safarcikm/Wind-turbines/README.md

# Wind Turbines

Development of a 12 kW wind turbine designed for Icelandic conditions (high
winds, strong gusts, icing, cold, salt air and volcanic ash), with as much as
possible manufactured in-house.

## Documents

- [01 – Project categories](docs/01-project-categories.md): work breakdown,
  Iceland-specific challenges, in-house feasibility and dependencies.
- [02 – Design basis and requirements](docs/02-design-basis.md): Icelandic
  design envelope, IEC Class S parameters, design load cases and
  requirements for every category.
- [03 – Rotor concept study](docs/03-rotor-concept.md): rotor diameter,
  tip speed, blade shape, aerofoils and pitch schedule
  (model in [analysis/rotor](analysis/rotor/)).
- [04 – Generator concept study](docs/04-generator-concept.md): topology,
  size, poles/slots, magnets and Iceland-specific protection
  (model in [analysis/generator](analysis/generator/)).
- [05 – Generator FEA and thermal check](docs/05-generator-fea-thermal.md):
  2D finite element results (back-EMF, cogging, torque, demagnetisation) and
  thermal network; leads to N40UH magnets and a mandatory cooling package.
- [06 – Generator simulation round 2](docs/06-generator-round2.md): confirms
  the fixes (all checks pass) and freezes the generator concept data.
- [07 – Nacelle, spindle and bearings](docs/07-nacelle-spindle-bearings.md):
  layout, concept loads, main bearings, spindle, generator cooling path,
  brake and yaw (model in [analysis/nacelle](analysis/nacelle/)).
- [08 – Load verification](docs/08-load-verification.md): IEC 61400-2
  Simplified Load Model and a 94-case aeroelastic simulation; design load
  recommendation, design overspeed 250 rpm, tower frequency and parked
  stability findings (models in [analysis/loads](analysis/loads/)).
- [09 – Tower and foundation](docs/09-tower-foundation.md): freestanding
  tilt-up monopoles for 18 m and 24 m, frequency strategy with a speed
  exclusion zone, rotor balance requirement, foundations for every ground
  type (models in [analysis/tower](analysis/tower/)).
- [10 – Blade materials and structure](docs/10-blade-structure.md): material
  options, layup sizing for glass and carbon spar caps, frequencies, root
  joint (model in [analysis/blade](analysis/blade/)).
- [11 – Control and safety system](docs/11-control-safety.md): control and
  protection architecture, constant power, storm control, exclusion zone,
  trips and emergency stop, and the full load rerun with the final design.
- [12 – Power electronics](docs/12-power-electronics.md): active rectifier,
  750 V DC link, dump load, grid-tie/heating and battery modules, efficiency
  and annual energy (model in [analysis/power](analysis/power/)).
- [13 – Hub, pitch and yaw](docs/13-hub-pitch-yaw.md): independent electric
  pitch with supercapacitors, pitch bearing and drive sizing from simulated
  pitch duty, ductile iron hub, yaw bearing, drives and slipping brake, and
  the effect of the heavier rotor on the towers (models in
  [analysis/hub](analysis/hub/)).
- [14 – Nacelle prototype P1](docs/14-nacelle-prototype-p1.md): bench
  article detail design (spindle, bearings, drum, stator, magnets, brake,
  cooling, bedplate), detail checks, mass, manufacturing and assembly, with
  17 parametric drawings (PDF + DXF) and a BOM in [cad/nacelle_p1](cad/nacelle_p1/)
  (checks in [analysis/nacelle/detail.py](analysis/nacelle/detail.py)).
- [15 – Nacelle bench test plan](docs/15-nacelle-bench-test-plan.md): rig,
  instrumentation, test blocks T0 to T10 with pass criteria, schedule.
- [16 – Nacelle fit-check model](docs/16-nacelle-fit-check-model.md): every
  nacelle part at 1:1 as its own printable object down to the tower flange,
  and the digital assembly check that found 9 problems in P1
  ([cad/nacelle_fitcheck](cad/nacelle_fitcheck/)).
- [17 – Working 3D-printed prototype W1](docs/17-working-printed-prototype.md):
  the P1 geometry Rev B that fixes those findings, a printed hub, pitch and yaw
  twins with real balls, real bought actuators, sensors and controller, the
  swap path from printed to steel, component list
  ([cad/nacelle_w](cad/nacelle_w/), [bom_w.csv](cad/nacelle_w/bom_w.csv)) and
  the car-industry evaluation.
- [24 – Collective pitch and welded hub](docs/24-collective-pitch-hub.md):
  replaces the three pitch drives of doc 13 with one electric cylinder, yoke,
  links and cranks, feathering from one supercap module; rotor brake as the
  second braking system; welded S355NL hub; mass and part count
  ([analysis/hub/collective.py](analysis/hub/collective.py)).
- [26 – Slow-running variant V5](docs/26-slow-rotor-variant-v5.md): Ø8.3 m,
  TSR 5, 110 rpm, every subsystem re-sized; +11–14 % yearly energy against
  about double the storm loads (models in [analysis/variant_tsr5](analysis/variant_tsr5/)).
