safarcikm/Wind-turbines/cad/turbine_6kw/out/drawing-index.md

| Drawing | Title | Material | Mass |
|---|---|---|---|
| NS6-000 | GENERAL ARRANGEMENT · TURBINE ON 8 m TOWER | see BOM NS6-002/003 | ≈ 982 kg head + 661 kg tower |
| NS6-001 | DRAWING INDEX (S6 SET REV B + REUSED 12 kW DRAWINGS) | – | – |
| NS6-002 | BILL OF MATERIALS (1/2) | see lines | see lines |
| NS6-003 | BILL OF MATERIALS (2/2) | see lines | see lines |
| NS6-010 | GENERAL ARRANGEMENT · NACELLE SECTION | see NS6-001 | ≈ 982 kg above the tower flange |
| NS6-020 | ROTOR ASSEMBLY · HUB, BLADES, SPINNER | see BOM | ≈ 162 kg (rotor + hub + spinner) |
| NS6-100 | BLADE · PLANFORM, TWIST AND ROOT | E-glass/epoxy infused; glass UD caps; PVC core shells | 20.6 kg |
| NS6-101 | BLADE · SECTIONS AND LAMINATE SCHEDULE | E-glass/epoxy (infusion), PVC H80 core | 20.6 kg |
| NS6-105 | BLADE ROOT INSERT M12 (BONDED) | C45E+QT, zinc-flake coated (Geomet 500) | 0.33 kg |
| NS6-110 | BLADE MOULD SET (PLUG, TWO HALVES, FRAME) | GRP tooling laminate on S235 RHS frame | ≈ 2 × 75 kg + frame 155 kg |
| NS6-115 | ROOT INSERT FIXTURE AND WEB MOULD (TOOLS) | S355 machined; Al 5083 plate | 9 kg (fixture) |
| NS6-130 | PITCH SETTING · ROOT SLOTS, WASHER PLATES, GAUGE | C45 hardened 45 HRC; gauge Al 6082 | 30 × 15 g; gauge 1.6 kg |
| NS6-200 | FIXED HUB WELDMENT | S355NL, welded, stress relieved | 79 kg (CAD) |
| NS6-210 | SPINNER (GRP) AND BRACKETS NS6-211 | glass/polyester 4 mm, gelcoat RAL 9010; brackets S235 galv. | 8.7 kg + 3.6 kg |
| NS6-300 | BEDPLATE WELDMENT 6 kW (LIGHT) | S355J2+N plates, stress relieved, machined | 127 kg |
| NS6-310 | CALIPER BRACKET NP1-310 AND YAW DRIVE BRACKET NP1-420 | S355J2+N plate 25, welded, galv. | 18.1 kg; 2 × 7.7 kg |
| NS6-400 | TOWER 8 m · ONE-PIECE TILT-UP MONOPOLE | S355J2+N, rolled and seam welded; hot-dip galvanised | 661 kg (CAD 698) |
| NS6-410 | BASE HINGE BRACKETS AND PIN | S355J2+N 30 mm plate, galv.; pin 42CrMo4+QT Ø50 h9 | 37 kg |
| NS6-420 | GIN POLE AND TILT-UP RIGGING (ERECTION TOOL) | S355 tube 168.3 × 6.3, plates 25 | 94 kg |
| NS6-500 | FOUNDATION · SPREAD FOOTING AND ROCK PLINTH (8 m) | C30/37 XF4 air-entrained; B500C rebar | 5.5–6.6 m³ (soil), 2.0 m³ (rock) |
| NS6-510 | ANCHOR CAGE AND TEMPLATE | M24 8.8 HDG threaded rod; S355 rings 100 × 20 | 144 kg |
| NS6-600 | BRAKING RESISTOR BOX AND SAFETY CHAIN | Box 1.4301, IP54; resistors steel-grid | ≈ 18 kg |
| NS6-610 | G6 PLAIN REAR COVER (NO FAN BLADES) | EN AW-5083-H111, 10 mm plate | ≈ 7 kg |
| NS6-620 | TOWER BASE CABINET, STAND AND RESISTOR BOX POSITION | enclosure 1.4301 IP55; stand S235 galv. | 95 kg + 18 kg |
| NS6-700 | NACELLE COVER · LOWER TRAY AND UPPER LID (GRP) | glass/polyester 4 mm, gelcoat RAL 9010, PU foam ribs | 19 + 22 kg |
| NS6-710 | COVER ARMS, REAR RAIL, MET MAST NS6-720, JUNCTION BOX NS6-730 | S235 galv.; mast 1.4404 Ø42.4 × 2 | 22 kg; 4.5 kg; 9 kg |
| NS6-800 | CABLING ROUTES, EARTHING AND LIGHTNING | see cable schedule | – |
| NS6-900 | FASTENER AND TORQUE SCHEDULE | ISO 4014/4017, EN 14399-4 (HV), 10.9 zinc-flake unless stated | – |
| NS6-910 | BOUGHT PARTS SPECIFICATION (ENVELOPES AND INTERFACES) | see lines | see lines |
