safarcikm/Wind-turbines/cad/yaw/out/drawing-index.md

| Drawing | Title | Material | Mass |
|---|---|---|---|
| NY-000 | YAW SYSTEM · GENERAL ARRANGEMENT | see parts list | ≈ 275 kg (yaw incl. adapter) |
| NY-400 | TOWER-TOP ADAPTER WITH FRICTION TRACK | S355J2+N plate and tube, weldment | 107 kg (model) |
| NY-410 | FRICTION PAD UNIT (PASSIVE, SPRING-LOADED) | frame S355J2+N, pins 1.4462 | 13 kg (model) |
| NY-430 | YAW LOCK (SERVICE) | housing S355J2+N, block 42CrMo4+QT | 6.5 kg (model) |
| NY-440 | YAW ENCODER AND CAM LIMIT SWITCH UNIT | bracket S355J2+N, pinion 42CrMo4+QT | 6.9 kg incl. instruments |
| NY-460 | CABLE HANGER AND TWIST LOOP | tube S355 Ø168.3 × 4.5, flange S355J2+N | 10 kg (model) |
