safarcikm/Wind-turbines/cad/generator_rc/out/drawing-index.md

| Drawing | Title | Material | Mass |
|---|---|---|---|
| NP1-G00 | GENERATOR REV C · ASSEMBLY SECTION | see parts list | ≈ 330 kg drivetrain (no hub) |
| NP1-201C | STATOR TOOTH SEGMENT LAMINATION (45 + 3 PER STATOR) | M270-35A, 0.35 mm, self-bonding varnish | 1.07 kg per stack |
| NP1-200C | STATOR CARRIER WITH 45 DOVETAIL GROOVES | S355J2+N ring forging or plate, stress relieved | 40.6 kg |
| NP1-203C | COIL ON SEGMENT (WOUND SEGMENT) | Cu enamelled Ø1.55 grade 2, class 200; NKN 0.30; PPS GF40 caps | ≈ 0.45 kg Cu per coil |
| NP1-210C | ROTOR DRUM WELDMENT (GENERATOR YOKE + BEARING HOUSING) | S355J2+N, welded, stress relieved | 91.8 kg + 12.5 kg fins/ribs |
| NP1-220E | MAGNET BLOCK 30 × 15 × 12 (PURCHASE DRAWING) | Sintered NdFeB N45SH, NiCuNi | 41.0 g each, 8.21 kg per generator |
| NP1-221C | STEPPED POLE COMB BAR (40 + 4 PER ROTOR) | G11 glass-epoxy sheet, CNC machined | ≈ 25 g |
| NP1-222C | MAGNET END RINGS, FRONT AND REAR | G11 glass-epoxy, machined from tube or segmented | ≈ 0.12 kg each |
| NP1-223C | ROTOR MAGNET PACK: POLE SECTION, LAYOUT AND SLEEVE | assembly | 8.2 kg magnets |
| NP1-212C | DRUM REAR COVER WITH SEAL CARRIER AND FAN BLADES | EN AW-5083-H111 plate, ring and blades | ≈ 9.0 kg |
| NP1-202 | STATOR FRONT CLAMP RING | 1.4404 (non-magnetic) | 2.2 kg |
