safarcikm/Wind-turbines/cad/nacelle_p1/out/drawing-index.md

| Drawing | Title | Material | Mass |
|---|---|---|---|
| NP1-000 | GENERAL ARRANGEMENT · DRIVETRAIN SECTION | see parts list | ≈ 320 kg (drivetrain, no hub) |
| NP1-100 | SPINDLE (STATIONARY MAIN SHAFT) | 42CrMo4+QT (EN 10083-3), forged | 56.8 kg |
| NP1-101 | FRONT SPACER + REAR SEAL SLEEVE NP1-102 | 42CrMo4+QT, surface induction hardened | 1.4 kg |
| NP1-110 | SPINDLE COOLING INSERT (FINNED EXTRUSION) | EN AW-6082-T6 extrusion | 2.6 kg |
| NP1-200 | STATOR CARRIER | S355J2+N plate or ring forging, stress relieved | 40.6 kg |
| NP1-201 | STATOR LAMINATION (45 SLOTS) · LASER / STAMPING | M270-35A, 0.35 mm, self-bonding varnish | 48.0 kg per stack |
| NP1-202 | STATOR FRONT CLAMP RING | 1.4404 (non-magnetic) | 2.2 kg |
| NP1-210 | ROTOR DRUM WELDMENT (GENERATOR YOKE + BEARING HOUSING) | S355J2+N, welded, stress relieved | 98.4 kg |
| NP1-211 | MAIN BEARING SEAL COVERS (FRONT / REAR) | S355J2 | 2.8 kg |
| NP1-212 | DRUM REAR COVER WITH SEAL CARRIER | EN AW-5083-H111 plate + ring | 7.3 kg |
| NP1-220 | MAGNET SEGMENT (PURCHASE DRAWING) | NdFeB N40UH, NiCuNi + epoxy coating | 41 g each |
| NP1-230 | BRAKE DISC AND ROTOR LOCK HOLES | C45E+N (or S355J2+N), 16 mm | 34.5 kg |
| NP1-300 | BEDPLATE WELDMENT (P1 FABRICATED VERSION) | S355J2+N plates, stress relieved, machined | ≈ 150 kg |
| NP1-320 | ROTOR LOCK PIN AND HOLDER | pin 42CrMo4+QT; holder S355J2 | ≈ 4 kg |
| NP1-600 | BENCH DUMMY HUB (DRIVE AND LOAD ADAPTER) | S355J2+N weldment, stress relieved | ≈ 75 kg |
| NP1-620 | BENCH TEST RIG · GENERAL LAYOUT | see doc 15 |  |
| NP1-T01 | DRUM ASSEMBLY GUIDE (MAGNET SAFETY TOOL) | S355 / PA6 bushes | ≈ 30 kg |
