safarcikm/Wind-turbines/cad/nacelle_w/out/w_check.md

# W1 check: added parts against the Rev B nacelle

## Static interference (> 5 mm³; yaw pinion/gear mesh excluded, pitch pinions checked: 0.13 mm backlash)

| Part A | Part B | mm³ |
|---|---|---|
| none | | |

## Rotating vs stationary gaps below 10.0 mm (3-D, assembled position)

| Part A | Part B | gap mm |
|---|---|---|
| none | | |
