safarcikm/Wind-turbines/cad/turbine_6kw/out/NS6-drawing-set.pdf

## SIDE VIEW (wind from the left)

## Ø6 000 rotor

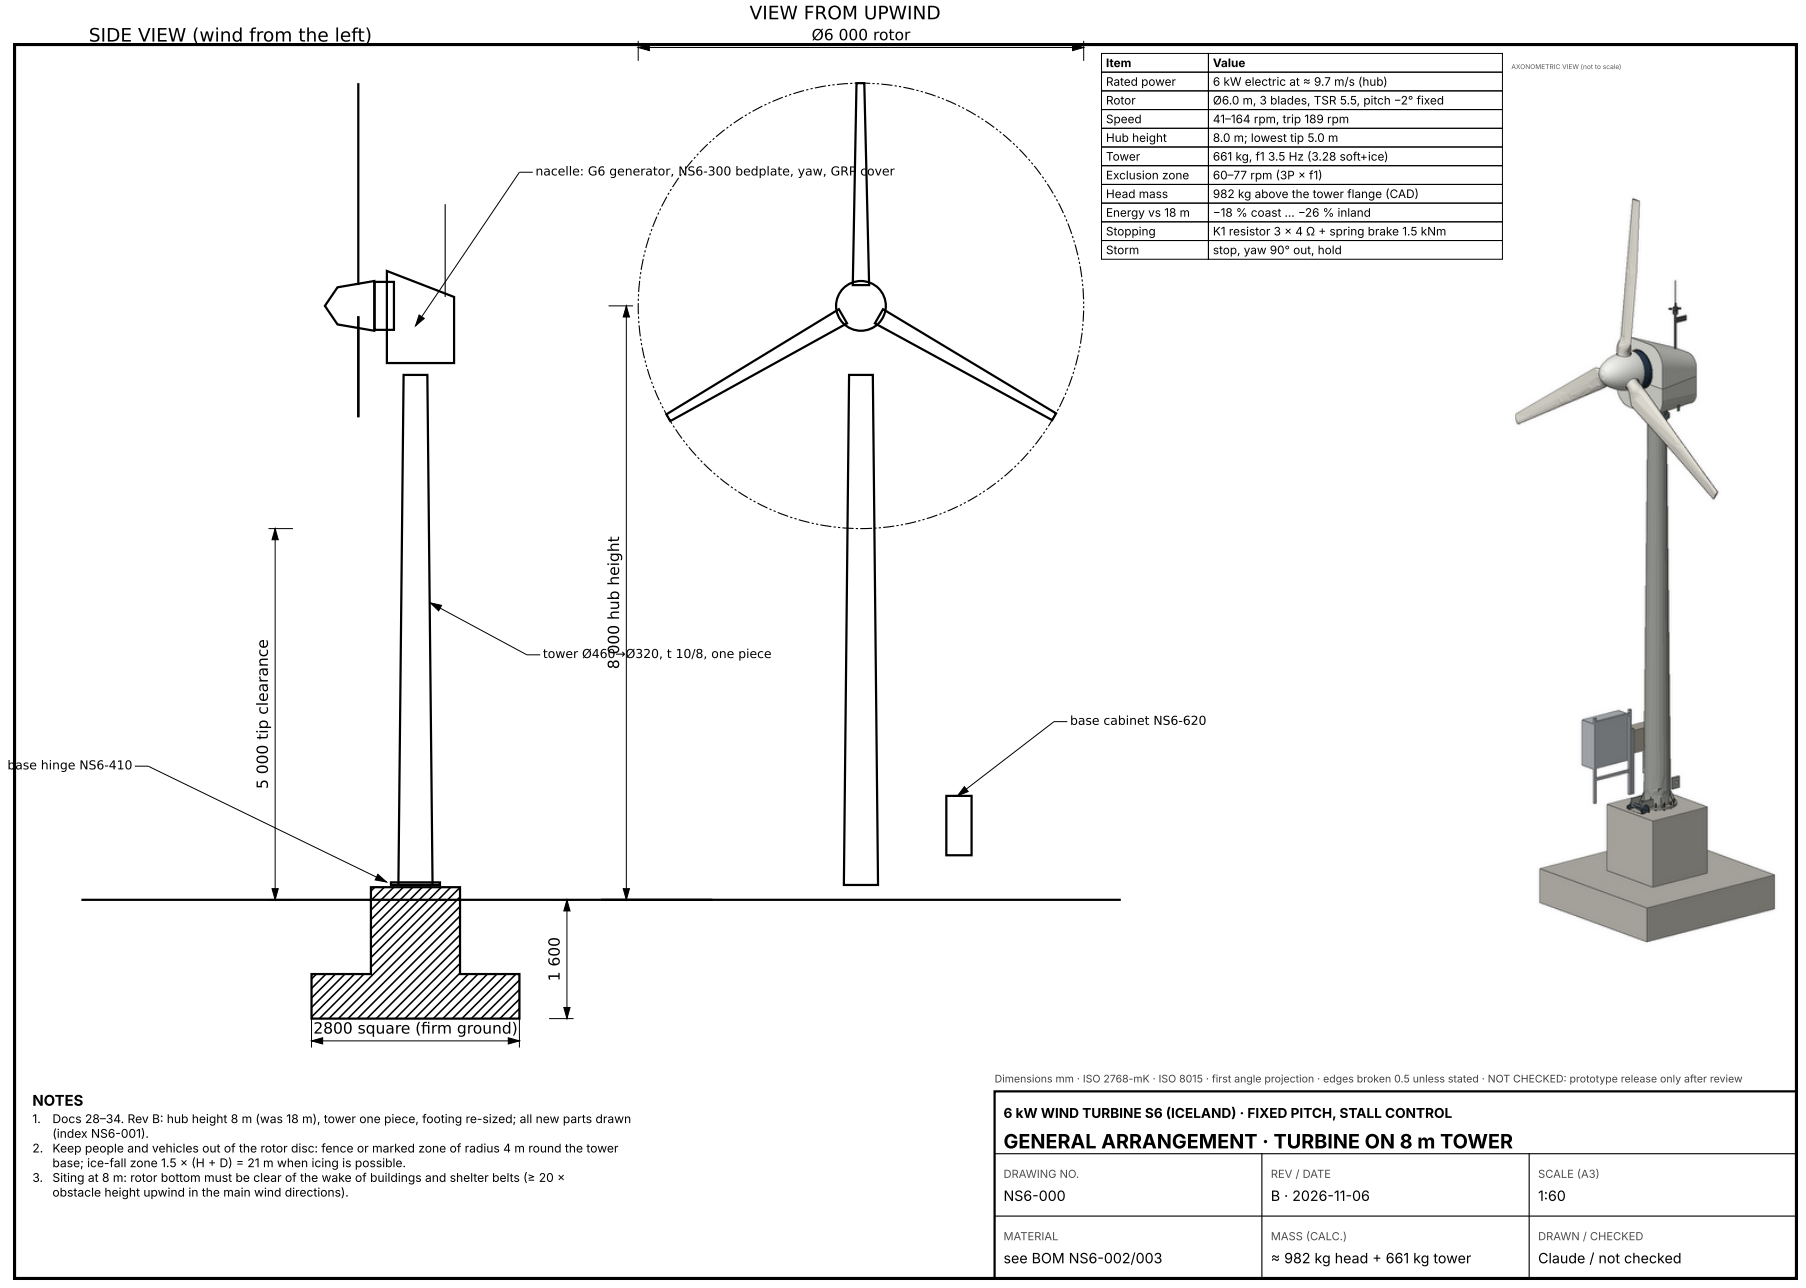
[picture p91: page 1]
8 000 hub height; 5 000 tip clearance; base hinge NS6-410; base cabinet NS6-620; DRAWING NO.; REV / DATE; SCALE (A3); MATERIAL; see BOM NS6-002/003; Item; Value; Rated power; 6 kW electric at ≈ 9.7 m/s (hub); Rotor; Ø6.0 m, 3 blades, TSR 5.5, pitch −2° fixed; Speed; 41–164 rpm, trip 189 rpm; Hub height; 8.0 m; lowest tip 5.0 m; Tower; 661 kg, f1 3.5 Hz (3.28 soft+ice); Exclusion zone; 60–77 rpm (3P × f1); Head mass; 982 kg above the tower flange (CAD); Energy vs 18 m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

VIEW FROM UPWIND

AXONOMETRIC VIEW (not to scale)

nacelle: G6 generator, NS6-300 bedplate, yaw, GRP cover

tower Ø460→Ø320, t 10/8, one piece

2800 square (firm ground)

Dimensions mm · ISO 2768-mK · ISO 8015 · first angle projection · edges broken 0.5 unless stated · NOT CHECKED: prototype release only after review

NOTES
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
