safarcikm/Wind-turbines/cad/generator_mfg/out/G01-overview.png

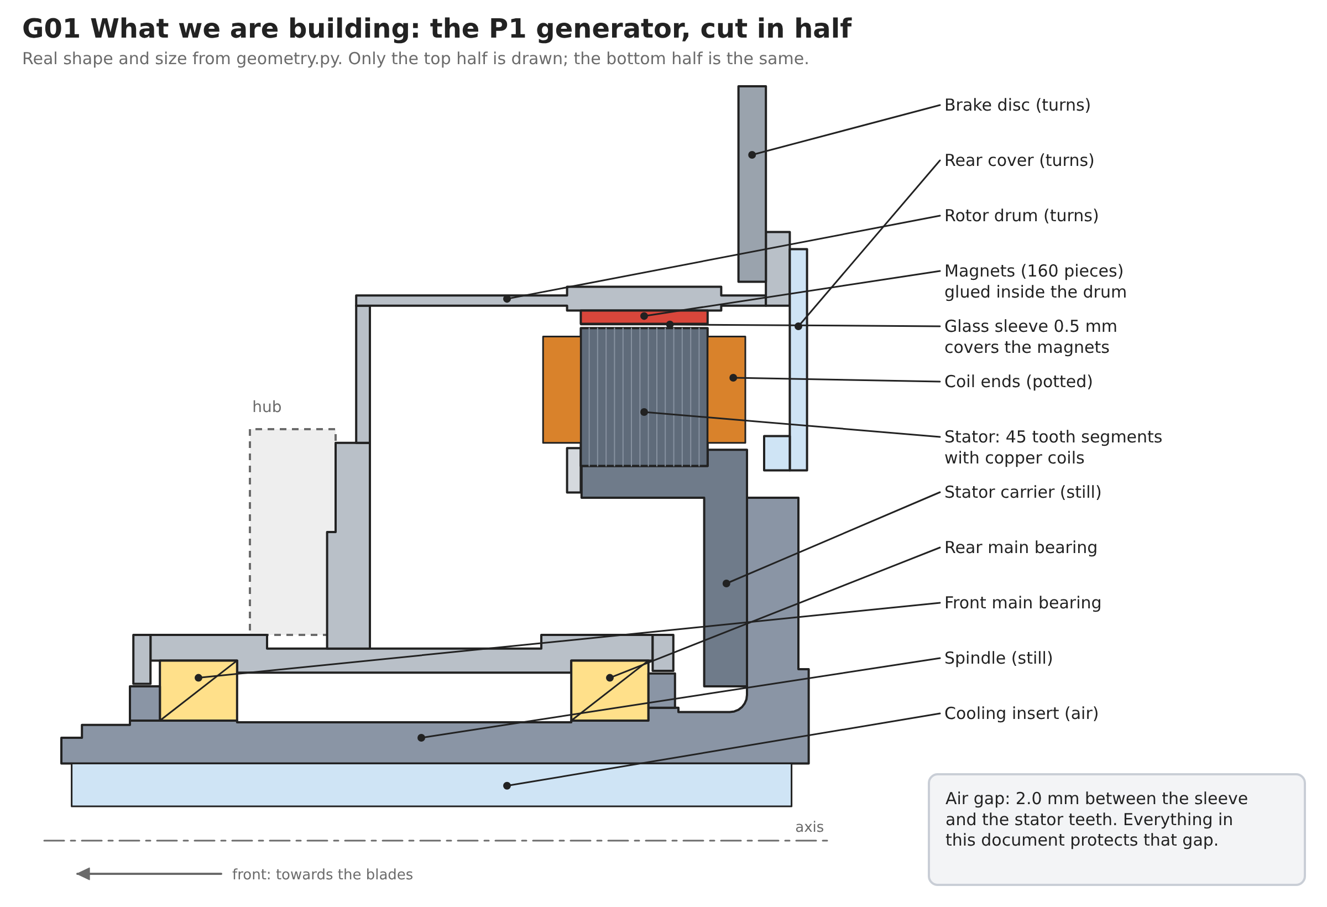
cad/generator_mfg/out/G01-overview.png
