safarcikm/Wind-turbines/cad/generator_mfg/out/G02-process.png

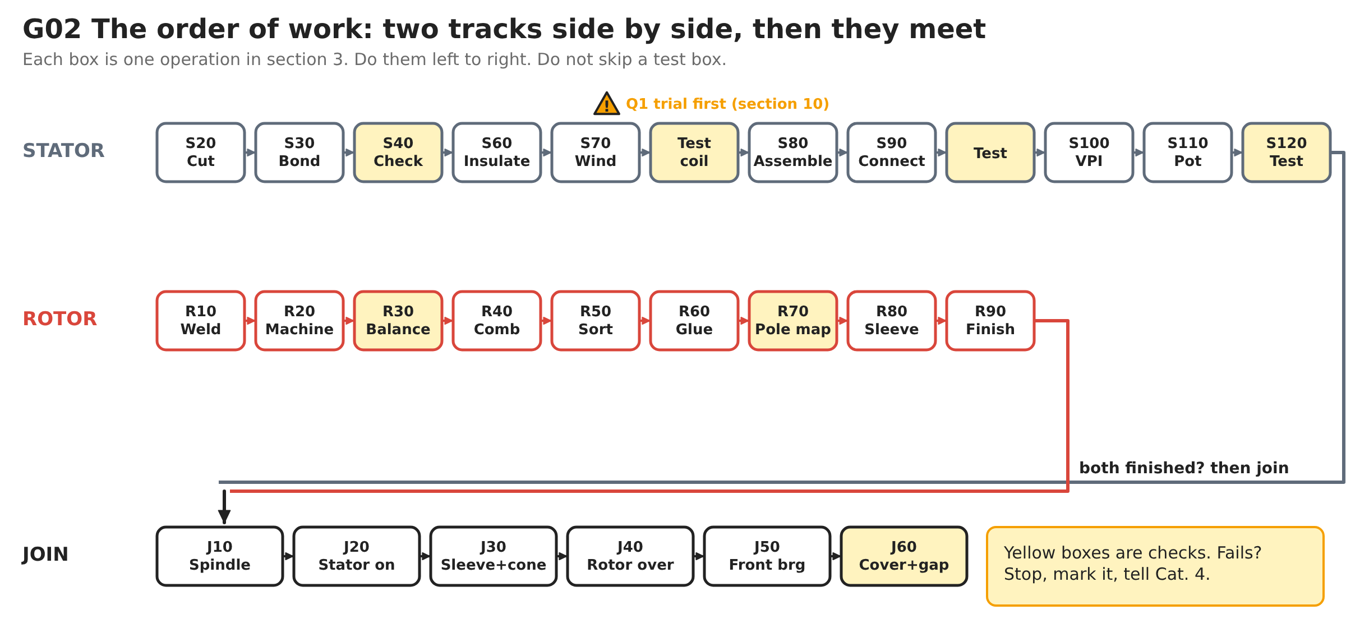
cad/generator_mfg/out/G02-process.png
