safarcikm/Wind-turbines/cad/generator_mfg/out/G03-segment.png

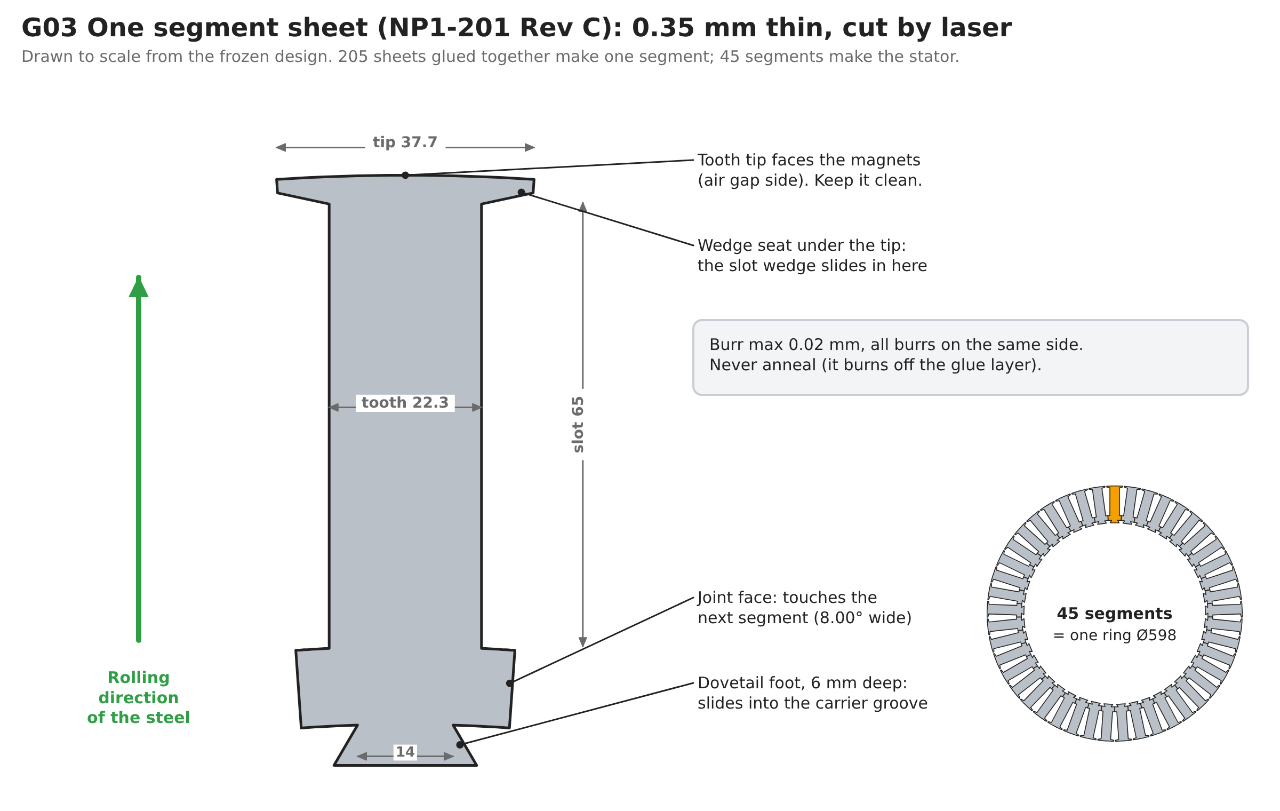
cad/generator_mfg/out/G03-segment.png
