safarcikm/Wind-turbines/cad/generator_mfg/out/G04-stacking.png

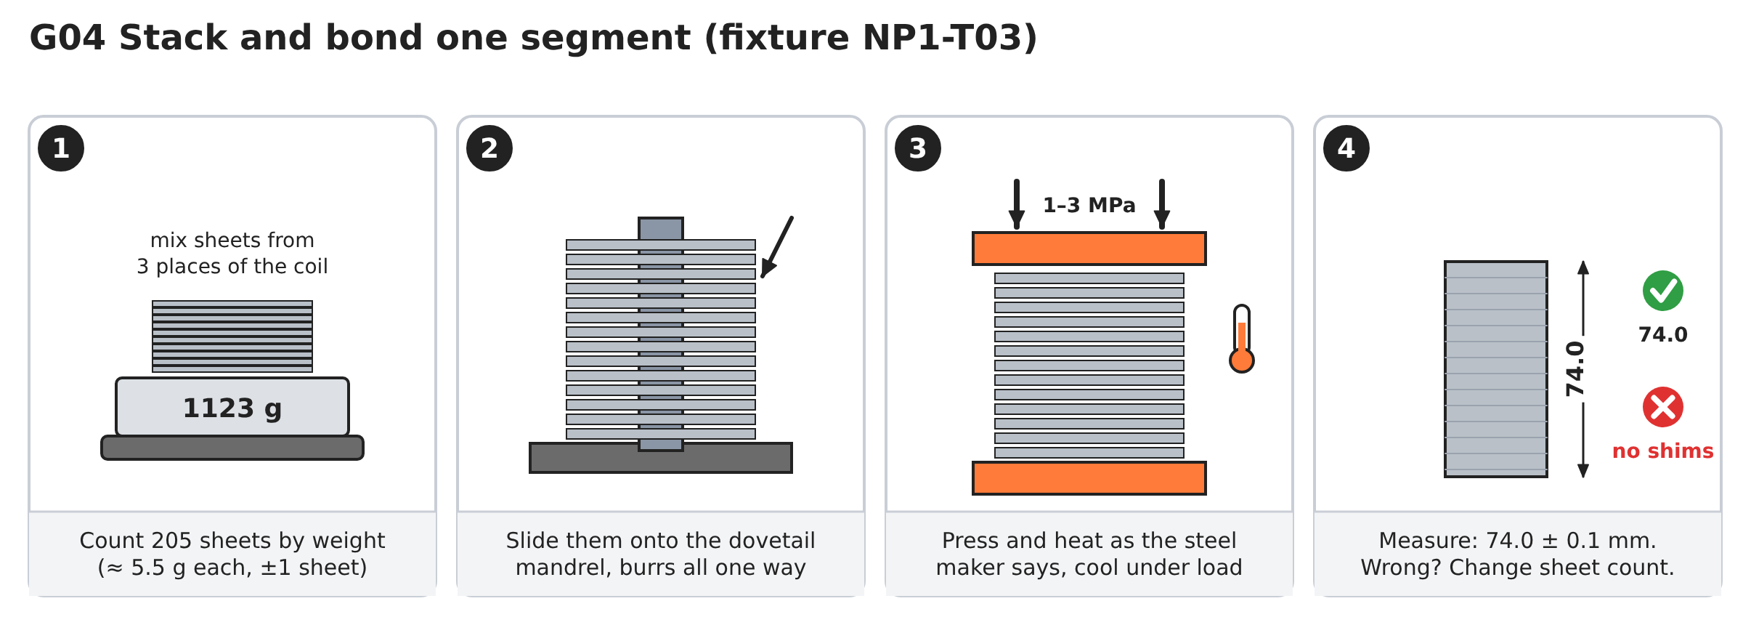
cad/generator_mfg/out/G04-stacking.png
