safarcikm/Wind-turbines/cad/generator_mfg/out/G06-winding.png

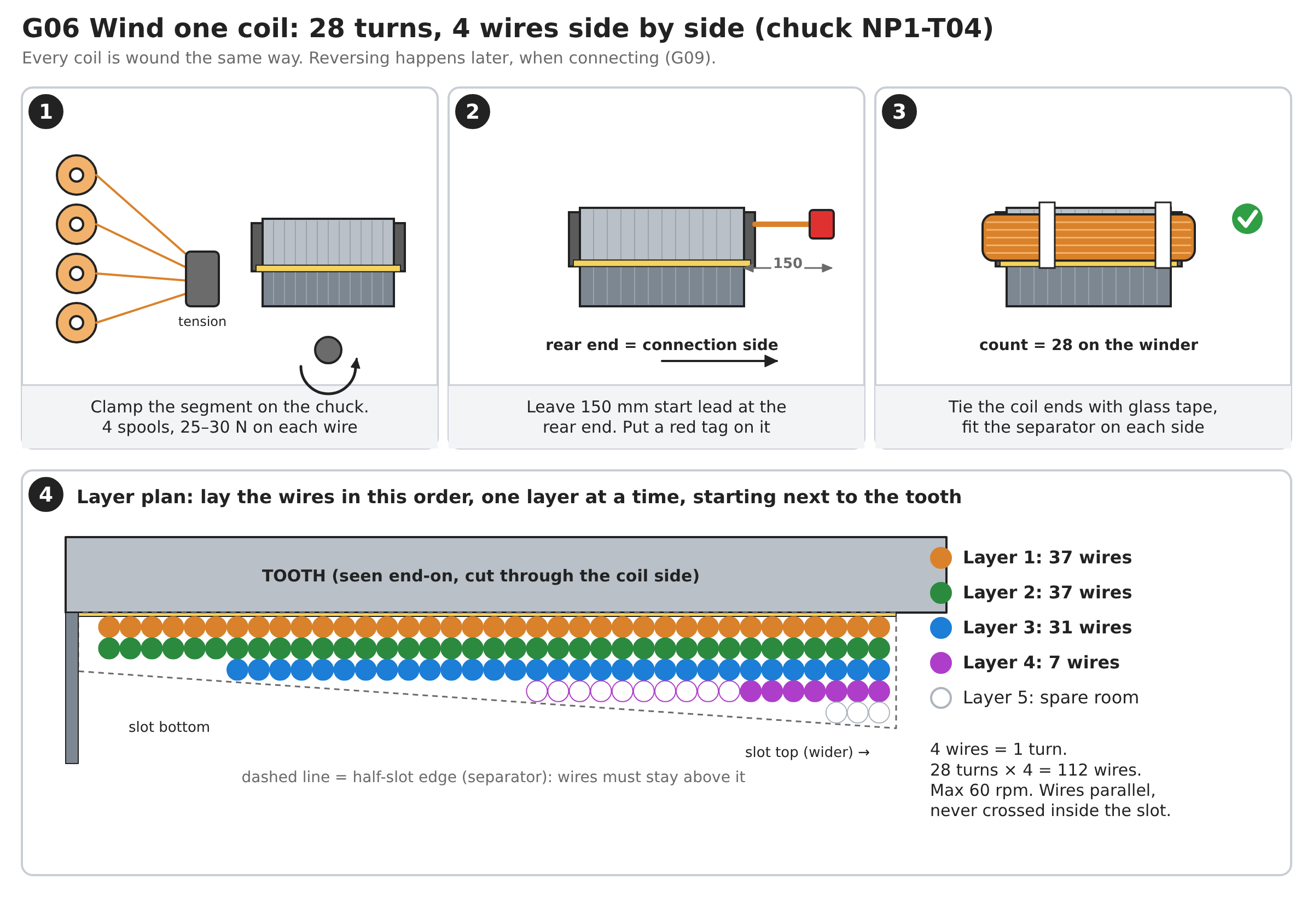
cad/generator_mfg/out/G06-winding.png
