safarcikm/Wind-turbines/cad/generator_mfg/out/G07-coiltests.png

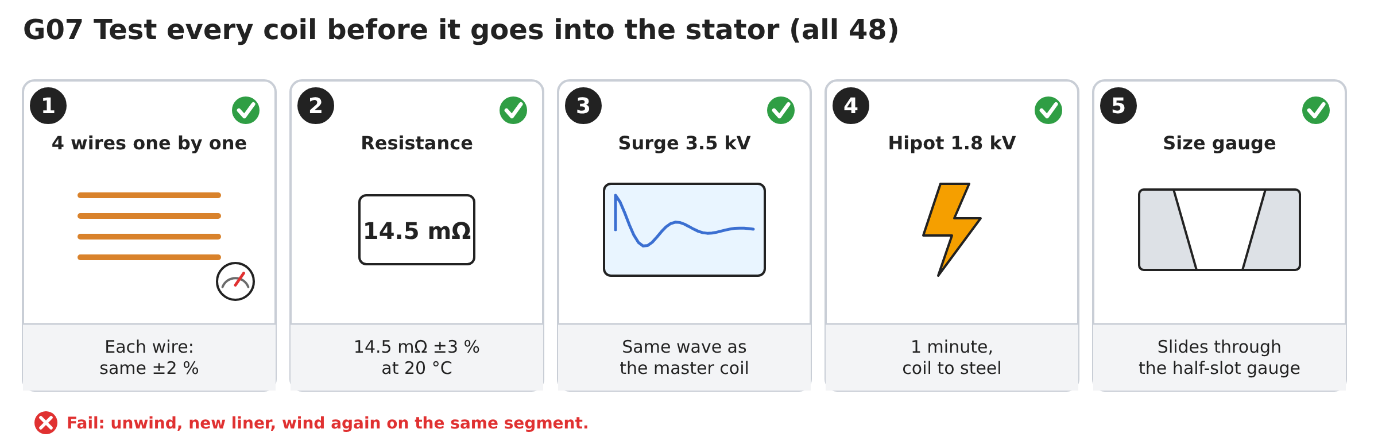
cad/generator_mfg/out/G07-coiltests.png
