safarcikm/Wind-turbines/cad/generator_mfg/out/G09-connection.png

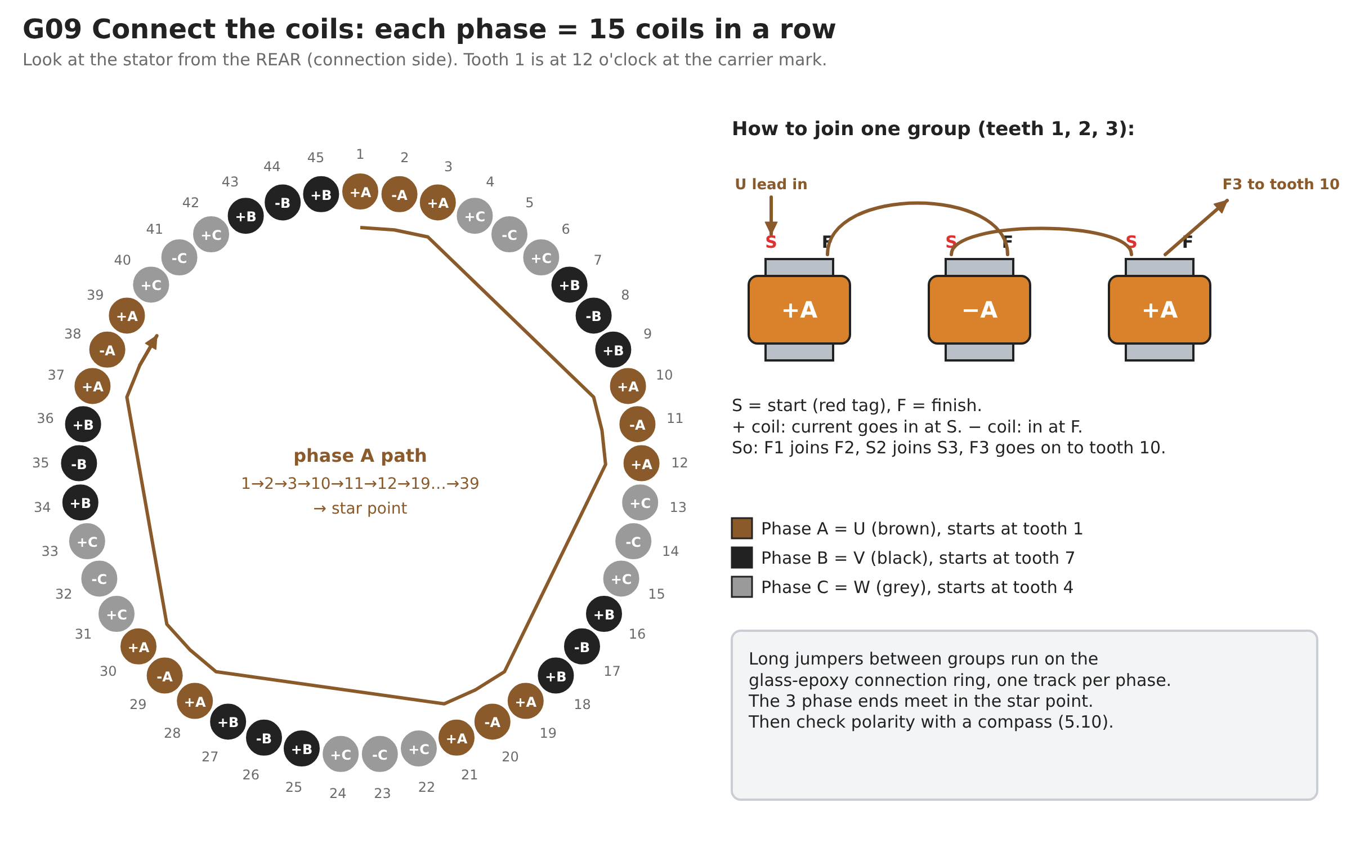
cad/generator_mfg/out/G09-connection.png
