safarcikm/Wind-turbines/cad/generator_mfg/out/G10-joint.png

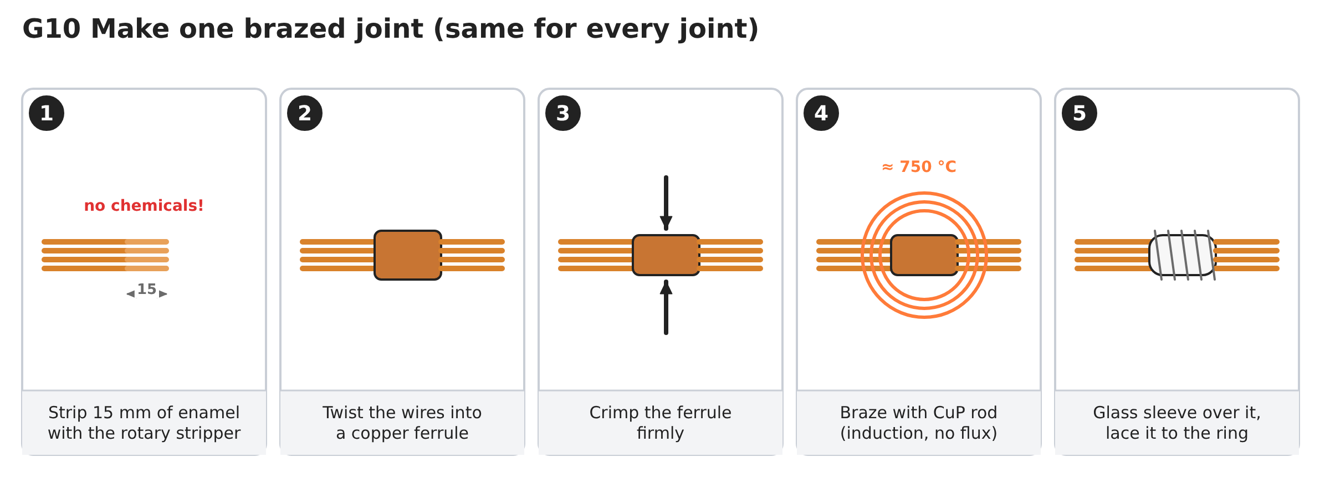
cad/generator_mfg/out/G10-joint.png
