safarcikm/Wind-turbines/cad/generator_mfg/out/G11-vpi.png

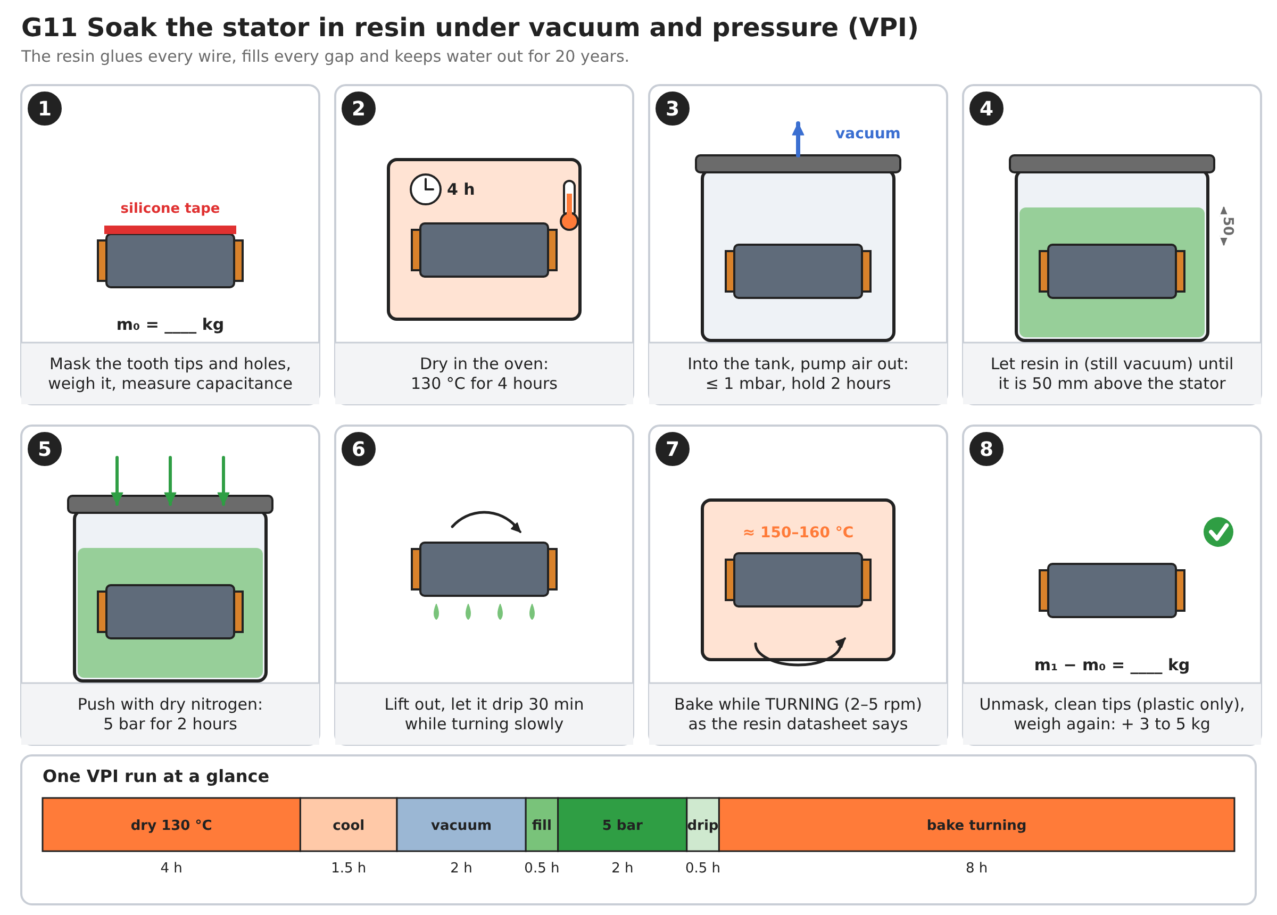
cad/generator_mfg/out/G11-vpi.png
