safarcikm/Wind-turbines/cad/generator_mfg/out/G12-potting.png

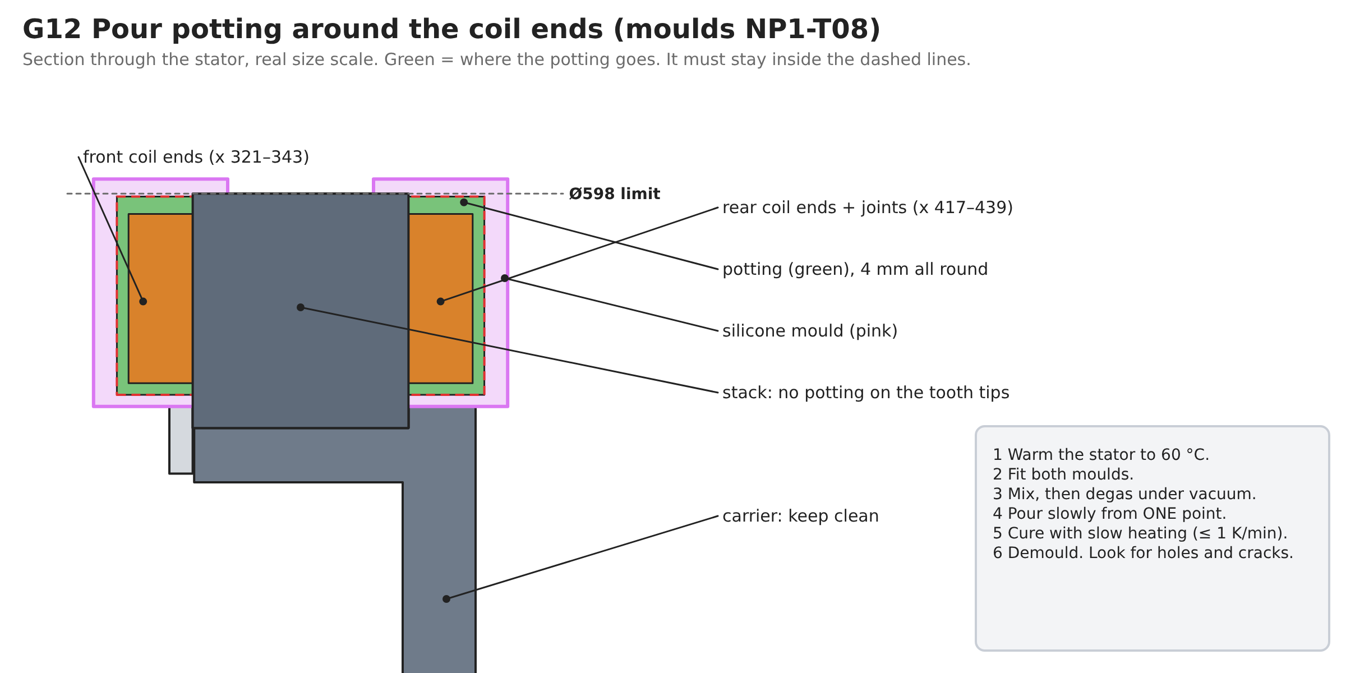
cad/generator_mfg/out/G12-potting.png
