safarcikm/Wind-turbines/cad/generator_mfg/out/G13-drum.png

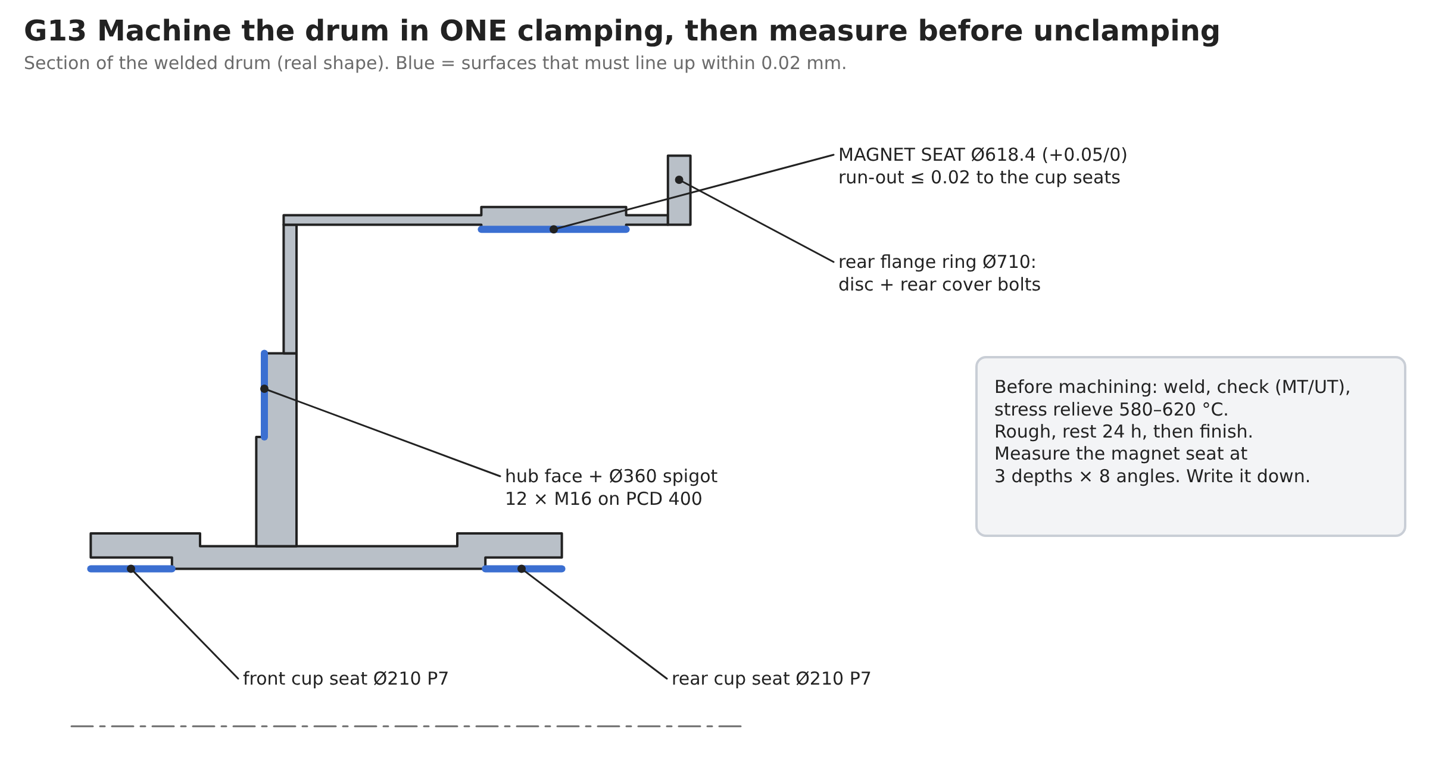
cad/generator_mfg/out/G13-drum.png
