safarcikm/Wind-turbines/cad/generator_mfg/out/G14-magnets.png

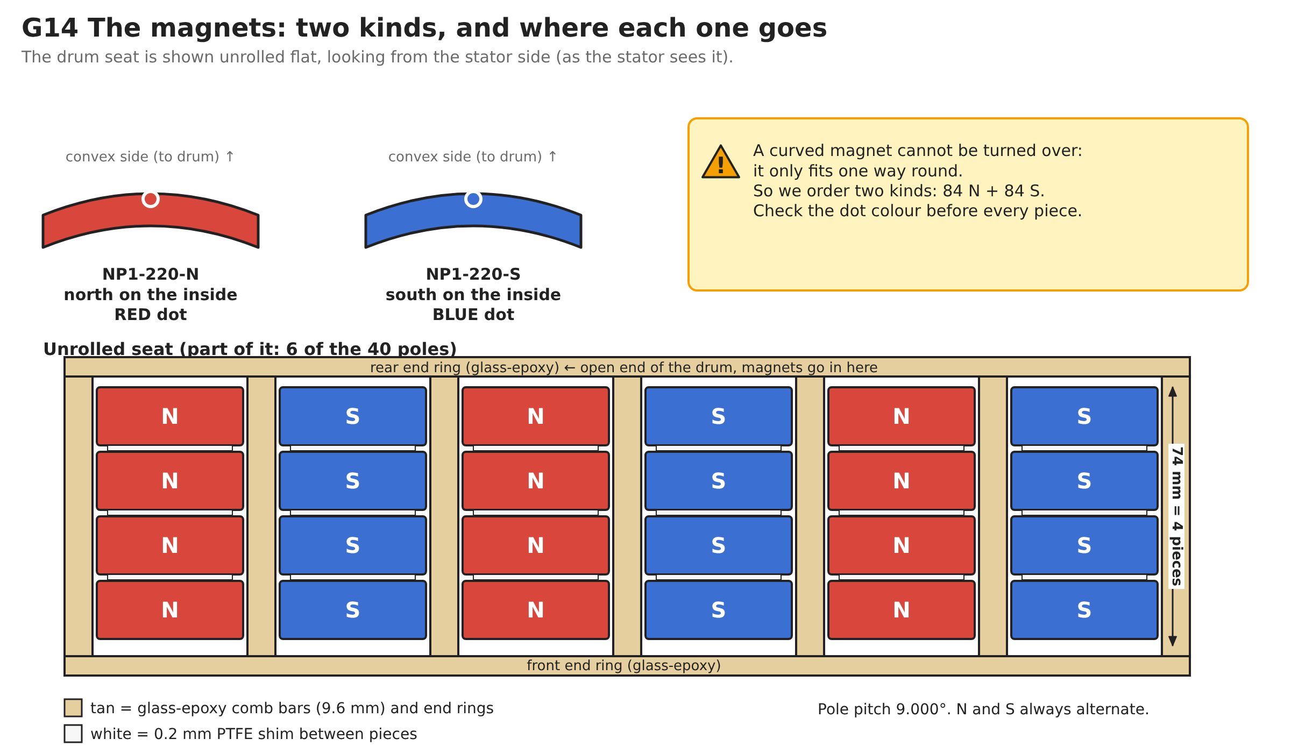
cad/generator_mfg/out/G14-magnets.png
