safarcikm/Wind-turbines/cad/generator_mfg/out/G15-insert.png

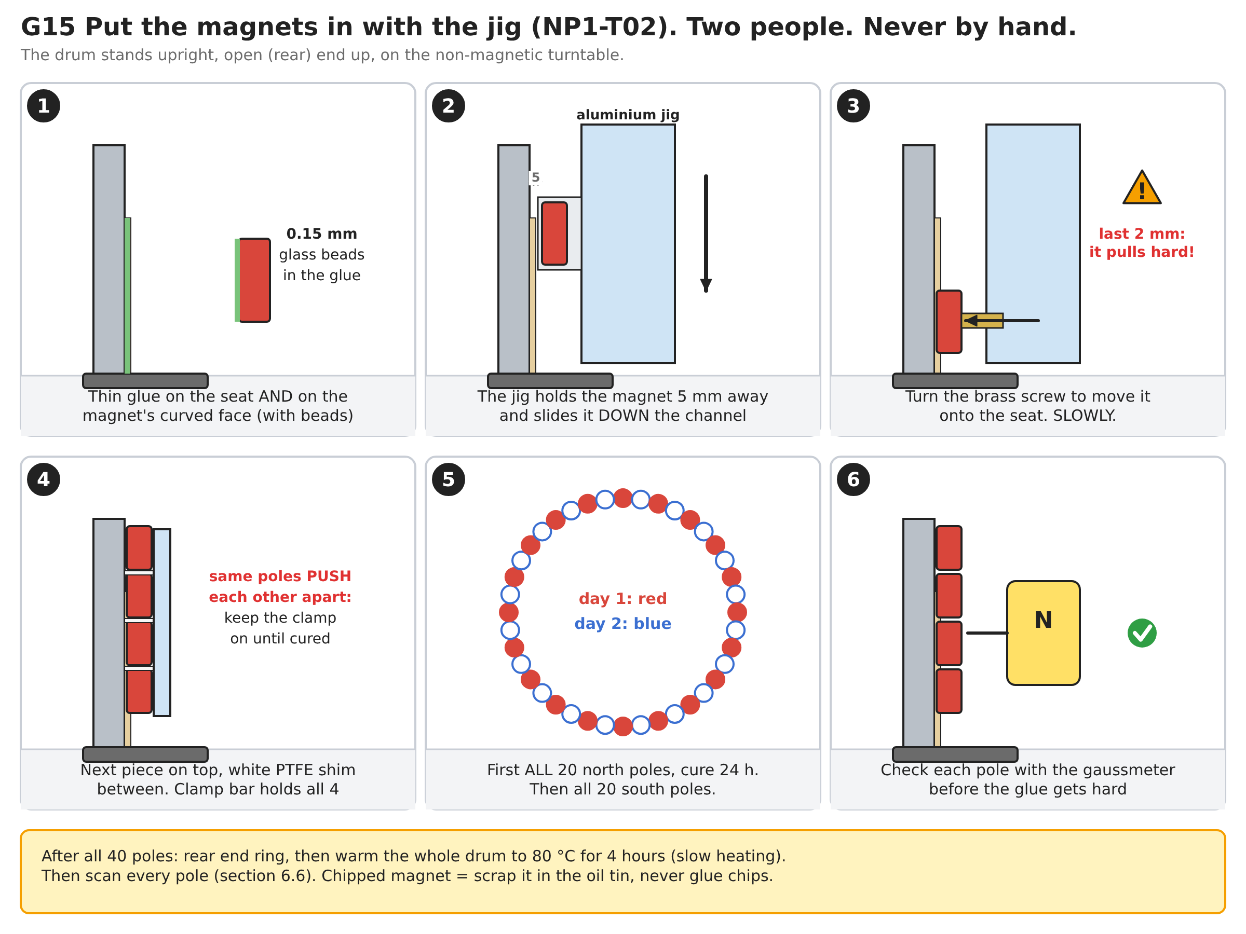
cad/generator_mfg/out/G15-insert.png
