safarcikm/Wind-turbines/cad/generator_mfg/out/G16-sleeve.png

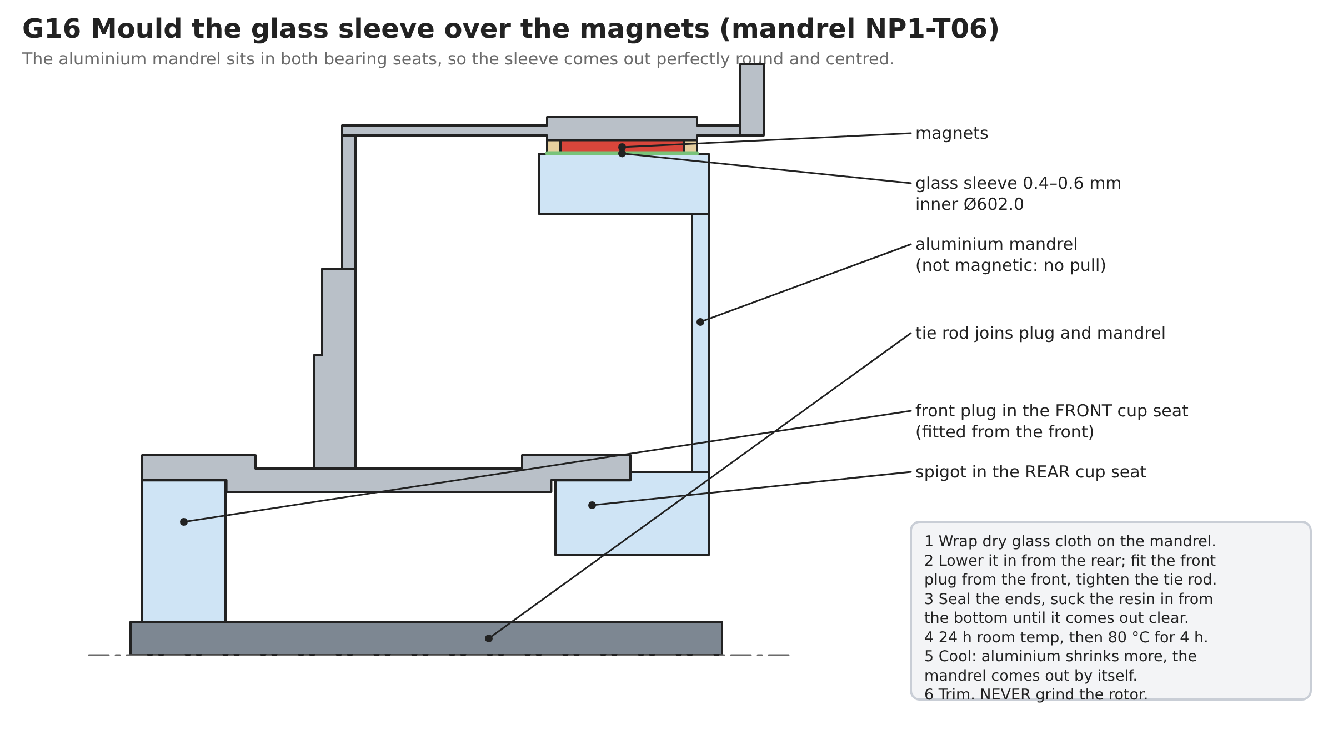
cad/generator_mfg/out/G16-sleeve.png
