safarcikm/Wind-turbines/cad/generator_mfg/out/G17-join.png

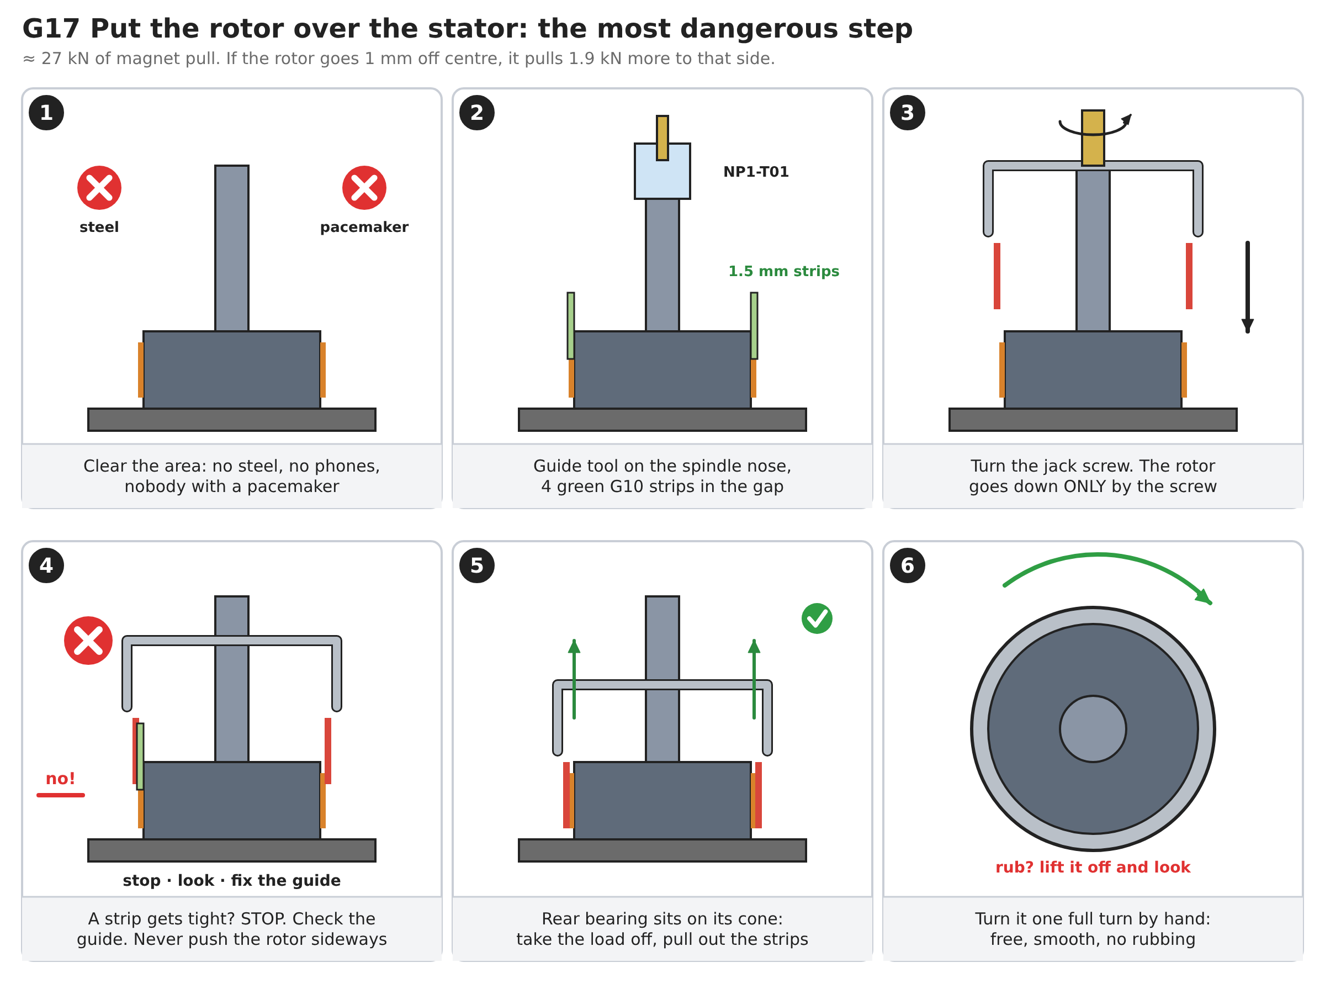
cad/generator_mfg/out/G17-join.png
