safarcikm/Wind-turbines/cad/generator_mfg/out/G18-gap.png

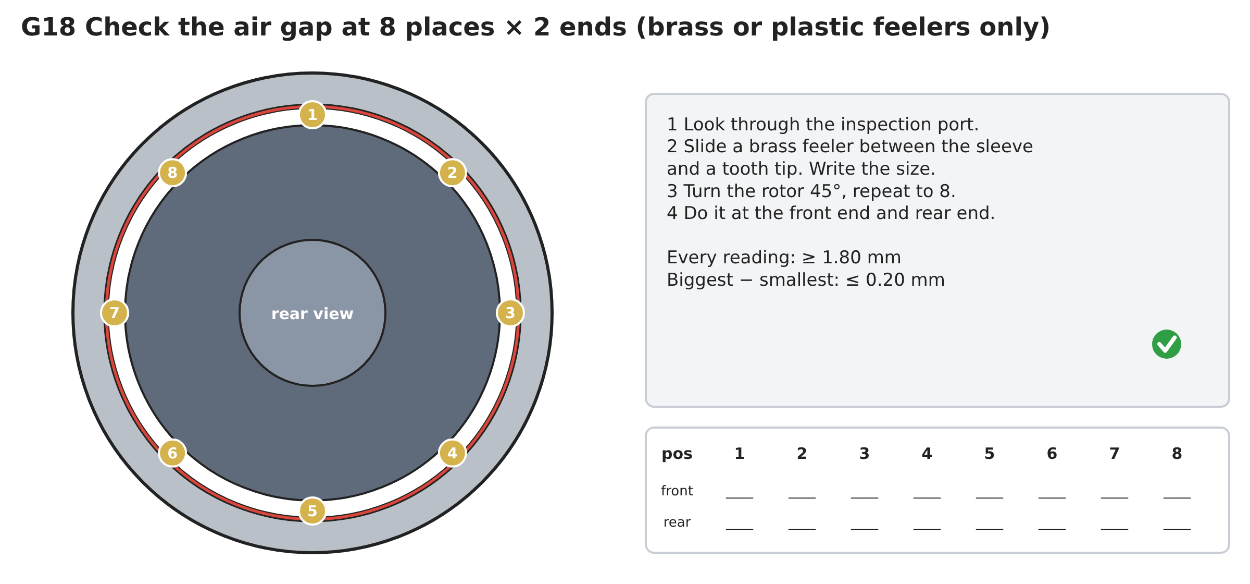
cad/generator_mfg/out/G18-gap.png
