safarcikm/Wind-turbines/cad/generator_mfg/out/G19-safety.png

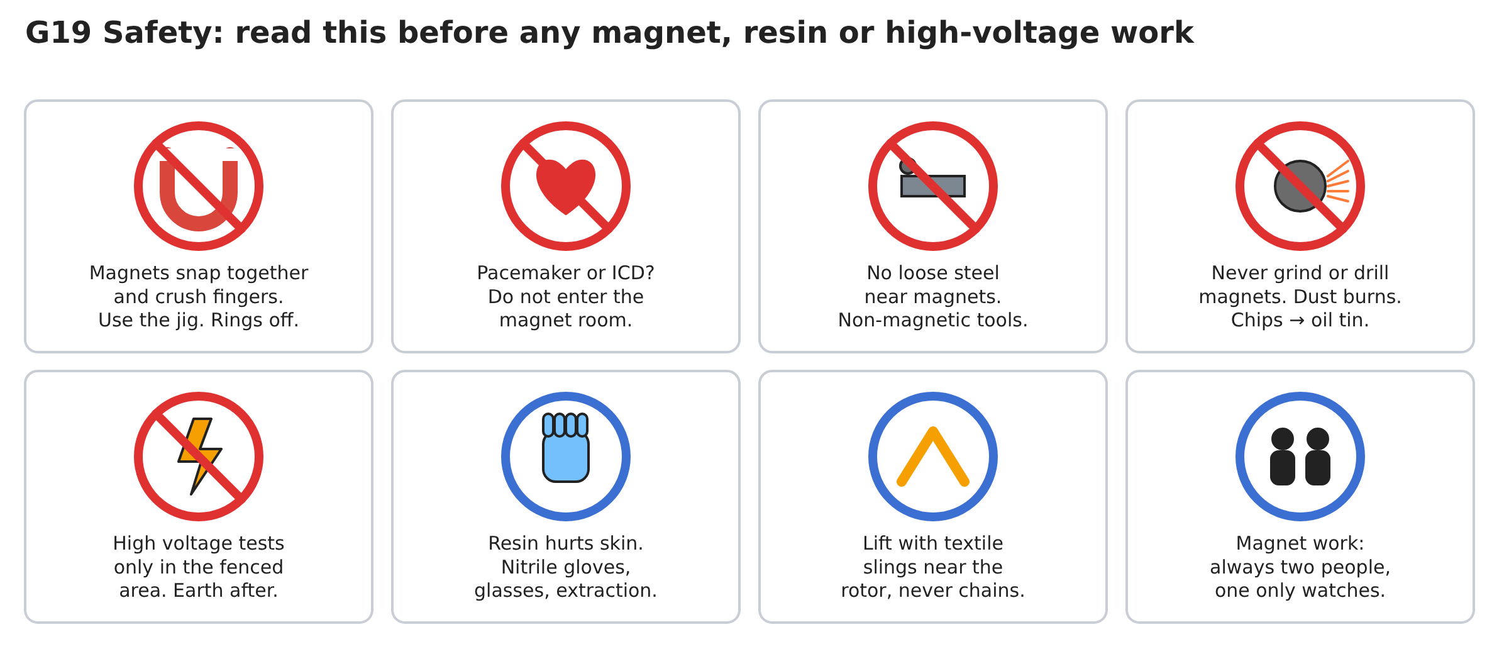
cad/generator_mfg/out/G19-safety.png
