safarcikm/Wind-turbines/cad/generator_mfg/out/I01-iso-exploded.png

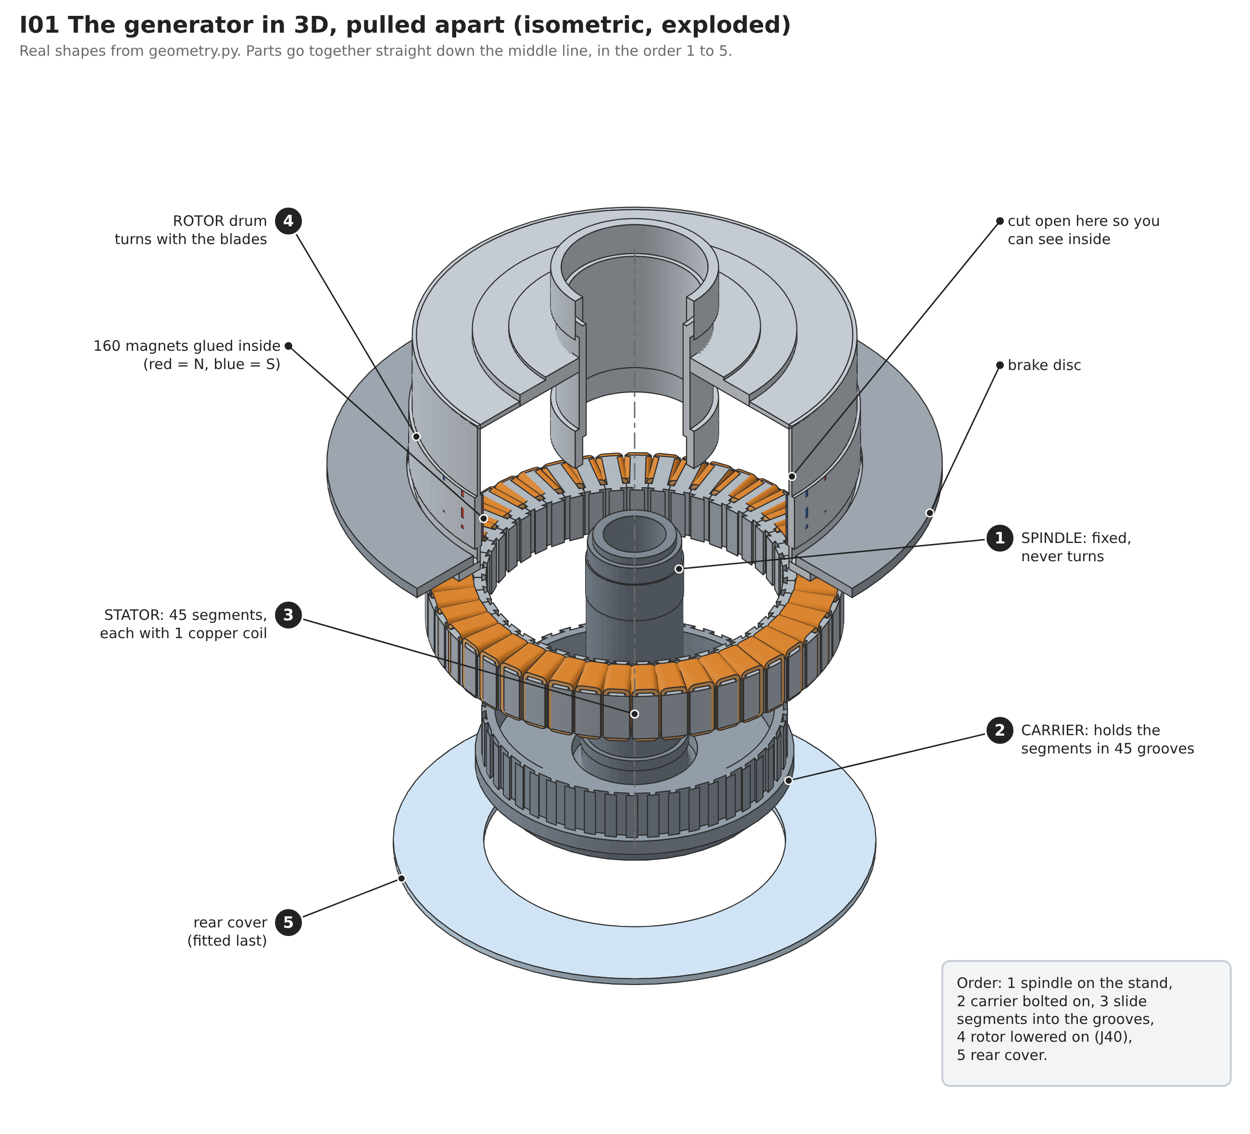
cad/generator_mfg/out/I01-iso-exploded.png
