safarcikm/Wind-turbines/cad/generator_mfg/out/I04-iso-rotor.png

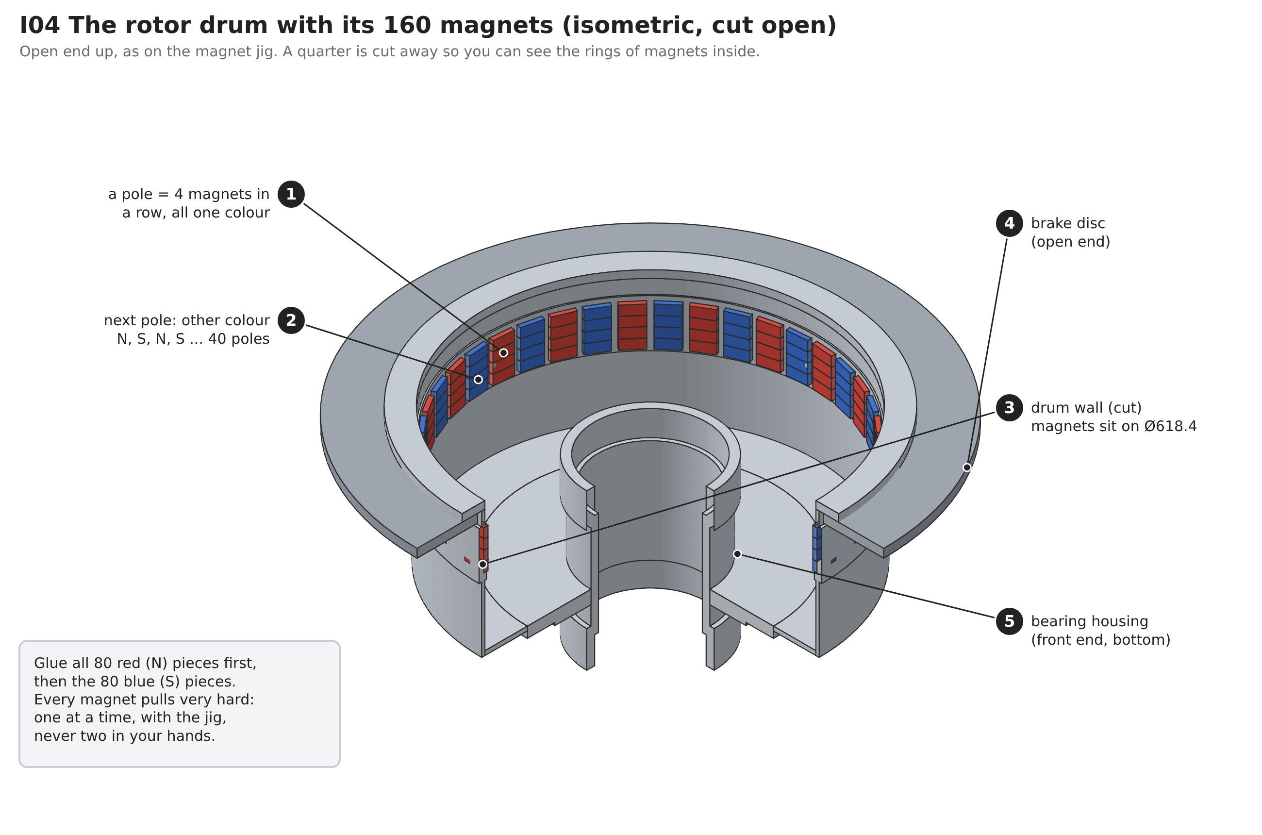
cad/generator_mfg/out/I04-iso-rotor.png
