safarcikm/Wind-turbines/cad/generator_mfg/out/I05-iso-join.png

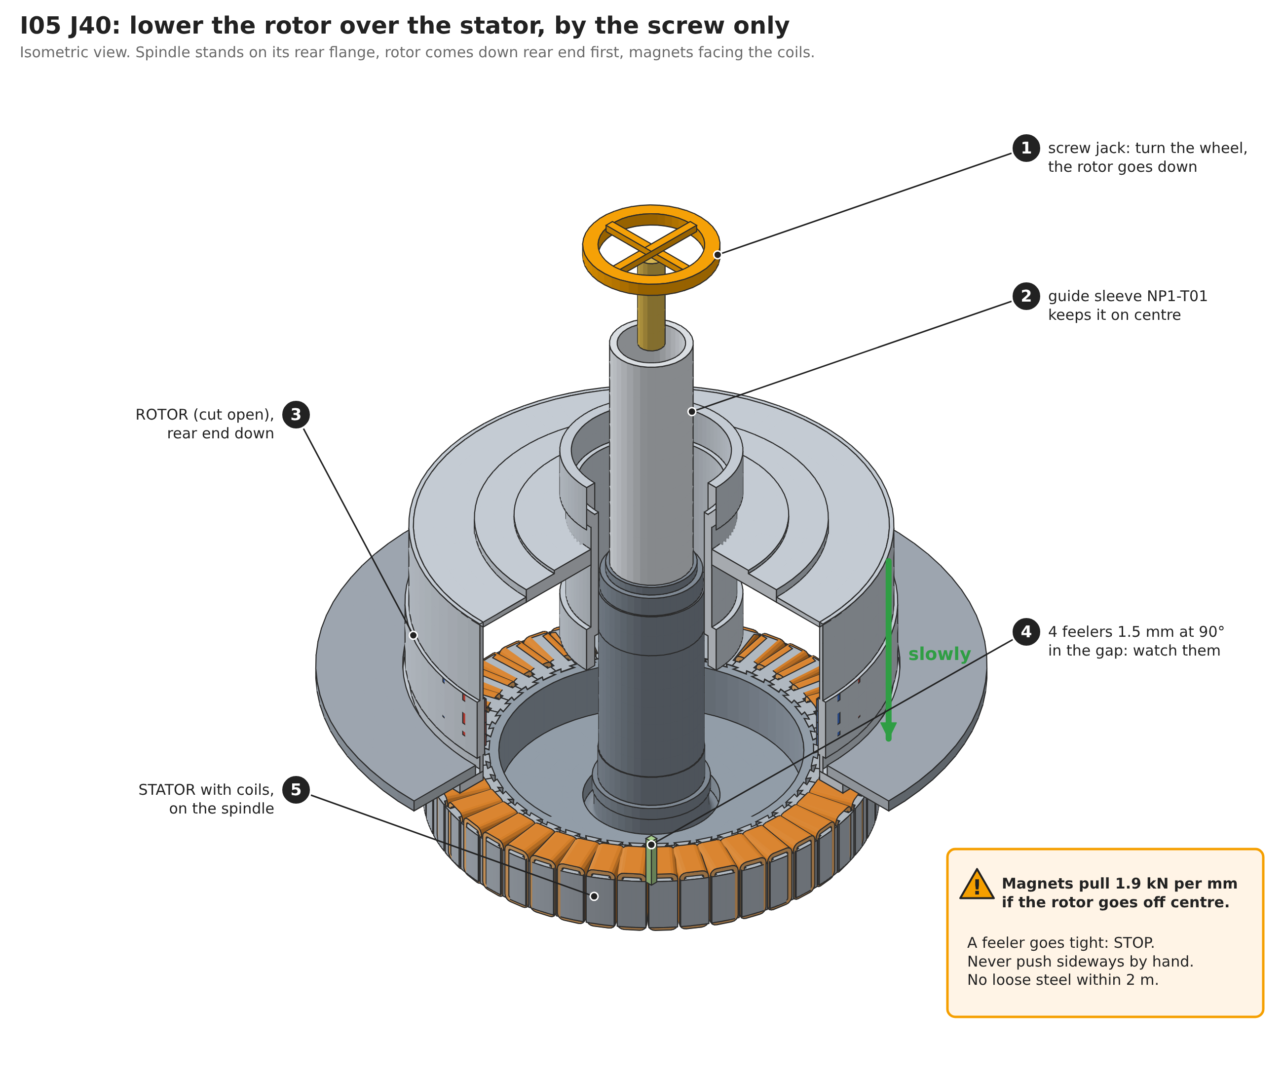
cad/generator_mfg/out/I05-iso-join.png
