safarcikm/Wind-turbines/cad/generator_mfg/out/M01-options.png

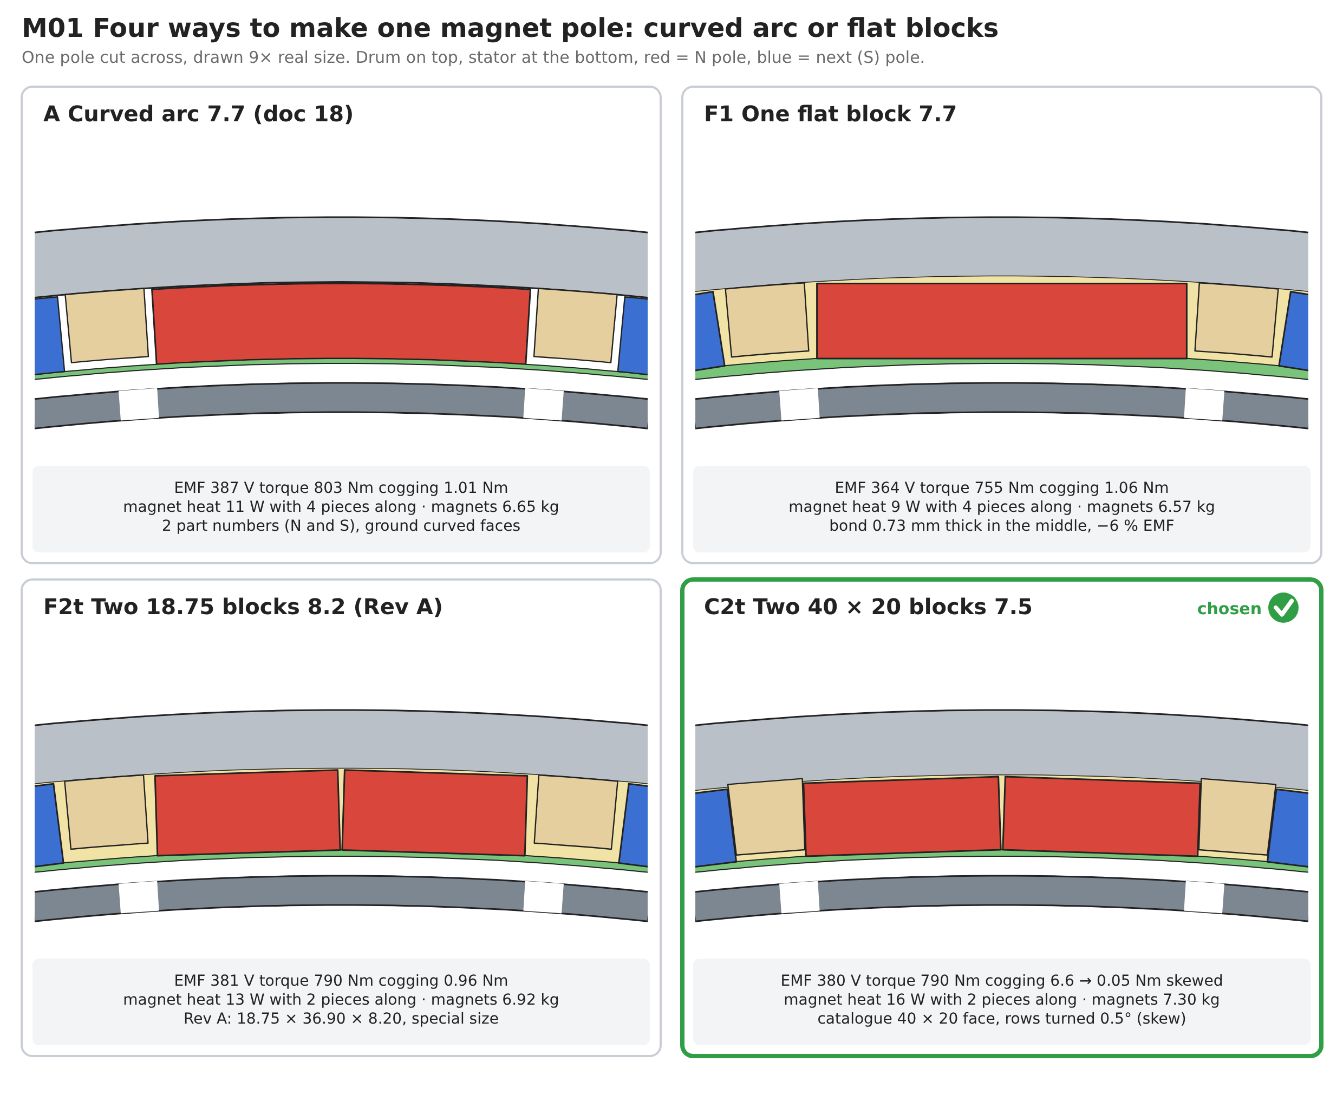
cad/generator_mfg/out/M01-options.png
