safarcikm/Wind-turbines/cad/generator_mfg/out/M03-block.png

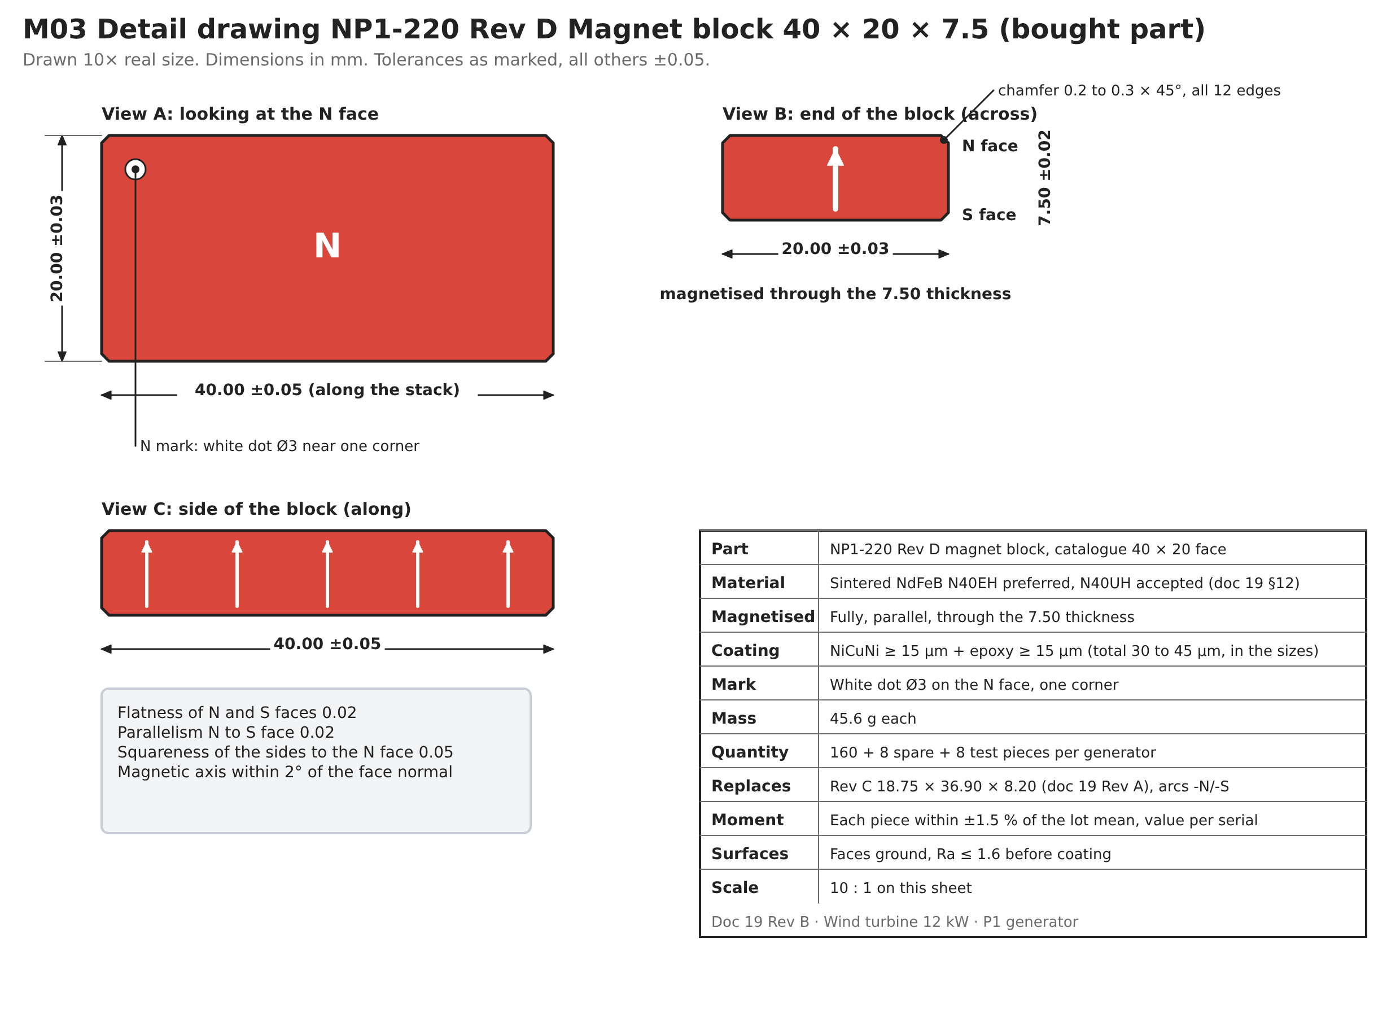
cad/generator_mfg/out/M03-block.png
