safarcikm/Wind-turbines/cad/generator_mfg/out/M04-pole_section.png

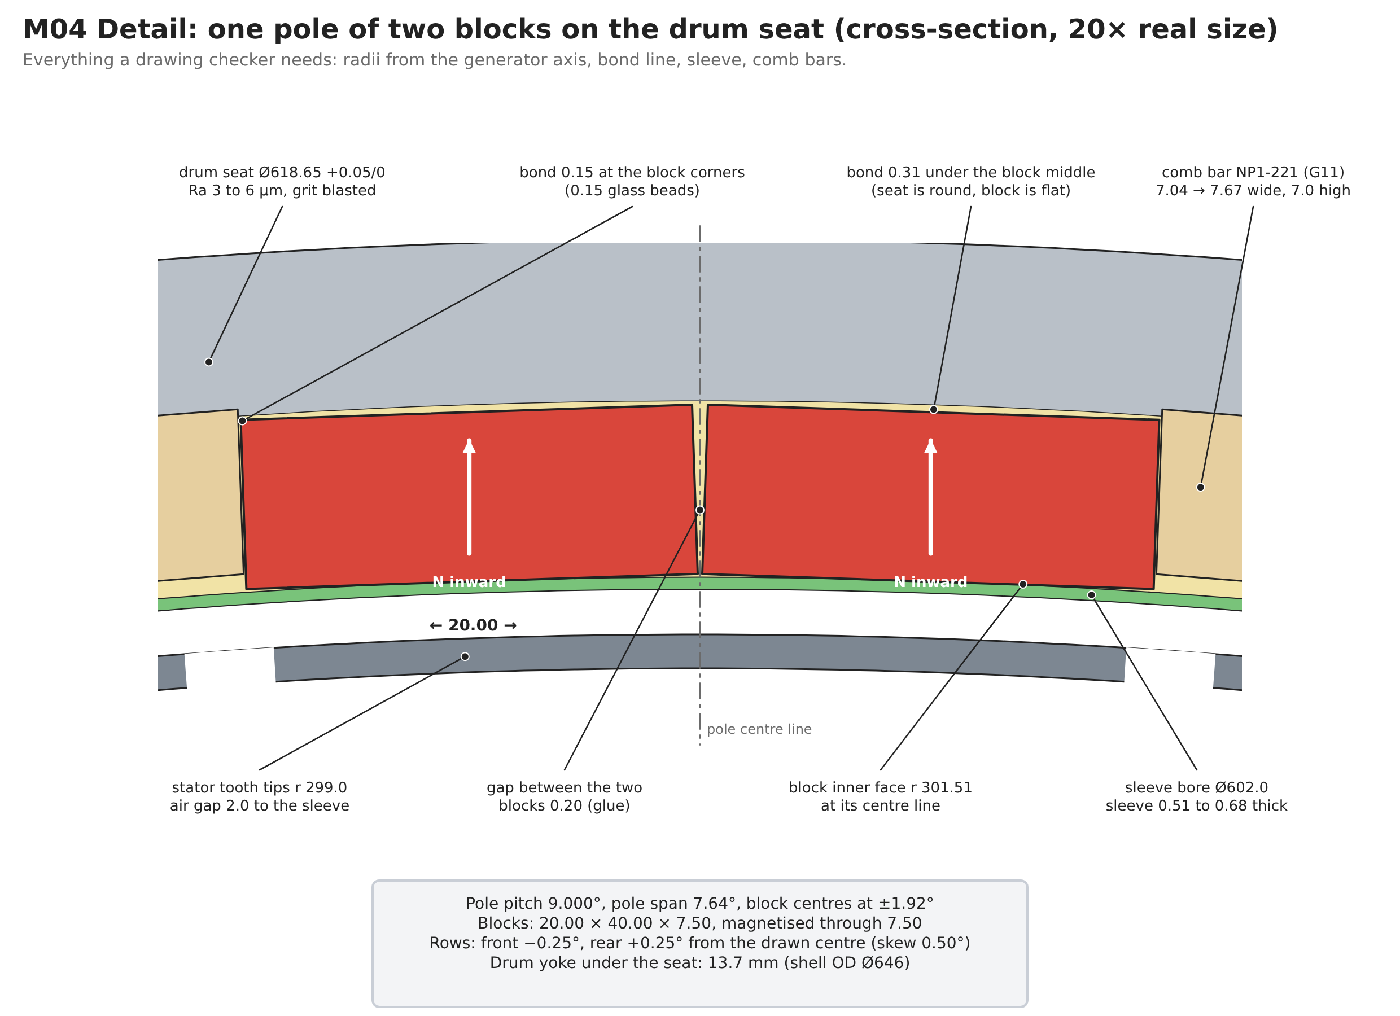
cad/generator_mfg/out/M04-pole_section.png
