safarcikm/Wind-turbines/cad/generator_mfg/out/M05-comb.png

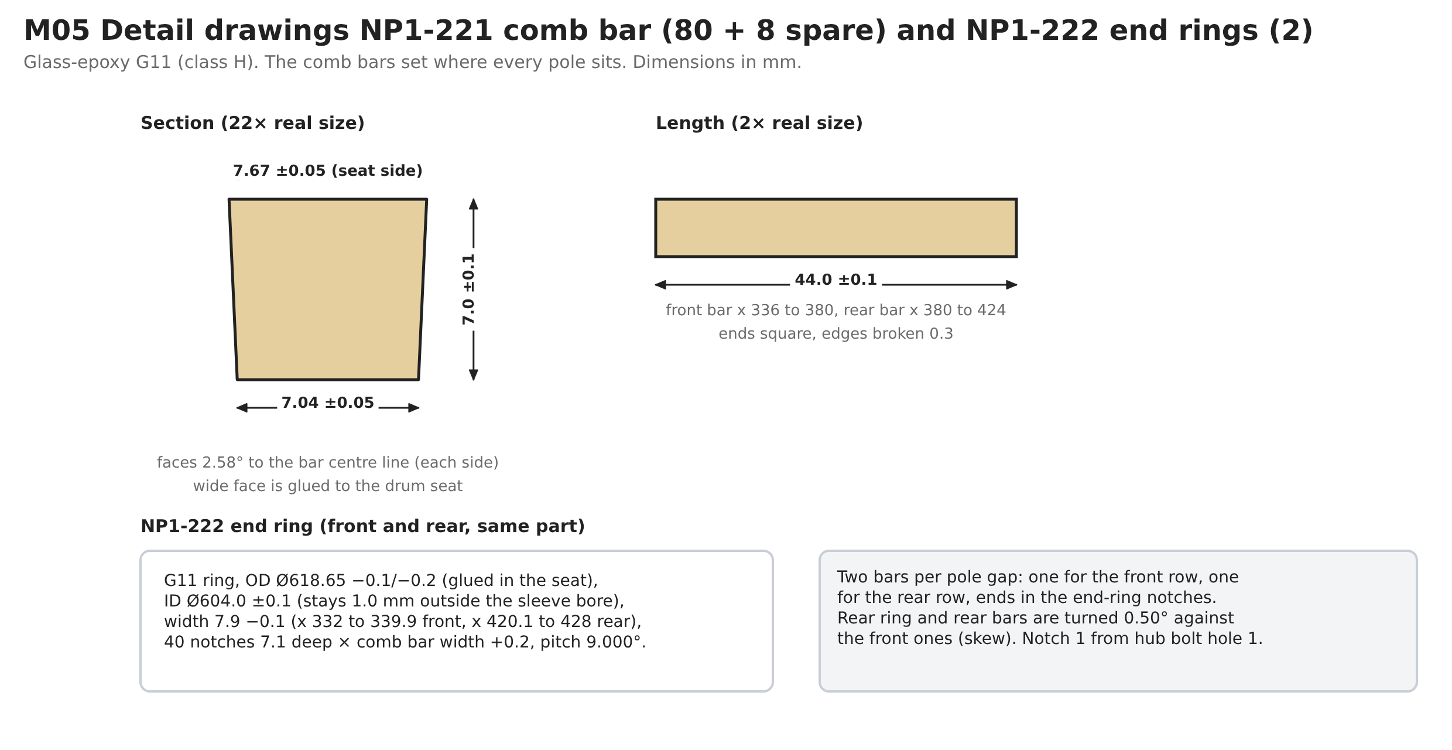
cad/generator_mfg/out/M05-comb.png
