safarcikm/Wind-turbines/cad/generator_mfg/out/M06-layout.png

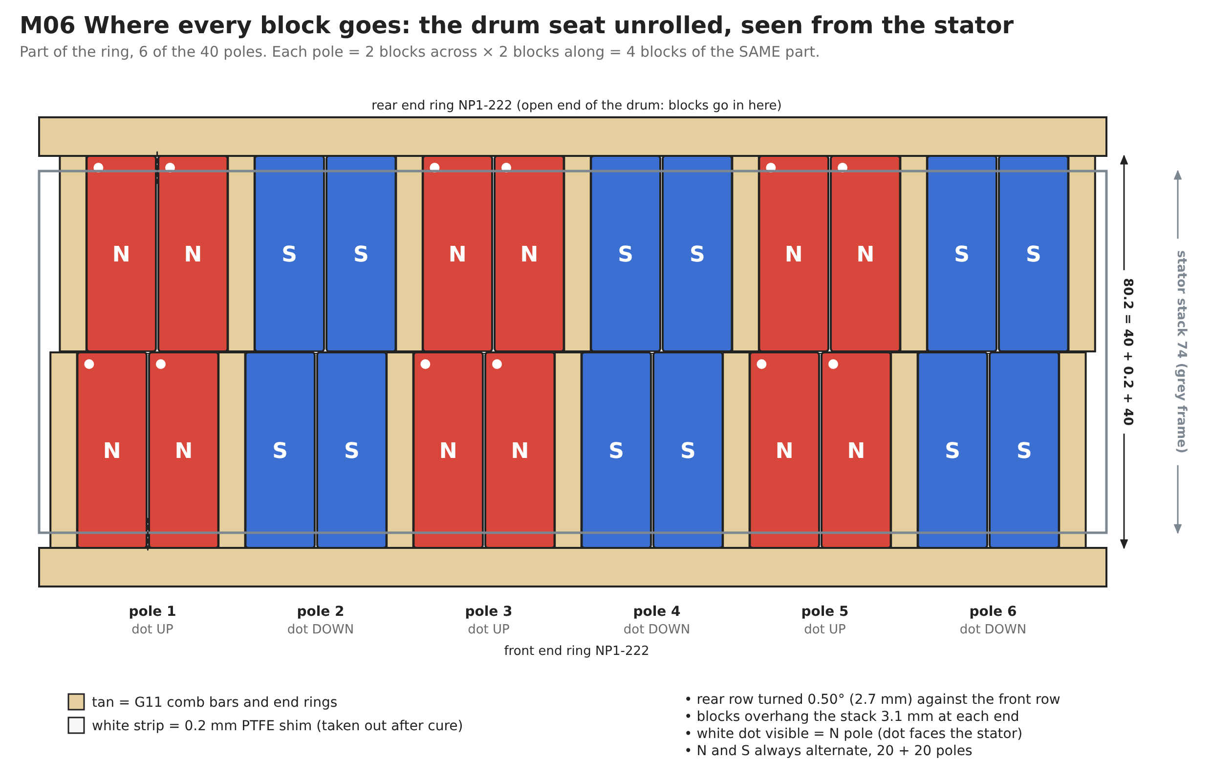
cad/generator_mfg/out/M06-layout.png
