safarcikm/Wind-turbines/cad/generator_mfg/out/M07-stack.png

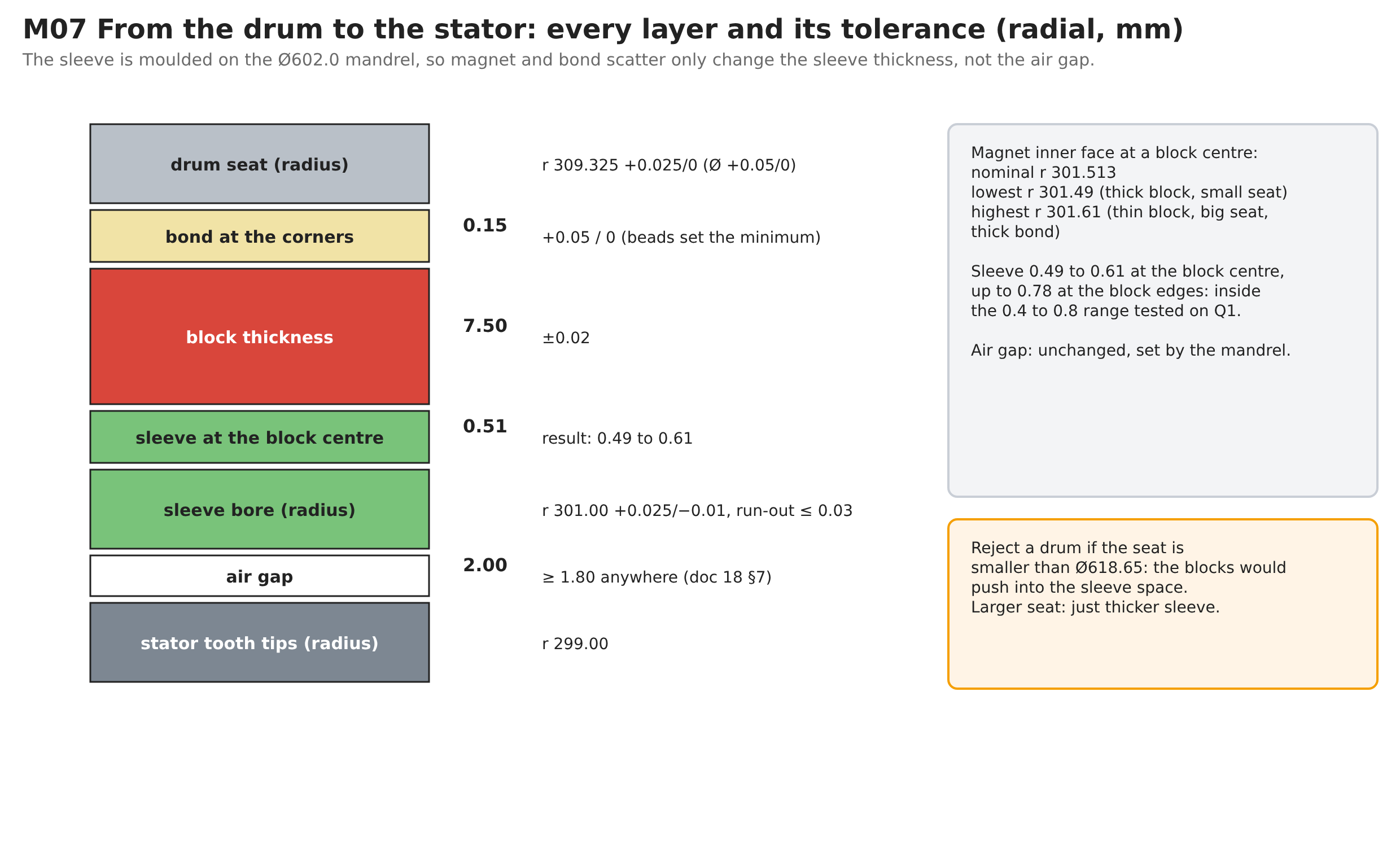
cad/generator_mfg/out/M07-stack.png
