safarcikm/Wind-turbines/cad/generator_mfg/out/M08-forces.png

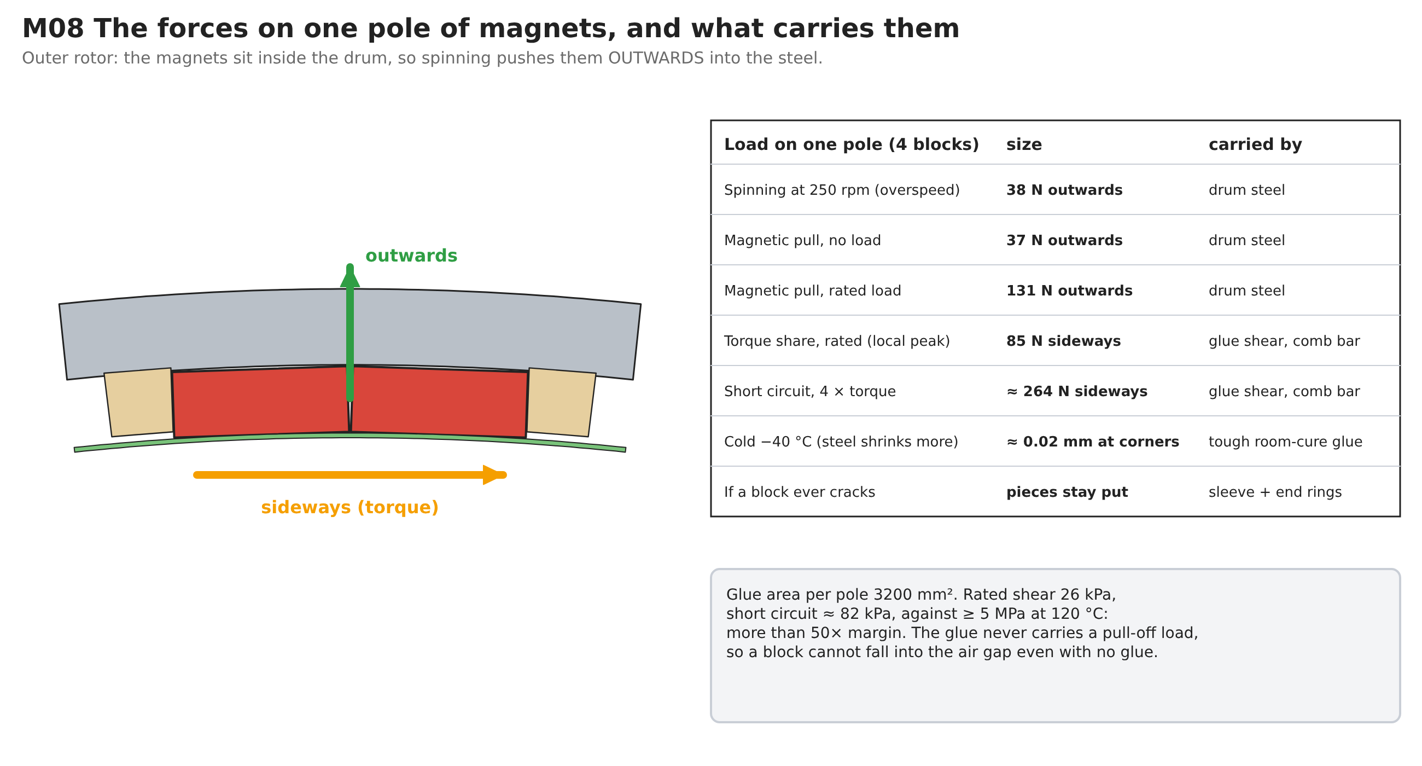
cad/generator_mfg/out/M08-forces.png
