safarcikm/Wind-turbines/cad/generator_mfg/out/M10-bond.png

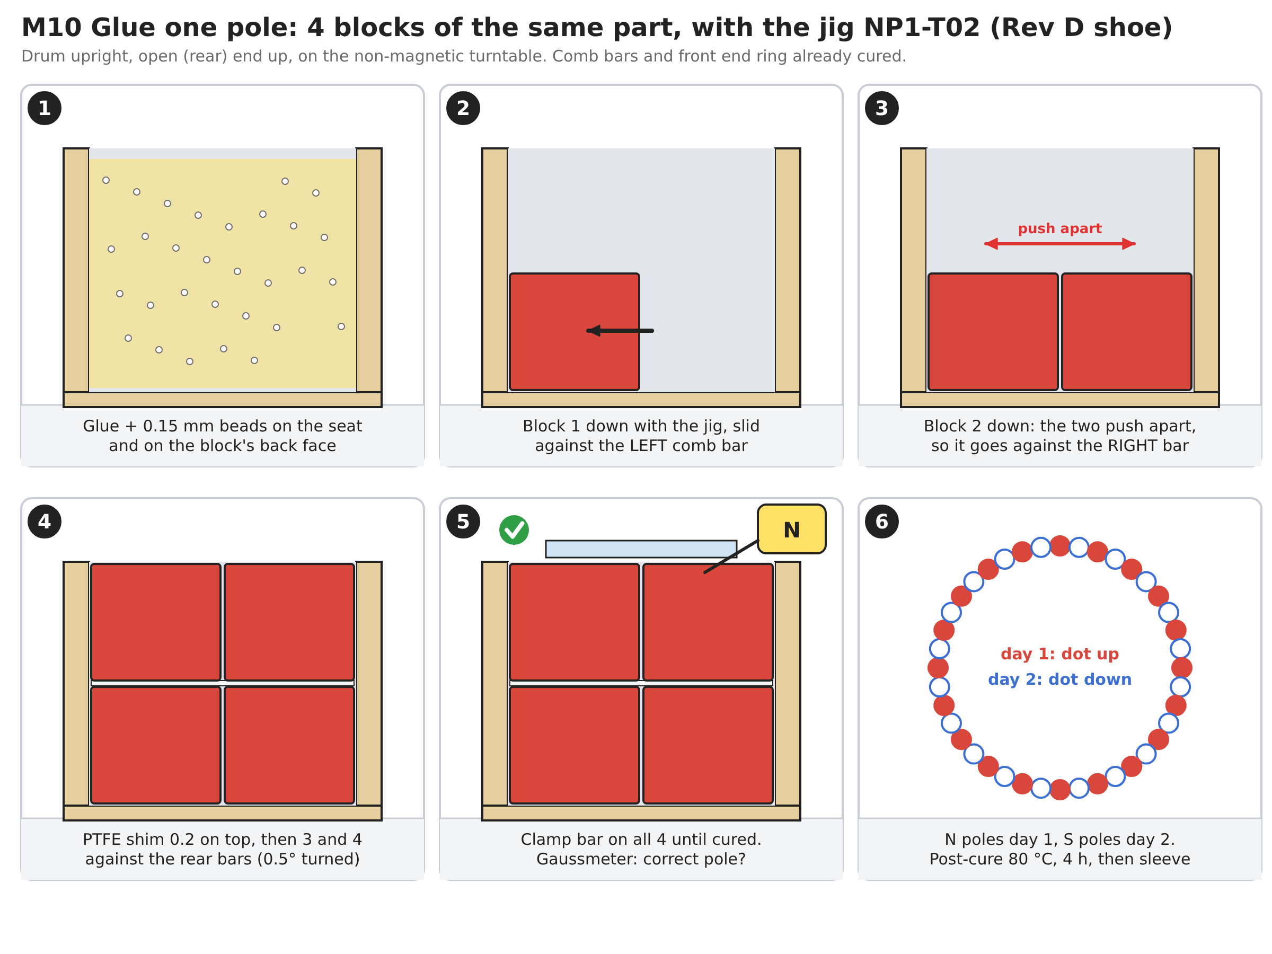
cad/generator_mfg/out/M10-bond.png
