safarcikm/Wind-turbines/cad/generator_mfg/out/M11-grades.png

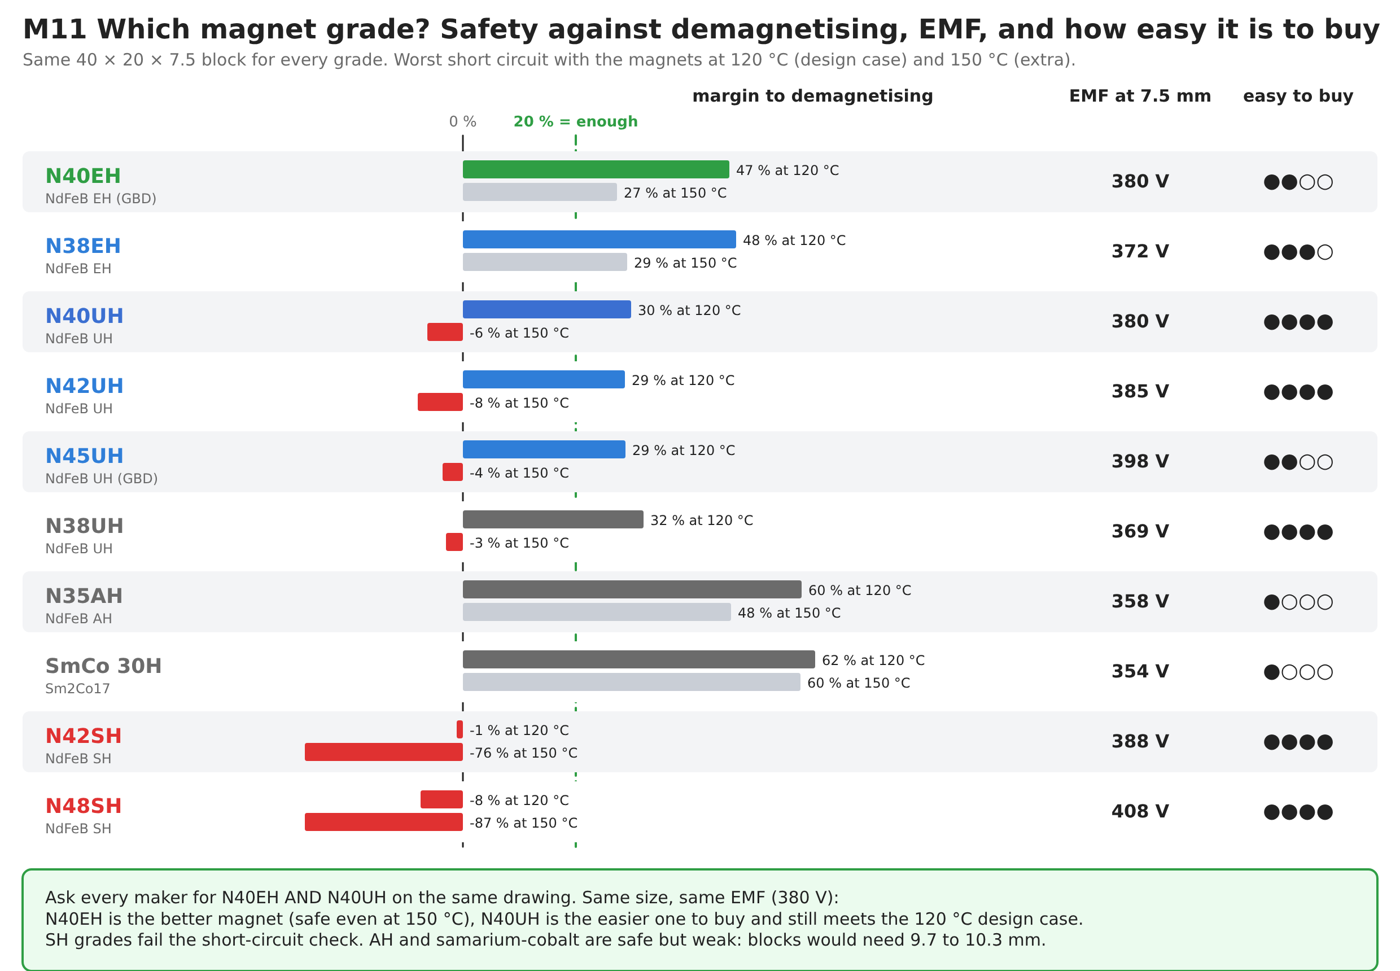
cad/generator_mfg/out/M11-grades.png
