safarcikm/Wind-turbines/cad/generator_mfg/out/MI01-block.png

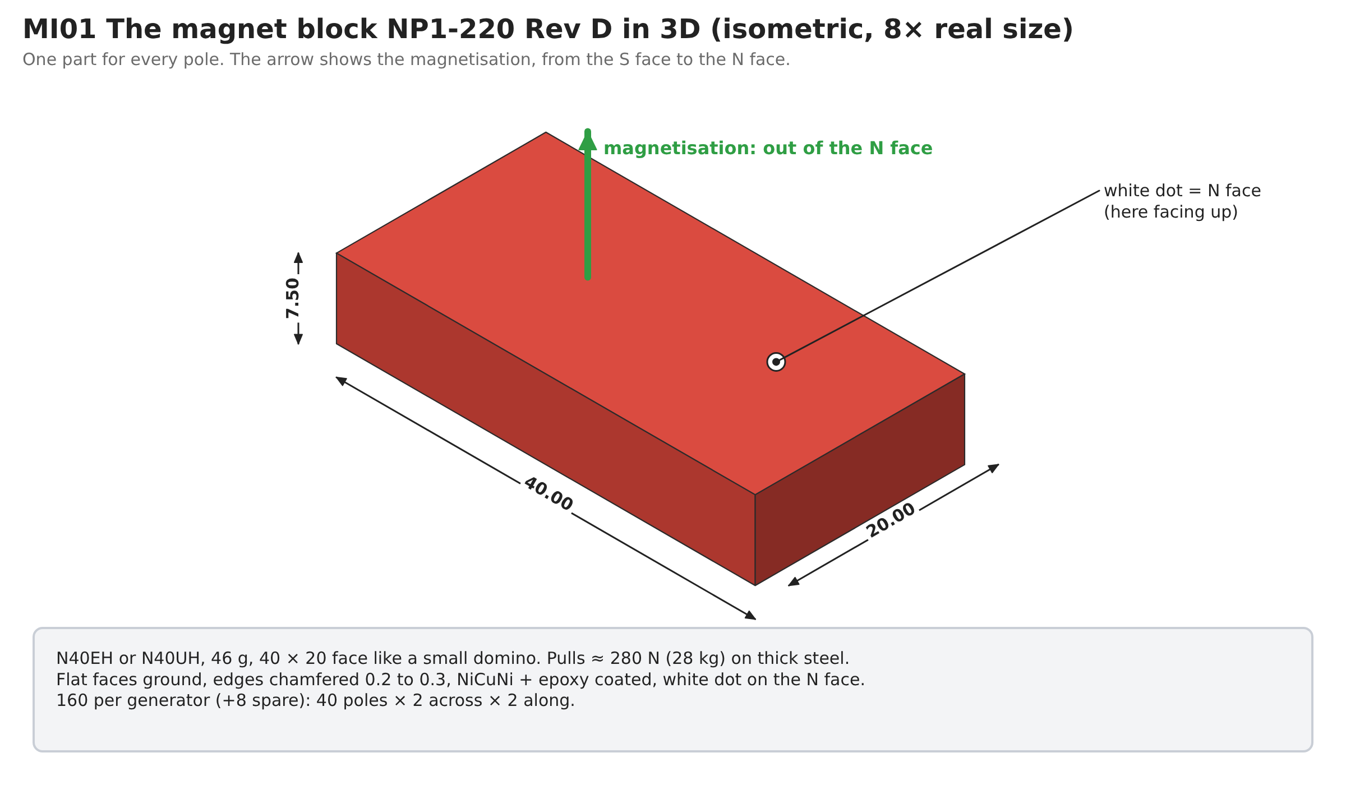
cad/generator_mfg/out/MI01-block.png
