safarcikm/Wind-turbines/cad/generator_mfg/out/MI02-pole.png

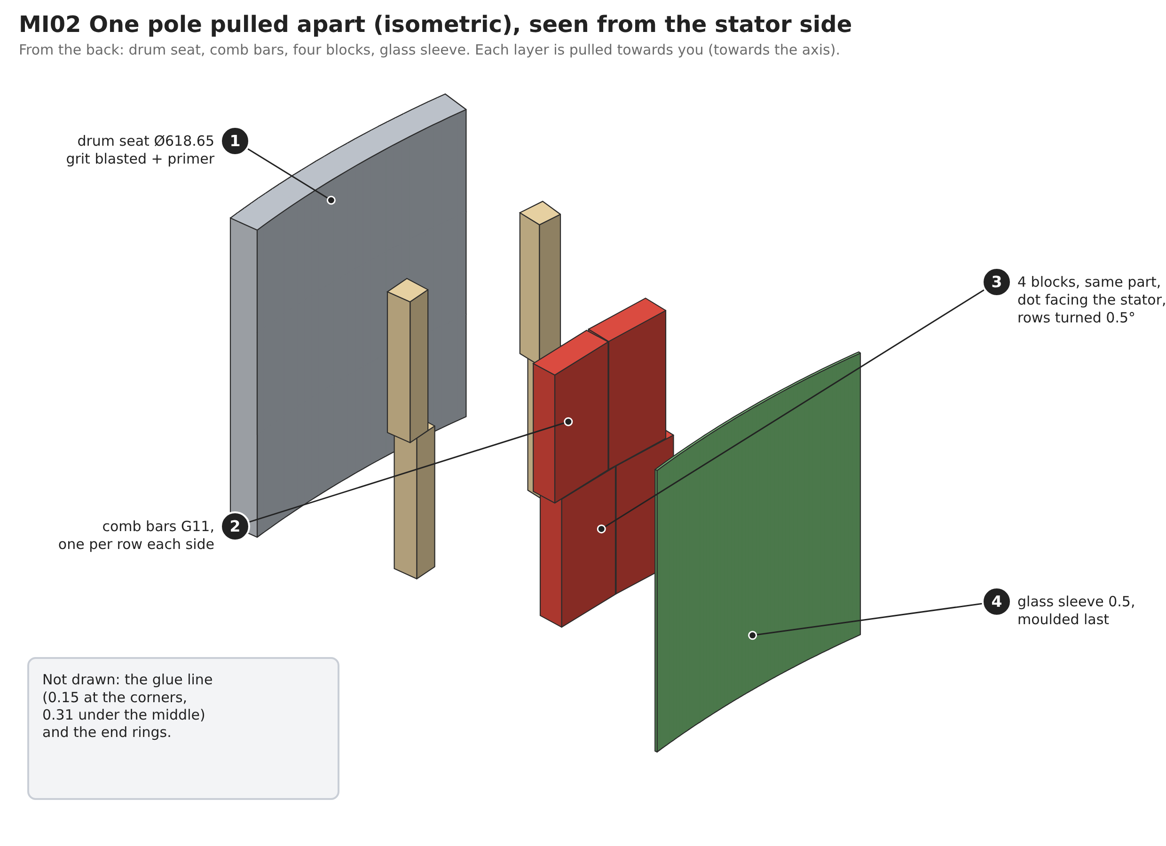
cad/generator_mfg/out/MI02-pole.png
