safarcikm/Wind-turbines/cad/generator_mfg/out/MI03-drum.png

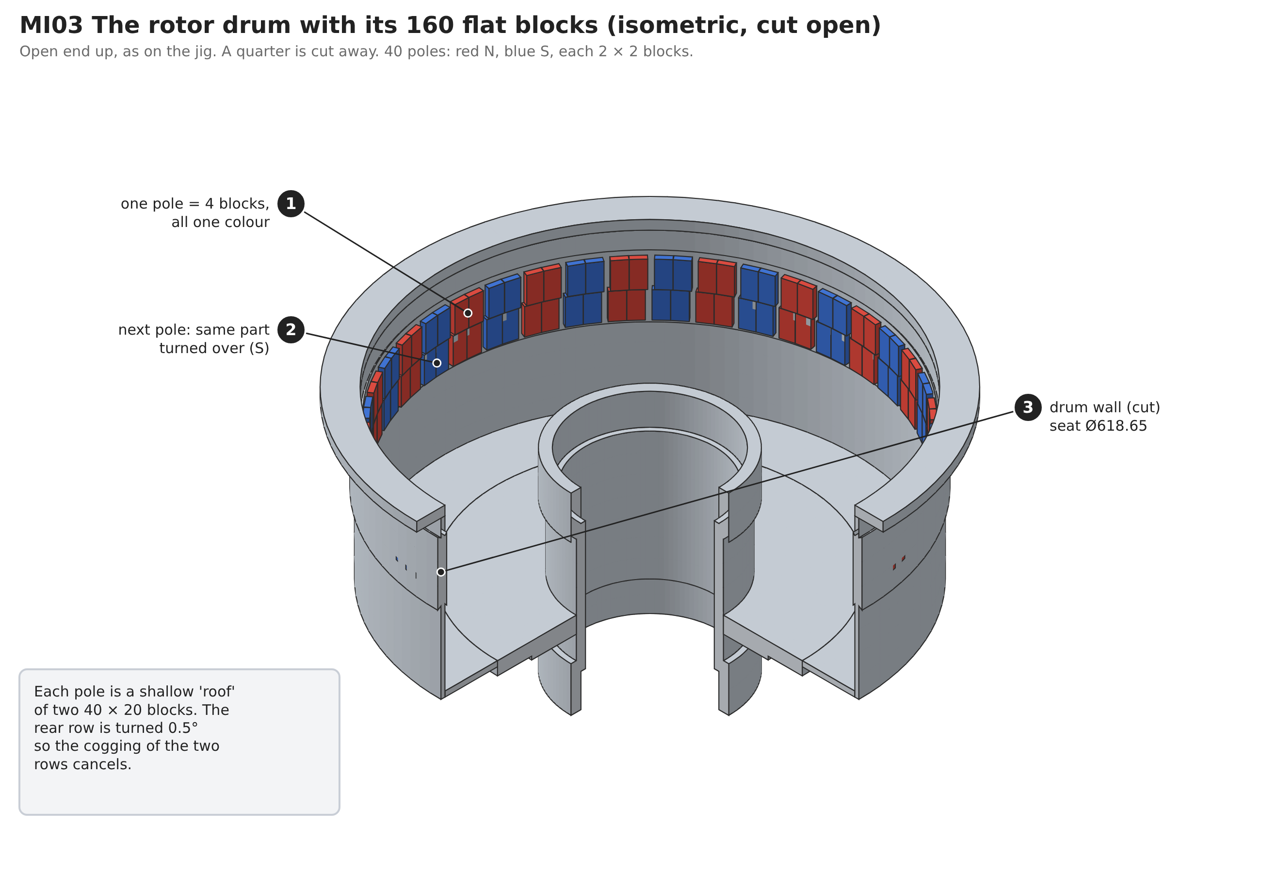
cad/generator_mfg/out/MI03-drum.png
