safarcikm/Wind-turbines/cad/generator_mfg/out/MI04-compare.png

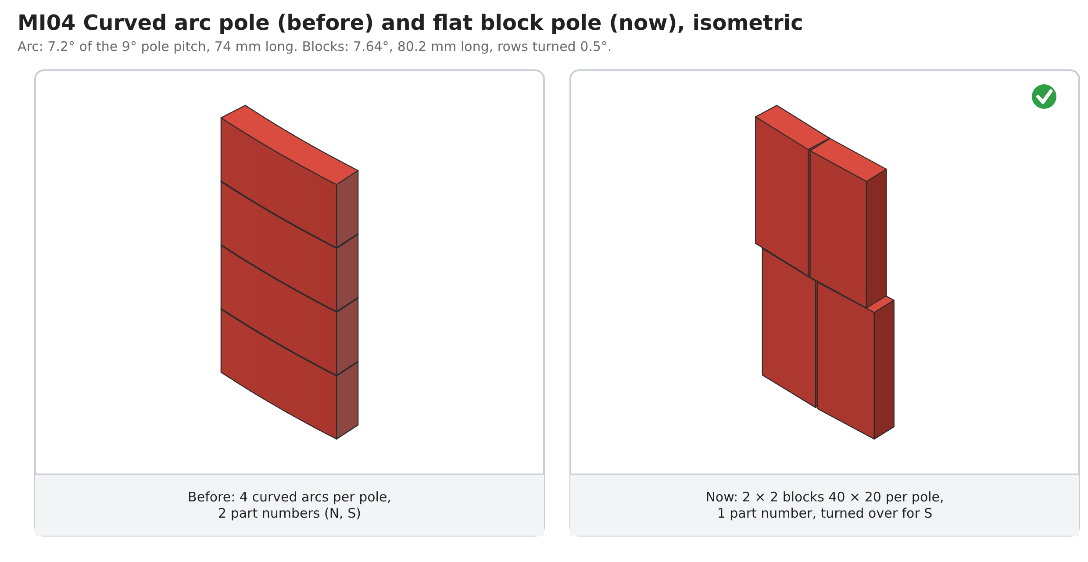
cad/generator_mfg/out/MI04-compare.png
