safarcikm/Wind-turbines/cad/turbine_6kw/out/iso/A01-turbine.png

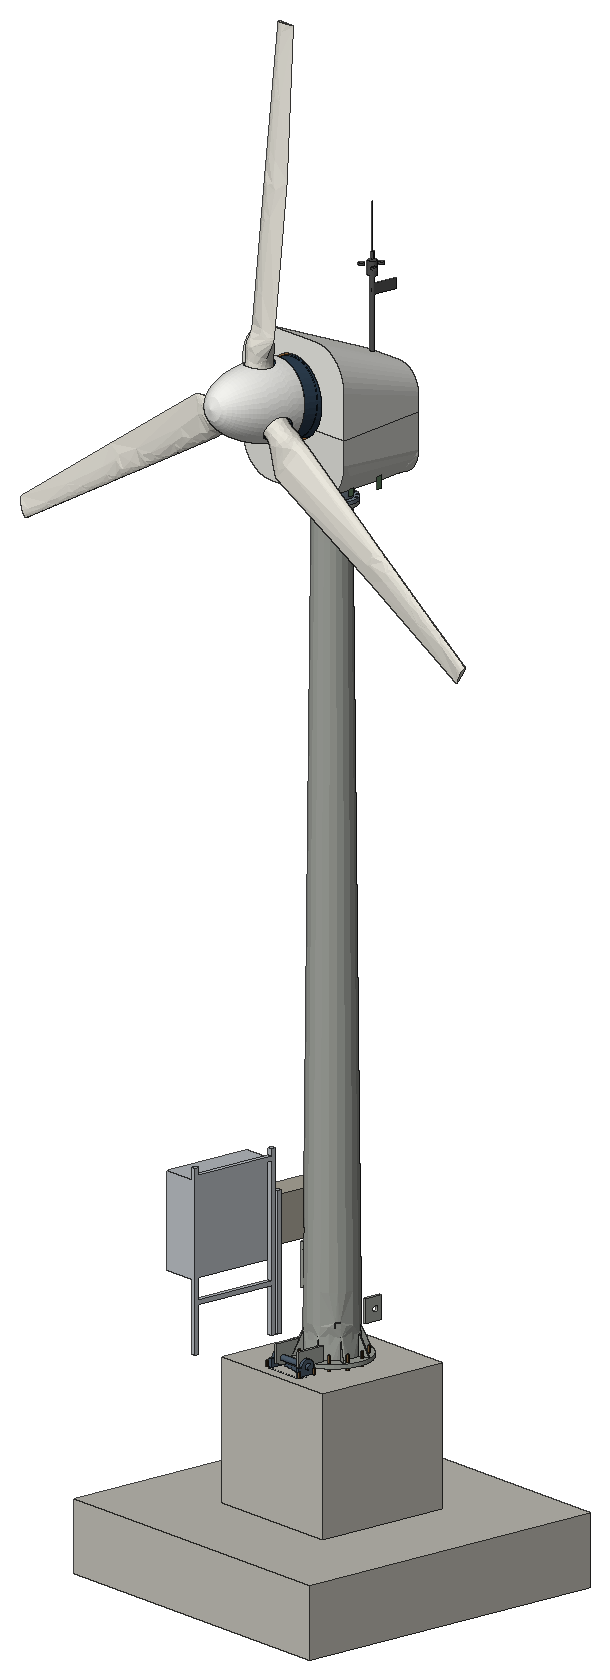
cad/turbine_6kw/out/iso/A01-turbine.png
