safarcikm/Wind-turbines/cad/turbine_6kw/out/iso/A02-head.png

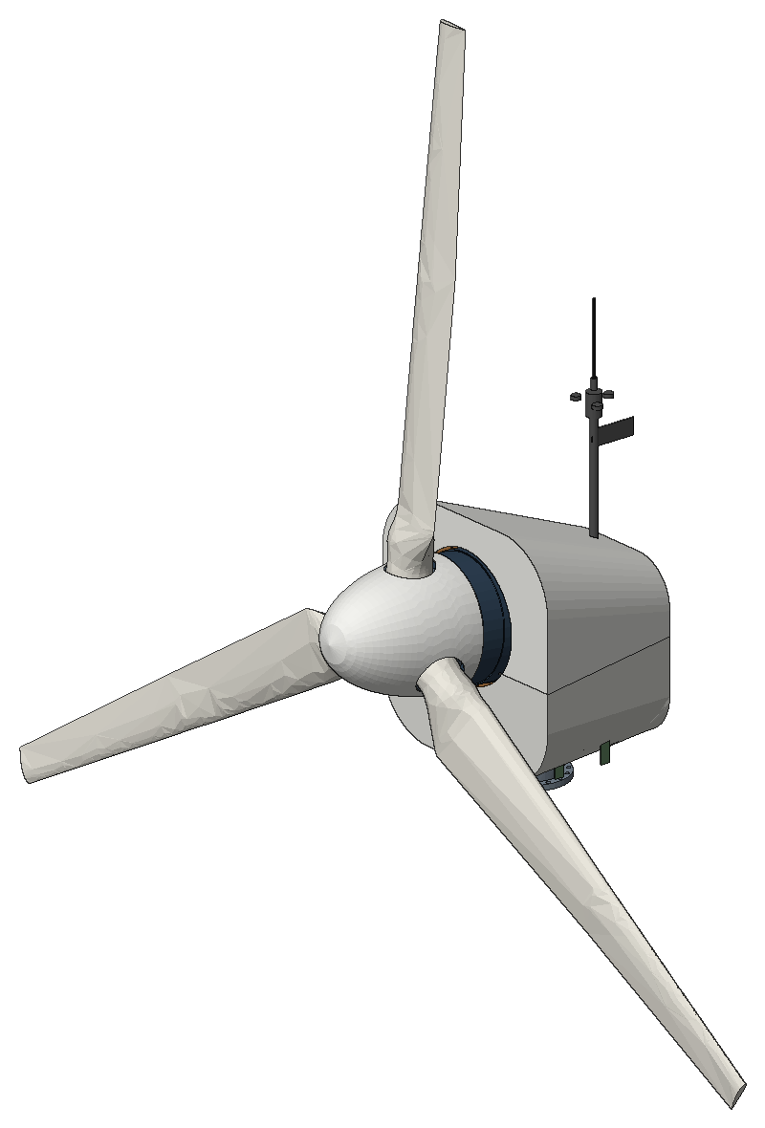
cad/turbine_6kw/out/iso/A02-head.png
