safarcikm/Wind-turbines/cad/turbine_6kw/out/iso/A03-nacelle-open.png

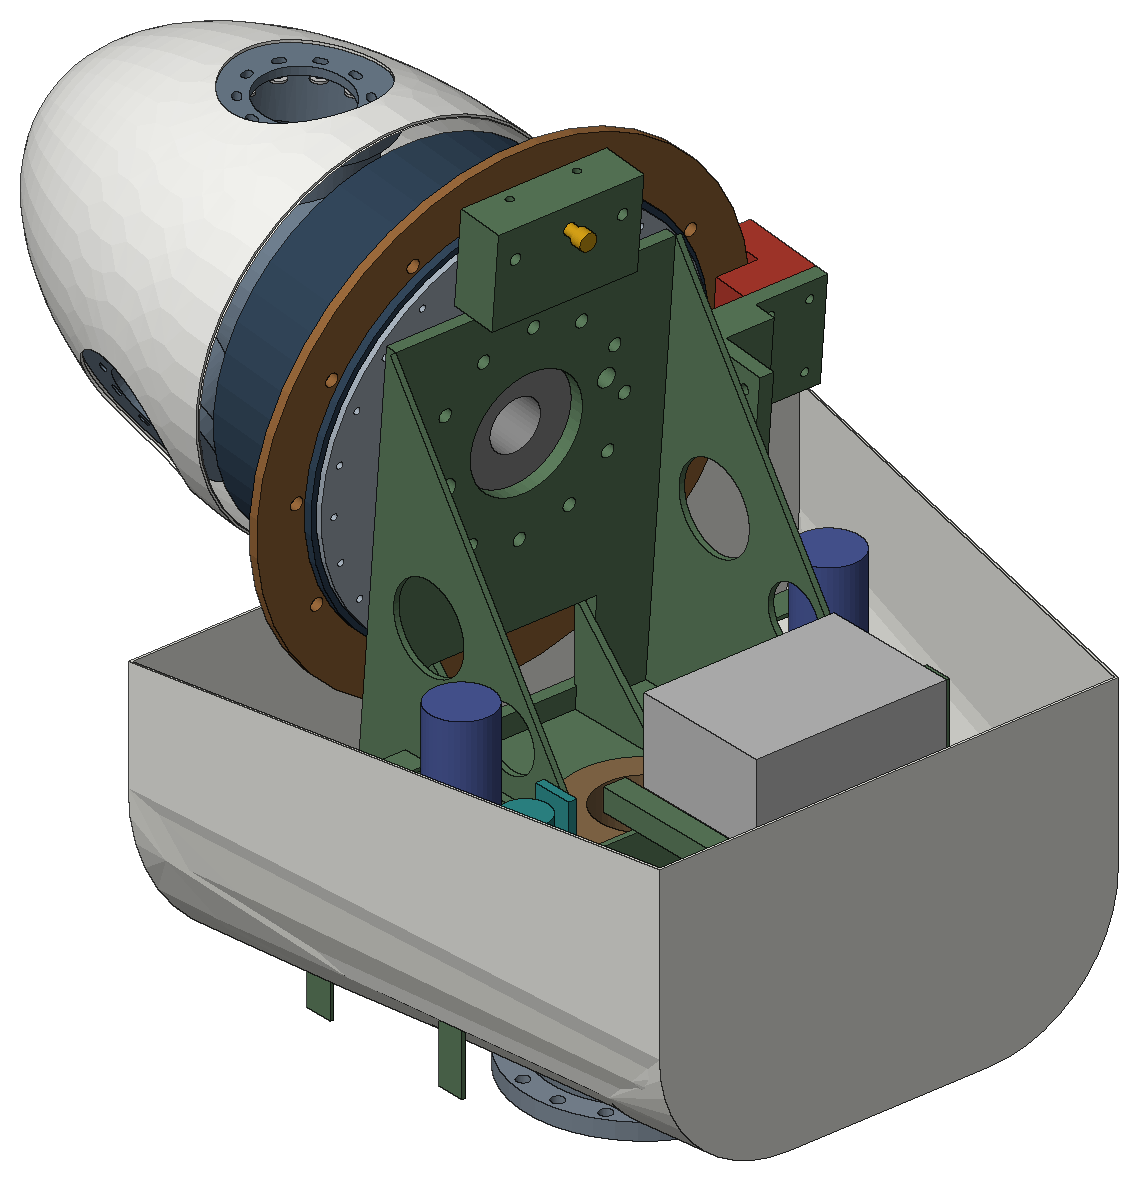
cad/turbine_6kw/out/iso/A03-nacelle-open.png
