safarcikm/Wind-turbines/cad/turbine_6kw/out/iso/A04-rotor.png

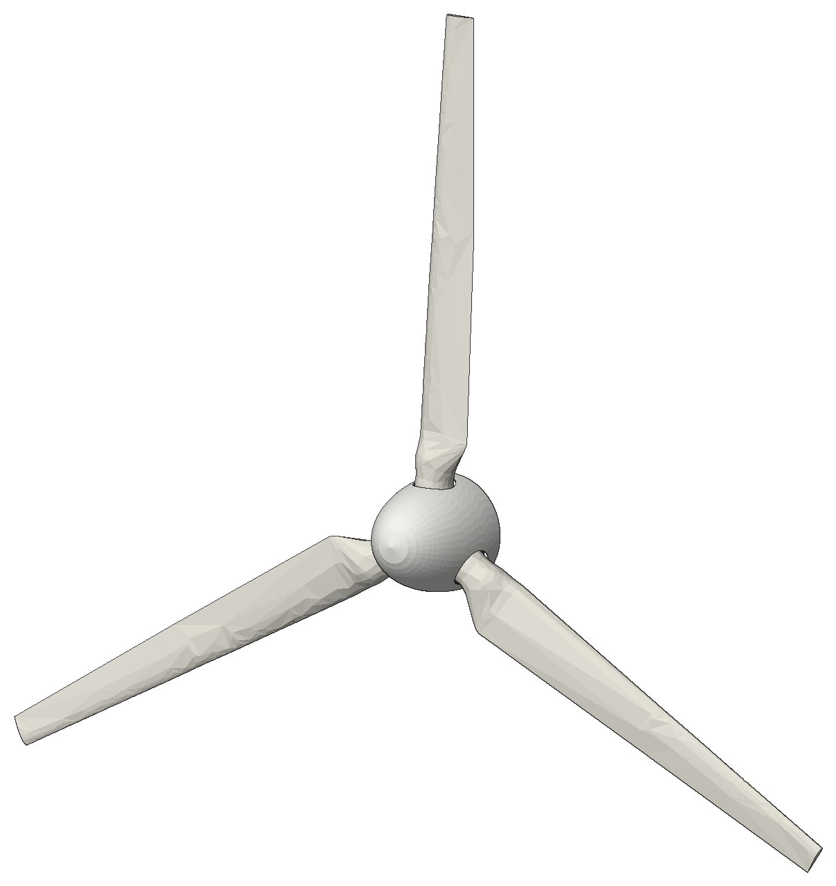
cad/turbine_6kw/out/iso/A04-rotor.png
