safarcikm/Wind-turbines/cad/turbine_6kw/out/iso/A05-tower-base.png

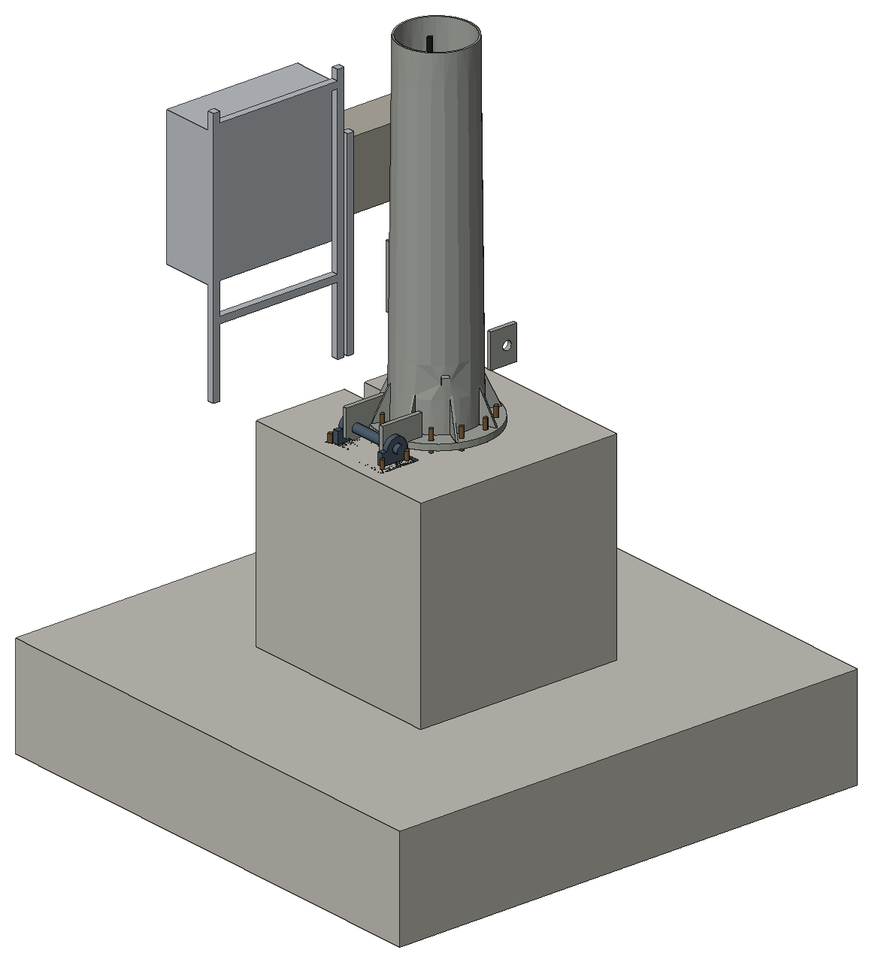
cad/turbine_6kw/out/iso/A05-tower-base.png
