safarcikm/Wind-turbines/cad/turbine_6kw/out/iso/A06-tilt-up.png

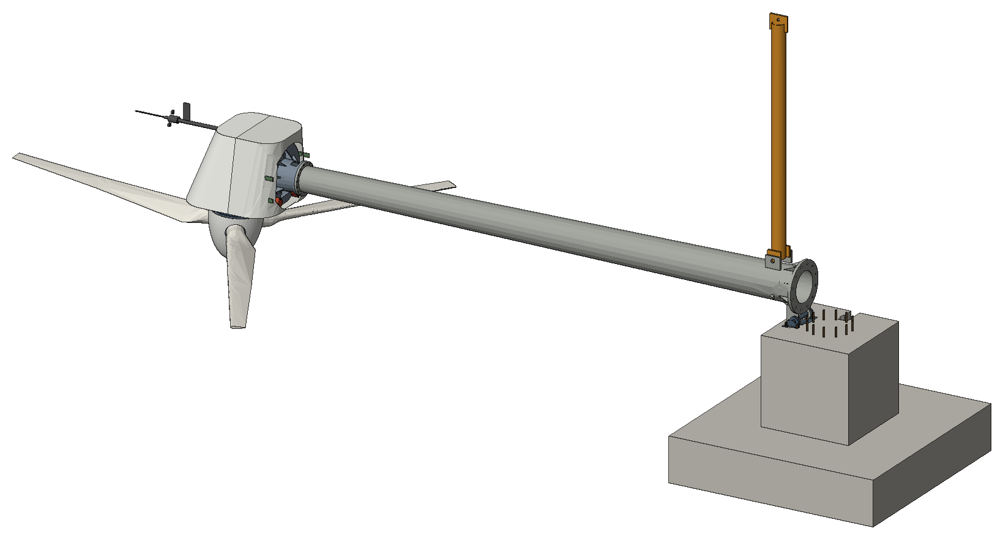
cad/turbine_6kw/out/iso/A06-tilt-up.png
