safarcikm/Wind-turbines/cad/turbine_6kw/out/iso/A07-mould.png

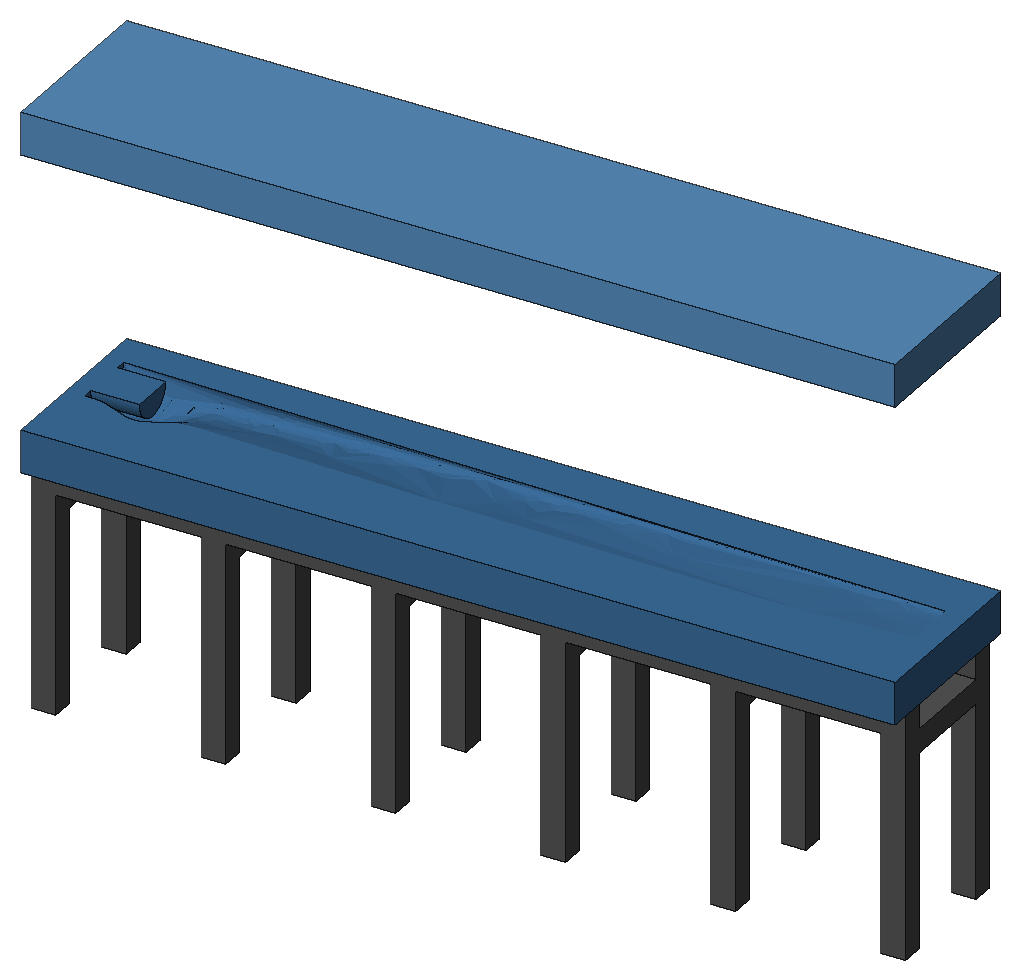
cad/turbine_6kw/out/iso/A07-mould.png
