safarcikm/Wind-turbines/cad/turbine_6kw/out/iso/X-blade.png

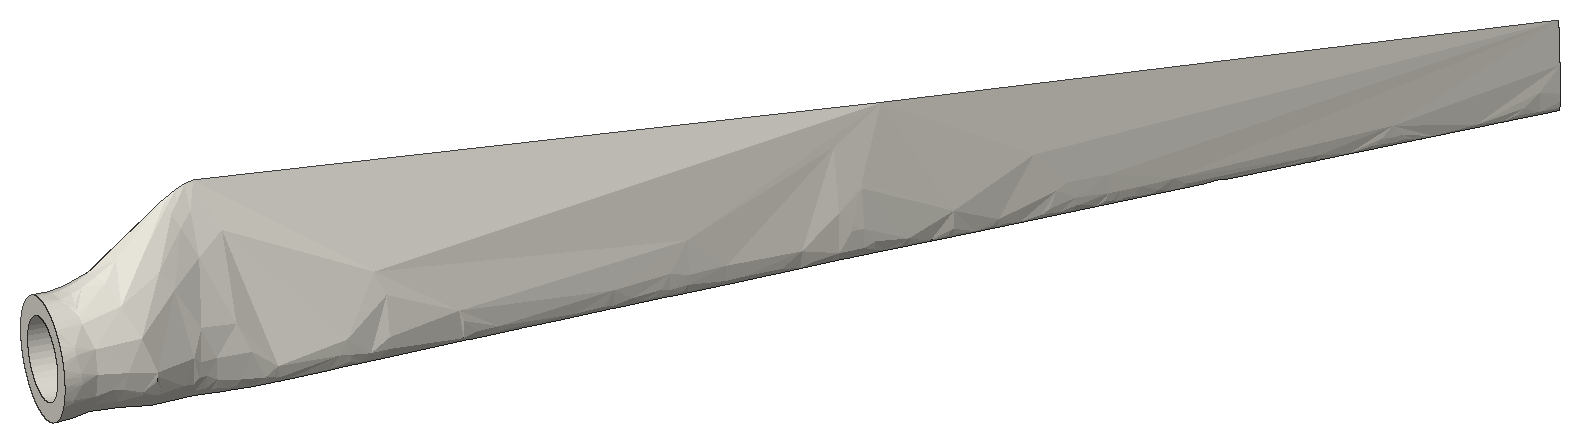
cad/turbine_6kw/out/iso/X-blade.png
