safarcikm/Wind-turbines/cad/turbine_6kw/out/iso/X-insert.png

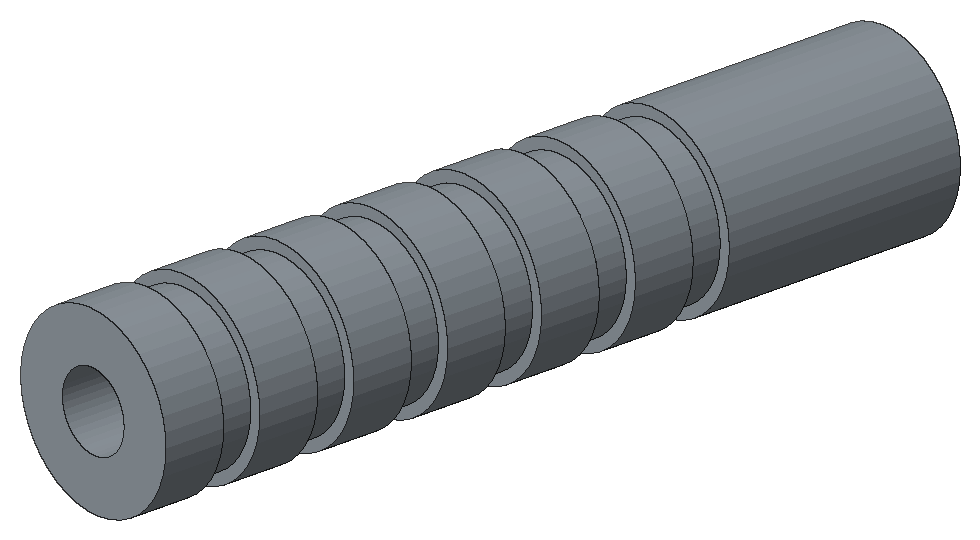
cad/turbine_6kw/out/iso/X-insert.png
