safarcikm/Wind-turbines/cad/turbine_6kw/out/iso/X-pitch.png

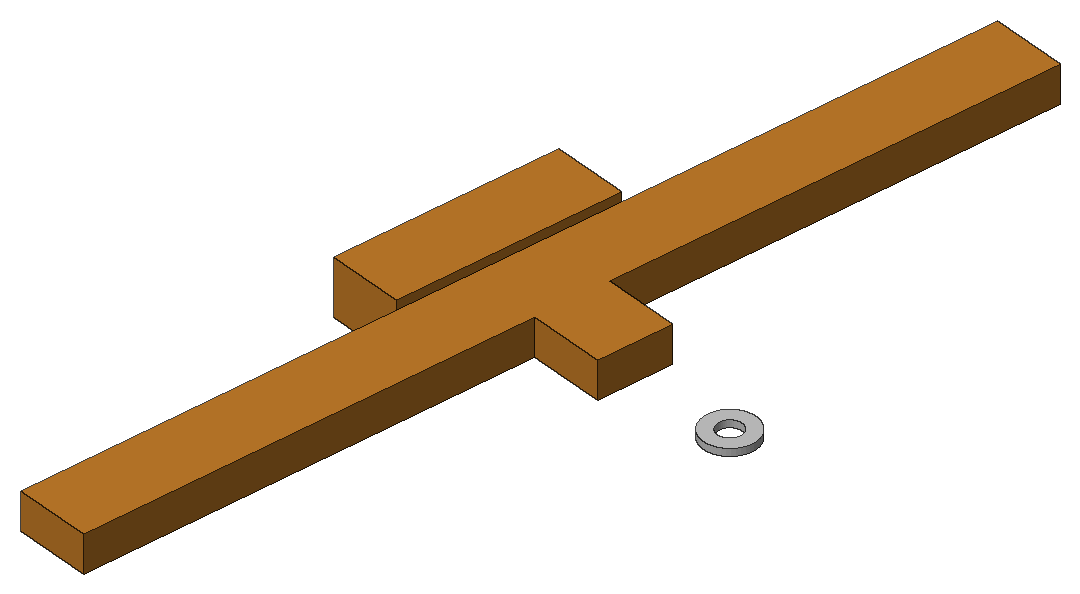
cad/turbine_6kw/out/iso/X-pitch.png
