safarcikm/Wind-turbines/cad/turbine_6kw/out/png/NS6-001.png

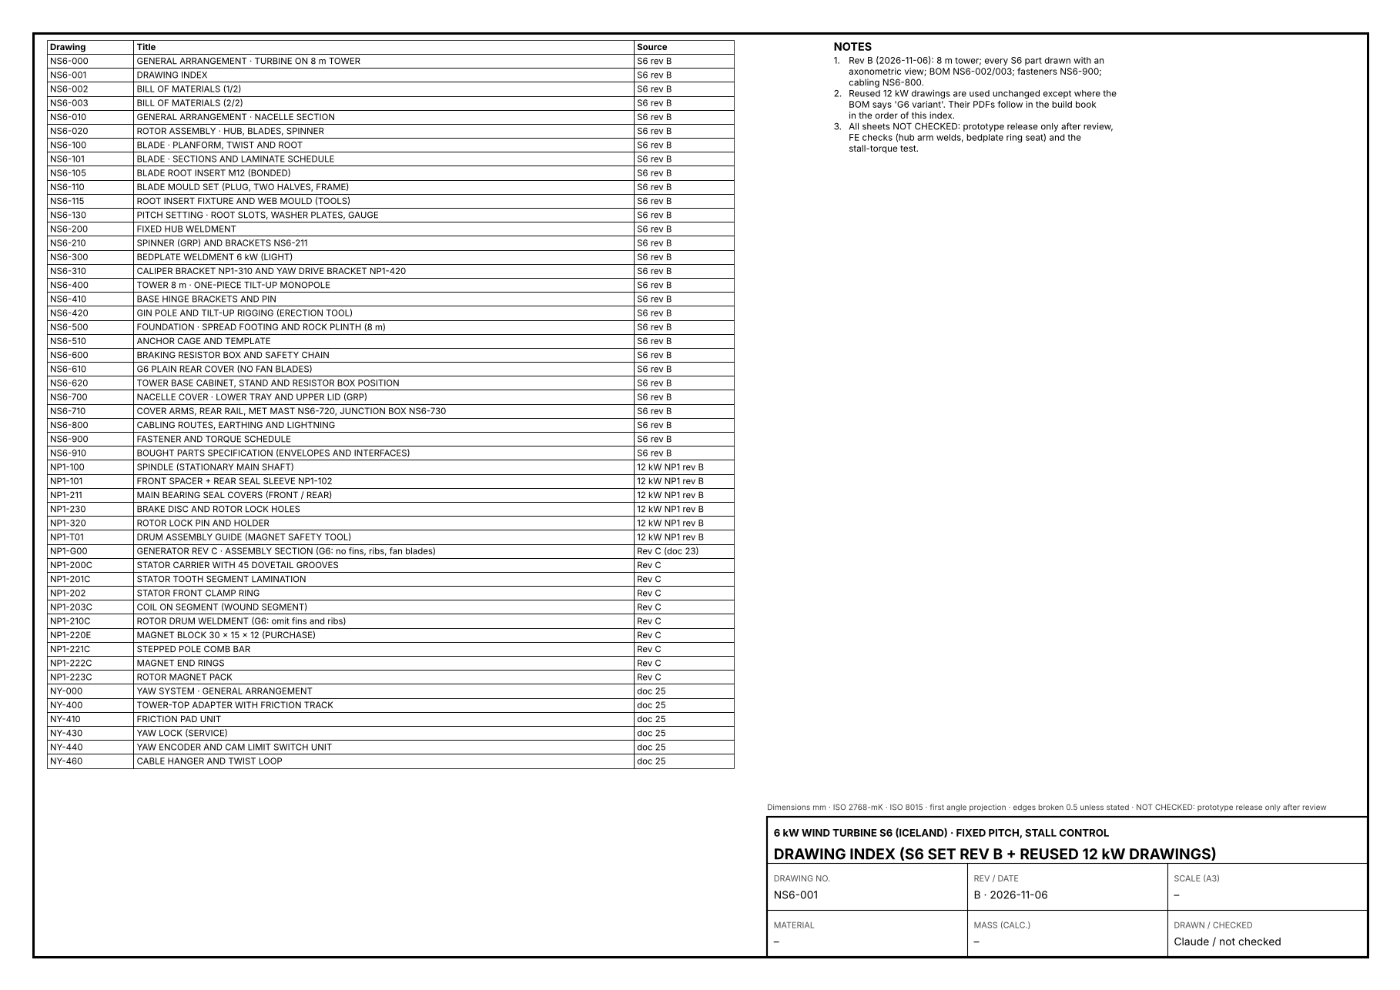
cad/turbine_6kw/out/png/NS6-001.png
