safarcikm/Wind-turbines/cad/turbine_6kw/out/png/NS6-100.png

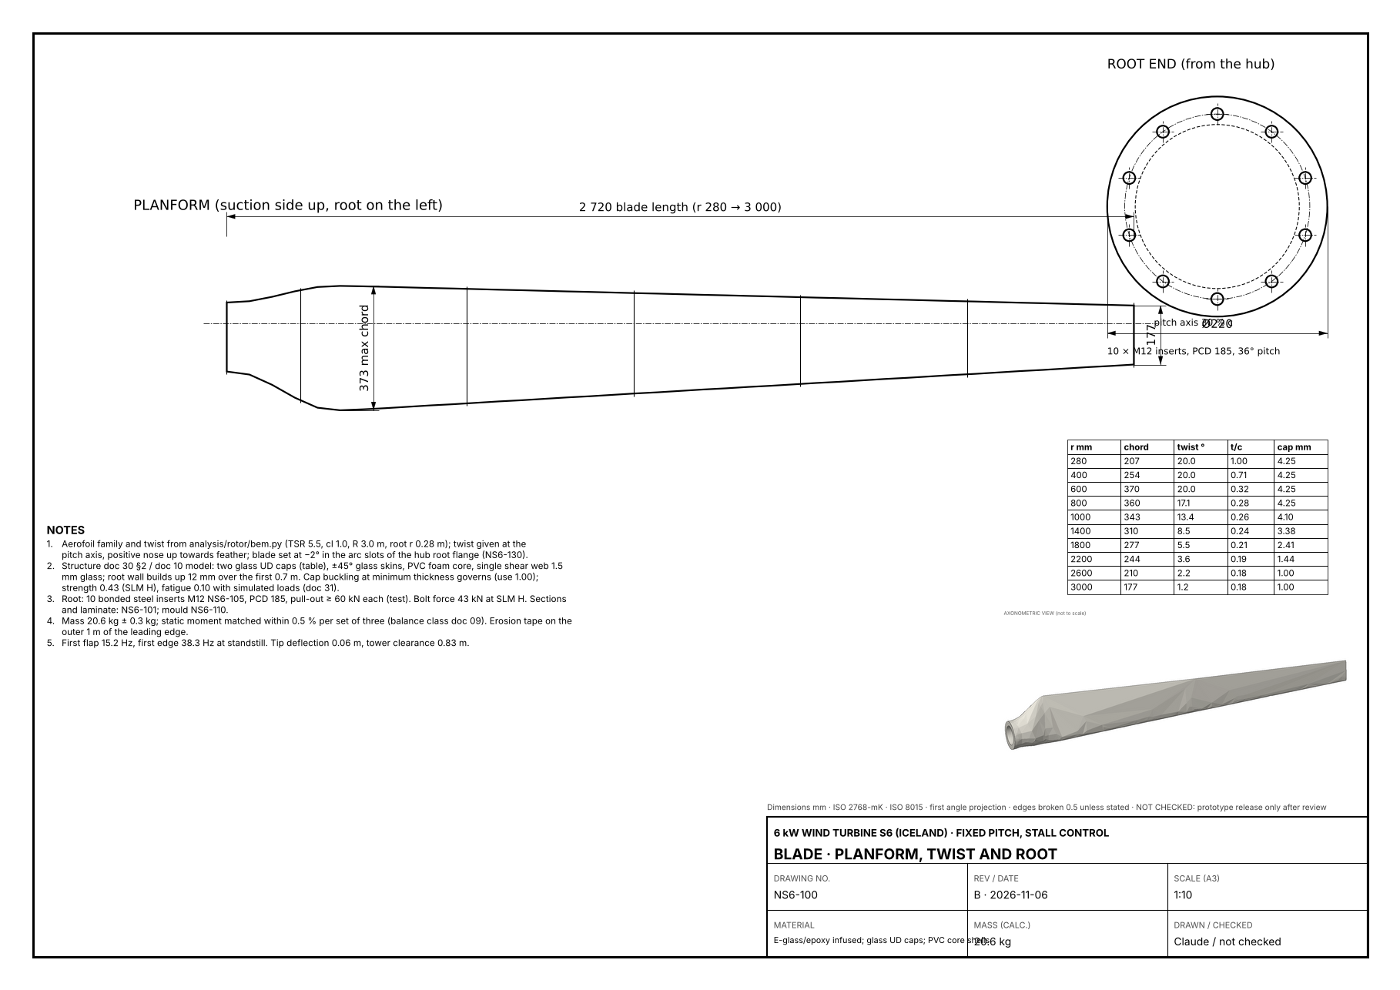
cad/turbine_6kw/out/png/NS6-100.png
