safarcikm/Wind-turbines/cad/turbine_6kw/out/png/NS6-115.png

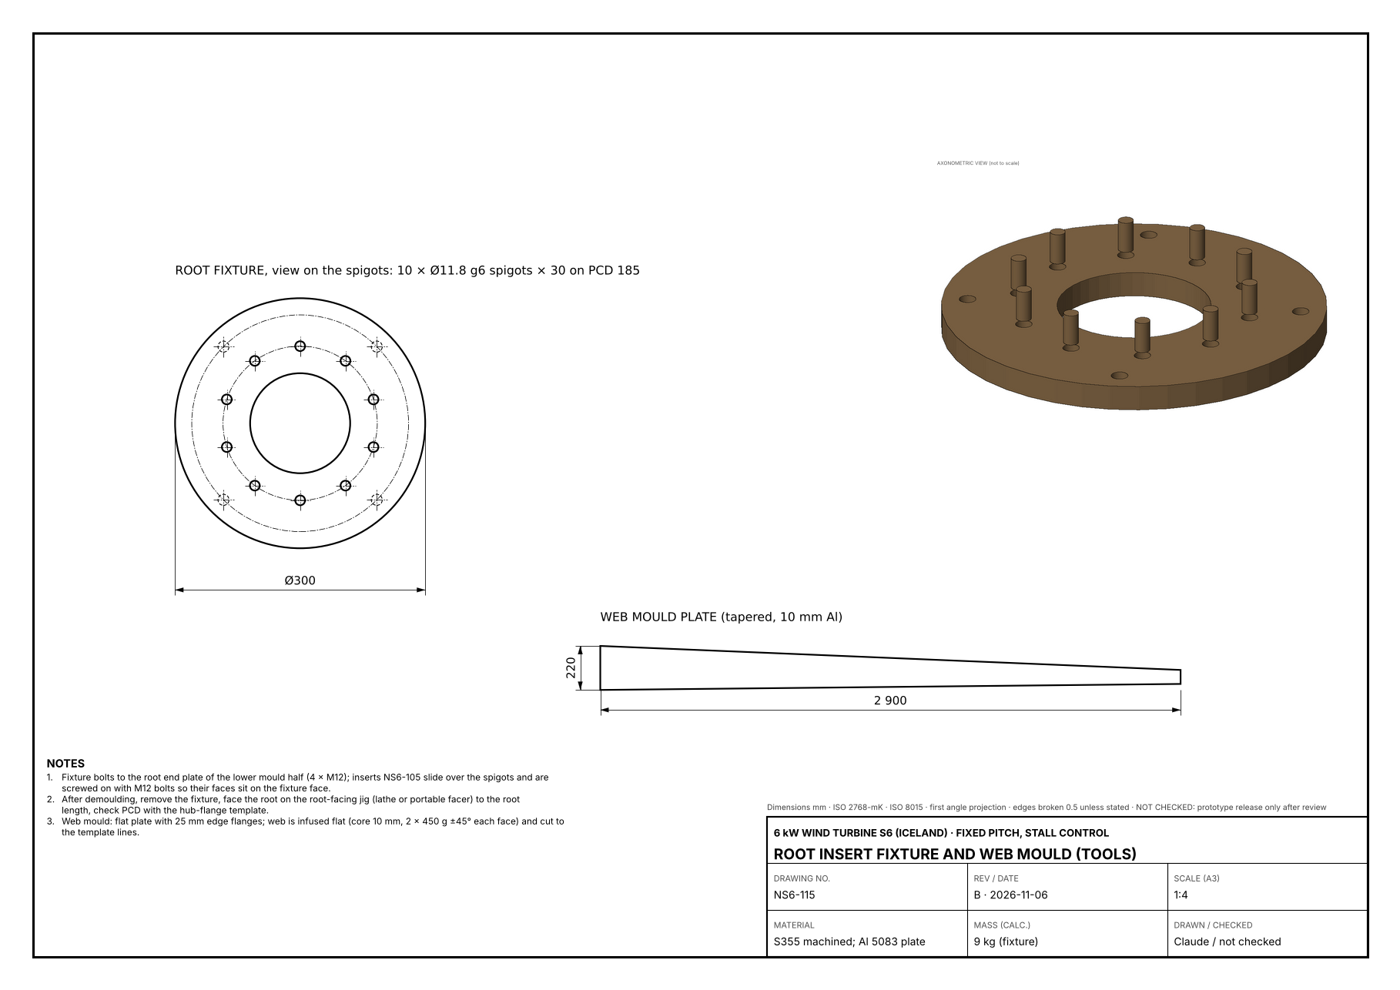
cad/turbine_6kw/out/png/NS6-115.png
