safarcikm/Wind-turbines/cad/turbine_6kw/out/png/NS6-130.png

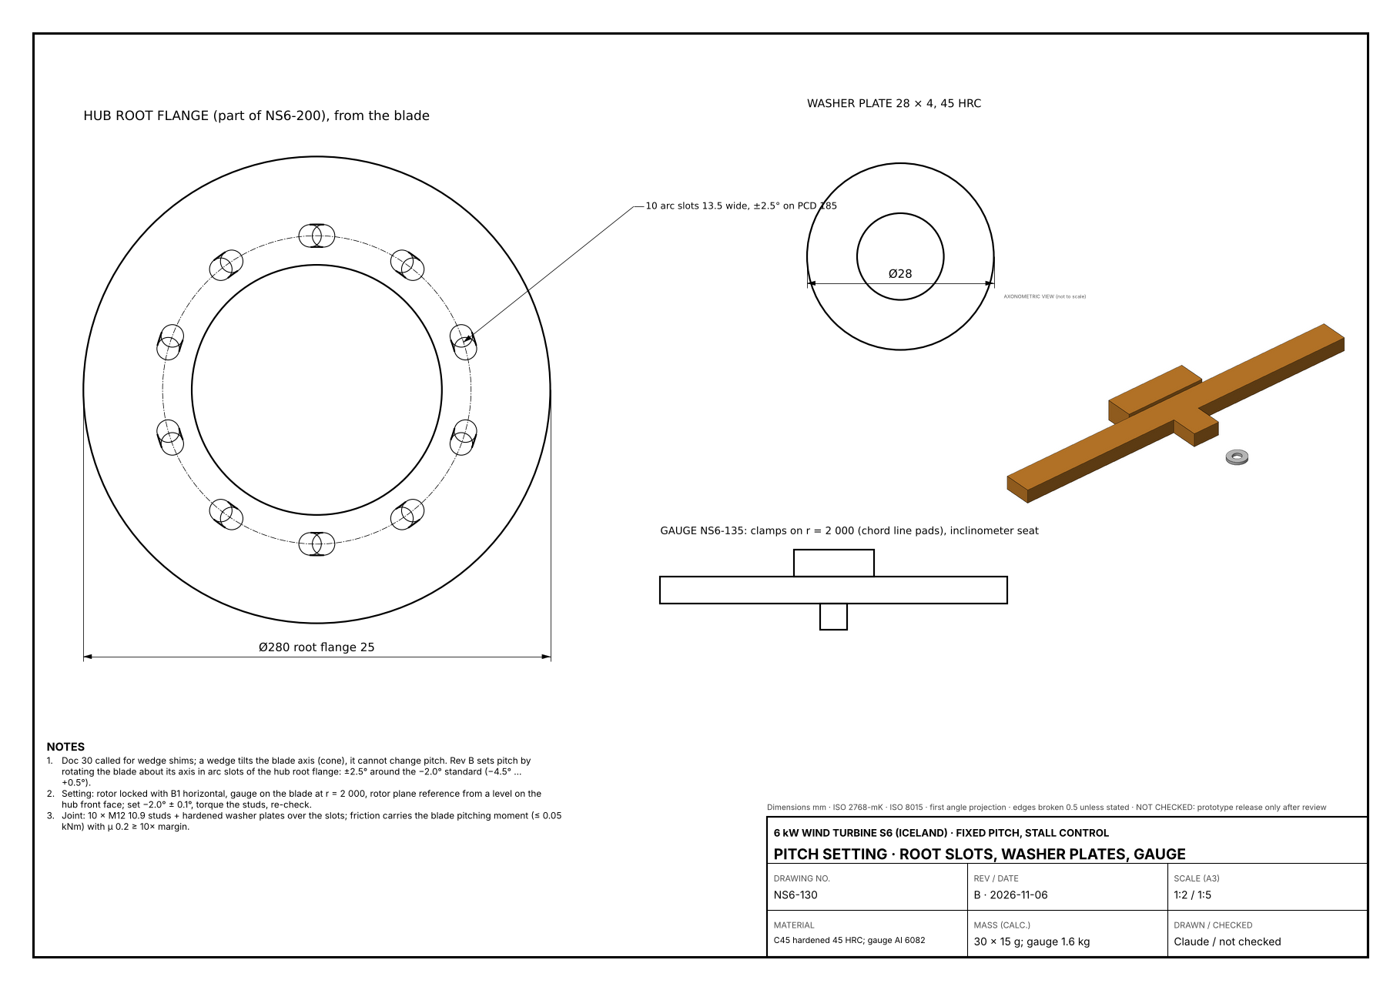
cad/turbine_6kw/out/png/NS6-130.png
