safarcikm/Wind-turbines/cad/turbine_6kw/out/png/NS6-400.png

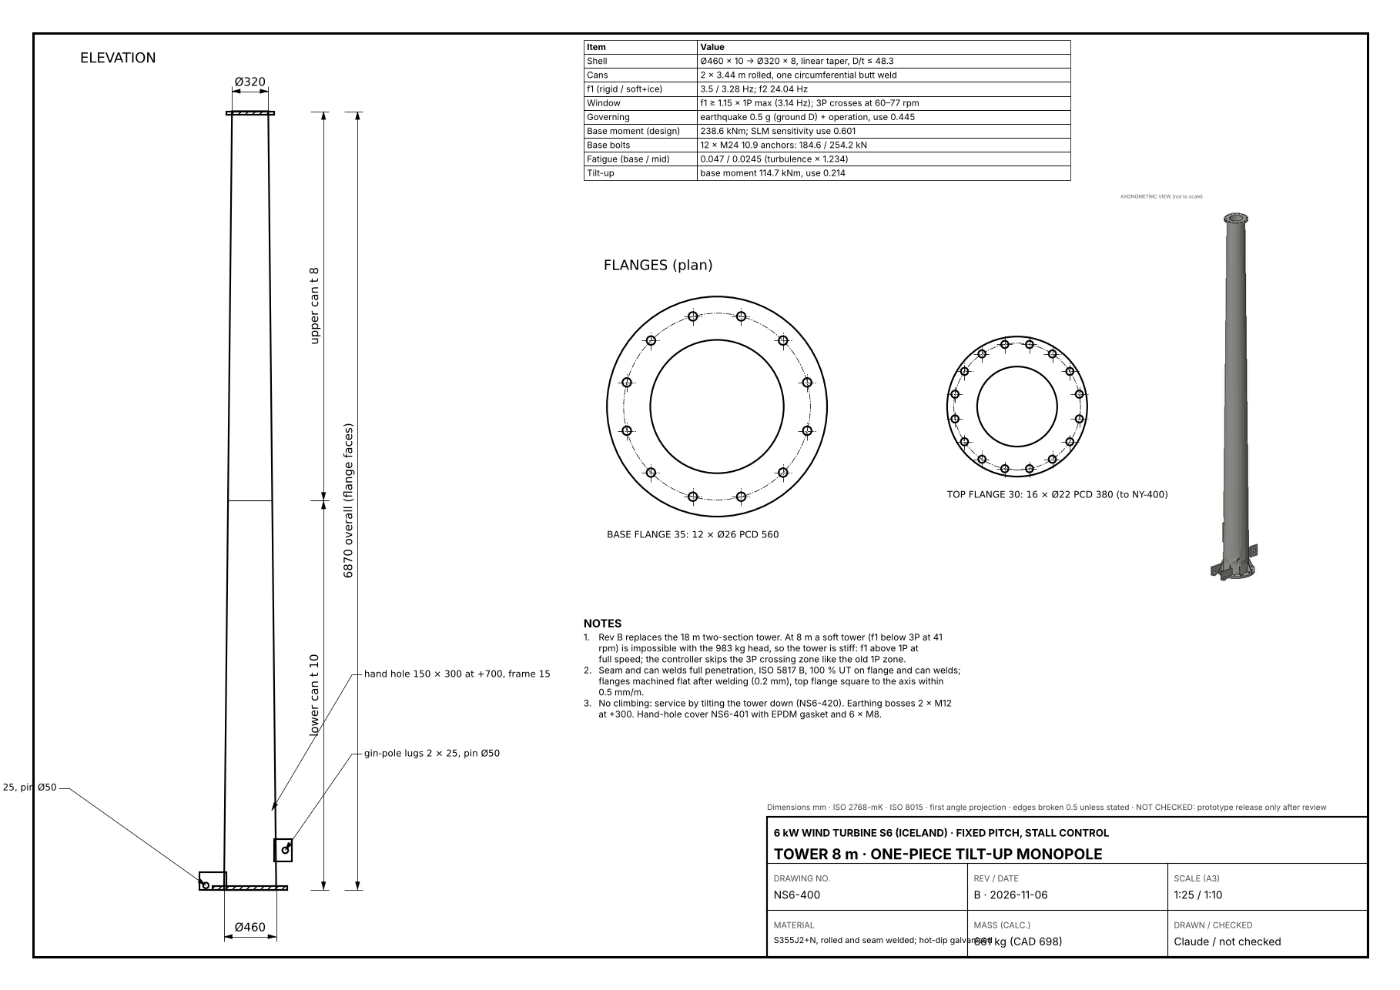
cad/turbine_6kw/out/png/NS6-400.png
