safarcikm/Wind-turbines/cad/turbine_6kw/out/png/NS6-620.png

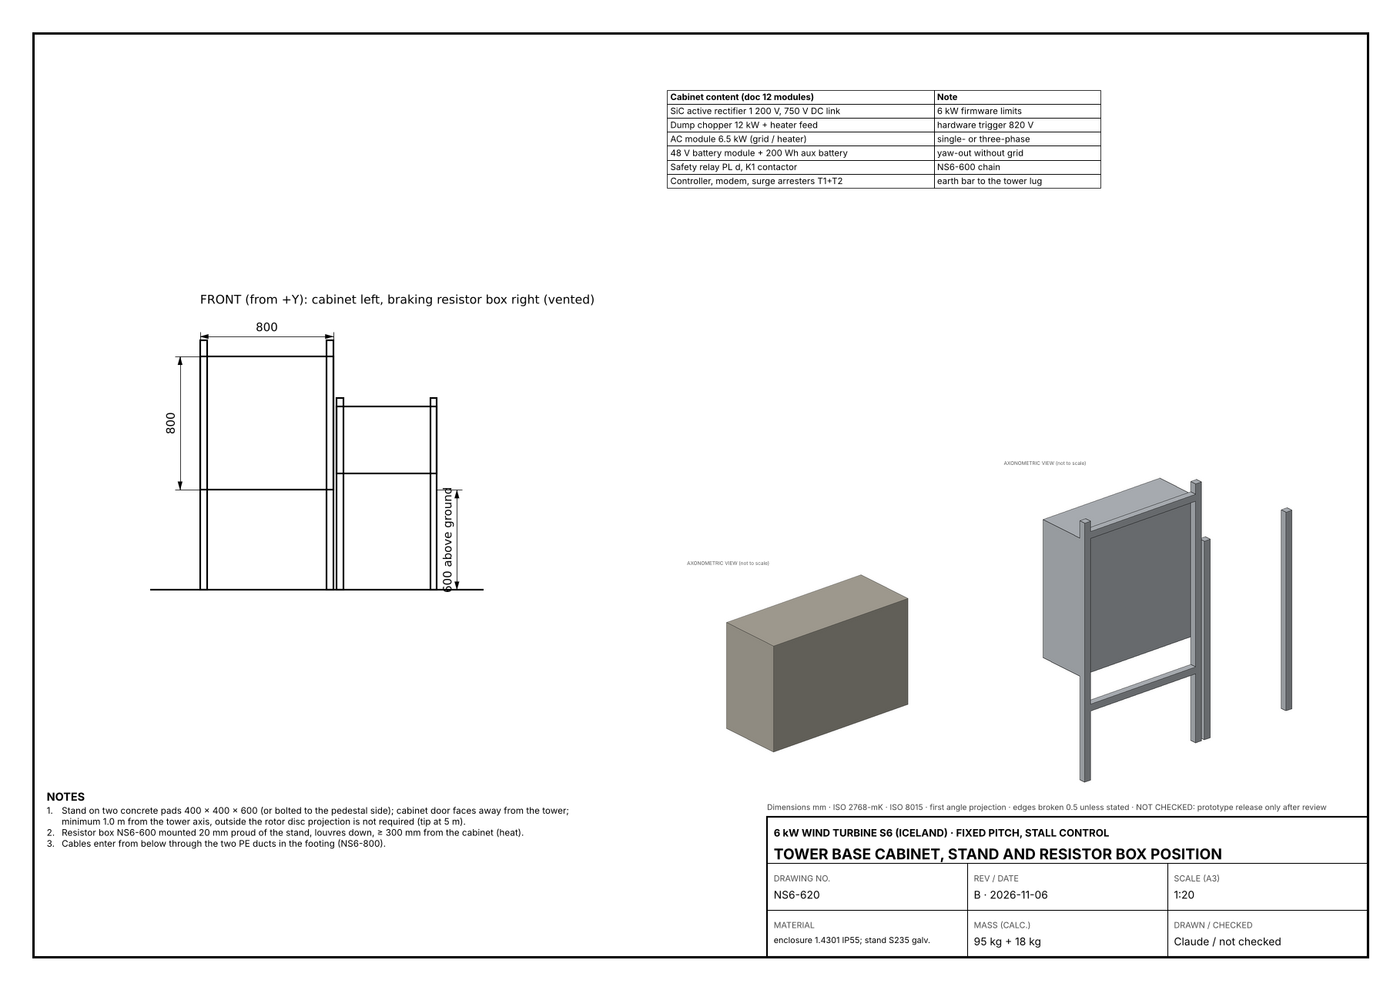
cad/turbine_6kw/out/png/NS6-620.png
