safarcikm/Wind-turbines/cad/turbine_6kw/out/png/NS6-710.png

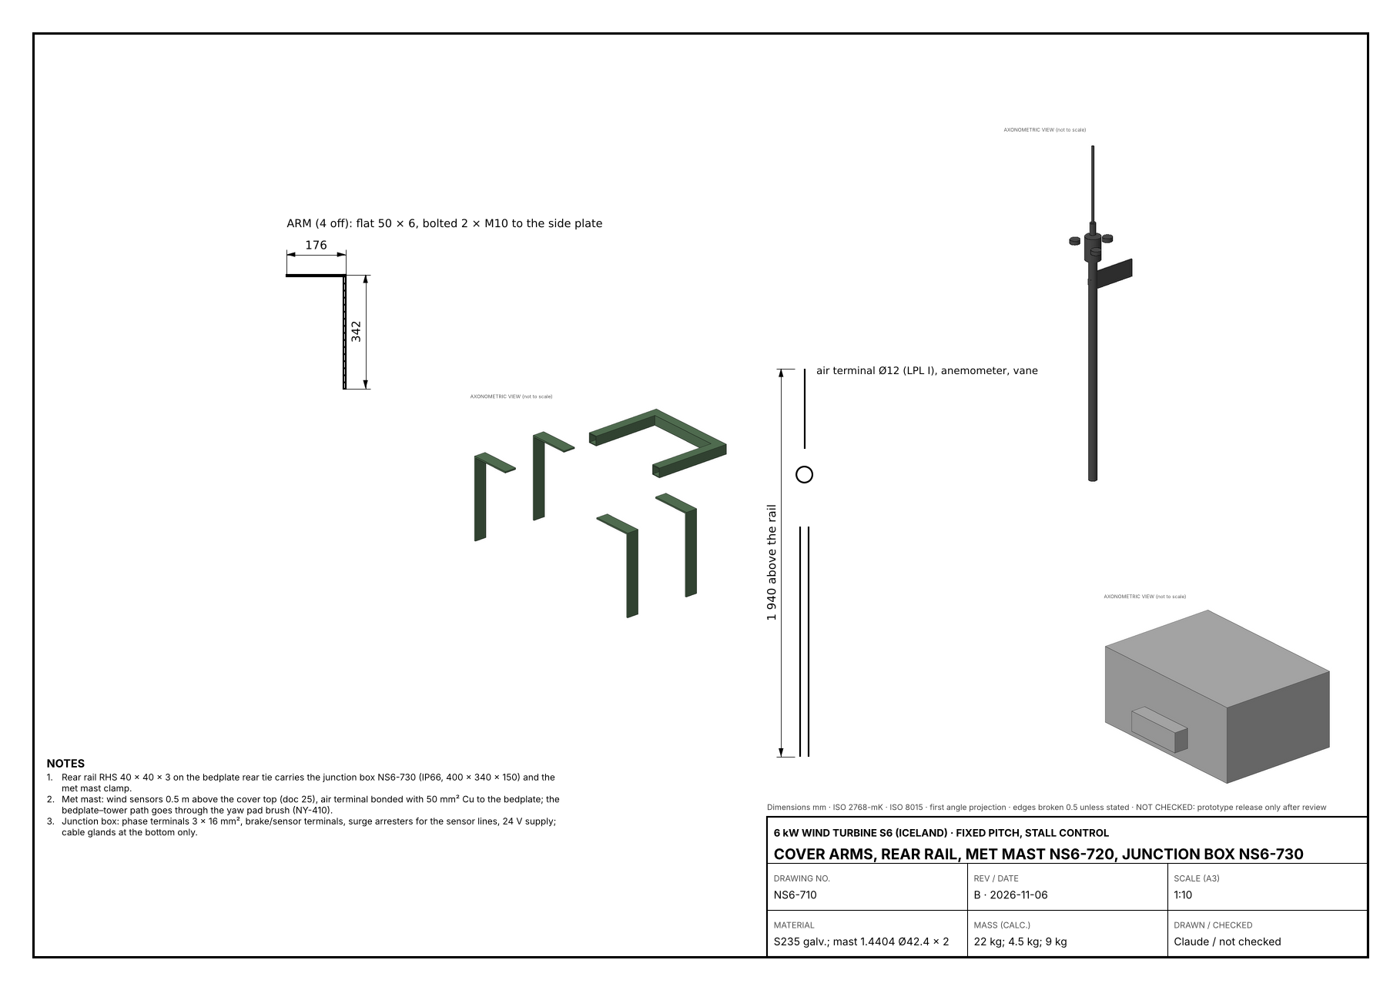
cad/turbine_6kw/out/png/NS6-710.png
