safarcikm/Wind-turbines/cad/turbine_6kw/out/png/NS6-910.png

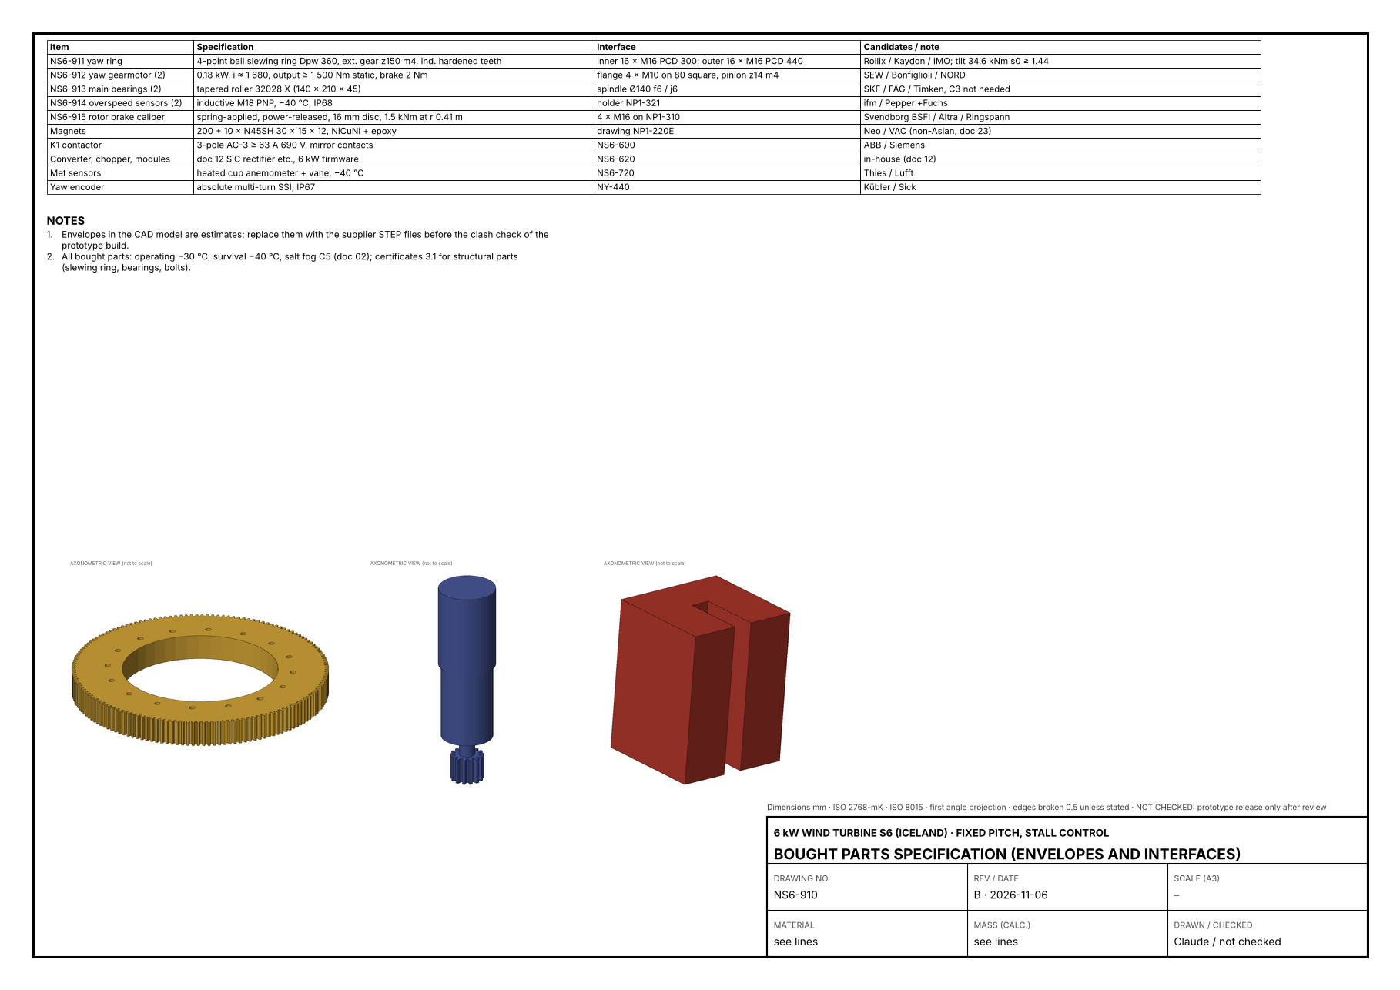
cad/turbine_6kw/out/png/NS6-910.png
