safarcikm/Wind-turbines/cad/nacelle_w/out/parts-list-w.md

# Working prototype W1: added parts (all 1:1)

28 objects added to the Rev B fit-check model; printed parts ≈ 22 kg PETG.

| File | Part | Moves | Make/buy | Size mm | Filament kg | Notes |
|---|---|---|---|---|---|---|
| `NW-500_hub` | Hub, printed twin of the EN-GJS-400-18U-LT casting (doc 13) | rotating | make | 771 x 681 x 437 | 9.04 | Ø470 x 760 overall: print in 4 pieces if the printer is smaller (split on the y-z and x-z planes, glue + M8 bolted ribs); walls 10 as the casting; necks printed r 130 to 165; interfaces = real hub: 12 x M16 PCD 400 + Ø361 recess to the drum; 16 x M16 PCD 300 per neck (pitch bearing outer ring); front opening Ø250 with 8 x M12 PCD 275 (cover or bench drive adapter) |
| `NW-430_yaw_bearing_inner_ring_twin` | Yaw bearing inner ring (to bedplate) – printed twin with ball groove | stationary | make | 350 x 350 x 60 | 1.27 | 53 real Ø19.05 G40 balls + printed spacers through the plug at +X; same bolt patterns as the slewing ring, swap 1:1 |
| `NW-430_yaw_bearing_outer_gear_ring_twin` | Yaw bearing outer ring, gear z150 m4 (to tower) – printed twin with ball groove | tower | make | 608 x 608 x 60 | 3.89 | 53 real Ø19.05 G40 balls + printed spacers through the plug at +X; same bolt patterns as the slewing ring, swap 1:1 |
| `NW-510-090_pitch_bearing_outer_ring` | Pitch bearing outer ring, blade at 90° (printed twin) | rotating | make | 358 x 355 x 81 | 0.77 | same envelope and bolt pattern as the doc 13 slewing ring (Ø355 x 50, Dpw 250): swap 1:1; 27 real steel balls Ø25.4 G40 + printed spacers through the filling plug |
| `NW-510-090_pitch_bearing_inner_ring` | Pitch bearing inner ring, internal gear z48 m3, blade at 90° | rotating | make | 249 x 245 x 71 | 0.50 | involute z48 m3, 0.3 mm backlash; 10 x M16 tapped PCD 200 for the blade root |
| `NW-511-090_ball_filling_plug` | Ball filling plug, blade at 90° | rotating | make | 52 x 26 x 26 | 0.01 | held by a Ø4 pin in the real ring; glue or pin in print |
| `pitch_drive_090_envelope` | Pitch drive: 48 V servo + 1:100 planetary + z14 m3 pinion (90°) | rotating | buy (envelope) | 293 x 96 x 80 | 0.44 | motor Ø80 x 130 with brake + encoder, gearbox Ø70 x 115, pinion face 30, centre distance 51 |
| `NW-520-090_pitch_drive_bracket` | Pitch drive bracket in the hub neck (90°) | rotating | make | 260 x 260 x 38 | 0.25 | 15 mm plate, slip fit in the Ø260 neck bore, 3 radial M8 into the neck; gearbox flange 4 x M6; the cast hub gets a machined pad at the same place: same bracket, steel |
| `pitch_encoder_090_envelope` | Absolute pitch encoder Ø58 with z16 m3 pinion (90°) | rotating | buy (envelope) | 109 x 65 x 58 | 0.07 | gear-driven from the ring gear, 1:3 ratio; multiturn SSI or CANopen |
| `NW-530-090_blade_root_stub` | Blade root stub Ø220 x 250 (90°) | rotating | make | 268 x 241 x 220 | 1.16 | W1: printed stub to carry test masses and the pitch marks; real blade root (doc 10) bolts to the same 10 x M16 |
| `NW-510-210_pitch_bearing_outer_ring` | Pitch bearing outer ring, blade at 210° (printed twin) | rotating | make | 357 x 333 x 221 | 0.77 | same envelope and bolt pattern as the doc 13 slewing ring (Ø355 x 50, Dpw 250): swap 1:1; 27 real steel balls Ø25.4 G40 + printed spacers through the filling plug |
| `NW-510-210_pitch_bearing_inner_ring` | Pitch bearing inner ring, internal gear z48 m3, blade at 210° | rotating | make | 247 x 237 x 166 | 0.50 | involute z48 m3, 0.3 mm backlash; 10 x M16 tapped PCD 200 for the blade root |
| `NW-511-210_ball_filling_plug` | Ball filling plug, blade at 210° | rotating | make | 58 x 49 x 29 | 0.01 | held by a Ø4 pin in the real ring; glue or pin in print |
| `pitch_drive_210_envelope` | Pitch drive: 48 V servo + 1:100 planetary + z14 m3 pinion (210°) | rotating | buy (envelope) | 282 x 199 x 86 | 0.44 | motor Ø80 x 130 with brake + encoder, gearbox Ø70 x 115, pinion face 30, centre distance 51 |
| `NW-520-210_pitch_drive_bracket` | Pitch drive bracket in the hub neck (210°) | rotating | make | 260 x 233 x 143 | 0.25 | 15 mm plate, slip fit in the Ø260 neck bore, 3 radial M8 into the neck; gearbox flange 4 x M6; the cast hub gets a machined pad at the same place: same bracket, steel |
| `pitch_encoder_210_envelope` | Absolute pitch encoder Ø58 with z16 m3 pinion (210°) | rotating | buy (envelope) | 119 x 101 x 61 | 0.07 | gear-driven from the ring gear, 1:3 ratio; multiturn SSI or CANopen |
| `NW-530-210_blade_root_stub` | Blade root stub Ø220 x 250 (210°) | rotating | make | 327 x 315 x 231 | 1.16 | W1: printed stub to carry test masses and the pitch marks; real blade root (doc 10) bolts to the same 10 x M16 |
| `NW-510-330_pitch_bearing_outer_ring` | Pitch bearing outer ring, blade at 330° (printed twin) | rotating | make | 357 x 333 x 221 | 0.77 | same envelope and bolt pattern as the doc 13 slewing ring (Ø355 x 50, Dpw 250): swap 1:1; 27 real steel balls Ø25.4 G40 + printed spacers through the filling plug |
| `NW-510-330_pitch_bearing_inner_ring` | Pitch bearing inner ring, internal gear z48 m3, blade at 330° | rotating | make | 247 x 237 x 166 | 0.50 | involute z48 m3, 0.3 mm backlash; 10 x M16 tapped PCD 200 for the blade root |
| `NW-511-330_ball_filling_plug` | Ball filling plug, blade at 330° | rotating | make | 58 x 49 x 29 | 0.01 | held by a Ø4 pin in the real ring; glue or pin in print |
| `pitch_drive_330_envelope` | Pitch drive: 48 V servo + 1:100 planetary + z14 m3 pinion (330°) | rotating | buy (envelope) | 282 x 199 x 86 | 0.44 | motor Ø80 x 130 with brake + encoder, gearbox Ø70 x 115, pinion face 30, centre distance 51 |
| `NW-520-330_pitch_drive_bracket` | Pitch drive bracket in the hub neck (330°) | rotating | make | 260 x 233 x 143 | 0.25 | 15 mm plate, slip fit in the Ø260 neck bore, 3 radial M8 into the neck; gearbox flange 4 x M6; the cast hub gets a machined pad at the same place: same bracket, steel |
| `pitch_encoder_330_envelope` | Absolute pitch encoder Ø58 with z16 m3 pinion (330°) | rotating | buy (envelope) | 119 x 101 x 61 | 0.07 | gear-driven from the ring gear, 1:3 ratio; multiturn SSI or CANopen |
| `NW-530-330_blade_root_stub` | Blade root stub Ø220 x 250 (330°) | rotating | make | 327 x 315 x 231 | 1.16 | W1: printed stub to carry test masses and the pitch marks; real blade root (doc 10) bolts to the same 10 x M16 |
| `hub_electronics_030_envelope` | Pitch controller + supercapacitor module box (30°) | rotating | buy (envelope) | 171 x 152 x 121 | 0.51 | 160 x 120 x 70: 48 V servo drive with STO + 21 x 350 F supercaps (56.7 V), heater pad |
| `hub_electronics_150_envelope` | Pitch controller + supercapacitor module box (150°) | rotating | buy (envelope) | 171 x 152 x 121 | 0.51 | 160 x 120 x 70: 48 V servo drive with STO + 21 x 350 F supercaps (56.7 V), heater pad |
| `hub_electronics_270_envelope` | Pitch controller + supercapacitor module box (270°) | rotating | buy (envelope) | 165 x 120 x 84 | 0.51 | 160 x 120 x 70: 48 V servo drive with STO + 21 x 350 F supercaps (56.7 V), heater pad |
| `slip_ring_encoder_envelope` | Slip ring with integrated rotor encoder (envelope) | stationary | buy (envelope) | 126 x 110 x 100 | 0.35 | stator held in the spindle nose cap, rotor driven by a torque fork from the hub front cover; 48 V 2 x 30 A, CAN FD, 2-channel safety chain, Ethernet; encoder ≥ 1024 ppr |
