safarcikm/Wind-turbines/cad/nacelle_w/bom_w.csv

item | system | part | qty | W1 (first working build) | later swap to | candidate products (confirm datasheets) | frozen interface | automotive option and verdict
1 | drivetrain | Main bearings 32028 X | 2 | REAL from day 1 (in printed spindle and drum) | same | SKF 32028 X/Q, Timken, Schaeffler FAG 32028-X, NSK | Ø140/Ø210 x 45 | truck wheel bearings use the same tapered-roller principle; 32028 X is already a standard catalogue bearing: no change
2 | drivetrain | KMT 27 locknut + lip seals 180x200x10 / 195x220x12 / 400x432x15 | 1 set | REAL | same | SKF KMT 27, SKF/Freudenberg HNBR seals -40 °C | shaft and bore sizes | -
3 | drivetrain | Spindle NP1-100 | 1 | printed | 42CrMo4 forging (P1) | - | doc 14 drawing Rev B | -
4 | drivetrain | Drum NP1-210 + seal covers + rear cover | 1 | printed | steel weldment (P1) | - | Rev B drawings | -
5 | drivetrain | Stator carrier + core + clamp ring | 1 | printed (dummy core) | steel carrier + bonded M270-35A stack + winding (P1) | laser-cut laminations | 12 x M12 PCD 240 to the flange | -
6 | drivetrain | Magnets | 160 | NONE (printed dummy ring; never put magnets in a printed drum) | N40UH segments (P1) | - | - | -
7 | brake | Brake disc NP1-230 Ø880 x 16 | 1 | STEEL from day 1 (laser-cut plate; 24 x M10 to the printed ring through steel washers) | same | C45E+N or S355J2+N plate | 24 x M10 PCD 678 + Ø652 spigot | -
8 | brake | Rotor brake caliper spring-applied hydraulically released ≥13.3 kN | 2 | REAL (low pressure on printed bracket; full torque only on steel bracket) | same | RINGSPANN HS/DS FHM family, Svendborg BSAB family, KTR-STOP, Coremo (pick by -40 °C pads and 16 mm disc) | caliper bolt pattern on NP1-310 plate | car hydraulic caliper is not spring-applied (not fail-safe): rejected; truck air disc brake + spring chamber is fail-safe but needs compressed air and a 45 mm disc: rejected
9 | brake | Brake pads | 2 sets + spares | from the caliper supplier | same | sintered metal pads, μ 0.35-0.45 stable to -40 °C and wet | caliper pad pocket | car pads do not fit industrial calipers: rejected
10 | brake | Hydraulic power unit with accumulator (rotor + yaw circuits) | 1 | REAL | same | compact HPU from Hydac, Bosch Rexroth or the caliper supplier; 2 normally-open dump valves, pressure transducers | G1/4 ports | -
11 | brake | NP1-310 caliper brackets | 2 | printed (function only) | S355 (before any torque test) | - | 4 x M16 to side plate + caliper pattern | -
12 | brake | Rotor lock pin Ø20 + holder NP1-321 + 'pin engaged' switch | 1 | REAL pin (steel) in printed holder | steel holder | M12 inductive switch | 2 x M12 on front plate top edge | -
13 | pitch | Pitch bearing Dpw 250 4-point (internal gear z48 m3) | 3 | printed twin NW-510 with 27 real Ø25.4 balls | custom slewing ring (doc 13) | thyssenkrupp rothe erde, IMO, Kaydon/SKF, Liebherr, LYC | Ø355 x 50; 16 x M16 PCD 300; 10 x M16 PCD 200 | car/truck wheel hub units: moment capacity far below 26 kNm and they fret under small oscillations: rejected
14 | pitch | Pitch drive: 48 V PMSM servo 0.4 kW 2.1 Nm peak with holding brake + 1:100 low-backlash planetary + z14 m3 pinion | 3 | REAL | same | servo: Kollmorgen AKM2, Nanotec, JVL, Dunkermotoren BG 75 class (48 V); gearbox: Neugart, Apex, Wittenstein 1:100 | gearbox flange on NW-520 + pinion on ring gear | electric power steering motor+worm: no torque/life margin and closed CAN protocol: rejected
15 | pitch | Pitch servo controller with STO + CANopen | 3 | REAL | same | Ingenia, Elmo, Nanotec, Kollmorgen AKD-N class 48 V drives | CANopen DS402 + STO | -
16 | pitch | Supercapacitor module 21 x 350 F (56.7 V) with balancing + heater | 3 | REAL | same | Maxwell/UCAP BCAP0350 or Eaton HB 350 F cells | 48 V bus | -
17 | pitch | Absolute pitch encoder (gear-driven z16) + limit switches -2°/91° + end stops | 3 | REAL | same | Kübler Sendix, Baumer, Hengstler multiturn CANopen/SSI; limit switches Schmersal/Euchner | Ø58 encoder on NW-520 | -
18 | hub | Hub NW-500 | 1 | printed twin | EN-GJS-400-18U-LT casting | - | 12 x M16 PCD 400 + Ø361 recess; necks 16 x M16 PCD 300 | -
19 | hub | Slip ring with integrated encoder at the spindle nose | 1 | REAL | same | Moog, Senring, Jinpat, Stemmann (48 V 2 x 30 A, CAN FD, 2 safety rings, Ethernet, encoder ≥1024 ppr) | nose cap Ø120 | -
20 | yaw | Yaw slewing ring Dpw 360 external gear z150 m4 | 1 | printed twin NW-430 with 53 real Ø19.05 balls (order the real ring now: 10-16 weeks) | real slewing ring | thyssenkrupp rothe erde, IMO, Kaydon, SKF | 16 x M16 PCD 300 / PCD 440 | solar-tracker worm slew drives were rejected in doc 13 (self-locking overloads the gears in gusts)
21 | yaw | Yaw gearmotor 0.18 kW 1:1680 + inverter with torque limit | 2 | REAL | same | Bonfiglioli, Brevini, Comer, NORD planetary gearmotors; small VFD or servo drive | gearbox flange on NP1-420 + z14 m4 pinion | wiper motor + extra reduction: wrong speed and duty: rejected
22 | yaw | Yaw brake caliper (8 kNm slip total) | 2 | REAL hydraulic (doc 13) OR test candidate EPB | decide after W1 test | hydraulic: as item 8 supplier; option: car electric parking brake caliper (motor-on-caliper, up to ~20 kN clamp, holds without power) | bracket under bedplate corners | EPB: WORTH TESTING for yaw (holds unpowered | no hydraulics on the yaw) but needs a 10-12 mm brake ring and slip/clamp characterisation
23 | yaw | Yaw encoder + cam limit switch (cable twist ±3 turns) | 1 | REAL | same | gear limit switch (Stromag, Ter) + multiturn encoder | pinion z14 m4 on gear ring | -
24 | sensors | Overspeed: 2 x M18 inductive on the disc lock holes + safe speed monitor | 1 set | REAL | same | ifm / Pepperl+Fuchs / Balluff M18 PNP; Pilz PNOZ s30 speed monitor | M18 seats in NP1-321 | optional 3rd diverse channel: automotive active wheel-speed (Hall) sensor on the same holes: ACCEPTED as cheap diverse channel
25 | sensors | Wind: heated ultrasonic anemometer | 1 | REAL | same | FT Technologies FT742, Gill WindSonic M, Thies Ultrasonic | mast on cover | -
26 | sensors | Vibration: 2-axis accelerometer + pendulum vibration switch | 1 + 1 | REAL | same | ifm VSA/VSE, PCB/IEPE; pendulum switch to safety chain | bedplate rear plate | -
27 | sensors | Temperatures (PT100) + brake pressure transducers + pad wear switches + ambient T/RH | set | REAL | same | PT100 class A, 0-250 bar transducers | - | -
28 | control | Turbine controller (control system) | 1 | REAL industrial PLC | same or own board after P2 | Beckhoff CX + EtherCAT I/O (recommended for W1/P1), Bachmann M1 (wind standard) | CANopen to pitch + EtherCAT I/O | automotive MCU board (AURIX) is a later cost option: not for W1
29 | control | Protection system (hardwired PL d cat 3) | 1 | REAL | same | Pilz PNOZ s30 + PNOZsigma/ PNOZmulti; e-stops; watchdog relay | 2-channel chain through the slip ring | -
30 | power | Generator emulation (power hardware-in-the-loop) | 1 | bench servo/regenerative drive commanded by the controller's torque setpoint | P1 generator + doc 12 SiC converter | 1.5-3 kW servo + 1:10 planetary on the hub front adapter NW-610 | torque setpoint interface (CAN) | EV traction inverter as active rectifier: 400 V class or locked firmware: rejected
31 | power | 48 V DC supply + LiFePO4 buffer + 24 V control supply | 1 | REAL | same | industrial 48 V PSU, heated 48 V LiFePO4 | - | 48 V mild-hybrid packs: not heated / no BMS access: rejected
32 | power | Dump load 20 kW + chopper | 1 | small resistor (W1 power is low) | 20 kW bank (doc 12) | - | DC link | -
33 | cooling | Generator cooling blowers 48 V | 2 | REAL (or automotive HVAC blower for W1 only) | industrial 48 V EC blower | ebm-papst 48 VDC radial blowers | manifold at the spindle rear | automotive HVAC blower: OK as W1 stand-in (cheap) but life too short for production
34 | wiring | Connectors and harness | set | REAL | same | M12/M8 industrial for sensors; Deutsch DT/DTM or TE Superseal for harness splices | - | automotive sealed connectors: ACCEPTED (IP67/69K | -40 °C | cheap)
35 | cover | Nacelle cover + spinner | 1 | printed ASA panels on an aluminium frame (W1) | vacuum-infused GFRP (production); SMC at volume | - | bolting rail on bedplate | car body panel reuse: rejected; automotive processes (SMC/RTM) and parts (EPDM seals | quarter-turn fasteners | gas struts | cabin-filter vents): ACCEPTED
