safarcikm/Wind-turbines/cad/nacelle_fitcheck/out/parts-list.csv

file | name | group | make_buy | source | size_mm | volume_cm3 | filament_kg_est | print_mods | notes
NP1-100_spindle | Spindle | stationary | make | NP1-100 / BOM 1 | 451 x 401 x 400 | 7202.6 | 2.74 | M135x2 thread printed as a plain Ø135 seat (use the locknut envelope); tapped holes printed at tap-drill size (M12 Ø10.2, M20 Ø17.5)
NP1-101_front_spacer | Front spacer / seal counterface Ø180 (Rev B) | stationary | make | NP1-101 / BOM 2 | 181 x 180 x 33 | 174.4 | 0.07 | bore +0.2 mm radial (slides on the printed spindle)
NP1-102_rear_seal_sleeve | Rear seal sleeve Ø195 on the Ø155 shoulder (Rev B) | stationary | make | NP1-102 / BOM 2a | 196 x 195 x 32 | 168.9 | 0.06 | bore +0.2 mm radial | the rear lip seal 195 x 220 x 12 runs on its OD; fit before the rear cone
NP1-110_cooling_insert | Spindle cooling insert (finned) | stationary | make | NP1-110 / BOM 5 | 426 x 126 x 90 | 929.6 | 0.35 | OD -0.2 mm radial (shrink fit in steel, slide fit in print)
KMT27_locknut_envelope | Precision locknut KMT 27 (envelope) | stationary | buy (envelope) | BOM 4 (bought) | 176 x 174 x 43 | 262.6 | 0.1 | plain bore, no thread
32028X_front_cone_envelope | Front bearing cone + rollers (envelope) | stationary | buy (envelope) | BOM 3 (bought) | 191 x 191 x 61 | 524.9 | 0.2 | bore +0.2 mm radial | envelope estimated for 32028 X: replace with the supplier drawing before trusting the carrier-bore check
32028X_rear_cone_envelope | Rear bearing cone + rollers (envelope) | stationary | buy (envelope) | BOM 3 (bought) | 191 x 191 x 61 | 524.9 | 0.2 | bore +0.2 mm radial | envelope estimated for 32028 X: replace with the supplier drawing before trusting the carrier-bore check
32028X_front_cup_envelope | Front bearing cup (envelope) | rotating | buy (envelope) | BOM 3 (bought) | 212 x 210 x 52 | 229.1 | 0.09 | OD -0.2 mm radial (P7 press fit in steel) | raceway estimated: replace with the supplier drawing
32028X_rear_cup_envelope | Rear bearing cup (envelope) | rotating | buy (envelope) | BOM 3 (bought) | 212 x 210 x 52 | 229.1 | 0.09 | OD -0.2 mm radial (P7 press fit in steel) | raceway estimated: replace with the supplier drawing
NP1-200_stator_carrier | Stator carrier | stationary | make | NP1-200 / BOM 7 | 456 x 456 x 135 | 5077.1 | 1.93 | M8 clamp-ring holes at tap-drill size Ø6.8
NP1-201_stator_core | Stator core (bonded lamination stack, 45 slots) | stationary | make | NP1-201 / BOM 8 | 602 x 598 x 126 | 6436.5 | 2.45 | bore +0.2 mm radial (shrink fit in steel); printed as one solid stack 74 mm
stator_key_090 | Stator key 10x8x70 at 90 deg (Rev B BOM) | stationary | buy (envelope) | BOM 10 | 70 x 14 x 10 | 5.4 | 0.0 | 0.1 mm smaller each side; 70 mm long in the 73.5 mm seat (BOM line 10, Rev B)
stator_key_210 | Stator key 10x8x70 at 210 deg (Rev B BOM) | stationary | buy (envelope) | BOM 10 | 71 x 18 x 12 | 5.4 | 0.0 | 0.1 mm smaller each side; 70 mm long in the 73.5 mm seat (BOM line 10, Rev B)
stator_key_330 | Stator key 10x8x70 at 330 deg (Rev B BOM) | stationary | buy (envelope) | BOM 10 | 71 x 18 x 12 | 5.4 | 0.0 | 0.1 mm smaller each side; 70 mm long in the 73.5 mm seat (BOM line 10, Rev B)
NP1-202_stator_clamp_ring | Stator front clamp ring | stationary | make | NP1-202 / BOM 9 | 458 x 457 x 48 | 276.2 | 0.11
stator_end_winding_front_envelope | End windings, front (envelope) | stationary | make | doc 14 4.4 (22 mm overhang estimate) | 584 x 582 x 72 | 1810.8 | 0.69 |  | space claim of the potted tooth-coil end turns
stator_end_winding_rear_envelope | End windings, rear (envelope) | stationary | make | doc 14 4.4 (22 mm overhang estimate) | 584 x 582 x 72 | 1810.8 | 0.69 |  | space claim of the potted tooth-coil end turns
NP1-210_rotor_drum | Rotor drum weldment | rotating | make | NP1-210 / BOM 15 | 710 x 709 x 413 | 12466.1 | 4.75 | cup seats Ø210 printed at nominal; the cup envelopes are reduced instead; tapped holes at tap-drill size
NP1-211_front_seal_cover | Front bearing seal cover | rotating | make | NP1-211 / BOM 16 | 240 x 240 x 31 | 189.4 | 0.07
NP1-211_rear_seal_cover | Rear bearing seal cover, bore Ø198 (Rev B) | rotating | make | NP1-211 / BOM 16 | 240 x 240 x 33 | 173.4 | 0.07 |  | bolted to the drum before the drum goes on; lip seal 195 x 220 x 12 runs on NP1-102
NP1-212_drum_rear_cover | Drum rear cover with Ø400 seal carrier | rotating | make | NP1-212 / BOM 19 | 690 x 688 x 76 | 2676.7 | 1.02
NP1-220_magnet_ring | Magnet layer, 40 poles (dummy, no magnets) | rotating | make | NP1-220 / BOM 22 | 622 x 619 x 128 | 919.0 | 0.35 | one ring instead of 160 segments; pole gaps as grooves; do not put real magnets in a printed drum
NP1-230_brake_disc | Brake disc Ø880/Ø652 with 12 lock holes (Rev B) | rotating | make | NP1-230 / BOM 25 | 880 x 878 x 93 | 4279.9 | 1.63 |  | W prototype: cut this one from steel plate from the start (a printed disc cannot be braked)
NP1-320_lock_pin | Rotor lock pin Ø20 (engaged, top) | stationary | make | NP1-320 / BOM 30 | 172 x 40 x 30 | 59.4 | 0.02 | Ø20 -0.2 mm radial | PCD 740, through the 16 mm disc from behind; stroke 40 to release
NP1-321_lock_pin_holder | Lock pin holder with 2 overspeed sensor seats | stationary | make | NP1-321 (new, doc 17) | 260 x 166 x 94 | 3118.3 | 1.19 |  | 2 x M12 down into the front plate top edge; M18 inductive sensors at ±15° of the pin read the 12 lock holes (24 pulses/rev with both, quadrature)
overspeed_sensor_075_envelope | Inductive sensor M18 x 70 at 75 deg (envelope) | stationary | buy (envelope) | doc 17 §5 (bought) | 71 x 24 x 18 | 17.8 | 0.01 |  | sensing face 3 mm behind the disc rear face
overspeed_sensor_105_envelope | Inductive sensor M18 x 70 at 105 deg (envelope) | stationary | buy (envelope) | doc 17 §5 (bought) | 71 x 24 x 18 | 17.8 | 0.01 |  | sensing face 3 mm behind the disc rear face
NP1-300-1_bedplate_front_plate | Bedplate front plate 40 with Ø410 pad (Rev B) | stationary | make | NP1-300 / BOM 28 | 737 x 500 x 104 | 14195.7 | 5.41 | Ø200 bore +0.2 mm radial | Rev B: pad face x 470 on the spindle flange; plate face x 480 gives the rear cover 5 mm running gap; 2 x M12 tapped in the top edge for the lock pin holder NP1-321
NP1-300-2_bedplate_bottom_plate | Bedplate bottom plate 40 (yaw flange) | stationary | make | NP1-300 / BOM 28 | 660 x 520 x 40 | 12044.6 | 4.59
NP1-300-3_bedplate_side_plate_left | Bedplate side plate 20 (left) | stationary | make | NP1-300 / BOM 28 | 734 x 604 x 20 | 6001.1 | 2.29
NP1-300-3_bedplate_side_plate_right | Bedplate side plate 20 (right) | stationary | make | NP1-300 / BOM 28 | 734 x 604 x 20 | 6001.1 | 2.29
NP1-300-4_bedplate_rear_plate | Bedplate rear plate 20 | stationary | make | NP1-300 / BOM 28 | 480 x 290 x 20 | 2784.0 | 1.06
yaw_bearing_inner_ring_envelope | Yaw bearing inner ring (to bedplate) | stationary | buy (envelope) | BOM 31 (bought) | 350 x 350 x 60 | 3397.4 | 1.29 |  | preliminary doc 13 dimensions; the slewing ring supplier drawing replaces this
yaw_bearing_outer_gear_ring_envelope | Yaw bearing outer ring, gear z150 m4 (to tower) | tower | buy (envelope) | BOM 31 (bought) | 608 x 608 x 60 | 10310.4 | 3.93 |  | preliminary doc 13 dimensions; the slewing ring supplier drawing replaces this; 16 holes on PCD 440 assumed
brake_caliper_left_envelope | Rotor brake caliper space claim (left) | stationary | buy (envelope) | BOM 26 (bought) | 192 x 155 x 130 | 2952.0 | 1.12 |  | generic envelope, r 370 to 500; replace with the chosen caliper's drawing; clamp ≥ 13.3 kN each for 8.7 kNm at μ 0.4 on r_eff 0.410 m
brake_caliper_right_envelope | Rotor brake caliper space claim (right) | stationary | buy (envelope) | BOM 26 (bought) | 192 x 155 x 130 | 2952.0 | 1.12 |  | generic envelope, r 370 to 500; replace with the chosen caliper's drawing; clamp ≥ 13.3 kN each for 8.7 kNm at μ 0.4 on r_eff 0.410 m
NP1-310_rotor_caliper_bracket_left | Rotor brake caliper bracket (left, Rev B) | stationary | make | NP1-310 / BOM 29 | 240 x 194 x 182 | 2300.1 | 0.88 |  | mounting plate 25 behind the caliper with 4 x M16 axial (pattern to match the chosen caliper); web 25 on the side plate outer face, 4 x M16; steel before any full-torque brake test
NP1-310_rotor_caliper_bracket_right | Rotor brake caliper bracket (right, Rev B) | stationary | make | NP1-310 / BOM 29 | 240 x 194 x 182 | 2300.1 | 0.88 |  | mounting plate 25 behind the caliper with 4 x M16 axial (pattern to match the chosen caliper); web 25 on the side plate outer face, 4 x M16; steel before any full-torque brake test
yaw_drive_left_envelope | Yaw gearmotor 0.18 kW 1:1680 with z14 m4 pinion (left) | stationary | buy (envelope) | BOM 32 (bought) | 400 x 110 x 110 | 2846.8 | 1.08 |  | envelope: gearbox Ø100 x 150, motor Ø110 x 160, pinion face 50; replace with supplier drawing; centre distance 328 = (600 + 56) / 2 to the z150 gear
NP1-420_yaw_drive_bracket_left | Yaw drive bracket (left) | stationary | make | NP1-420 (new, doc 16 section 7) | 180 x 170 x 140 | 979.5 | 0.37 |  | bolts to the side plate outer face with 4 x M16; gearbox flange on top, pinion below
yaw_drive_right_envelope | Yaw gearmotor 0.18 kW 1:1680 with z14 m4 pinion (right) | stationary | buy (envelope) | BOM 32 (bought) | 400 x 110 x 110 | 2846.8 | 1.08 |  | envelope: gearbox Ø100 x 150, motor Ø110 x 160, pinion face 50; replace with supplier drawing; centre distance 328 = (600 + 56) / 2 to the z150 gear
NP1-420_yaw_drive_bracket_right | Yaw drive bracket (right) | stationary | make | NP1-420 (new, doc 16 section 7) | 180 x 170 x 140 | 979.5 | 0.37 |  | bolts to the side plate outer face with 4 x M16; gearbox flange on top, pinion below
yaw_brake_caliper_left_envelope | Yaw brake caliper + bracket space claim (left) | stationary | buy (envelope) | BOM 33 (bought), bracket new | 211 x 211 x 150 | 2840.2 | 1.08 |  | spring-applied, hydraulically released; grips the adapter plate edge (track r 345 to 415) from outside; top face bolts under the bedplate bottom plate corner; envelope 150 x 150 x 150 incl. bracket, 3 mm running gap each side of the plate
yaw_brake_caliper_right_envelope | Yaw brake caliper + bracket space claim (right) | stationary | buy (envelope) | BOM 33 (bought), bracket new | 211 x 211 x 150 | 2840.2 | 1.08 |  | spring-applied, hydraulically released; grips the adapter plate edge (track r 345 to 415) from outside; top face bolts under the bedplate bottom plate corner; envelope 150 x 150 x 150 incl. bracket, 3 mm running gap each side of the plate
NP1-400_tower_top_adapter | Tower-top adapter with yaw brake track | tower | make | NP1-400 / BOM 34 (new design, doc 16 section 7) | 840 x 840 x 290 | 18204.5 | 6.94 |  | S355J2+N weldment: 25 mm plate Ø840 (yaw ring seat and brake track r 340 to 420), 12 mm cone Ø396 to Ø332, 30 mm tower flange, 8 gussets kept inside r 315 so the yaw calipers pass; 16 x M16 10.9 up into the yaw outer ring on PCD 440; 16 x M20 10.9 through bolts to the tower on PCD 380; access window 90 x 85 in the cone for the cable loop
tower_top_flange_stub | Tower top flange + 300 mm of the Ø320 x 8 tube (mounting point) | tower | make | doc 09 tower top, flange new (doc 16 section 7) | 420 x 420 x 330 | 4969.1 | 1.89 |  | tower mounting point: top face of this flange, 360 mm below the bedplate underside; flange to be added to the doc 09 tower drawings
NP1-600_dummy_hub | Bench dummy hub with Ø100 shaft | bench | make | NP1-600 / BOM 41 | 742 x 470 x 470 | 10338.7 | 3.94 |  | Ø361 recess at the hub face (drawing NP1-600 corrected in Rev B)
