safarcikm/Wind-turbines/cad/turbine_6kw/out/iso/parts/NP1-100.png

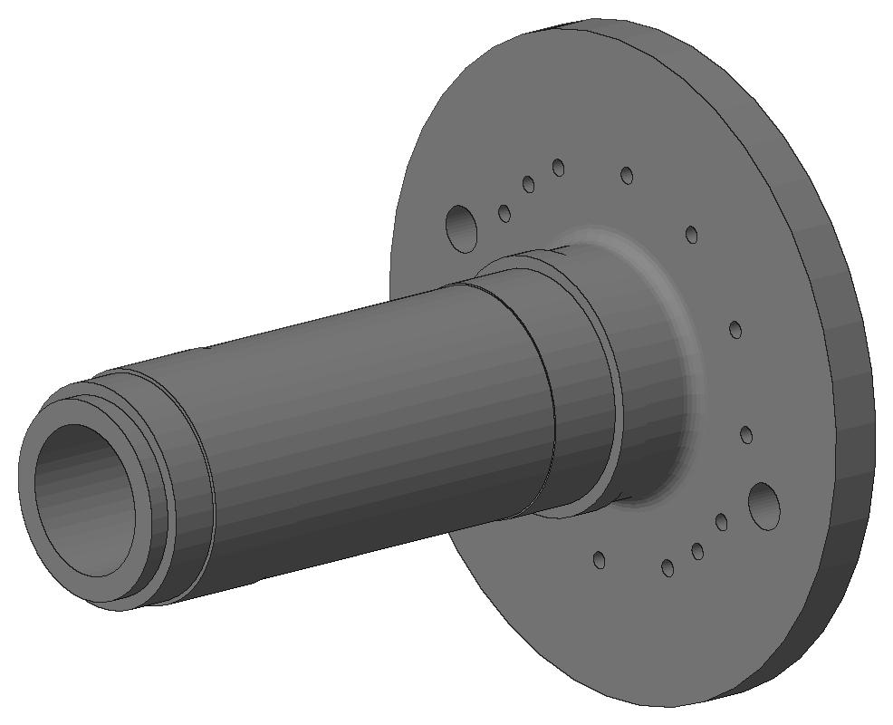
cad/turbine_6kw/out/iso/parts/NP1-100.png
