safarcikm/Wind-turbines/cad/turbine_6kw/out/iso/parts/NP1-203K.png

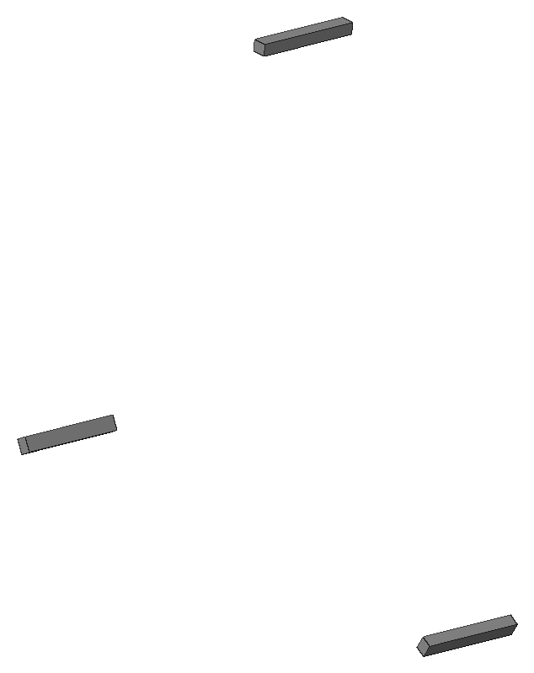
cad/turbine_6kw/out/iso/parts/NP1-203K.png
