safarcikm/Wind-turbines/cad/turbine_6kw/out/iso/parts/NP1-210C.png

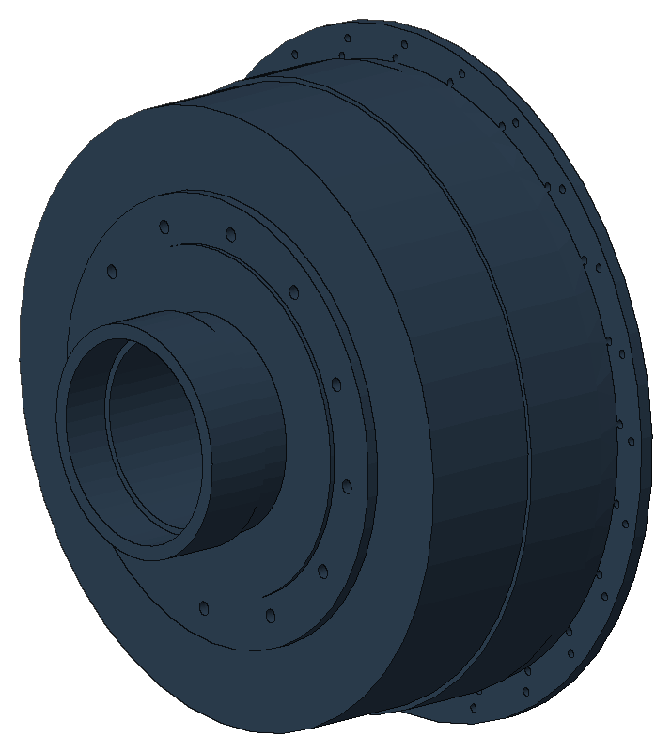
cad/turbine_6kw/out/iso/parts/NP1-210C.png
