safarcikm/Wind-turbines/cad/turbine_6kw/out/iso/parts/NP1-220E.png

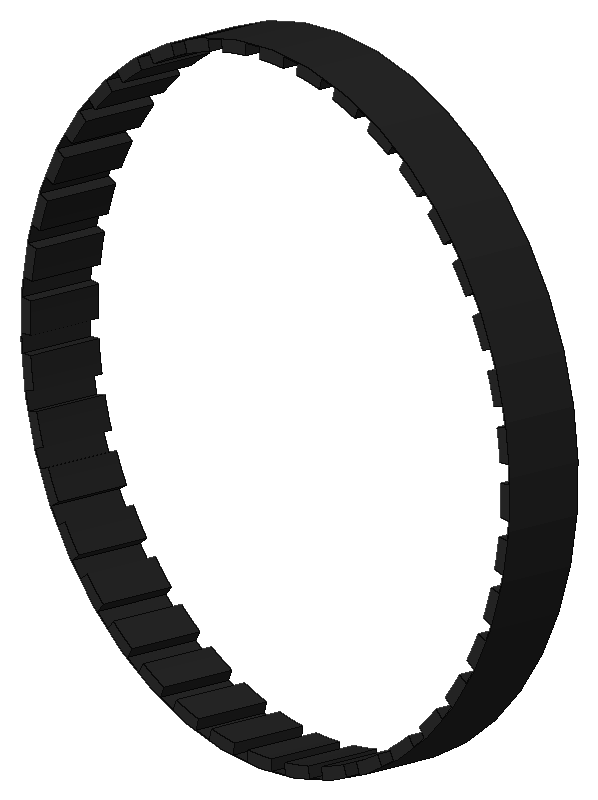
cad/turbine_6kw/out/iso/parts/NP1-220E.png
