safarcikm/Wind-turbines/cad/turbine_6kw/out/iso/parts/NP1-310.png

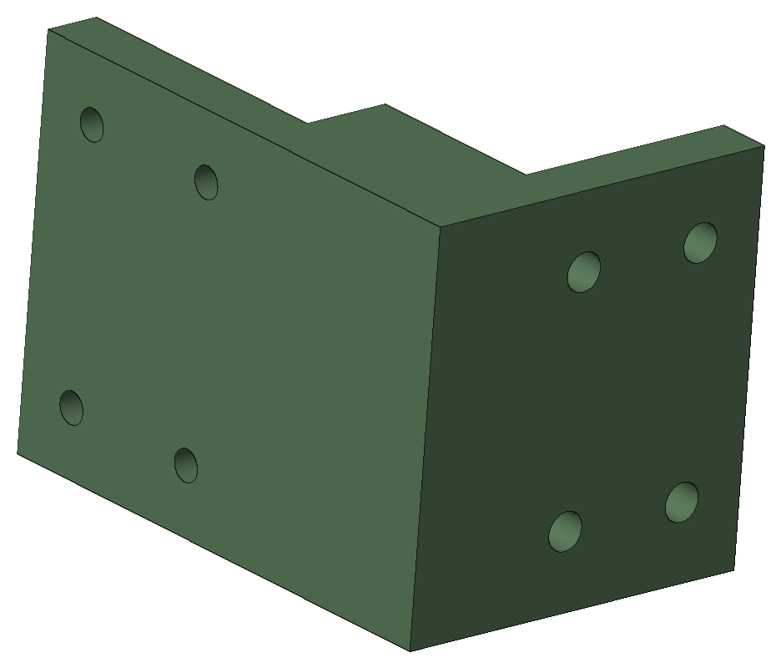
cad/turbine_6kw/out/iso/parts/NP1-310.png
