safarcikm/Wind-turbines/cad/turbine_6kw/out/iso/parts/NP1-320.png

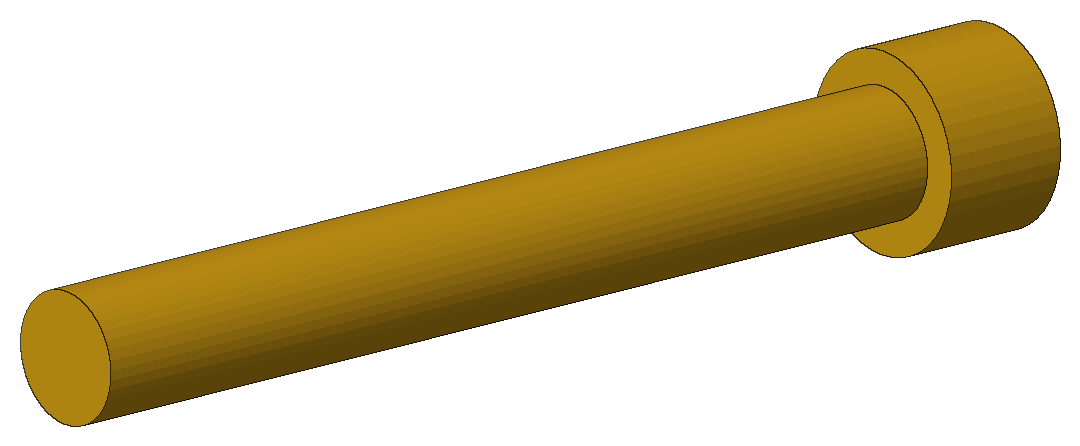
cad/turbine_6kw/out/iso/parts/NP1-320.png
