safarcikm/Wind-turbines/cad/turbine_6kw/out/iso/parts/NP1-321.png

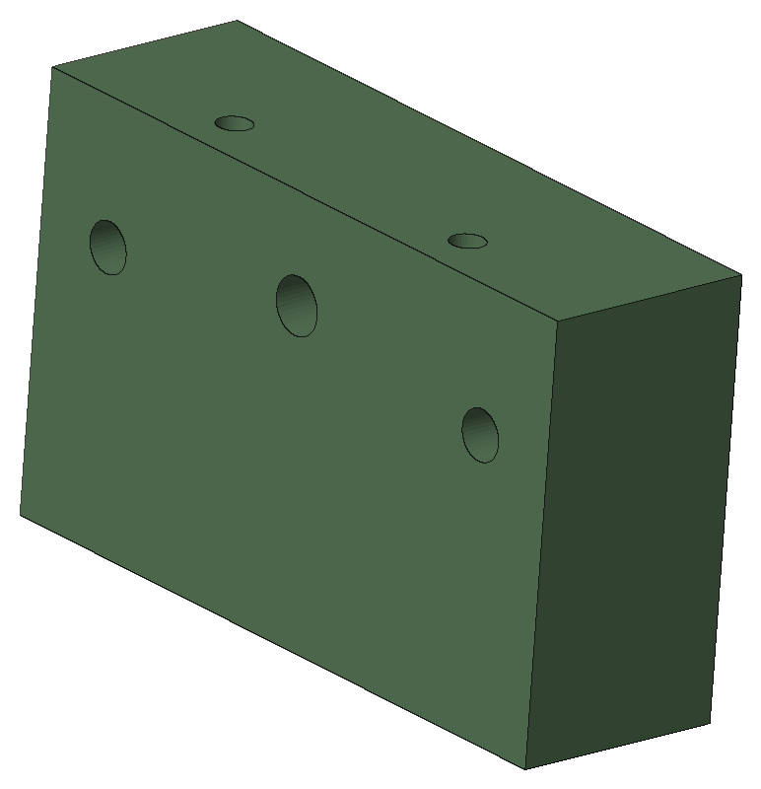
cad/turbine_6kw/out/iso/parts/NP1-321.png
