safarcikm/Wind-turbines/cad/turbine_6kw/out/iso/parts/NP1-420-R.png

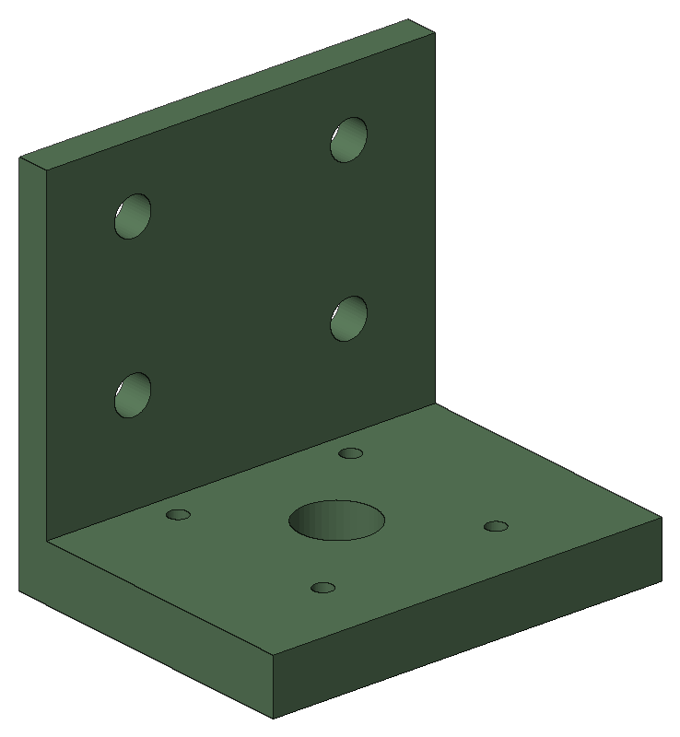
cad/turbine_6kw/out/iso/parts/NP1-420-R.png
