safarcikm/Wind-turbines/cad/turbine_6kw/out/iso/parts/NS6-100-2.png

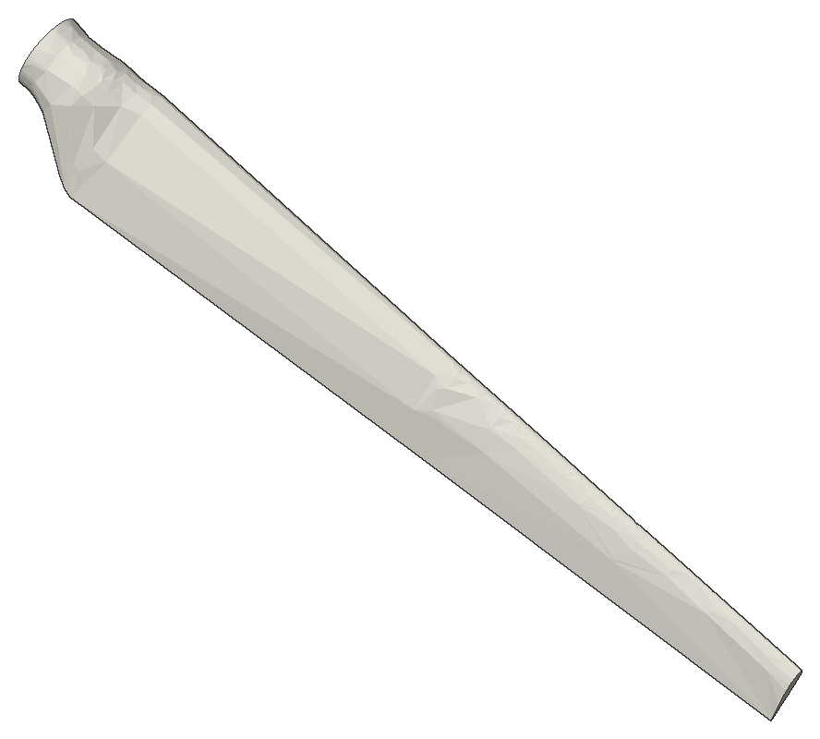
cad/turbine_6kw/out/iso/parts/NS6-100-2.png
