safarcikm/Wind-turbines/cad/turbine_6kw/out/iso/parts/NS6-110-3.png

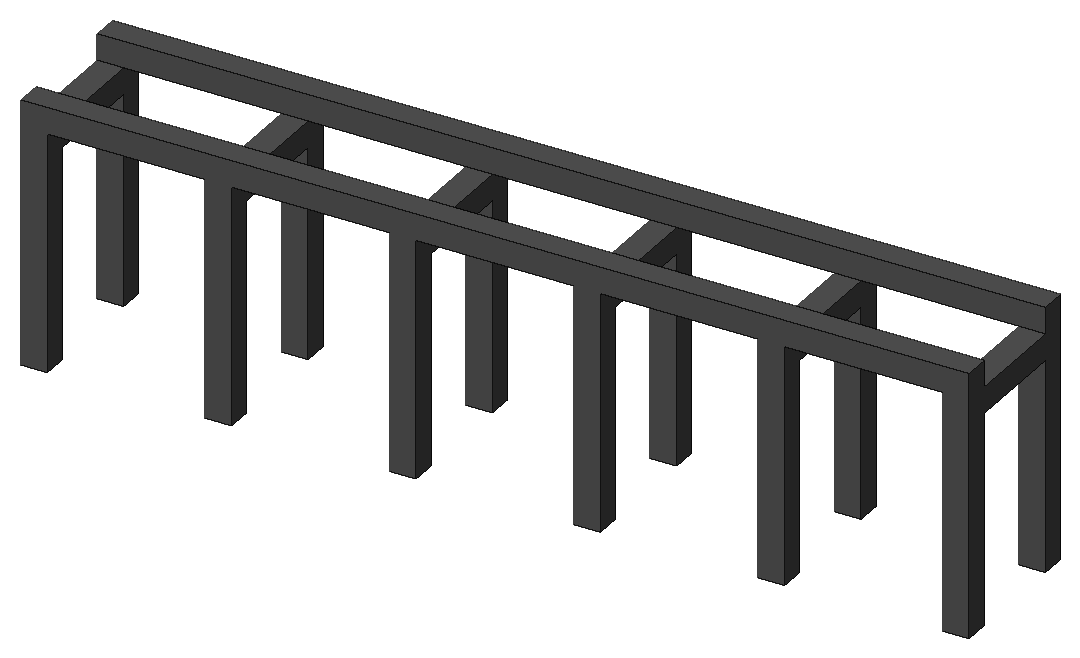
cad/turbine_6kw/out/iso/parts/NS6-110-3.png
