safarcikm/Wind-turbines/cad/turbine_6kw/out/iso/parts/NS6-200.png

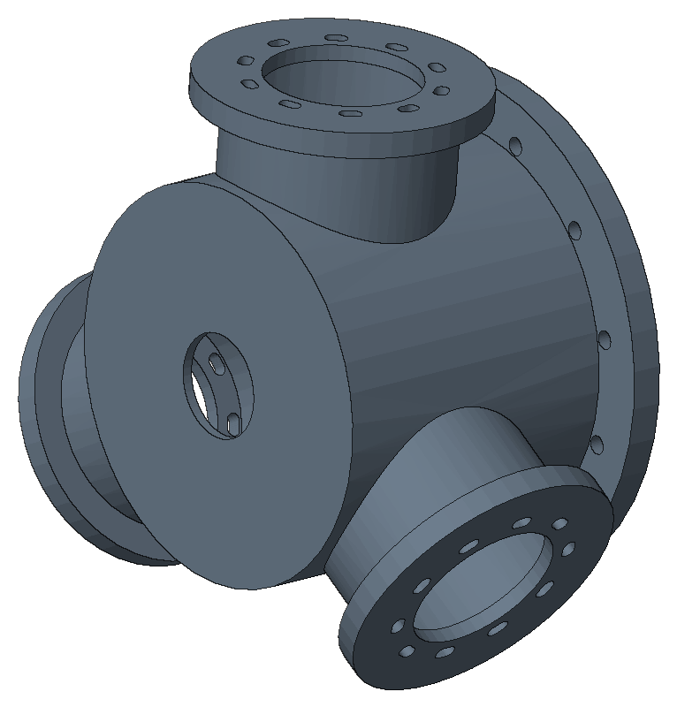
cad/turbine_6kw/out/iso/parts/NS6-200.png
