safarcikm/Wind-turbines/cad/turbine_6kw/out/iso/parts/NS6-700-1.png

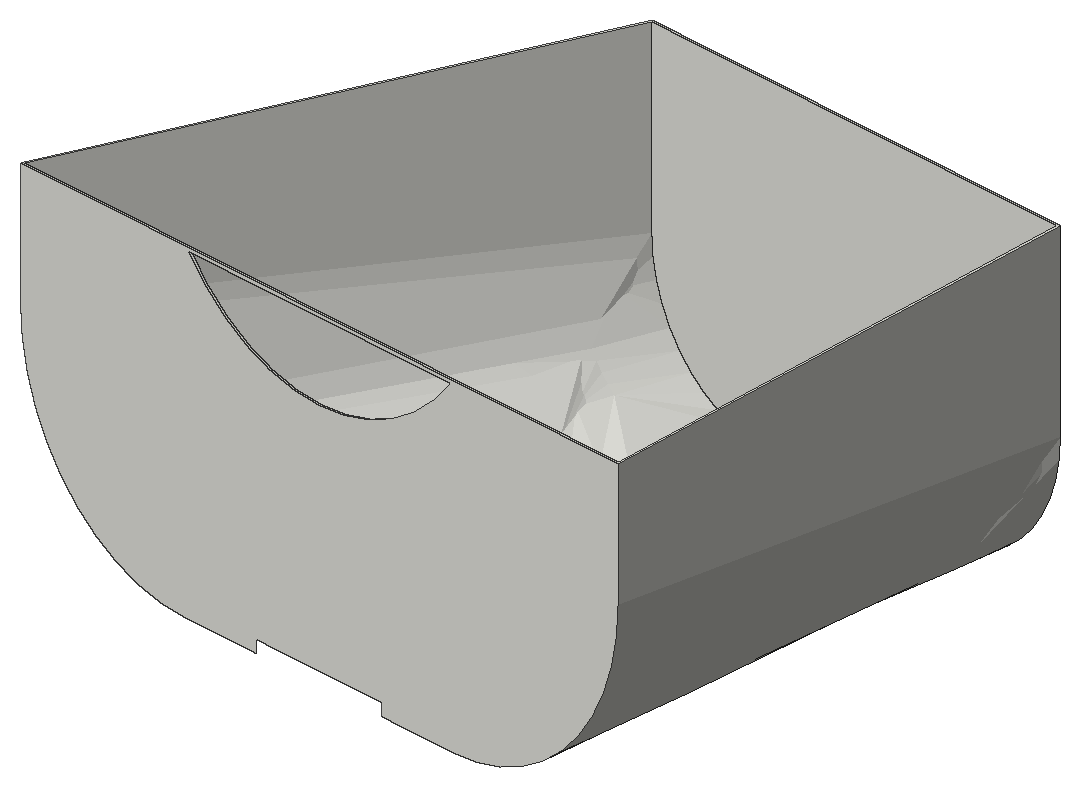
cad/turbine_6kw/out/iso/parts/NS6-700-1.png
