safarcikm/Wind-turbines/cad/turbine_6kw/out/iso/parts/NS6-710.png

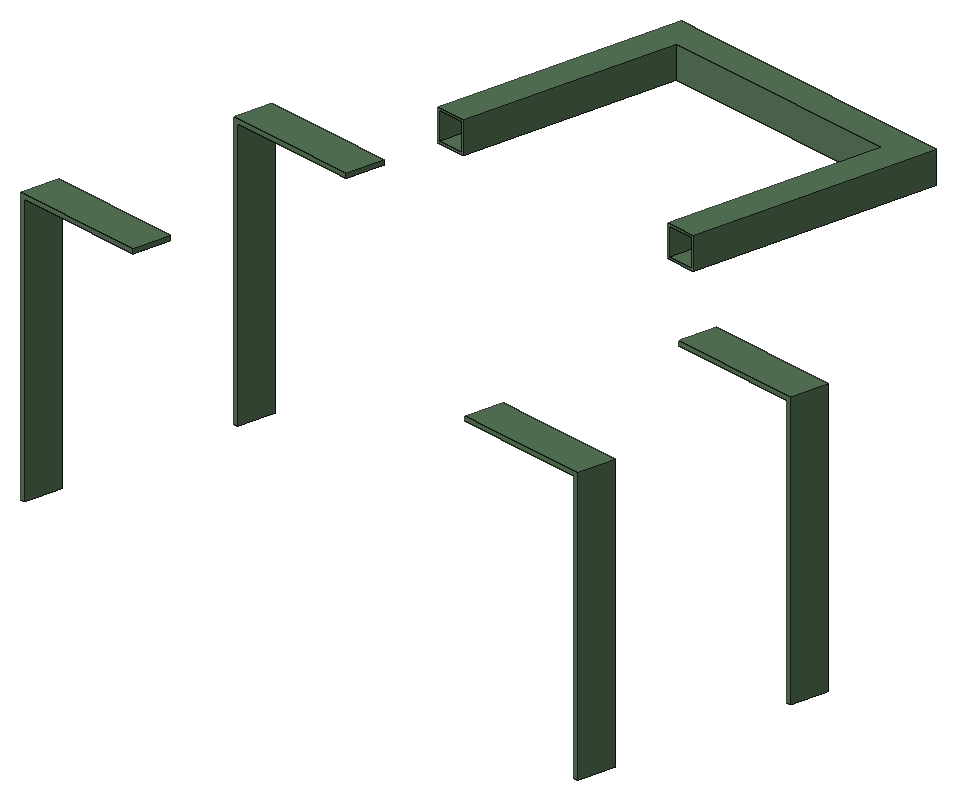
cad/turbine_6kw/out/iso/parts/NS6-710.png
