safarcikm/Wind-turbines/cad/turbine_6kw/out/iso/parts/NS6-911-I.png

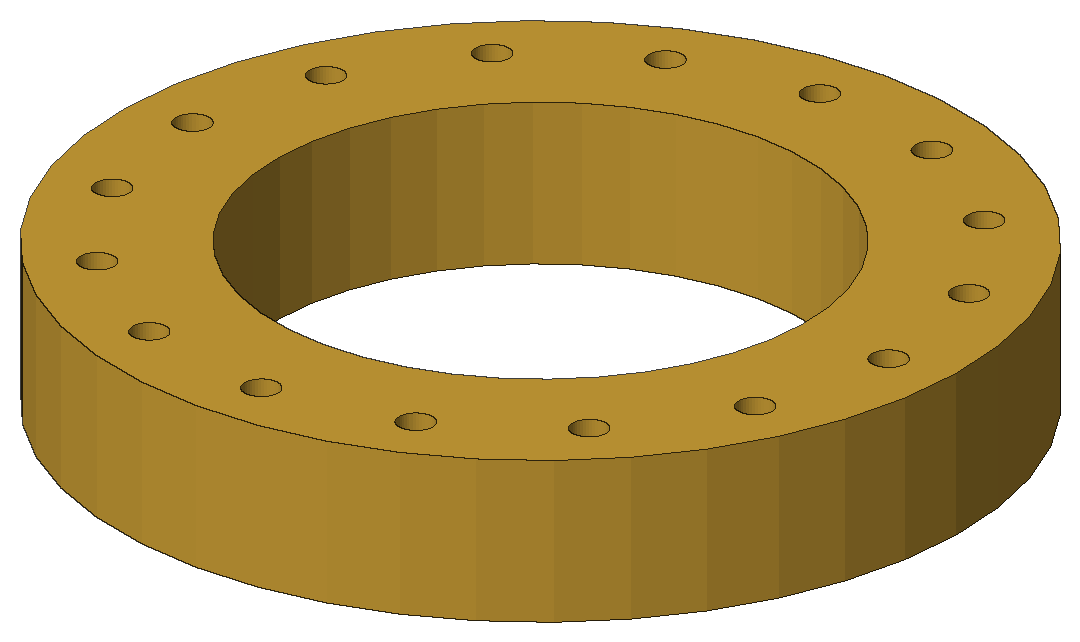
cad/turbine_6kw/out/iso/parts/NS6-911-I.png
