safarcikm/Wind-turbines/cad/turbine_6kw/out/iso/parts/NS6-911-O.png

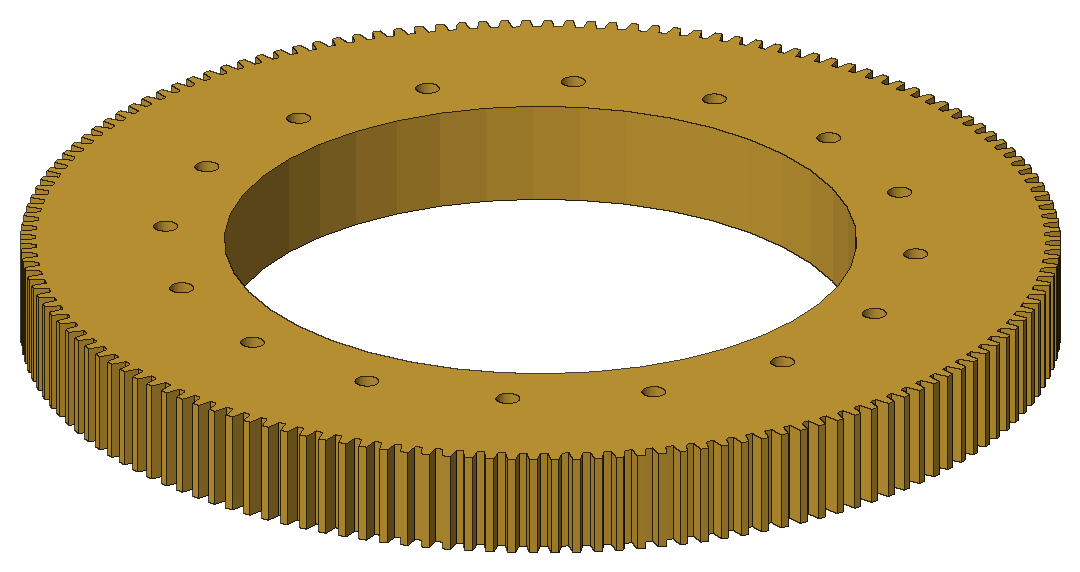
cad/turbine_6kw/out/iso/parts/NS6-911-O.png
