safarcikm/Wind-turbines/cad/turbine_6kw/out/iso/parts/NS6-912-L.png

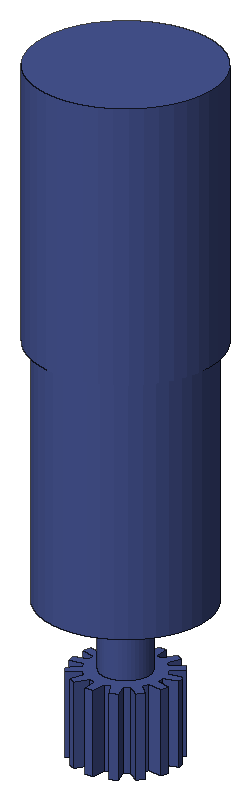
cad/turbine_6kw/out/iso/parts/NS6-912-L.png
