safarcikm/Wind-turbines/cad/turbine_6kw/out/iso/parts/NS6-913-R.png

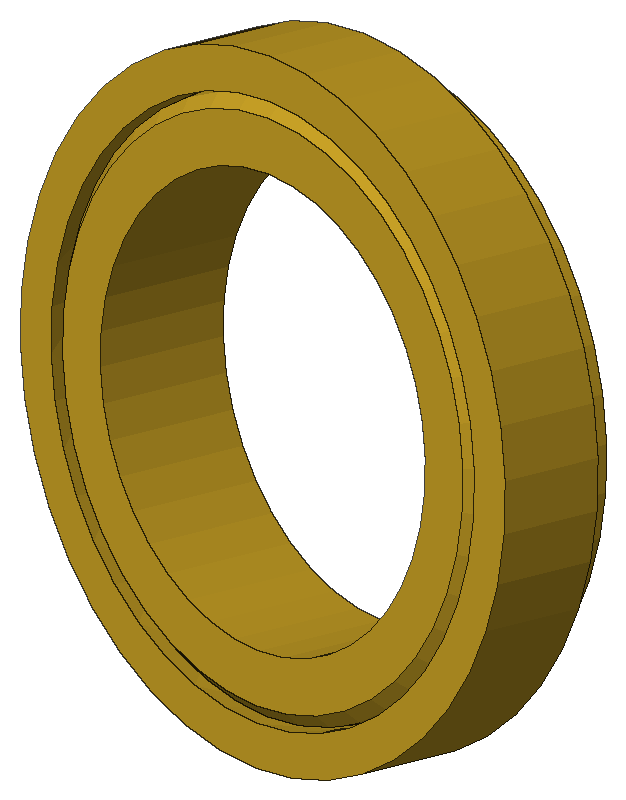
cad/turbine_6kw/out/iso/parts/NS6-913-R.png
