safarcikm/Wind-turbines/cad/turbine_6kw/out/iso/parts/NY-410-L.png

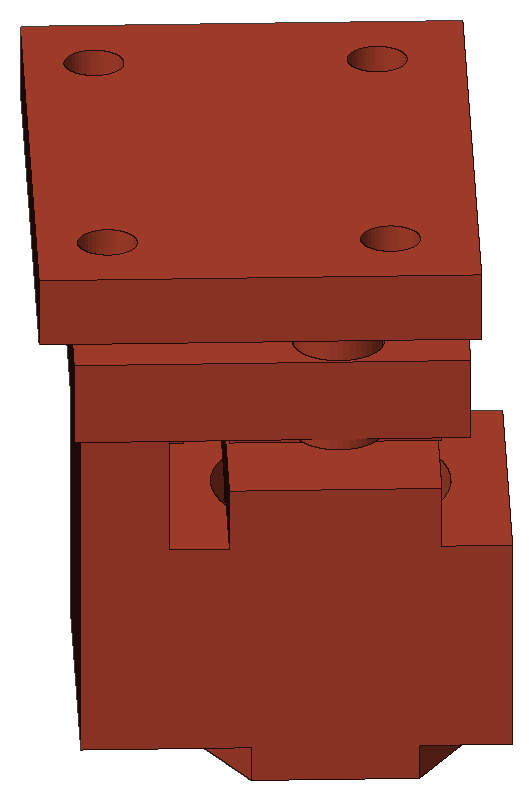
cad/turbine_6kw/out/iso/parts/NY-410-L.png
