safarcikm/Wind-turbines/cad/turbine_6kw/out/iso/parts/NY-410-R.png

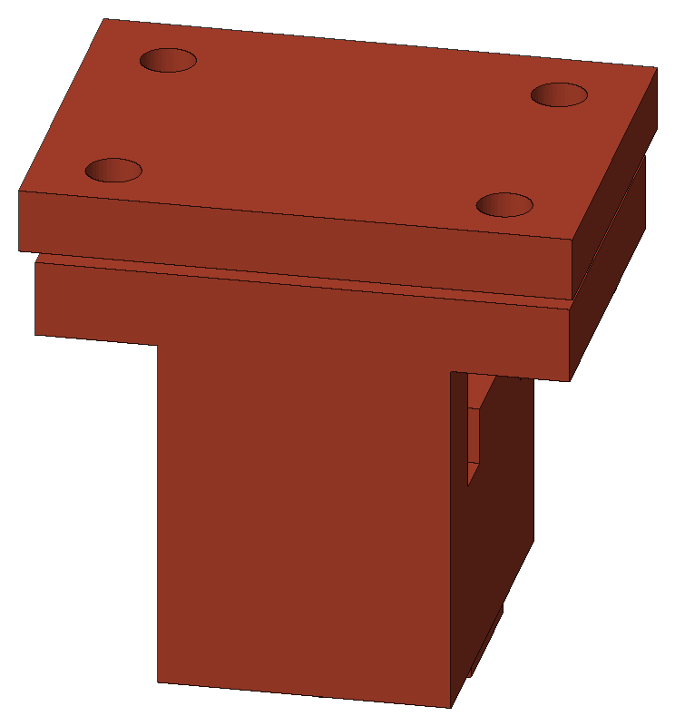
cad/turbine_6kw/out/iso/parts/NY-410-R.png
