safarcikm/Wind-turbines/cad/turbine_6kw/out/iso/parts/NY-430.png

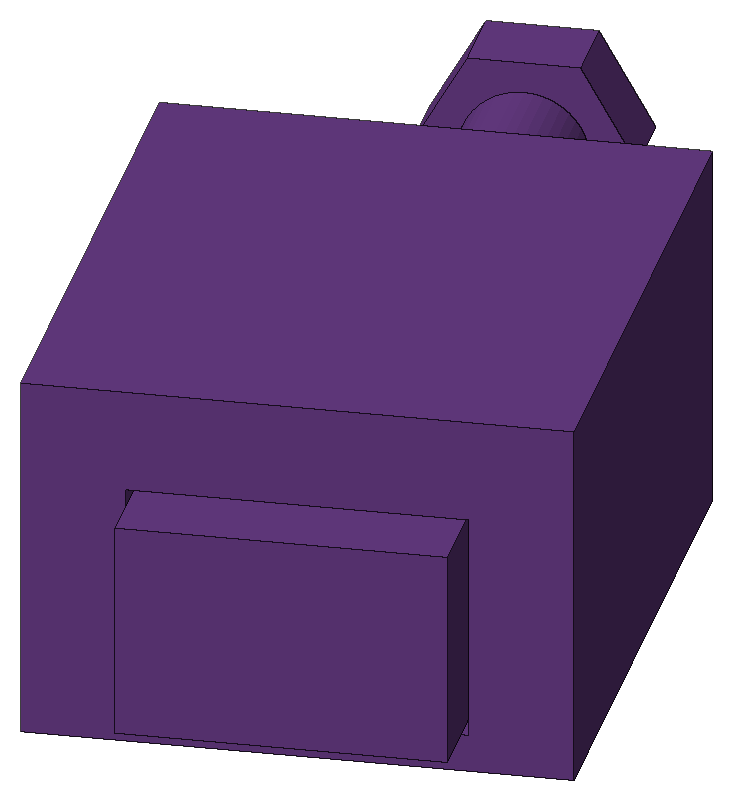
cad/turbine_6kw/out/iso/parts/NY-430.png
