safarcikm/Wind-turbines/cad/turbine_6kw/out/iso/parts/NY-440.png

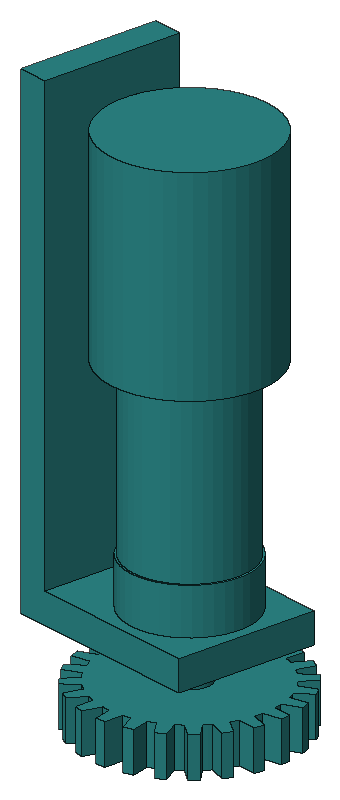
cad/turbine_6kw/out/iso/parts/NY-440.png
