safarcikm/Wind-turbines/cad/turbine_6kw/out/iso/parts/NY-460.png

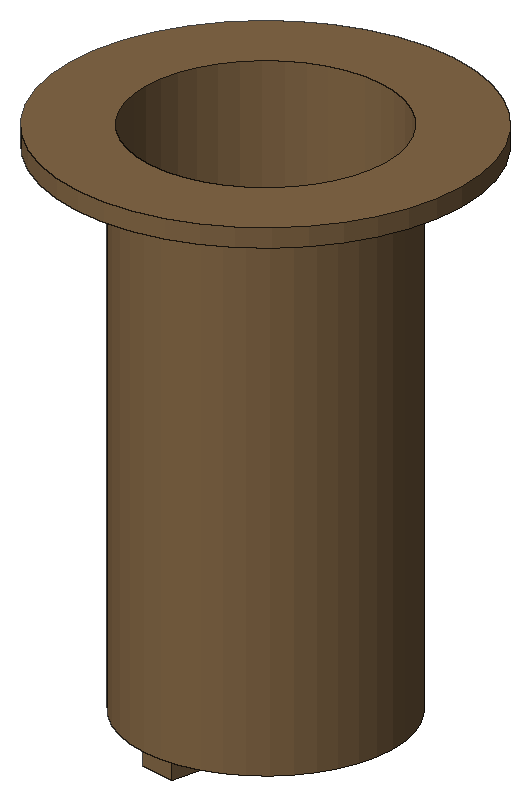
cad/turbine_6kw/out/iso/parts/NY-460.png
