safarcikm/Wind-turbines/cad/nacelle_fitcheck/out/NP1-fitcheck-assembly.step

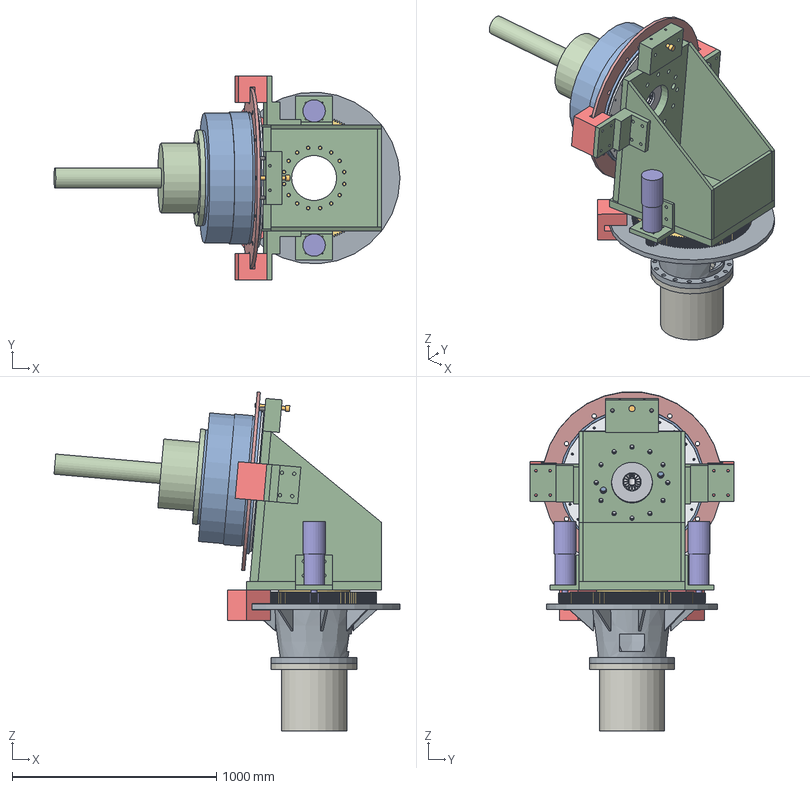
[picture p215: CAD file, 2026-11-03]
cad/nacelle_fitcheck/out/NP1-fitcheck-assembly.step
1692.3 x 1000.0 x 1658.0 mm
NP1-100_spindle
NP1-101_front_spacer
NP1-102_rear_seal_sleeve
NP1-110_cooling_insert
KMT27_locknut_envelope
32028X_front_cone_envelope
32028X_rear_cone_envelope
32028X_front_cup_envelope
32028X_rear_cup_envelope
NP1-200_stator_carrier
NP1-201_stator_core
stator_key_090
stator_key_210
stator_key_330
NP1-202_stator_clamp_ring
stator_end_winding_front_envelope
stator_end_winding_rear_envelope
NP1-210_rotor_drum
NP1-211_front_seal_cover
NP1-211_rear_seal_cover
NP1-212_drum_rear_cover
NP1-220_magnet_ring
NP1-230_brake_disc
NP1-320_lock_pin
NP1-321_lock_pin_holder
overspeed_sensor_075_envelope
overspeed_sensor_105_envelope
NP1-300-1_bedplate_front_plate
NP1-300-2_bedplate_bottom_plate
NP1-300-3_bedplate_side_plate_left
NP1-300-3_bedplate_side_plate_right
NP1-300-4_bedplate_rear_plate
yaw_bearing_inner_ring_envelope
yaw_bearing_outer_gear_ring_envelope
brake_caliper_left_envelope
brake_caliper_right_envelope
NP1-310_rotor_caliper_bracket_left
NP1-310_rotor_caliper_bracket_right
yaw_drive_left_envelope
NP1-420_yaw_drive_bracket_left
yaw_drive_right_envelope
NP1-420_yaw_drive_bracket_right
yaw_brake_caliper_left_envelope
yaw_brake_caliper_right_envelope
NP1-400_tower_top_adapter
tower_top_flange_stub
NP1-600_dummy_hub
