safarcikm/Wind-turbines/cad/generator_rc/out/dxf/NP1-222C.dxf

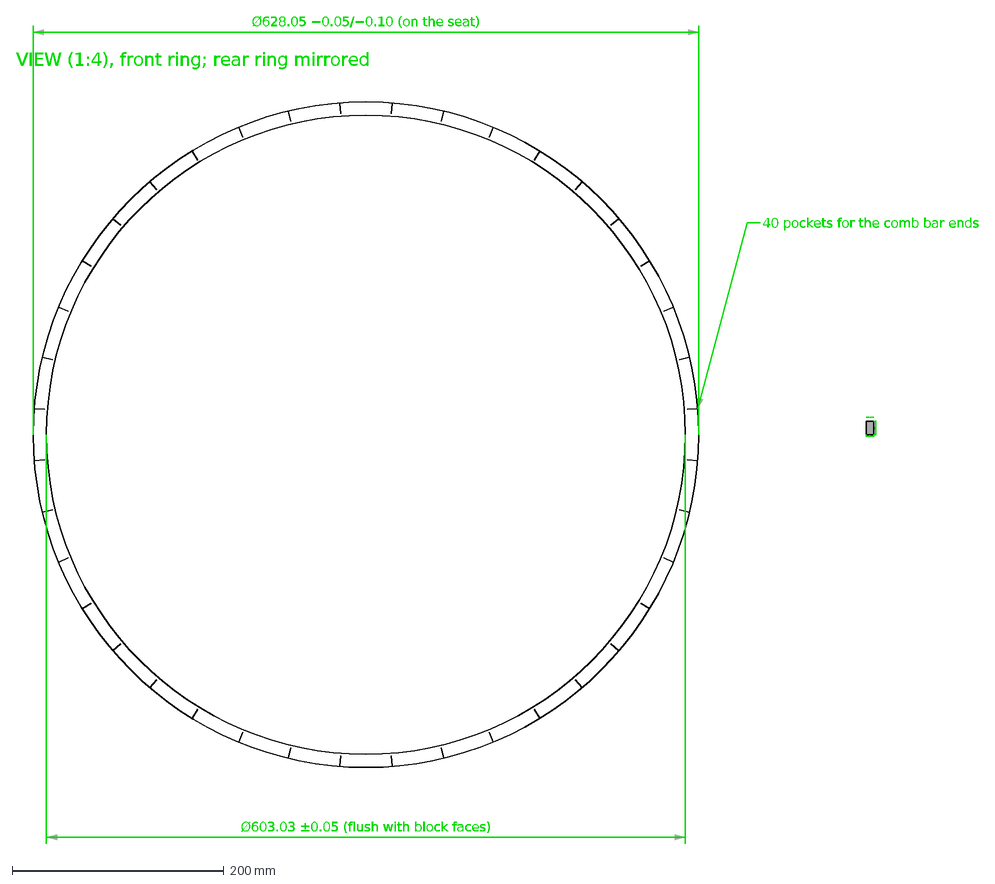
[picture p216: CAD file, 2026-11-05]
cad/generator_rc/out/dxf/NP1-222C.dxf
Ø628.05 −0.05/−0.10 (on the seat)
Ø603.03 ±0.05 (flush with block faces)
40 pockets for the comb bar ends
VIEW (1:4), front ring; rear ring mirrored
7.1
12.51
SECTION (4:1)
