safarcikm/Wind-turbines/cad/nacelle_fitcheck/out/step/yaw_bearing_inner_ring_envelope.step

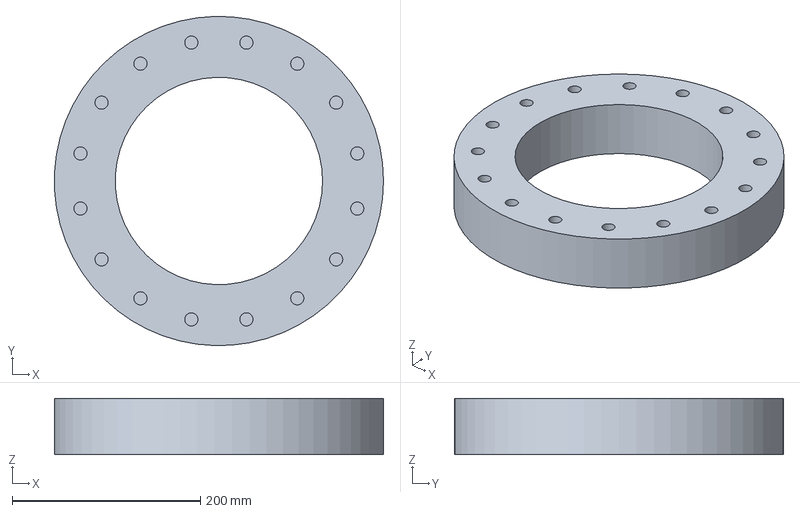
[picture p217: CAD file, 2026-11-03]
cad/nacelle_fitcheck/out/step/yaw_bearing_inner_ring_envelope.step
349.8 x 349.9 x 60.0 mm
