safarcikm/Wind-turbines/cad/nacelle_p1/out/dxf/NP1-600.dxf

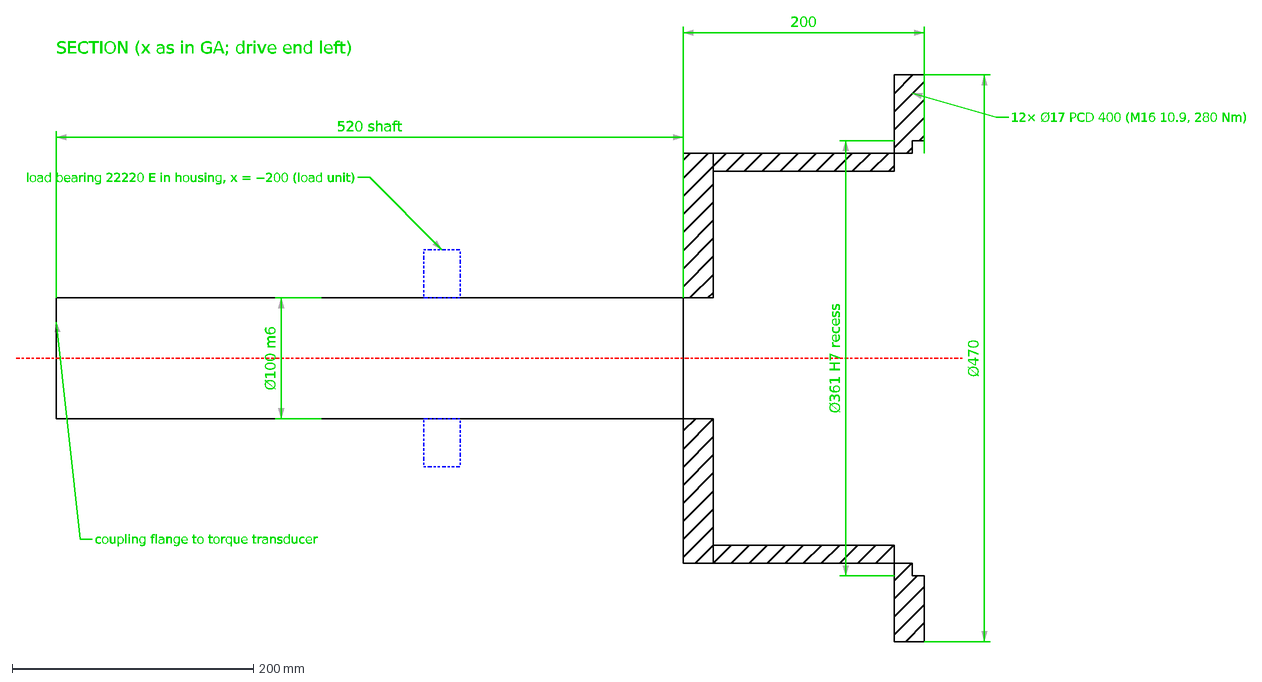
[picture p218: CAD file, 2026-11-03]
cad/nacelle_p1/out/dxf/NP1-600.dxf
200
520 shaft
Ø470
Ø361 H7 recess
Ø100 m6
load bearing 22220 E in housing, x = −200 (load unit)
coupling flange to torque transducer
12× Ø17 PCD 400 (M16 10.9, 280 Nm)
SECTION (x as in GA; drive end left)
