safarcikm/Wind-turbines/cad/nacelle_w/out/step/NW-520-090_pitch_drive_bracket.step

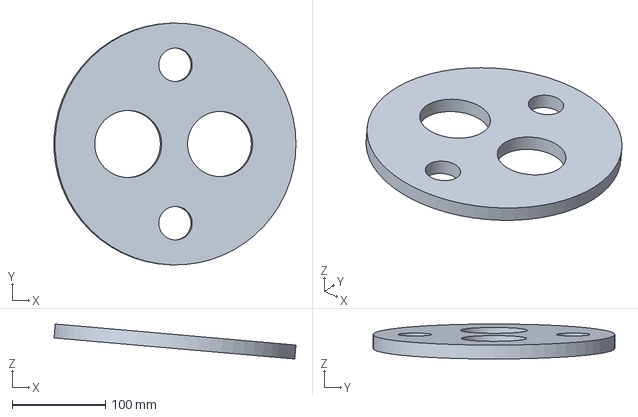
[picture p219: CAD file, 2026-11-03]
cad/nacelle_w/out/step/NW-520-090_pitch_drive_bracket.step
259.7 x 259.5 x 37.6 mm
