safarcikm/Wind-turbines/cad/turbine_6kw/out/dxf/NS6-210.dxf

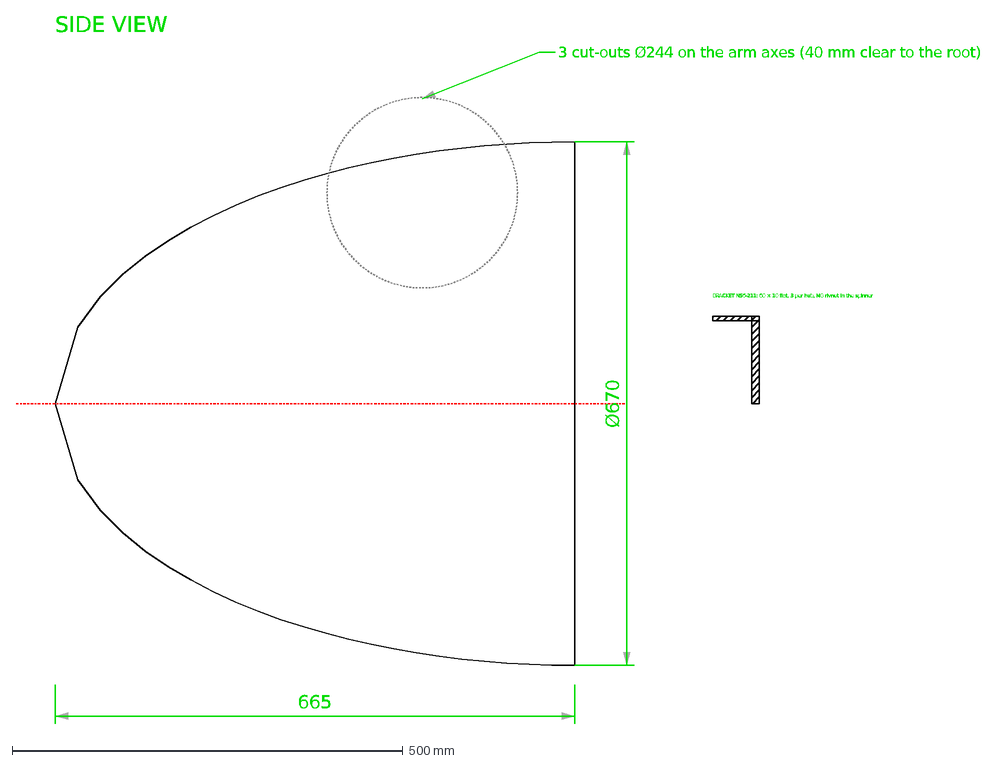
[picture p220: CAD file, 2026-11-06]
cad/turbine_6kw/out/dxf/NS6-210.dxf
665
Ø670
3 cut-outs Ø244 on the arm axes (40 mm clear to the root)
SIDE VIEW
BRACKET NS6-211: 60 × 10 flat, 3 per hub, M8 rivnut in the spinner
