safarcikm/Wind-turbines/cad/yaw/out/dxf/NY-440.dxf

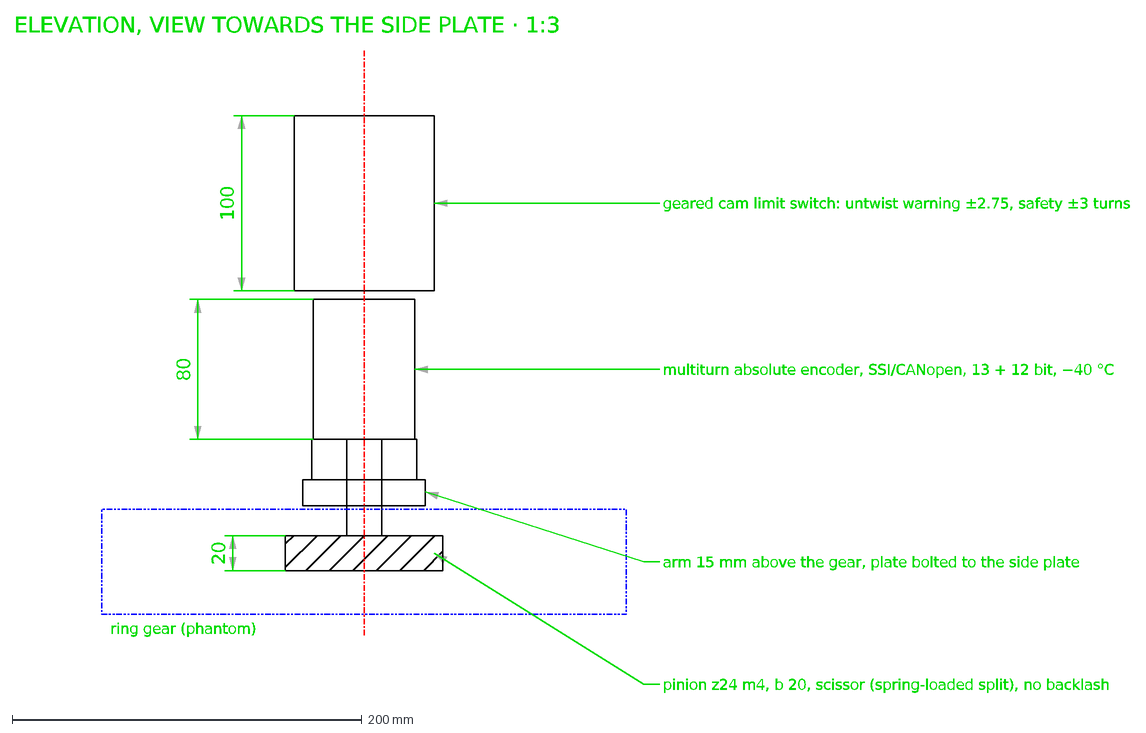
[picture p221: CAD file, 2026-11-05]
cad/yaw/out/dxf/NY-440.dxf
ELEVATION, VIEW TOWARDS THE SIDE PLATE · 1:3
ring gear (phantom)
20
100
80
pinion z24 m4, b 20, scissor (spring-loaded split), no backlash
multiturn absolute encoder, SSI/CANopen, 13 + 12 bit, −40 °C
geared cam limit switch: untwist warning ±2.75, safety ±3 turns
arm 15 mm above the gear, plate bolted to the side plate
