safarcikm/Wind-turbines/cad/generator_rc/out/dxf/NP1-212C.dxf

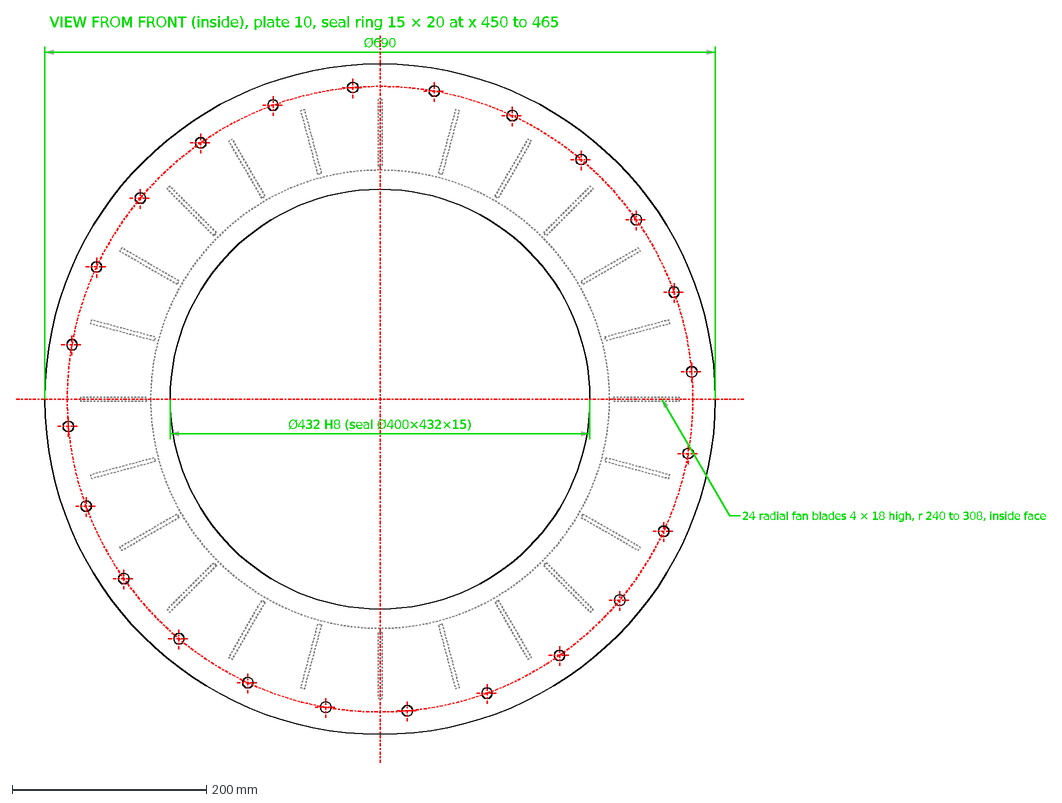
[picture p222: CAD file, 2026-11-05]
cad/generator_rc/out/dxf/NP1-212C.dxf
24 radial fan blades 4 × 18 high, r 240 to 308, inside face
Ø690
Ø432 H8 (seal Ø400×432×15)
VIEW FROM FRONT (inside), plate 10, seal ring 15 × 20 at x 450 to 465
