safarcikm/Wind-turbines/cad/nacelle_fitcheck/out/step/stator_key_330.step

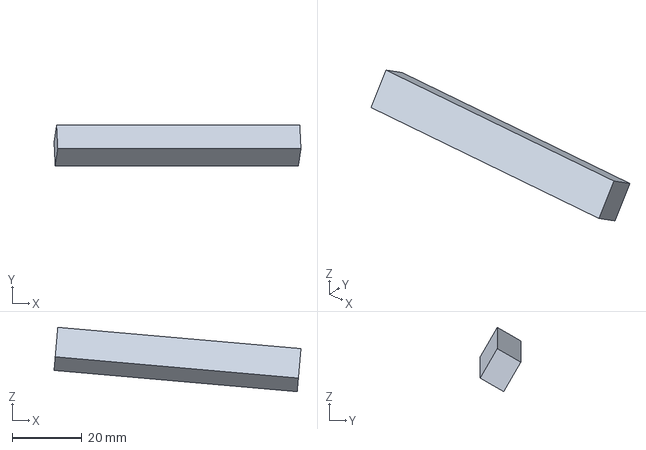
[picture p223: CAD file, 2026-11-03]
cad/nacelle_fitcheck/out/step/stator_key_330.step
70.8 x 11.7 x 18.4 mm
