safarcikm/Wind-turbines/cad/nacelle_p1/out/dxf/NP1-211.dxf

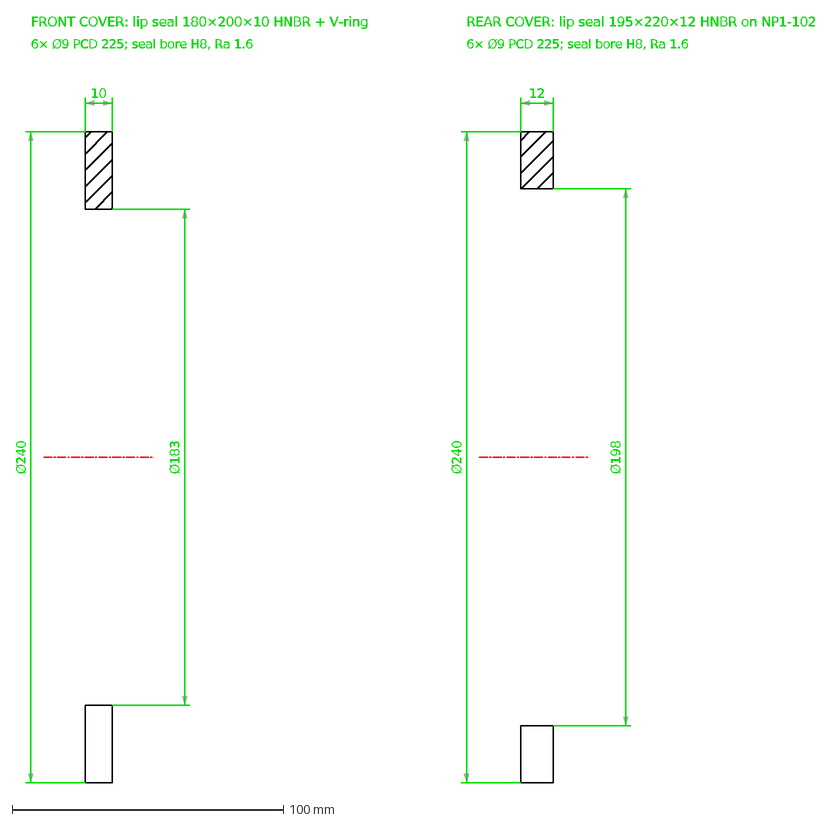
[picture p224: CAD file, 2026-11-03]
cad/nacelle_p1/out/dxf/NP1-211.dxf
10
Ø183
Ø240
FRONT COVER: lip seal 180×200×10 HNBR + V-ring
6× Ø9 PCD 225; seal bore H8, Ra 1.6
12
Ø198
REAR COVER: lip seal 195×220×12 HNBR on NP1-102
