safarcikm/Wind-turbines/cad/nacelle_w/out/step/NW-510-330_pitch_bearing_outer_ring.step

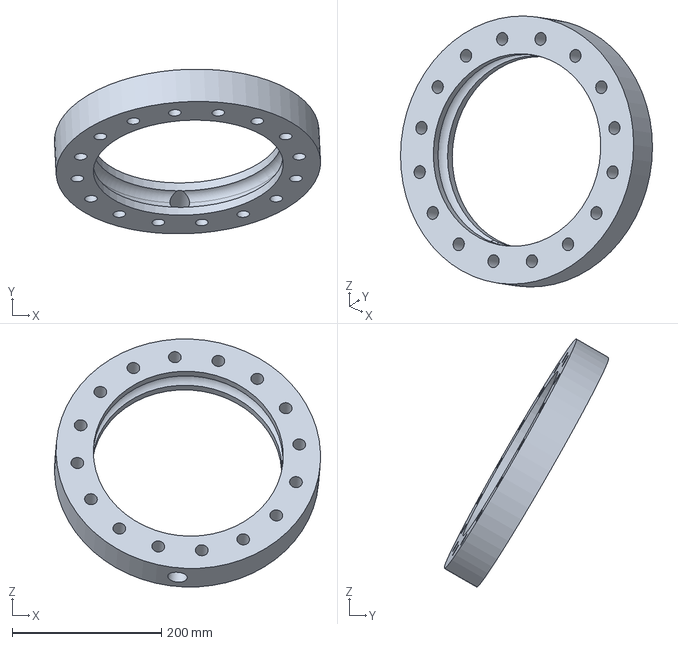
[picture p225: CAD file, 2026-11-03]
cad/nacelle_w/out/step/NW-510-330_pitch_bearing_outer_ring.step
356.7 x 220.5 x 332.4 mm
