safarcikm/Wind-turbines/cad/turbine_6kw/out/dxf/NS6-000.dxf

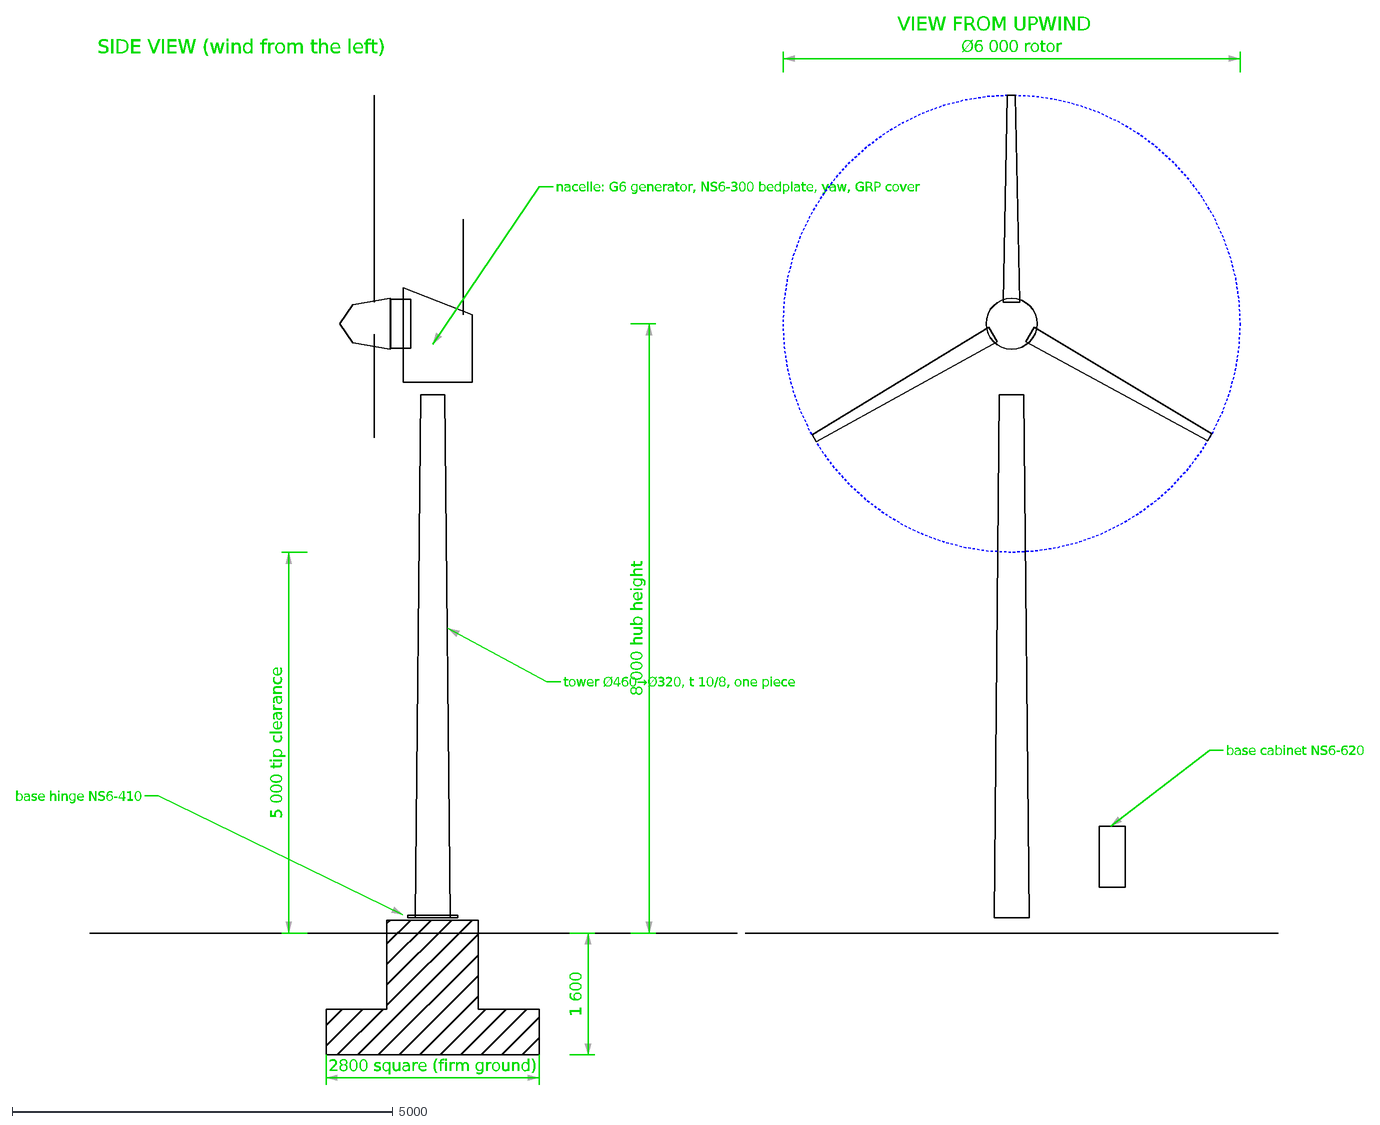
[picture p226: CAD file, 2026-11-06]
cad/turbine_6kw/out/dxf/NS6-000.dxf
8 000 hub height
5 000 tip clearance
2800 square (firm ground)
1 600
tower Ø460→Ø320, t 10/8, one piece
base hinge NS6-410
nacelle: G6 generator, NS6-300 bedplate, yaw, GRP cover
SIDE VIEW (wind from the left)
base cabinet NS6-620
Ø6 000 rotor
VIEW FROM UPWIND
