safarcikm/Wind-turbines/cad/yaw/out/dxf/NY-400.dxf

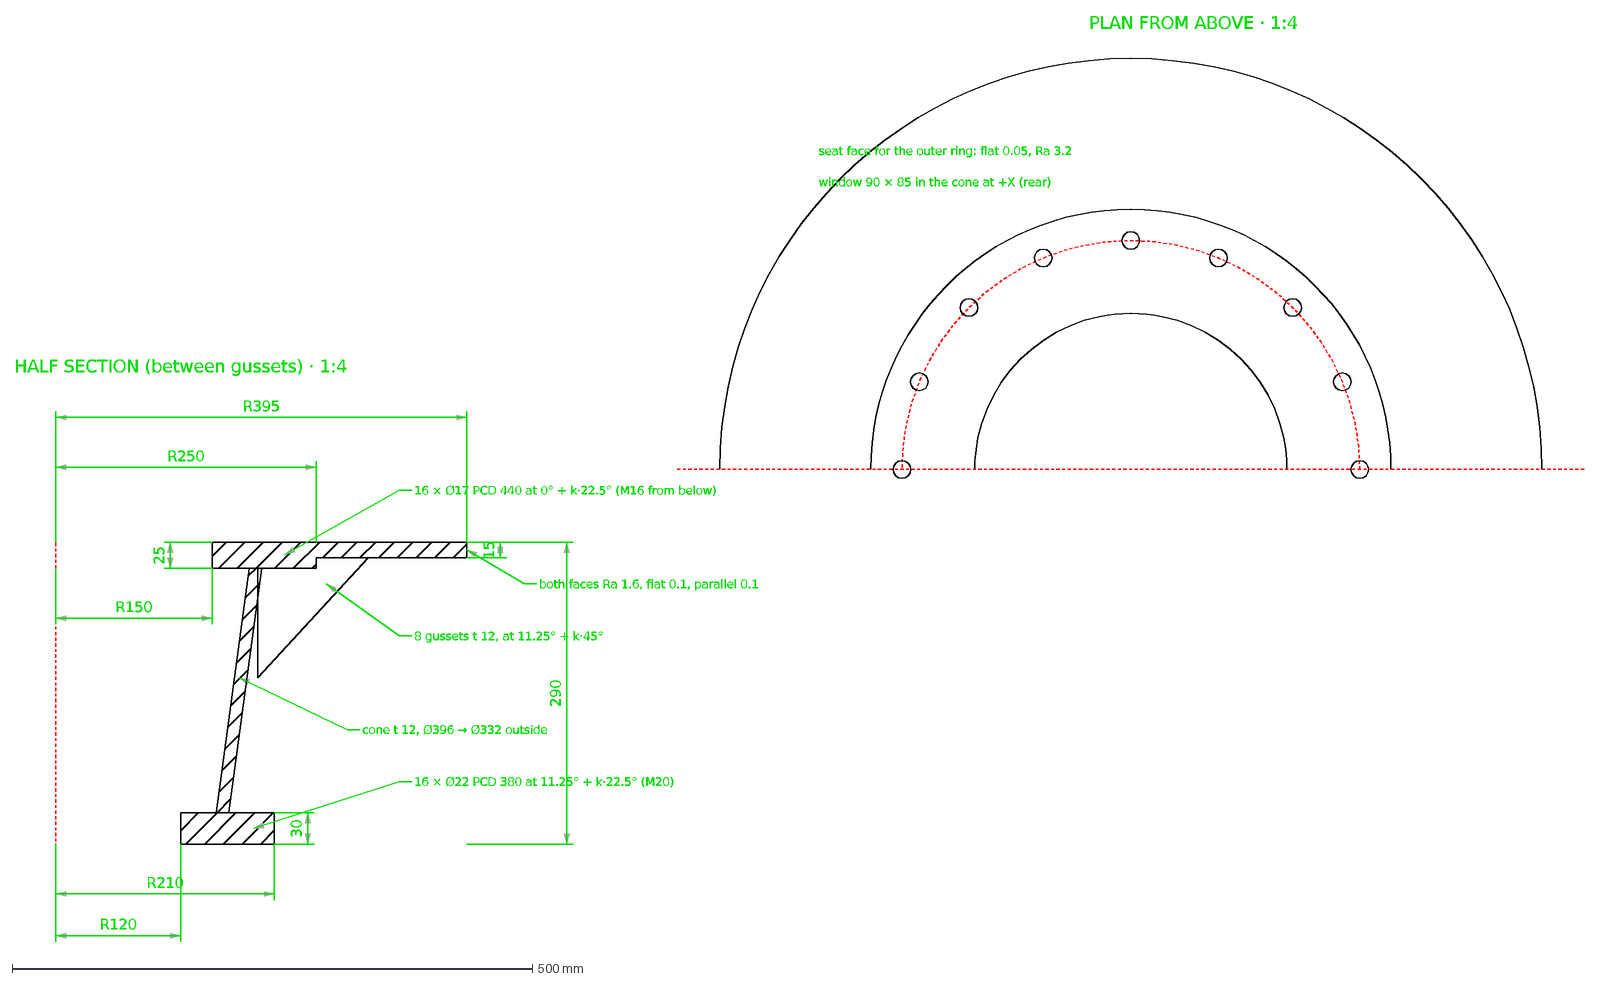
[picture p227: CAD file, 2026-11-05]
cad/yaw/out/dxf/NY-400.dxf
HALF SECTION (between gussets) · 1:4
R395
R250
R150
15
25
30
290
R210
R120
cone t 12, Ø396 → Ø332 outside
8 gussets t 12, at 11.25° + k·45°
16 × Ø17 PCD 440 at 0° + k·22.5° (M16 from below)
16 × Ø22 PCD 380 at 11.25° + k·22.5° (M20)
both faces Ra 1.6, flat 0.1, parallel 0.1
PLAN FROM ABOVE · 1:4
seat face for the outer ring: flat 0.05, Ra 3.2
window 90 × 85 in the cone at +X (rear)
