safarcikm/Wind-turbines/cad/generator_rc/out/dxf/NP1-200C.dxf

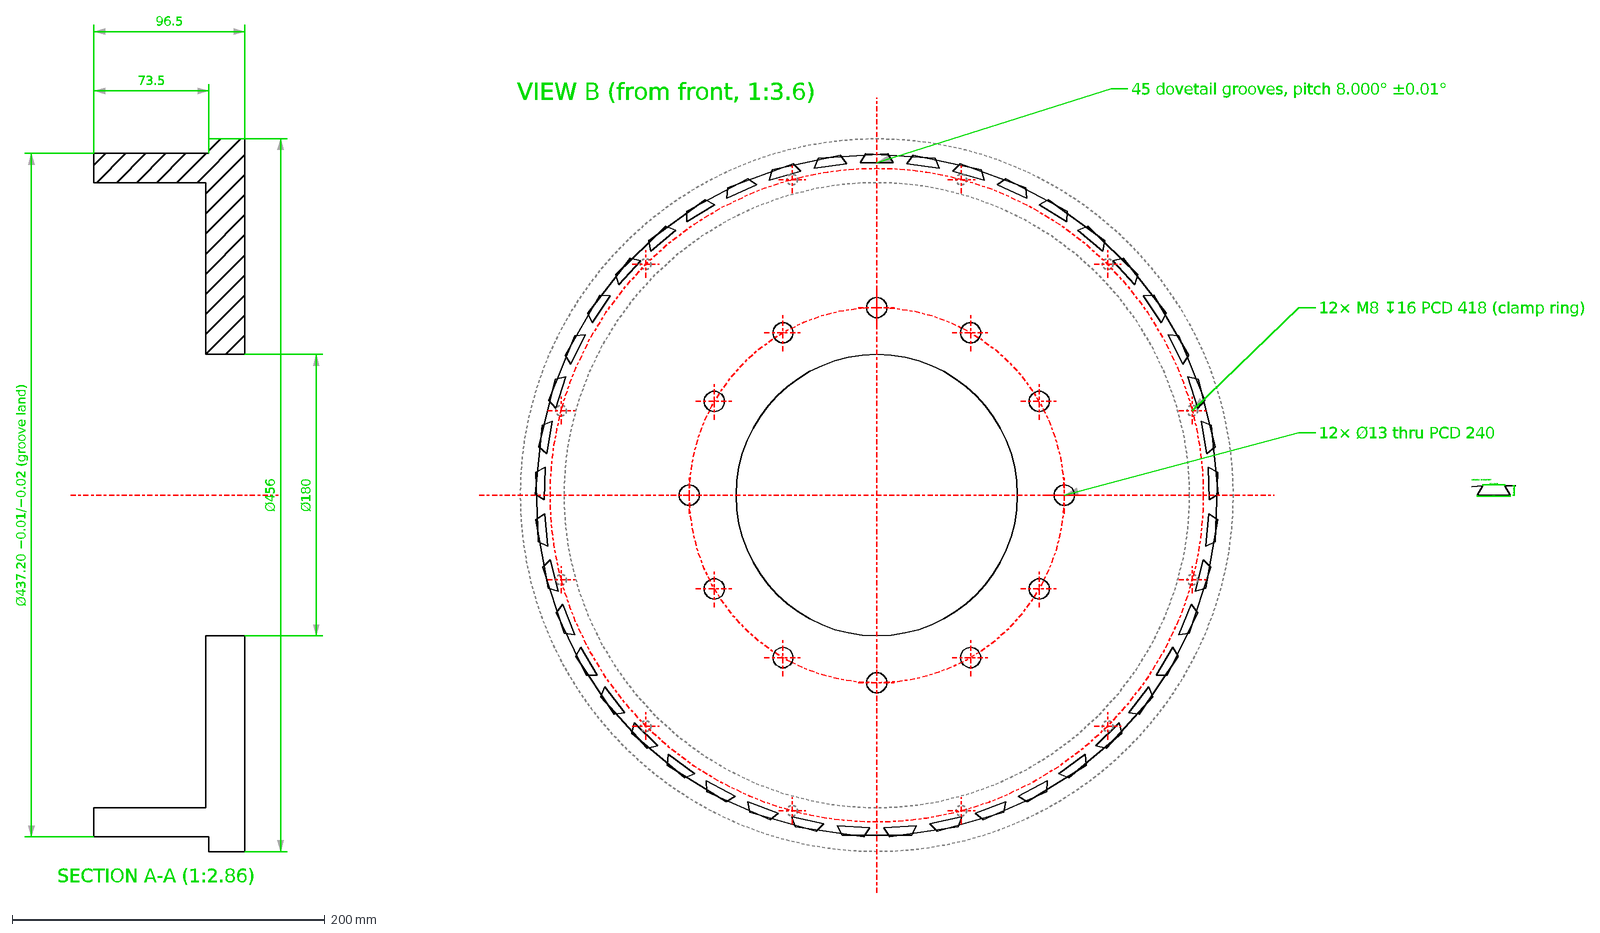
[picture p228: CAD file, 2026-11-05]
cad/generator_rc/out/dxf/NP1-200C.dxf
73.5
96.5
Ø180
Ø437.20 −0.01/−0.02 (groove land)
Ø456
SECTION A-A (1:2.86)
45 dovetail grooves, pitch 8.000° ±0.01°
12× Ø13 thru PCD 240
12× M8 ↧16 PCD 418 (clamp ring)
VIEW B (from front, 1:3.6)
14.00 +0.02/+0.01
20.92
6.00 ±0.01
DETAIL C: GROOVE (5:1), flanks 60°
