safarcikm/Wind-turbines/cad/nacelle_fitcheck/out/step/NP1-210_rotor_drum.step

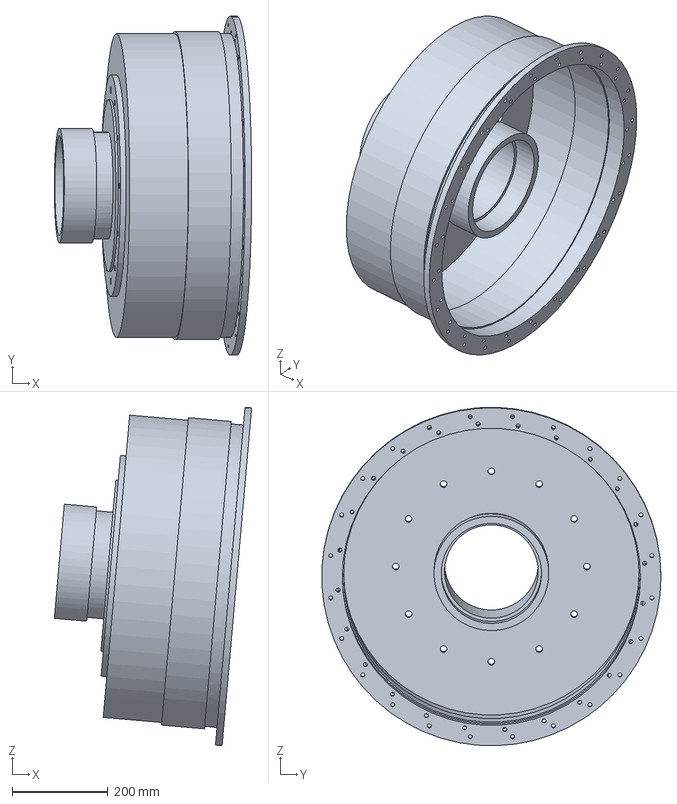
[picture p229: CAD file, 2026-11-03]
cad/nacelle_fitcheck/out/step/NP1-210_rotor_drum.step
413.0 x 709.5 x 708.2 mm
