safarcikm/Wind-turbines/cad/nacelle_w/out/step/pitch_encoder_090_envelope.step

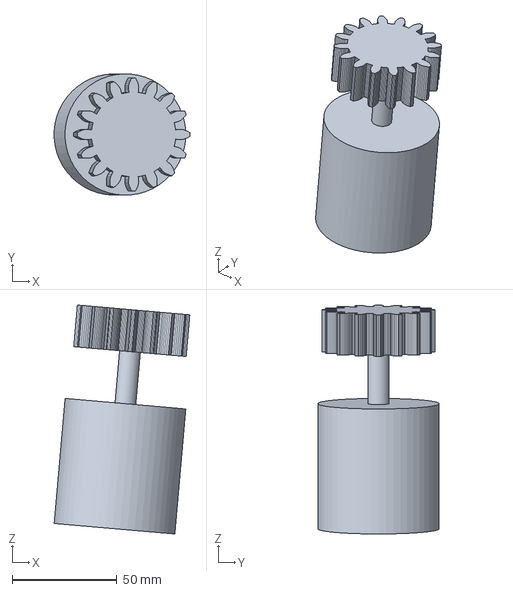
[picture p230: CAD file, 2026-11-03]
cad/nacelle_w/out/step/pitch_encoder_090_envelope.step
64.9 x 58.0 x 109.5 mm
