safarcikm/Wind-turbines/cad/turbine_6kw/out/dxf/NS6-710.dxf

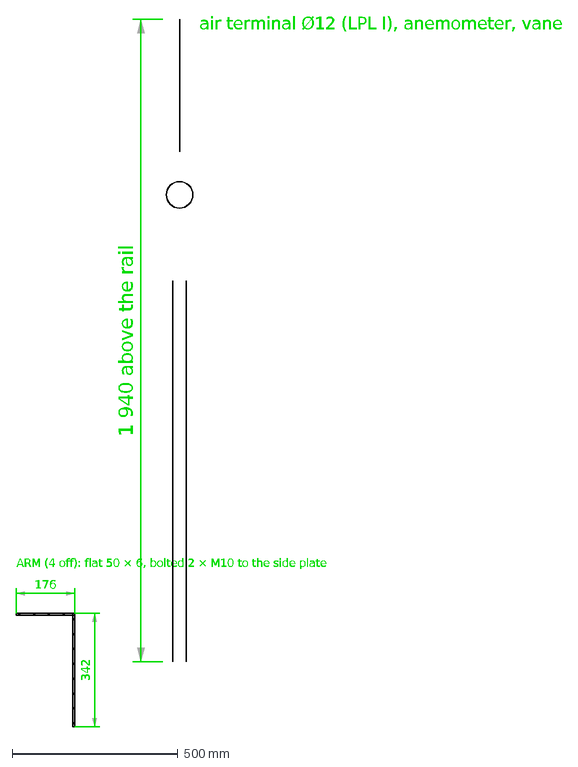
[picture p231: CAD file, 2026-11-06]
cad/turbine_6kw/out/dxf/NS6-710.dxf
176
342
ARM (4 off): flat 50 × 6, bolted 2 × M10 to the side plate
1 940 above the rail
air terminal Ø12 (LPL I), anemometer, vane
