safarcikm/Wind-turbines/cad/yaw/out/dxf/NY-000.dxf

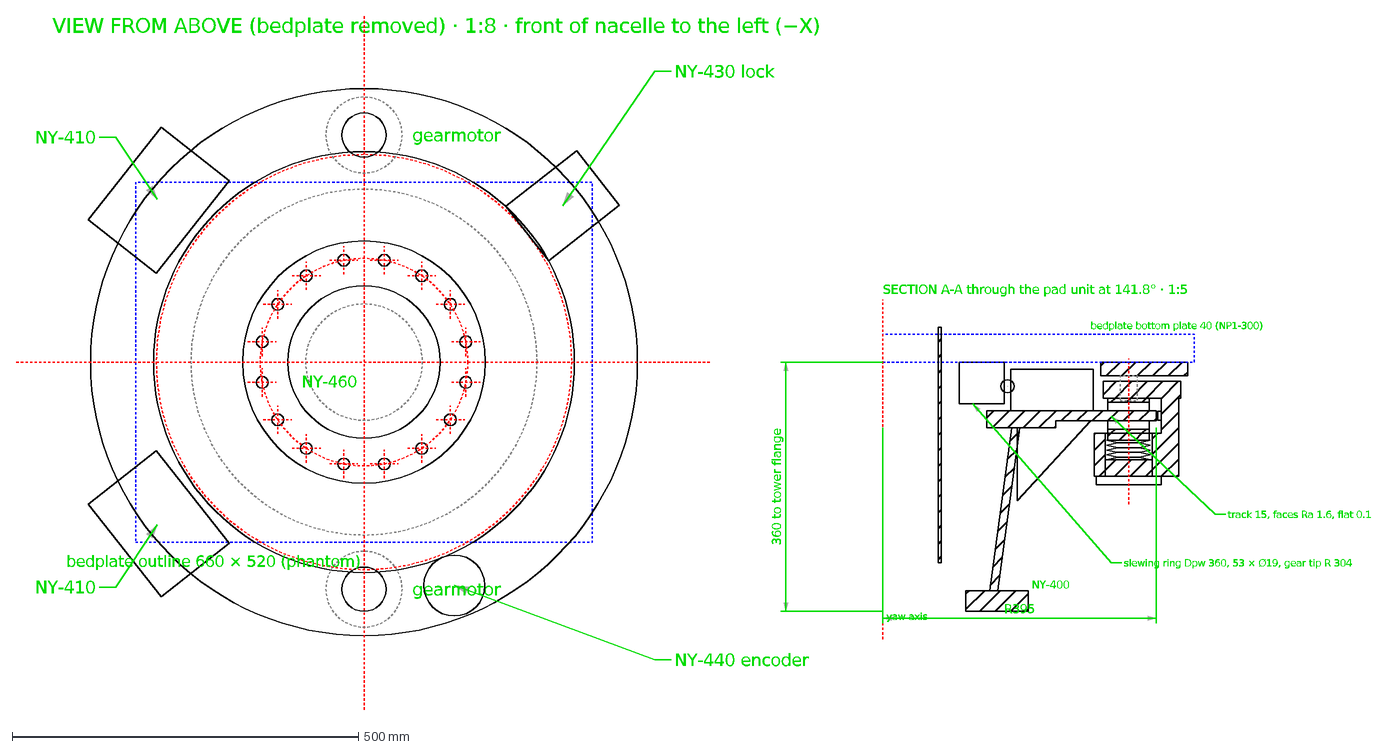
[picture p232: CAD file, 2026-11-05]
cad/yaw/out/dxf/NY-000.dxf
VIEW FROM ABOVE (bedplate removed) · 1:8 · front of nacelle to the left (−X)
gearmotor
NY-410
NY-430 lock
NY-440 encoder
NY-460
bedplate outline 660 × 520 (phantom)
SECTION A-A through the pad unit at 141.8° · 1:5
bedplate bottom plate 40 (NP1-300)
yaw axis
R395
360 to tower flange
track 15, faces Ra 1.6, flat 0.1
slewing ring Dpw 360, 53 × Ø19, gear tip R 304
NY-400
