safarcikm/Wind-turbines/cad/nacelle_fitcheck/out/step/NP1-600_dummy_hub.step

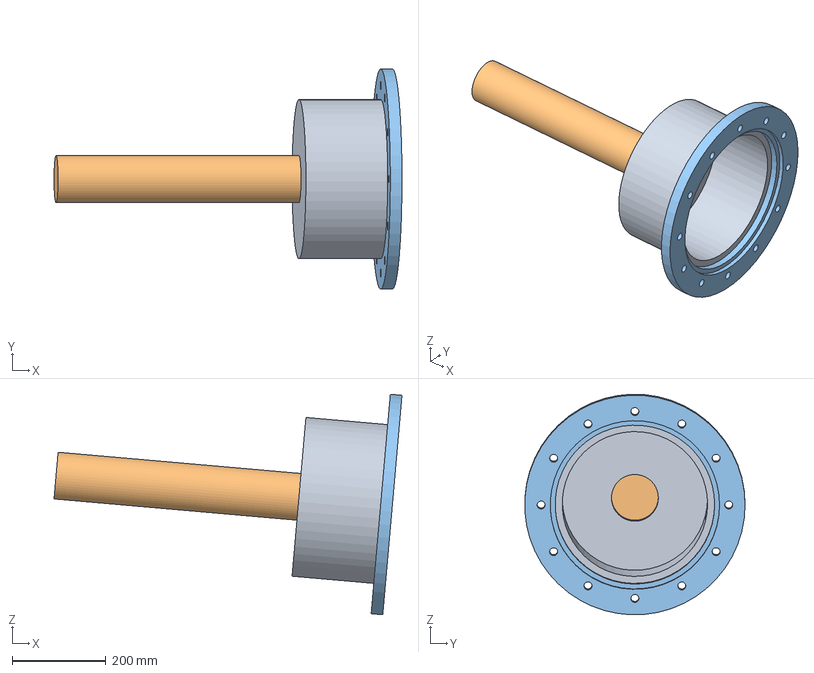
[picture p233: CAD file, 2026-11-03]
cad/nacelle_fitcheck/out/step/NP1-600_dummy_hub.step
742.1 x 469.6 x 470.2 mm
