safarcikm/Wind-turbines/cad/nacelle_w/out/step/NW-520-330_pitch_drive_bracket.step

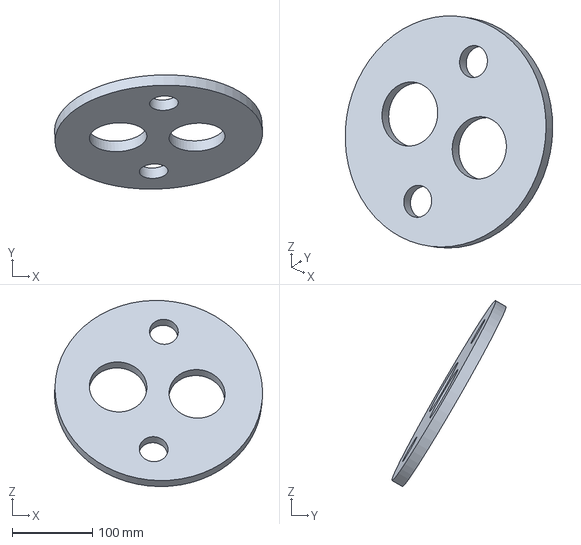
[picture p234: CAD file, 2026-11-03]
cad/nacelle_w/out/step/NW-520-330_pitch_drive_bracket.step
259.9 x 142.7 x 232.5 mm
