safarcikm/Wind-turbines/cad/turbine_6kw/out/dxf/NS6-101.dxf

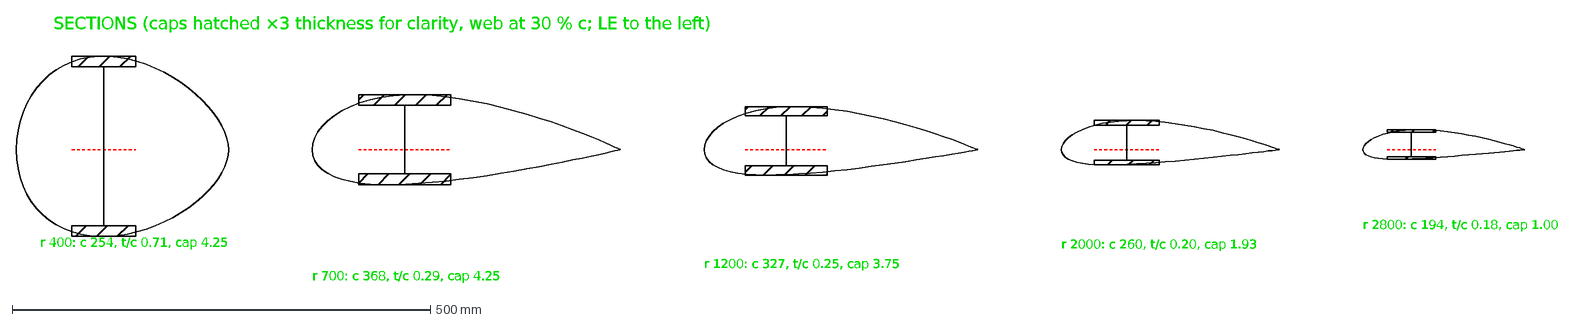
[picture p235: CAD file, 2026-11-06]
cad/turbine_6kw/out/dxf/NS6-101.dxf
r 400: c 254, t/c 0.71, cap 4.25
SECTIONS (caps hatched ×3 thickness for clarity, web at 30 % c; LE to the left)
r 700: c 368, t/c 0.29, cap 4.25
r 1200: c 327, t/c 0.25, cap 3.75
r 2000: c 260, t/c 0.20, cap 1.93
r 2800: c 194, t/c 0.18, cap 1.00
