safarcikm/Wind-turbines/cad/yaw/out/dxf/NY-430.dxf

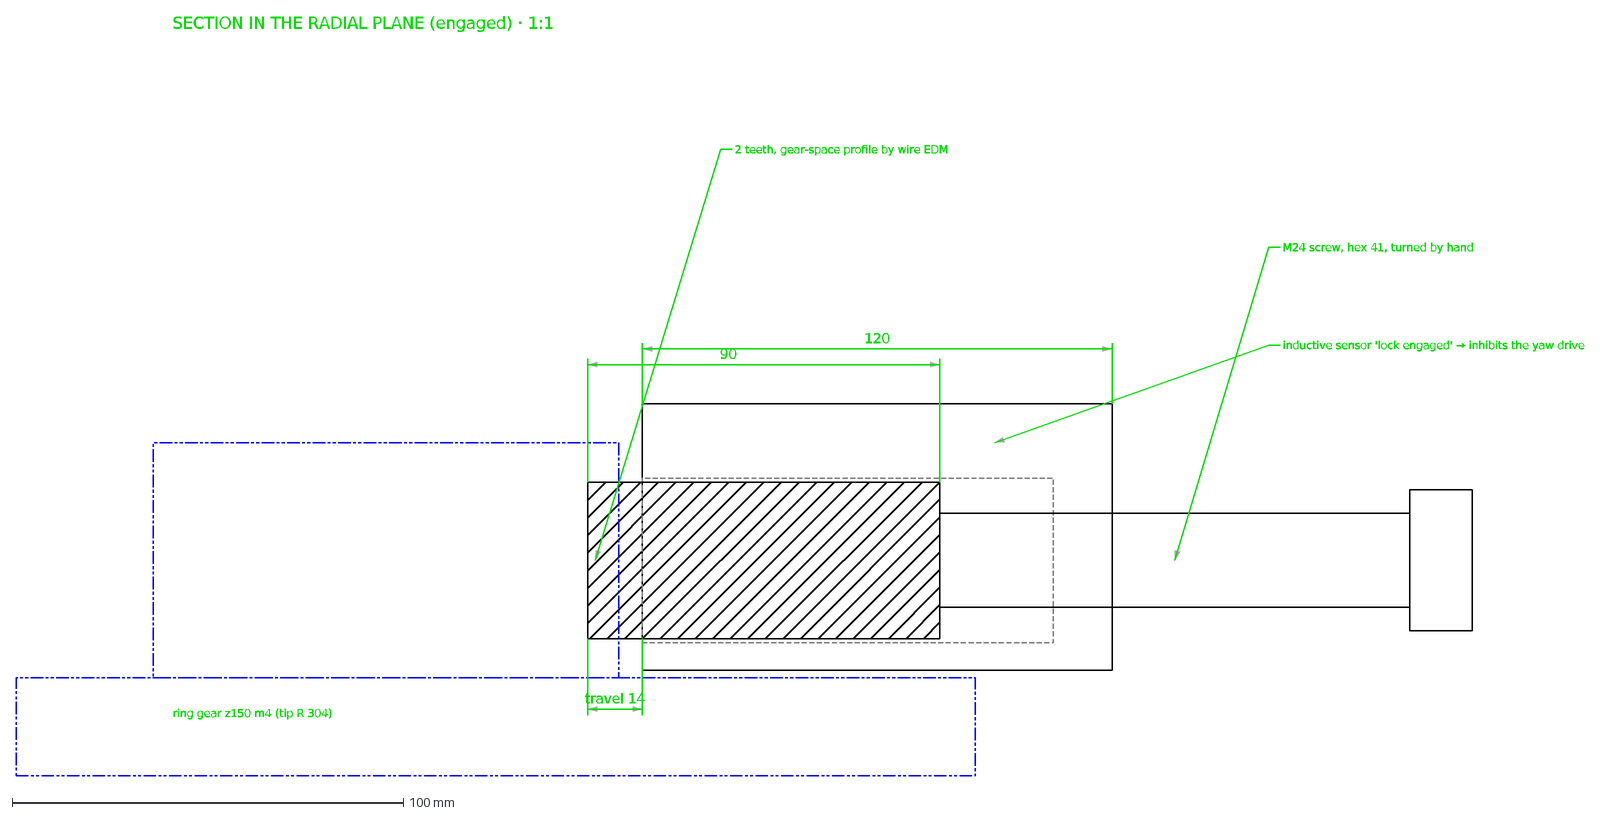
[picture p236: CAD file, 2026-11-05]
cad/yaw/out/dxf/NY-430.dxf
SECTION IN THE RADIAL PLANE (engaged) · 1:1
ring gear z150 m4 (tip R 304)
90
120
travel 14
2 teeth, gear-space profile by wire EDM
M24 screw, hex 41, turned by hand
inductive sensor 'lock engaged' → inhibits the yaw drive
