safarcikm/Wind-turbines/cad/generator_rc/out/dxf/NP1-210C.dxf

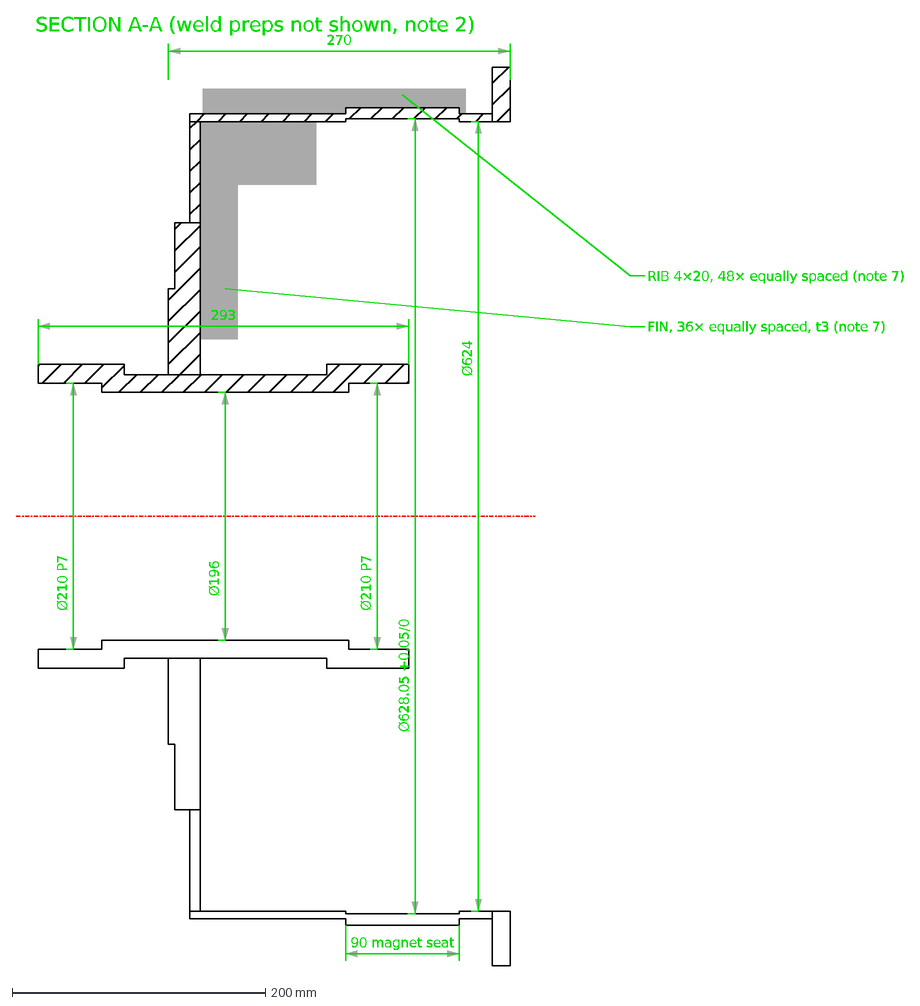
[picture p237: CAD file, 2026-11-05]
cad/generator_rc/out/dxf/NP1-210C.dxf
FIN, 36× equally spaced, t3 (note 7)
RIB 4×20, 48× equally spaced (note 7)
293
270
90 magnet seat
Ø210 P7
Ø196
Ø628.05 +0.05/0
Ø624
SECTION A-A (weld preps not shown, note 2)
