safarcikm/Wind-turbines/cad/nacelle_p1/out/dxf/NP1-620.dxf

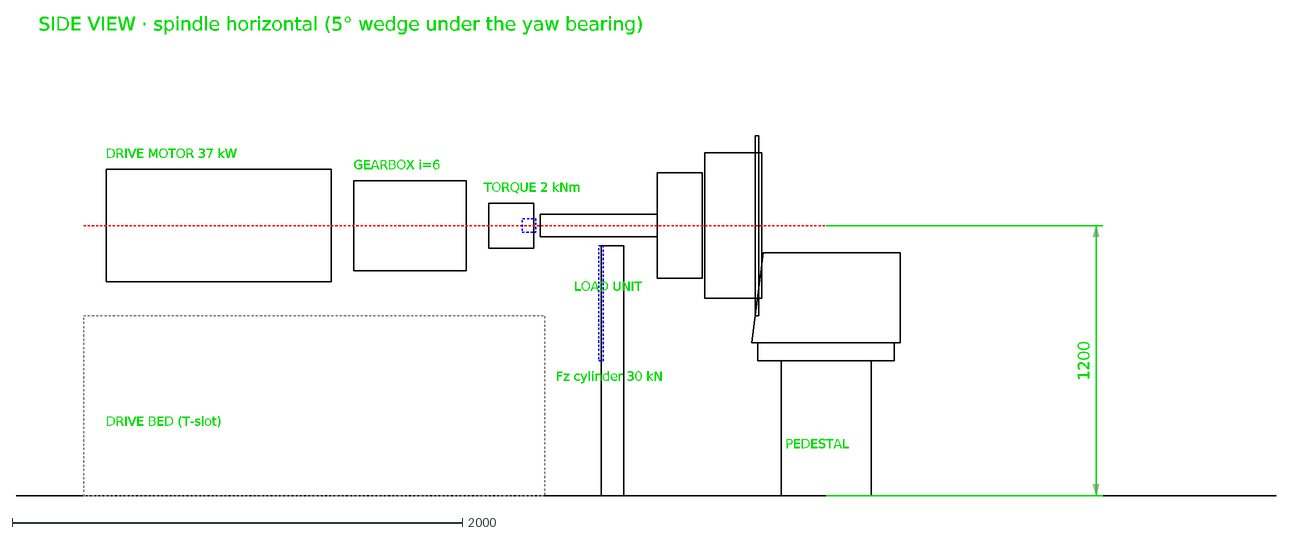
[picture p238: CAD file, 2026-11-03]
cad/nacelle_p1/out/dxf/NP1-620.dxf
PEDESTAL
LOAD UNIT
TORQUE 2 kNm
GEARBOX i=6
DRIVE MOTOR 37 kW
DRIVE BED (T-slot)
1200
Fz cylinder 30 kN
SIDE VIEW · spindle horizontal (5° wedge under the yaw bearing)
