safarcikm/Wind-turbines/cad/nacelle_w/out/step/NW-511-210_ball_filling_plug.step

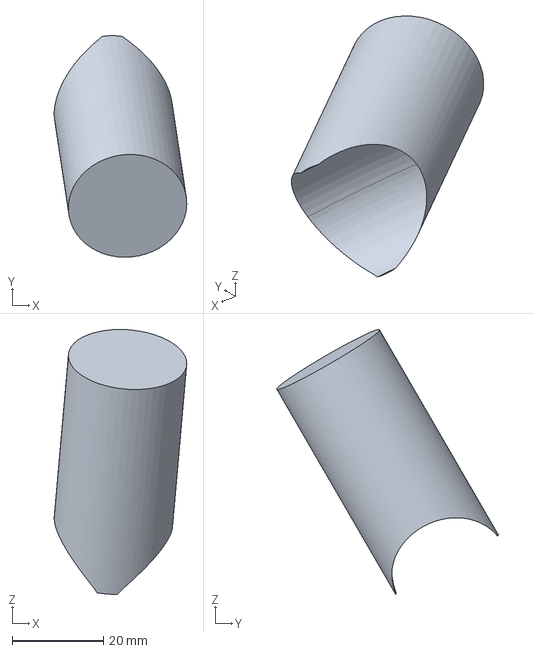
[picture p239: CAD file, 2026-11-03]
cad/nacelle_w/out/step/NW-511-210_ball_filling_plug.step
29.0 x 48.5 x 58.0 mm
