safarcikm/Wind-turbines/cad/generator_rc/out/dxf/NP1-203C.dxf

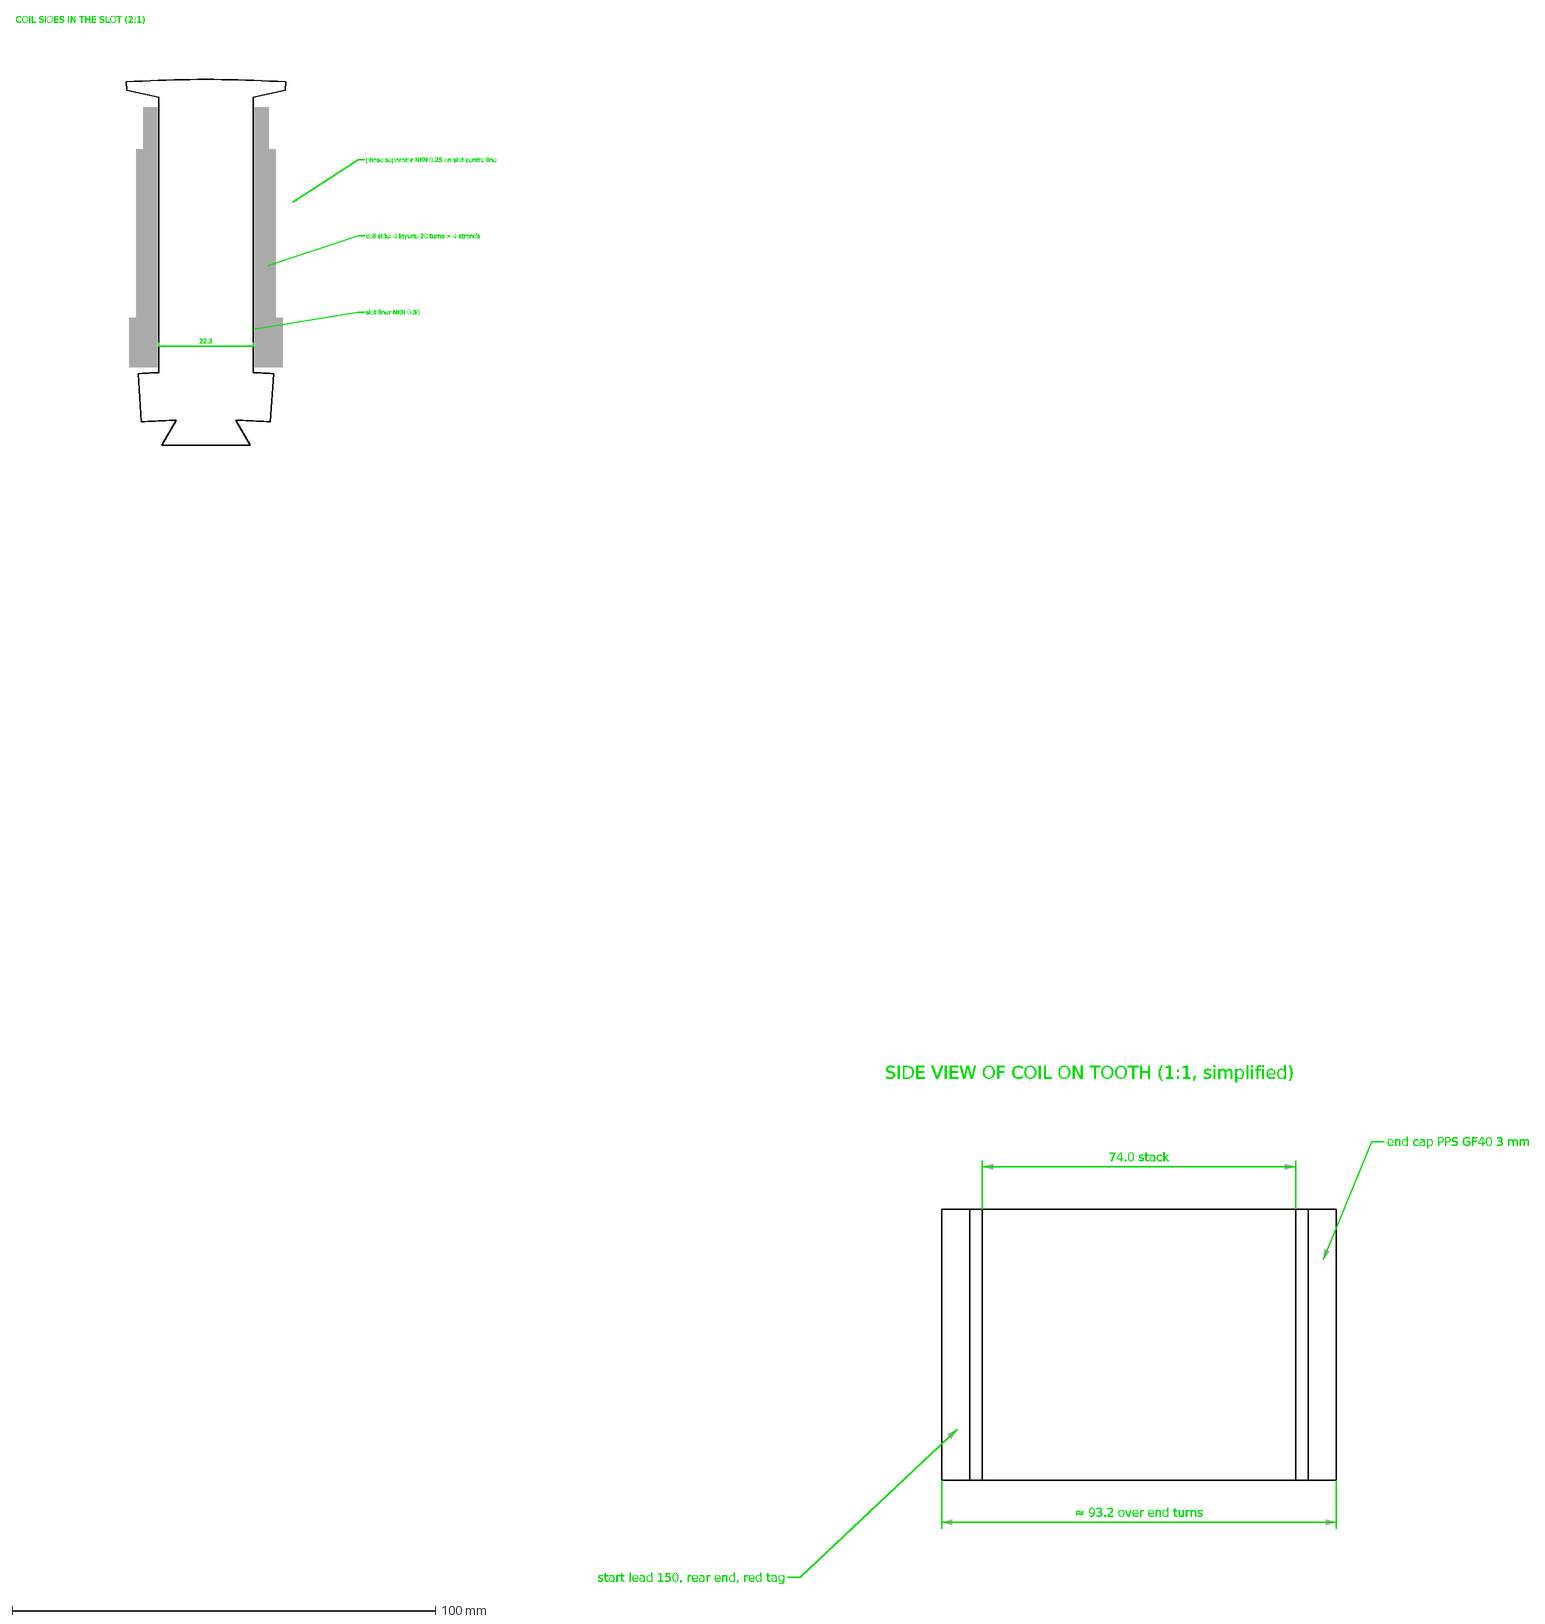
[picture p240: CAD file, 2026-11-05]
cad/generator_rc/out/dxf/NP1-203C.dxf
22.3
coil side: 4 layers, 28 turns × 4 strands
slot liner NKN 0.30
phase separator NKN 0.25 on slot centre line
COIL SIDES IN THE SLOT (2:1)
74.0 stack
≈ 93.2 over end turns
end cap PPS GF40 3 mm
start lead 150, rear end, red tag
SIDE VIEW OF COIL ON TOOTH (1:1, simplified)
