safarcikm/Wind-turbines/cad/nacelle_fitcheck/out/step/brake_caliper_left_envelope.step

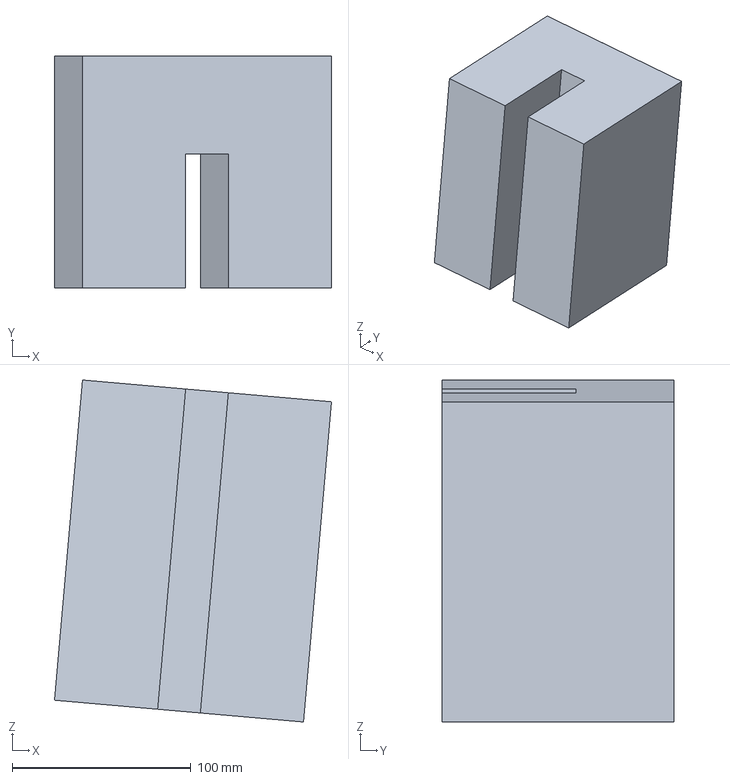
[picture p241: CAD file, 2026-11-03]
cad/nacelle_fitcheck/out/step/brake_caliper_left_envelope.step
155.2 x 130.0 x 191.5 mm
