safarcikm/Wind-turbines/cad/nacelle_w/out/step/NW-530-090_blade_root_stub.step

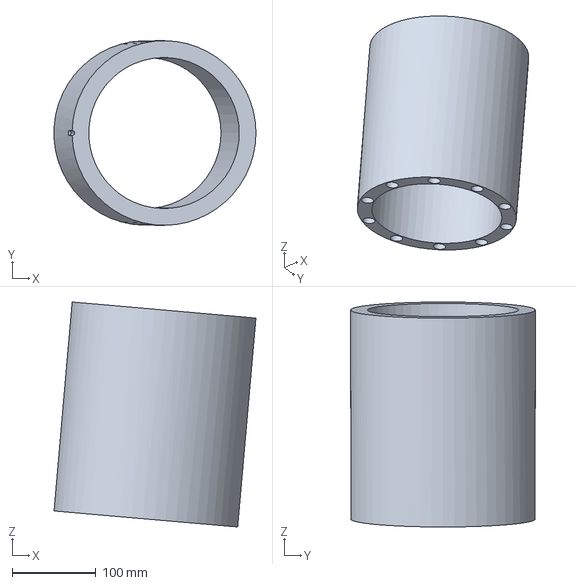
[picture p242: CAD file, 2026-11-03]
cad/nacelle_w/out/step/NW-530-090_blade_root_stub.step
240.7 x 220.0 x 268.2 mm
