safarcikm/Wind-turbines/cad/turbine_6kw/out/dxf/NS6-310.dxf

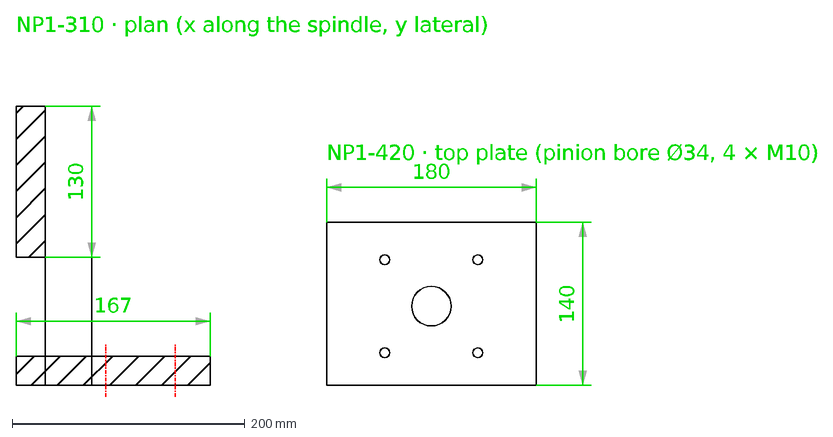
[picture p243: CAD file, 2026-11-06]
cad/turbine_6kw/out/dxf/NS6-310.dxf
167
130
NP1-310 · plan (x along the spindle, y lateral)
180
140
NP1-420 · top plate (pinion bore Ø34, 4 × M10)
