safarcikm/Wind-turbines/cad/yaw/out/dxf/NY-410.dxf

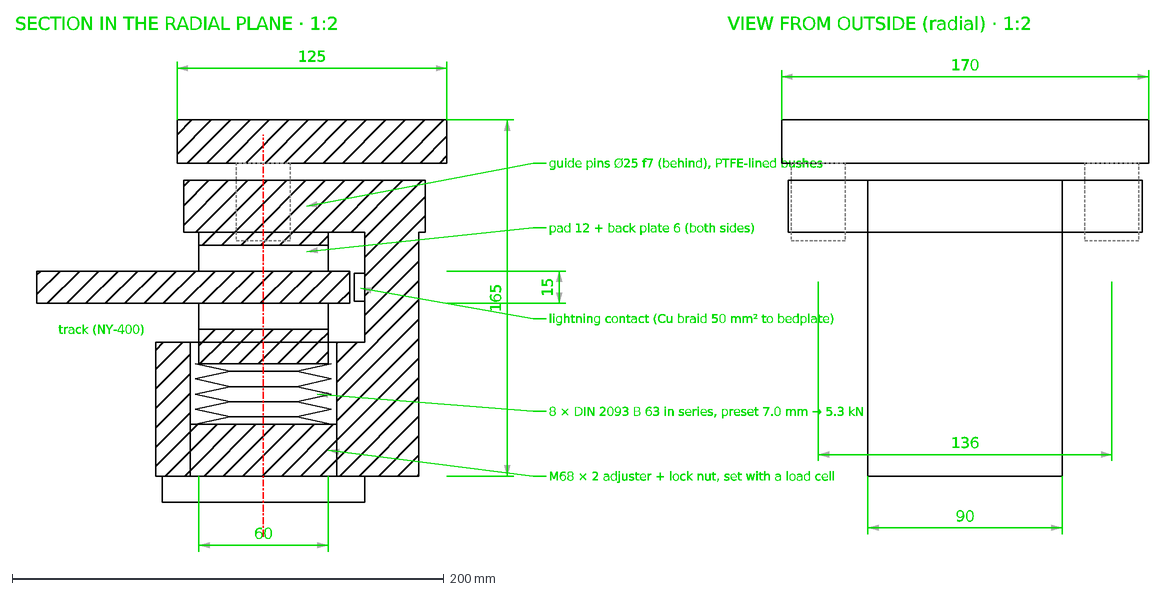
[picture p244: CAD file, 2026-11-05]
cad/yaw/out/dxf/NY-410.dxf
SECTION IN THE RADIAL PLANE · 1:2
track (NY-400)
125
60
165
15
8 × DIN 2093 B 63 in series, preset 7.0 mm → 5.3 kN
M68 × 2 adjuster + lock nut, set with a load cell
pad 12 + back plate 6 (both sides)
guide pins Ø25 f7 (behind), PTFE-lined bushes
lightning contact (Cu braid 50 mm² to bedplate)
VIEW FROM OUTSIDE (radial) · 1:2
170
136
90
