safarcikm/Wind-turbines/cad/nacelle_fitcheck/out/step/yaw_drive_left_envelope.step

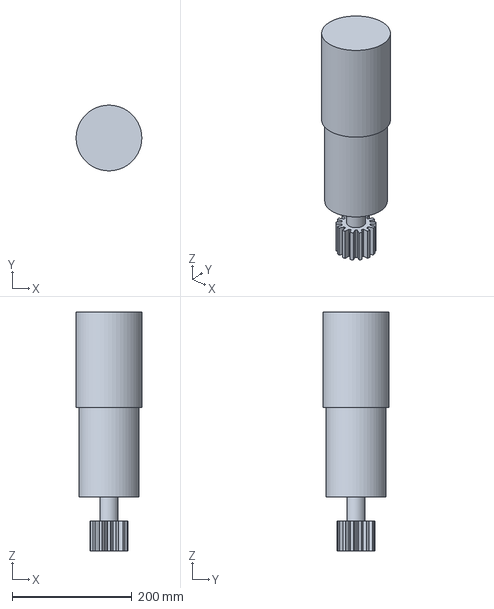
[picture p245: CAD file, 2026-11-03]
cad/nacelle_fitcheck/out/step/yaw_drive_left_envelope.step
109.9 x 109.9 x 400.0 mm
