safarcikm/Wind-turbines/cad/nacelle_p1/out/dxf/NP1-200.dxf

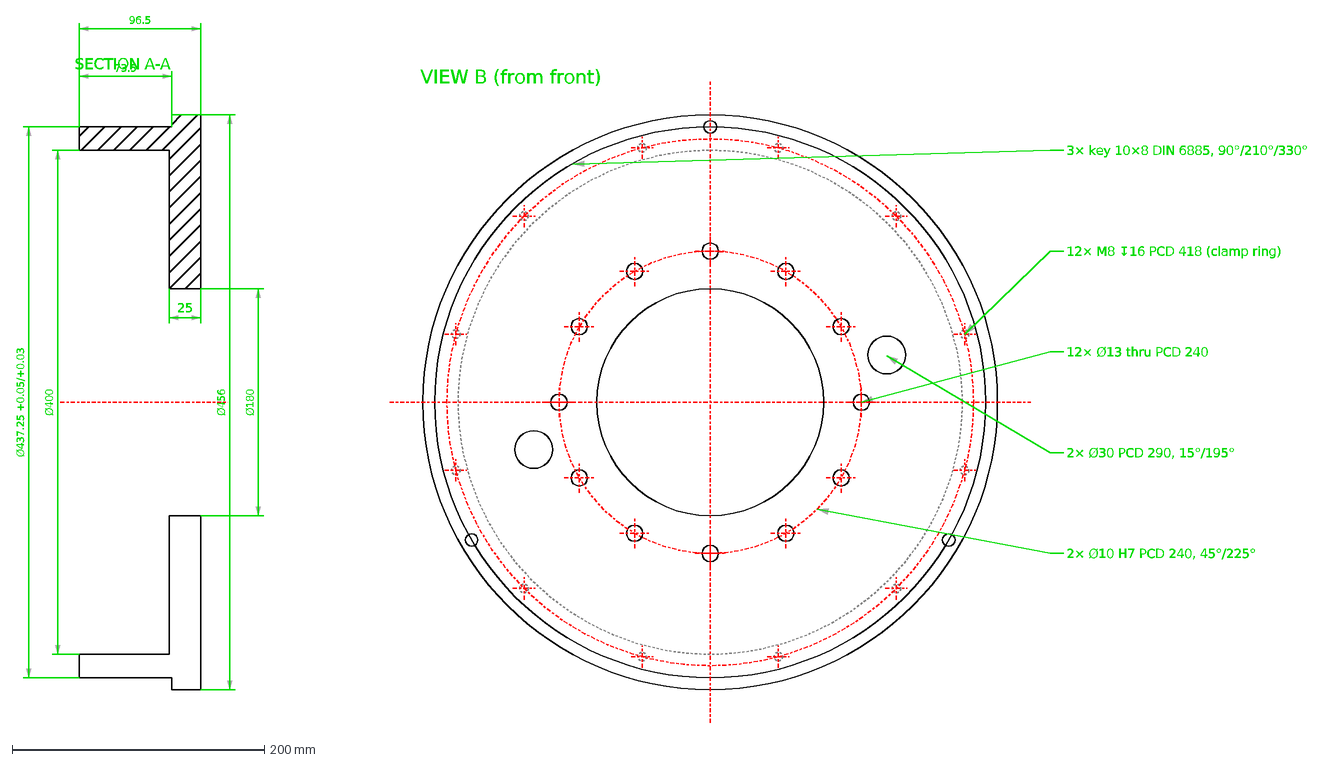
[picture p246: CAD file, 2026-11-03]
cad/nacelle_p1/out/dxf/NP1-200.dxf
73.5
96.5
25
Ø180
Ø437.25 +0.05/+0.03
Ø456
Ø400
SECTION A-A
12× Ø13 thru PCD 240
12× M8 ↧16 PCD 418 (clamp ring)
2× Ø30 PCD 290, 15°/195°
3× key 10×8 DIN 6885, 90°/210°/330°
2× Ø10 H7 PCD 240, 45°/225°
VIEW B (from front)
