safarcikm/Wind-turbines/cad/nacelle_w/out/step/NW-510-210_pitch_bearing_inner_ring.step

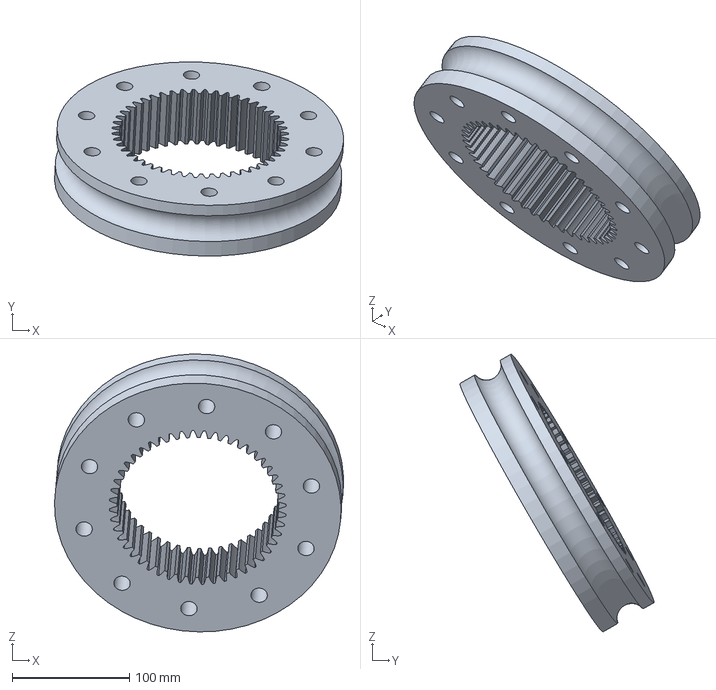
[picture p247: CAD file, 2026-11-03]
cad/nacelle_w/out/step/NW-510-210_pitch_bearing_inner_ring.step
246.8 x 165.8 x 237.2 mm
