safarcikm/Wind-turbines/cad/turbine_6kw/out/dxf/NS6-410.dxf

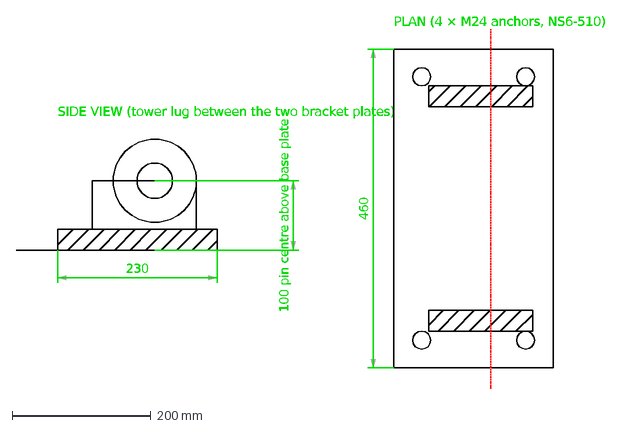
[picture p248: CAD file, 2026-11-06]
cad/turbine_6kw/out/dxf/NS6-410.dxf
230
100 pin centre above base plate
SIDE VIEW (tower lug between the two bracket plates)
460
PLAN (4 × M24 anchors, NS6-510)
