safarcikm/Wind-turbines/cad/nacelle_fitcheck/out/step/NP1-400_tower_top_adapter.step

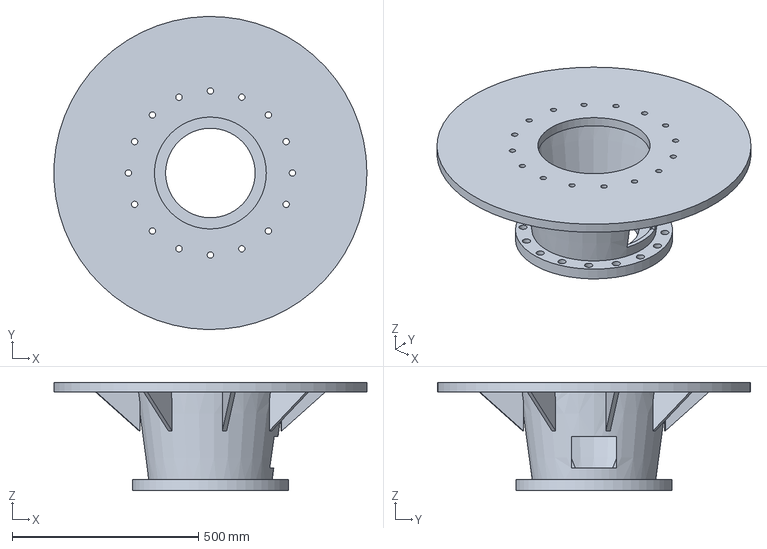
[picture p249: CAD file, 2026-11-03]
cad/nacelle_fitcheck/out/step/NP1-400_tower_top_adapter.step
839.4 x 839.7 x 290.0 mm
