safarcikm/Wind-turbines/cad/nacelle_p1/out/dxf/NP1-000.dxf

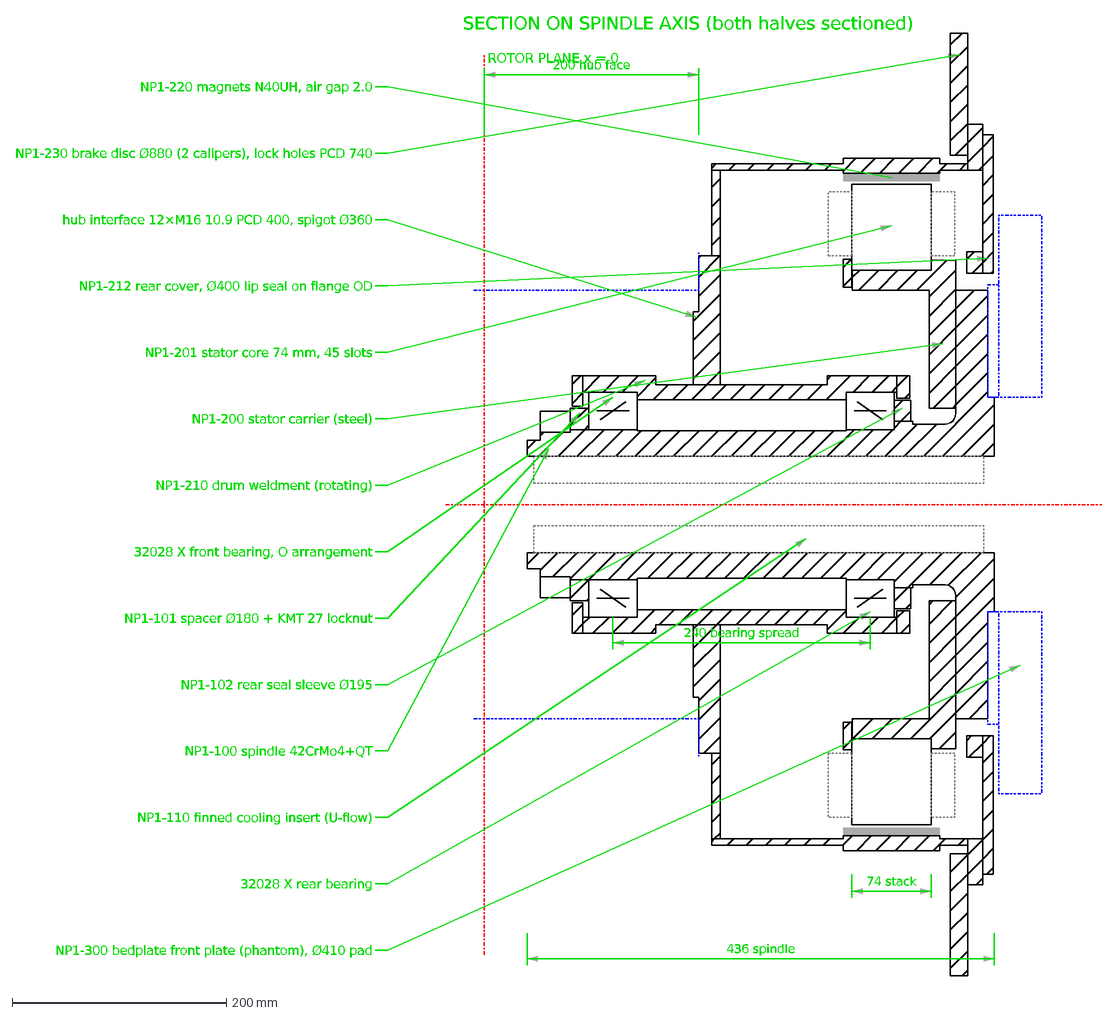
[picture p250: CAD file, 2026-11-03]
cad/nacelle_p1/out/dxf/NP1-000.dxf
ROTOR PLANE x = 0
NP1-220 magnets N40UH, air gap 2.0
NP1-230 brake disc Ø880 (2 calipers), lock holes PCD 740
hub interface 12×M16 10.9 PCD 400, spigot Ø360
NP1-212 rear cover, Ø400 lip seal on flange OD
NP1-201 stator core 74 mm, 45 slots
NP1-200 stator carrier (steel)
NP1-210 drum weldment (rotating)
32028 X front bearing, O arrangement
NP1-101 spacer Ø180 + KMT 27 locknut
NP1-102 rear seal sleeve Ø195
NP1-100 spindle 42CrMo4+QT
NP1-110 finned cooling insert (U-flow)
32028 X rear bearing
NP1-300 bedplate front plate (phantom), Ø410 pad
240 bearing spread
200 hub face
74 stack
436 spindle
SECTION ON SPINDLE AXIS (both halves sectioned)
