safarcikm/Wind-turbines/cad/nacelle_w/out/step/hub_electronics_030_envelope.step

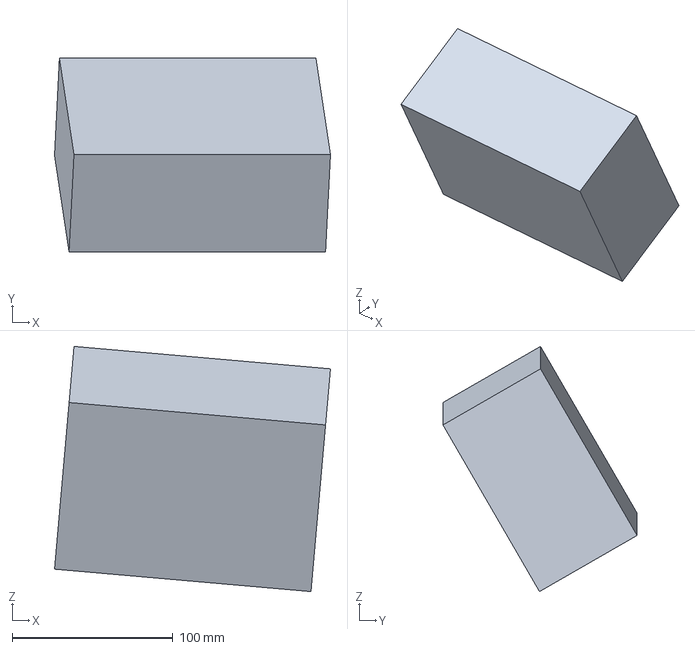
[picture p251: CAD file, 2026-11-03]
cad/nacelle_w/out/step/hub_electronics_030_envelope.step
171.5 x 120.6 x 152.3 mm
