safarcikm/Wind-turbines/cad/nacelle_fitcheck/out/step/NP1-220_magnet_ring.step

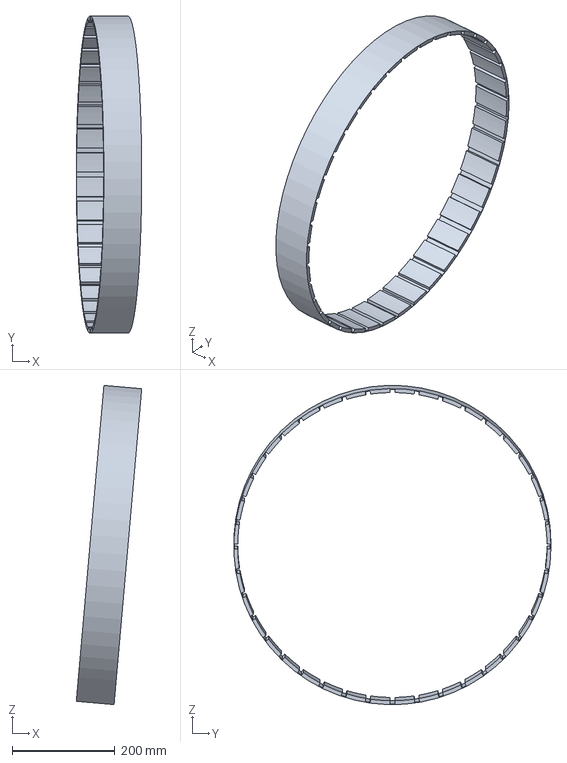
[picture p252: CAD file, 2026-11-03]
cad/nacelle_fitcheck/out/step/NP1-220_magnet_ring.step
127.6 x 618.0 x 622.3 mm
