safarcikm/Wind-turbines/cad/nacelle_w/out/step/pitch_encoder_330_envelope.step

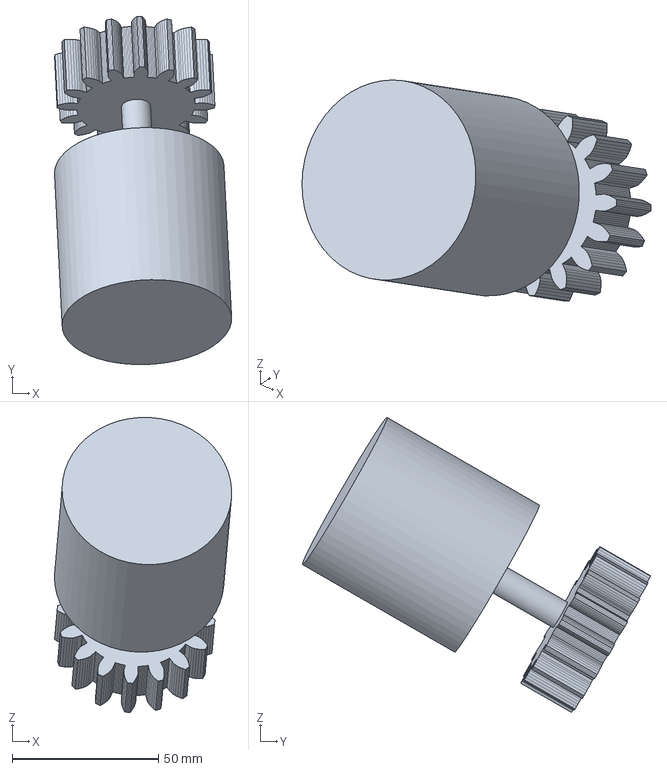
[picture p253: CAD file, 2026-11-03]
cad/nacelle_w/out/step/pitch_encoder_330_envelope.step
60.5 x 118.9 x 100.8 mm
