safarcikm/Wind-turbines/cad/turbine_6kw/out/dxf/NS6-300.dxf

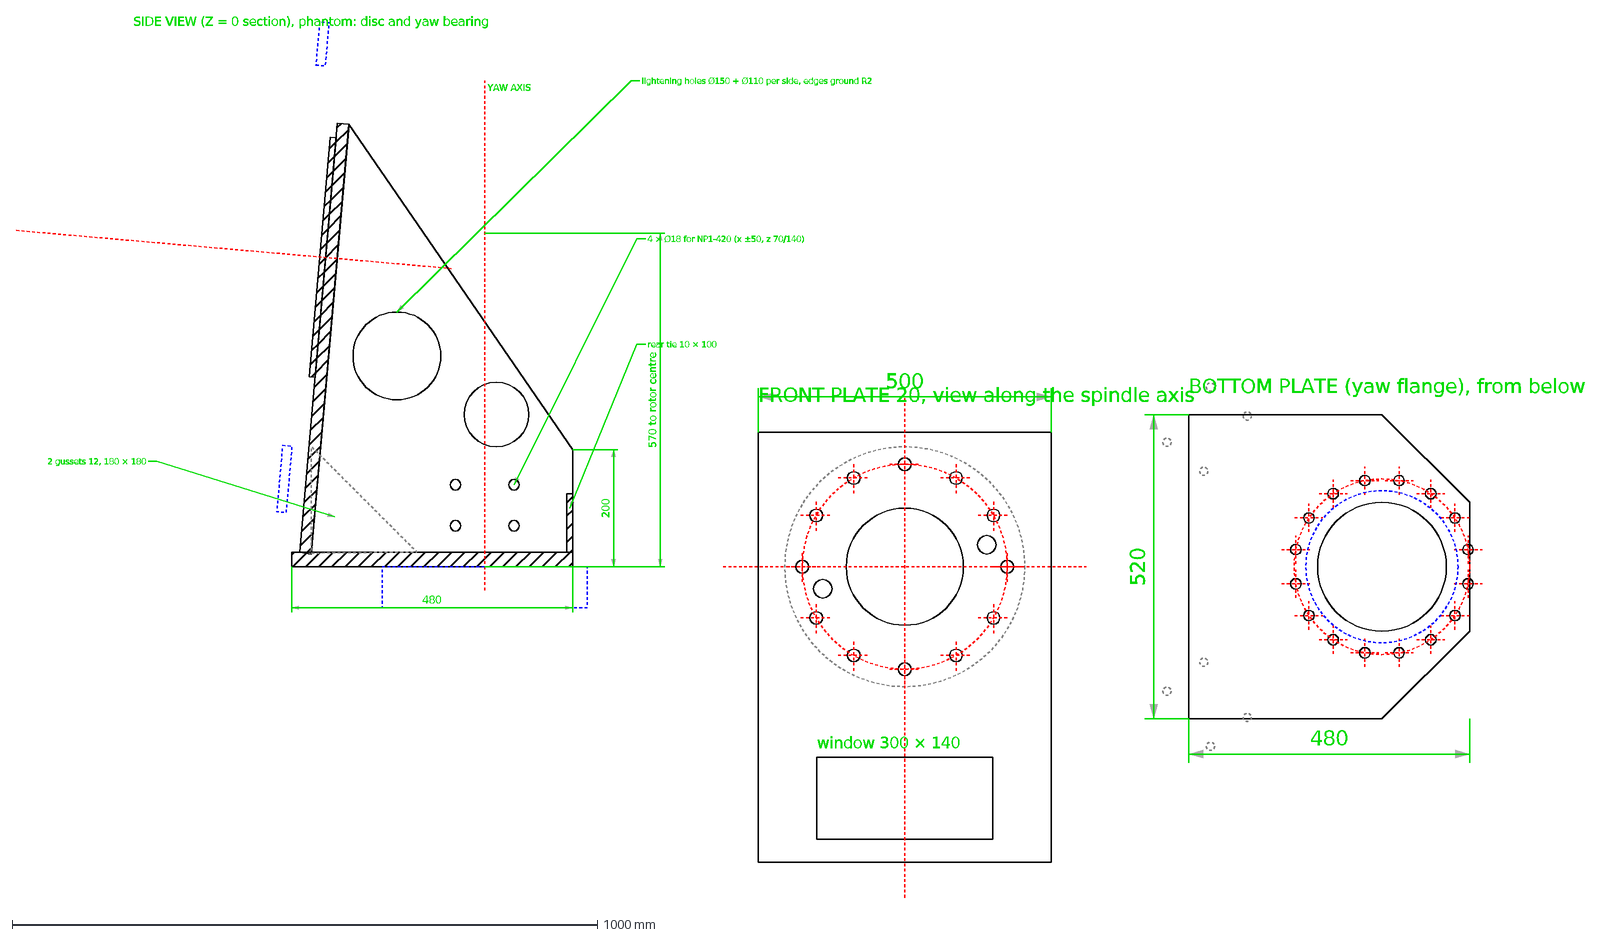
[picture p254: CAD file, 2026-11-06]
cad/turbine_6kw/out/dxf/NS6-300.dxf
YAW AXIS
480
570 to rotor centre
200
lightening holes Ø150 + Ø110 per side, edges ground R2
4 × Ø18 for NP1-420 (x ±50, z 70/140)
rear tie 10 × 100
2 gussets 12, 180 × 180
SIDE VIEW (Z = 0 section), phantom: disc and yaw bearing
500
FRONT PLATE 20, view along the spindle axis
window 300 × 140
520
BOTTOM PLATE (yaw flange), from below
