safarcikm/Wind-turbines/cad/nacelle_fitcheck/out/step/overspeed_sensor_075_envelope.step

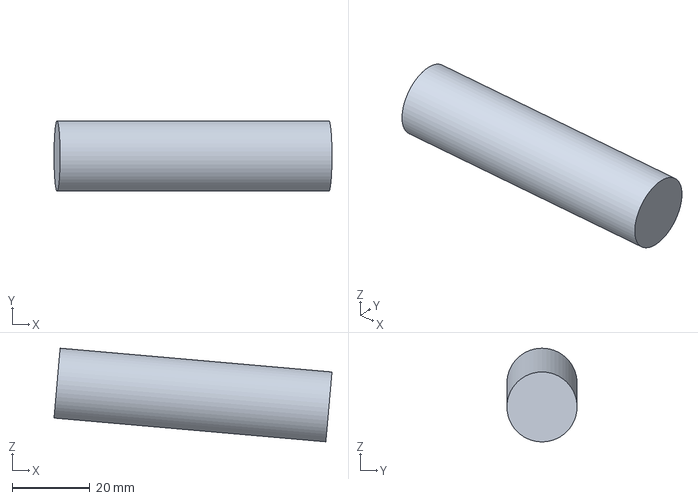
[picture p256: CAD file, 2026-11-03]
cad/nacelle_fitcheck/out/step/overspeed_sensor_075_envelope.step
71.3 x 18.0 x 24.0 mm
