safarcikm/Wind-turbines/cad/nacelle_p1/out/dxf/NP1-101.dxf

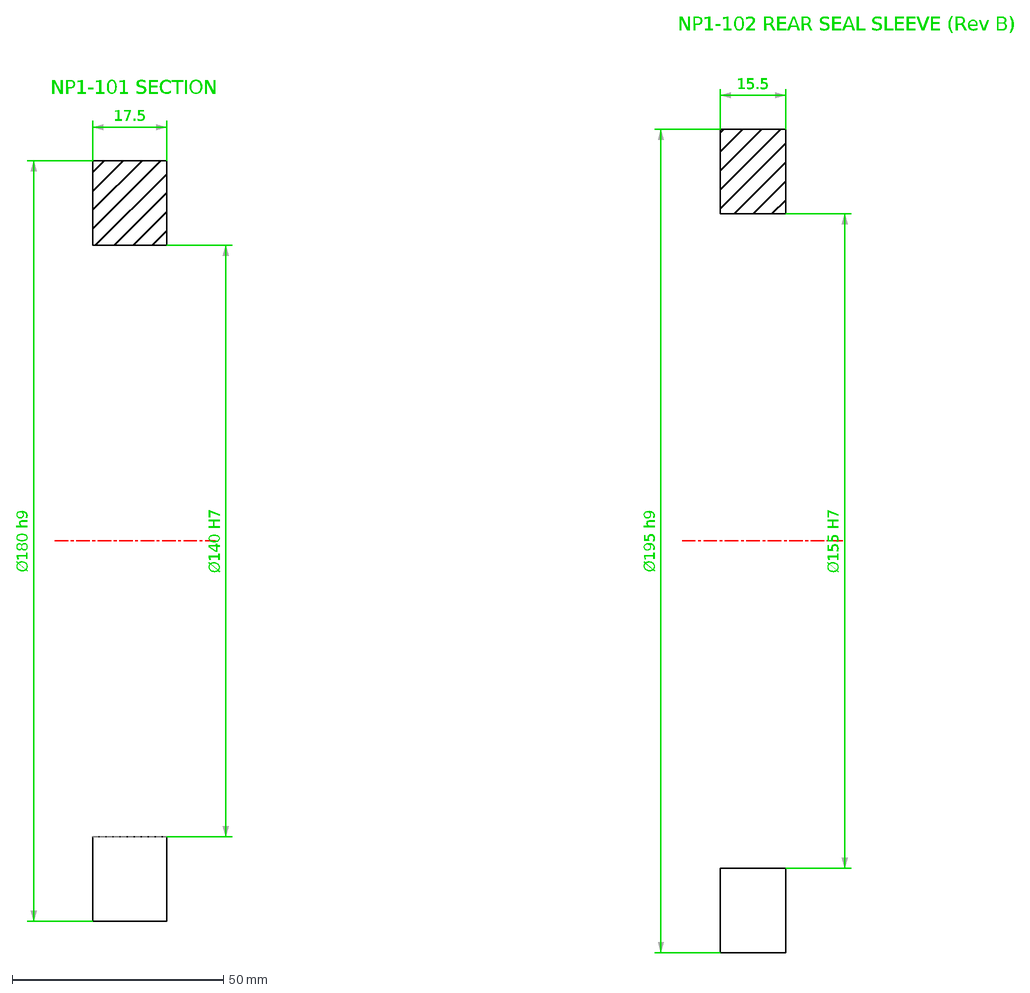
[picture p257: CAD file, 2026-11-03]
cad/nacelle_p1/out/dxf/NP1-101.dxf
17.5
Ø140 H7
Ø180 h9
NP1-101 SECTION
15.5
Ø155 H7
Ø195 h9
NP1-102 REAR SEAL SLEEVE (Rev B)
