safarcikm/Wind-turbines/cad/nacelle_w/out/step/hub_electronics_270_envelope.step

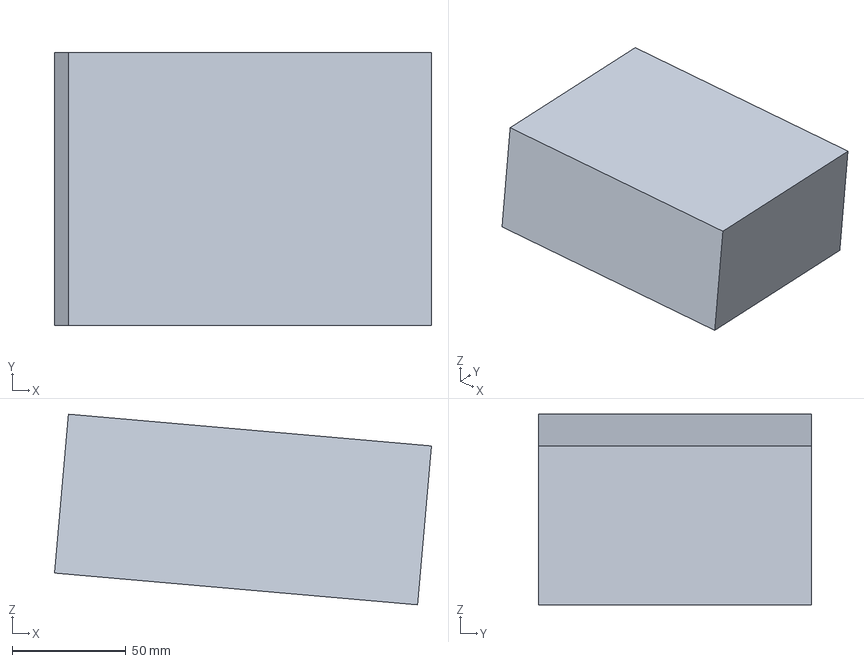
[picture p258: CAD file, 2026-11-03]
cad/nacelle_w/out/step/hub_electronics_270_envelope.step
165.5 x 120.0 x 83.7 mm
