safarcikm/Wind-turbines/cad/turbine_6kw/out/dxf/NS6-420.dxf

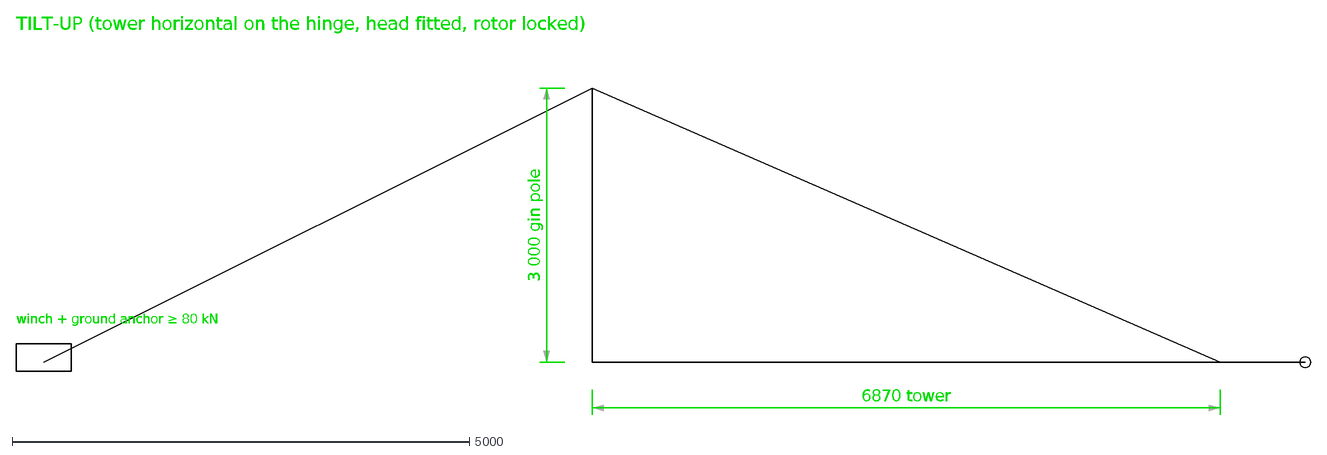
[picture p259: CAD file, 2026-11-06]
cad/turbine_6kw/out/dxf/NS6-420.dxf
winch + ground anchor ≥ 80 kN
6870 tower
3 000 gin pole
TILT-UP (tower horizontal on the hinge, head fitted, rotor locked)
