safarcikm/Wind-turbines/cad/generator_rc/out/dxf/NP1-G00.dxf

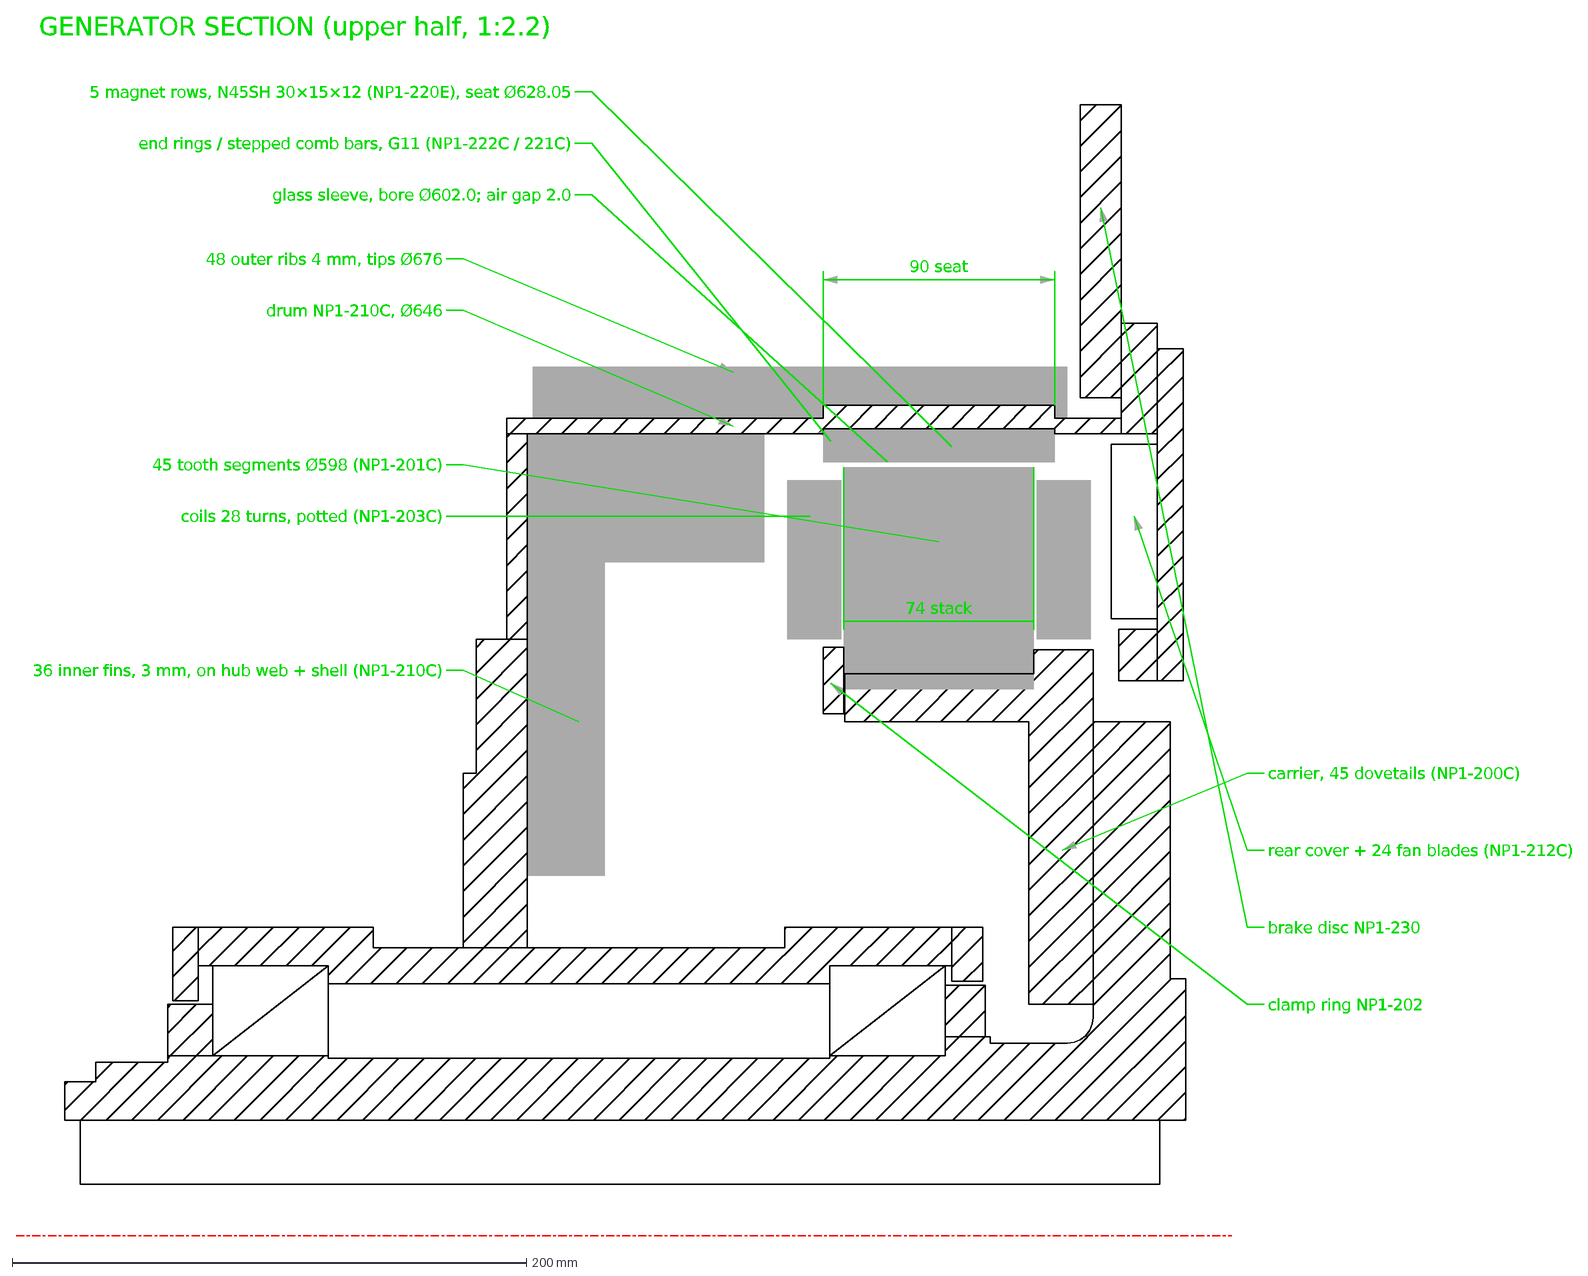
[picture p260: CAD file, 2026-11-05]
cad/generator_rc/out/dxf/NP1-G00.dxf
74 stack
90 seat
5 magnet rows, N45SH 30×15×12 (NP1-220E), seat Ø628.05
end rings / stepped comb bars, G11 (NP1-222C / 221C)
glass sleeve, bore Ø602.0; air gap 2.0
45 tooth segments Ø598 (NP1-201C)
coils 28 turns, potted (NP1-203C)
drum NP1-210C, Ø646
carrier, 45 dovetails (NP1-200C)
rear cover + 24 fan blades (NP1-212C)
brake disc NP1-230
36 inner fins, 3 mm, on hub web + shell (NP1-210C)
48 outer ribs 4 mm, tips Ø676
clamp ring NP1-202
GENERATOR SECTION (upper half, 1:2.2)
