safarcikm/Wind-turbines/cad/nacelle_fitcheck/out/step/NP1-320_lock_pin.step

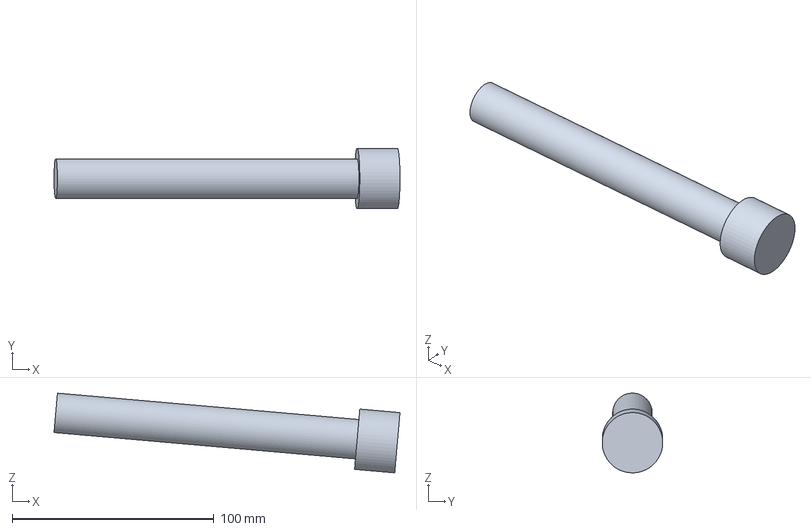
[picture p261: CAD file, 2026-11-03]
cad/nacelle_fitcheck/out/step/NP1-320_lock_pin.step
171.5 x 30.0 x 39.5 mm
