safarcikm/Wind-turbines/cad/nacelle_p1/out/dxf/NP1-320.dxf

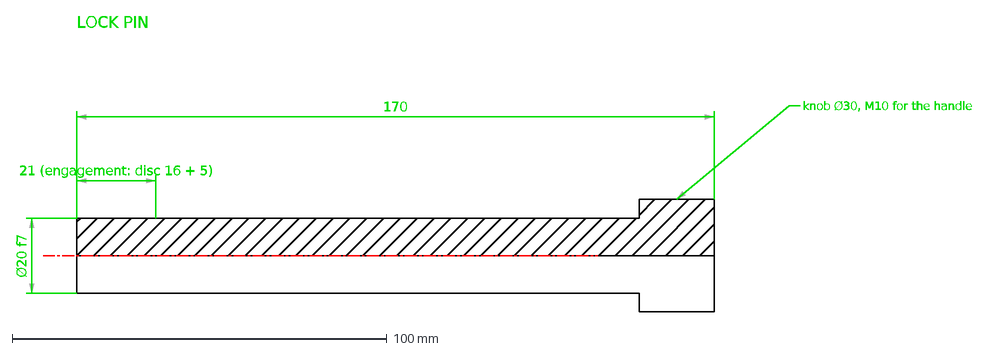
[picture p262: CAD file, 2026-11-03]
cad/nacelle_p1/out/dxf/NP1-320.dxf
21 (engagement: disc 16 + 5)
Ø20 f7
170
knob Ø30, M10 for the handle
LOCK PIN
