safarcikm/Wind-turbines/cad/nacelle_w/out/step/NW-500_hub.step

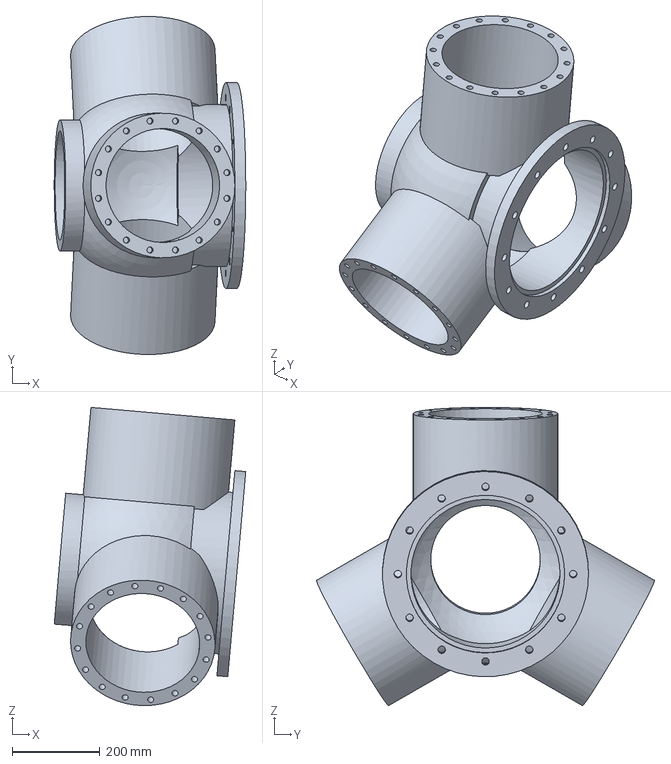
[picture p263: CAD file, 2026-11-03]
cad/nacelle_w/out/step/NW-500_hub.step
437.0 x 771.1 x 680.4 mm
