safarcikm/Wind-turbines/cad/turbine_6kw/out/dxf/NS6-600.dxf

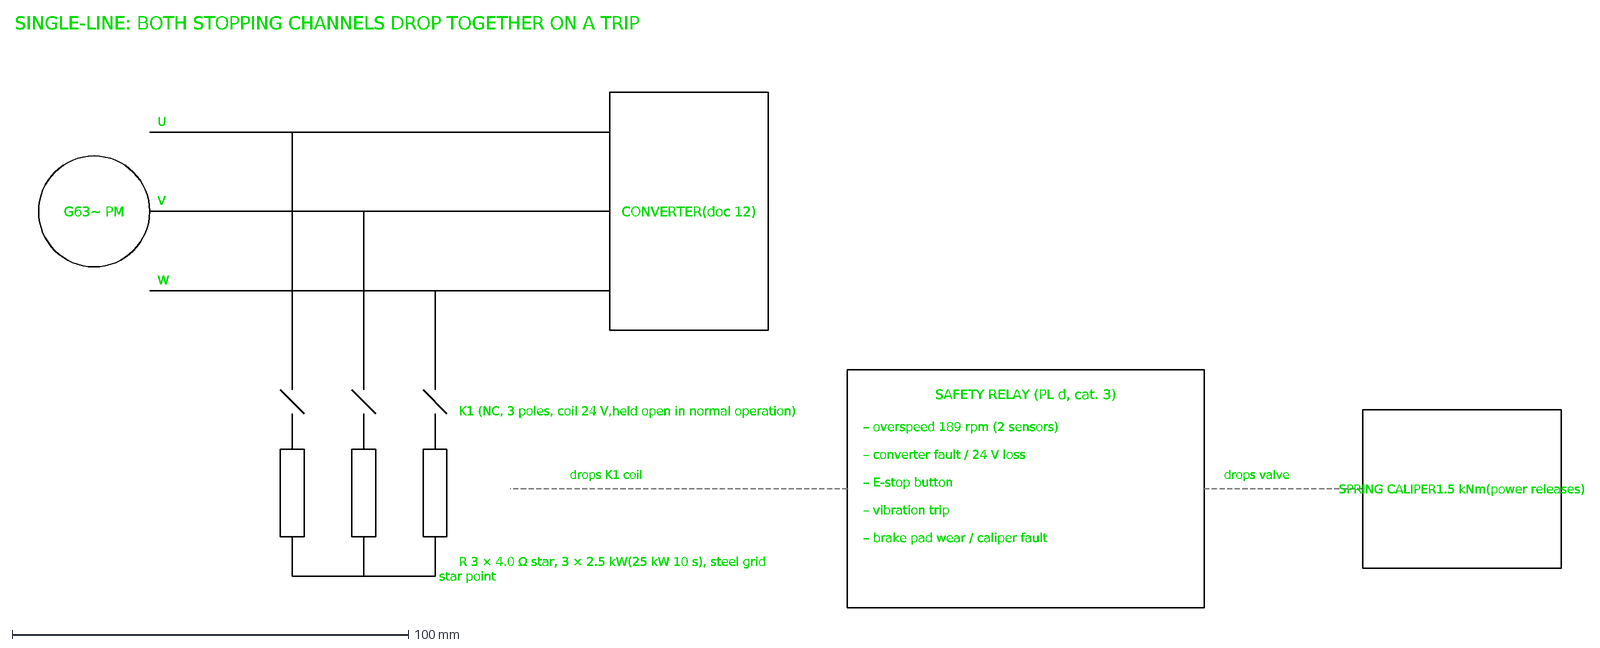
[picture p264: CAD file, 2026-11-06]
cad/turbine_6kw/out/dxf/NS6-600.dxf
G63~ PM
U
V
W
CONVERTER(doc 12)
star point
K1 (NC, 3 poles, coil 24 V,held open in normal operation)
R 3 × 4.0 Ω star, 3 × 2.5 kW(25 kW 10 s), steel grid
SAFETY RELAY (PL d, cat. 3)
– overspeed 189 rpm (2 sensors)
– converter fault / 24 V loss
– E-stop button
– vibration trip
– brake pad wear / caliper fault
drops K1 coil
drops valve
SPRING CALIPER1.5 kNm(power releases)
SINGLE-LINE: BOTH STOPPING CHANNELS DROP TOGETHER ON A TRIP
