safarcikm/Wind-turbines/cad/nacelle_fitcheck/out/step/NP1-100_spindle.step

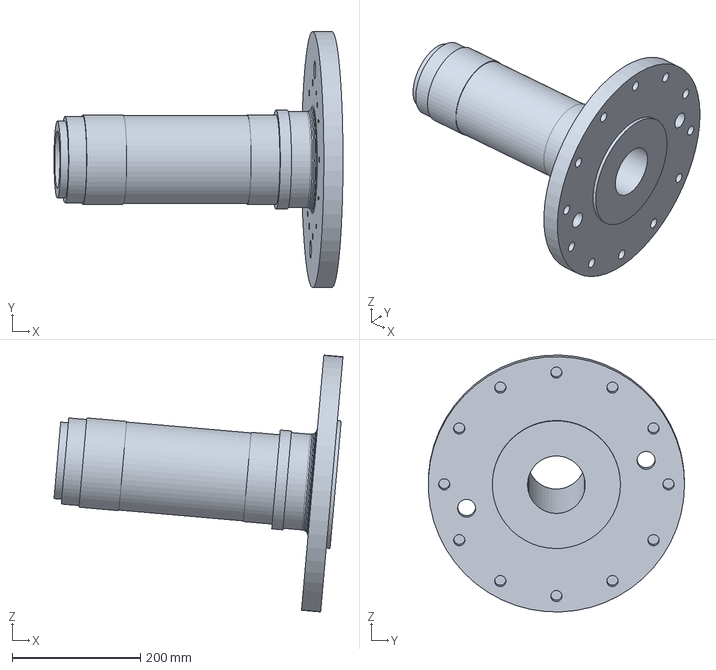
[picture p265: CAD file, 2026-11-03]
cad/nacelle_fitcheck/out/step/NP1-100_spindle.step
451.0 x 399.6 x 400.9 mm
