safarcikm/Wind-turbines/cad/nacelle_p1/out/dxf/NP1-230.dxf

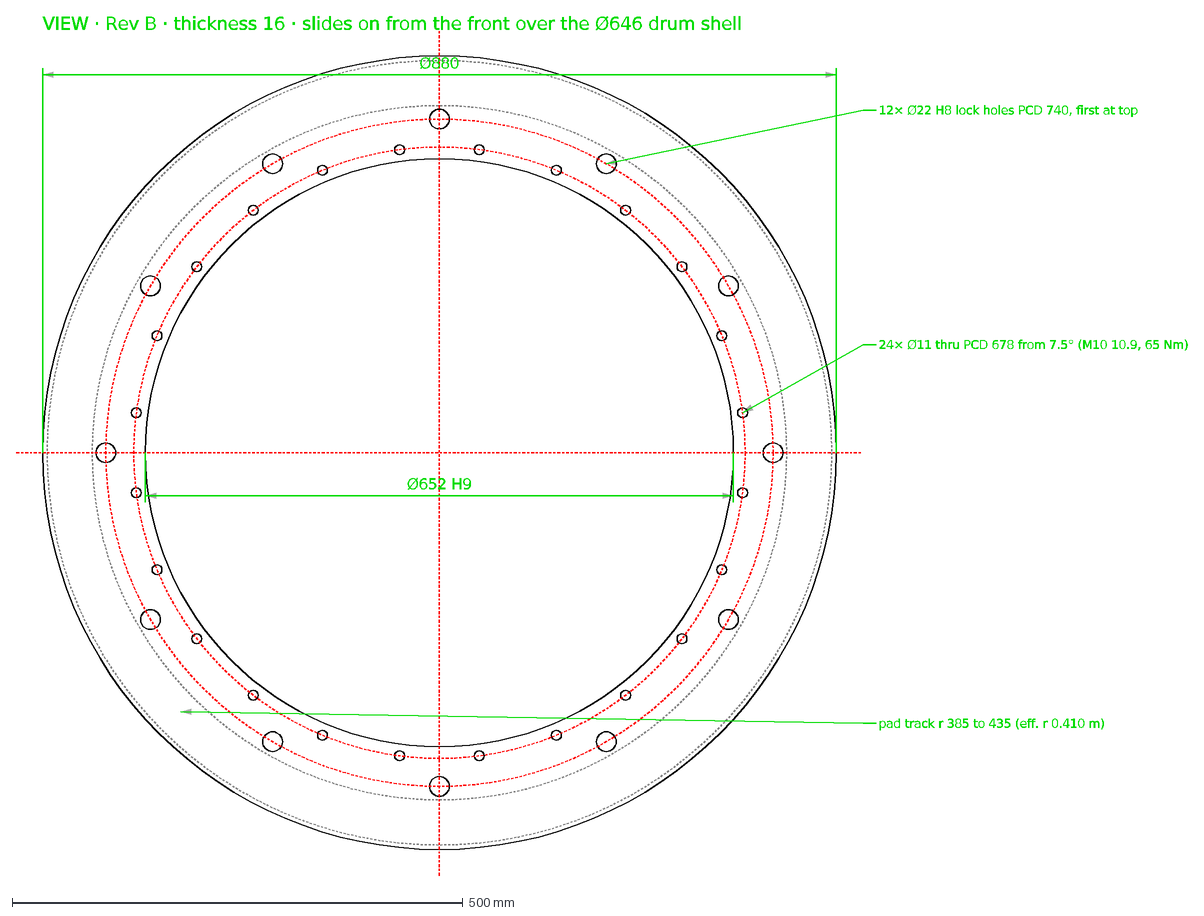
[picture p266: CAD file, 2026-11-03]
cad/nacelle_p1/out/dxf/NP1-230.dxf
Ø880
Ø652 H9
24× Ø11 thru PCD 678 from 7.5° (M10 10.9, 65 Nm)
12× Ø22 H8 lock holes PCD 740, first at top
pad track r 385 to 435 (eff. r 0.410 m)
VIEW · Rev B · thickness 16 · slides on from the front over the Ø646 drum shell
