safarcikm/Wind-turbines/cad/nacelle_w/out/step/pitch_drive_330_envelope.step

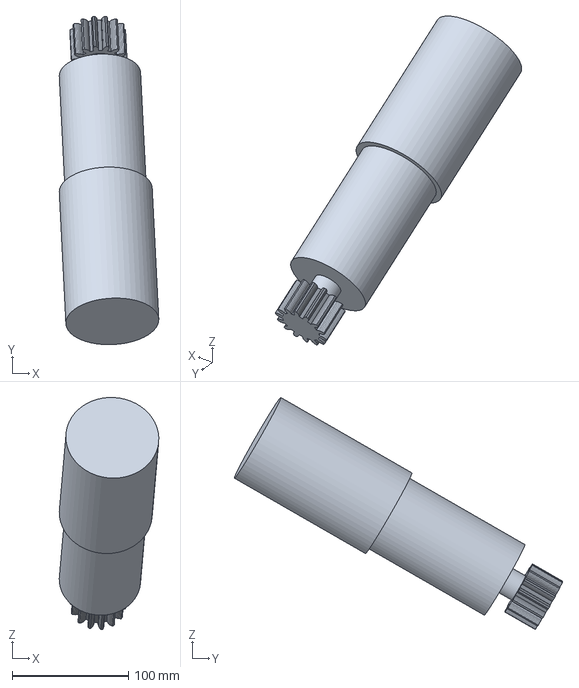
[picture p267: CAD file, 2026-11-03]
cad/nacelle_w/out/step/pitch_drive_330_envelope.step
85.6 x 282.1 x 199.3 mm
