safarcikm/Wind-turbines/cad/turbine_6kw/out/dxf/NS6-010.dxf

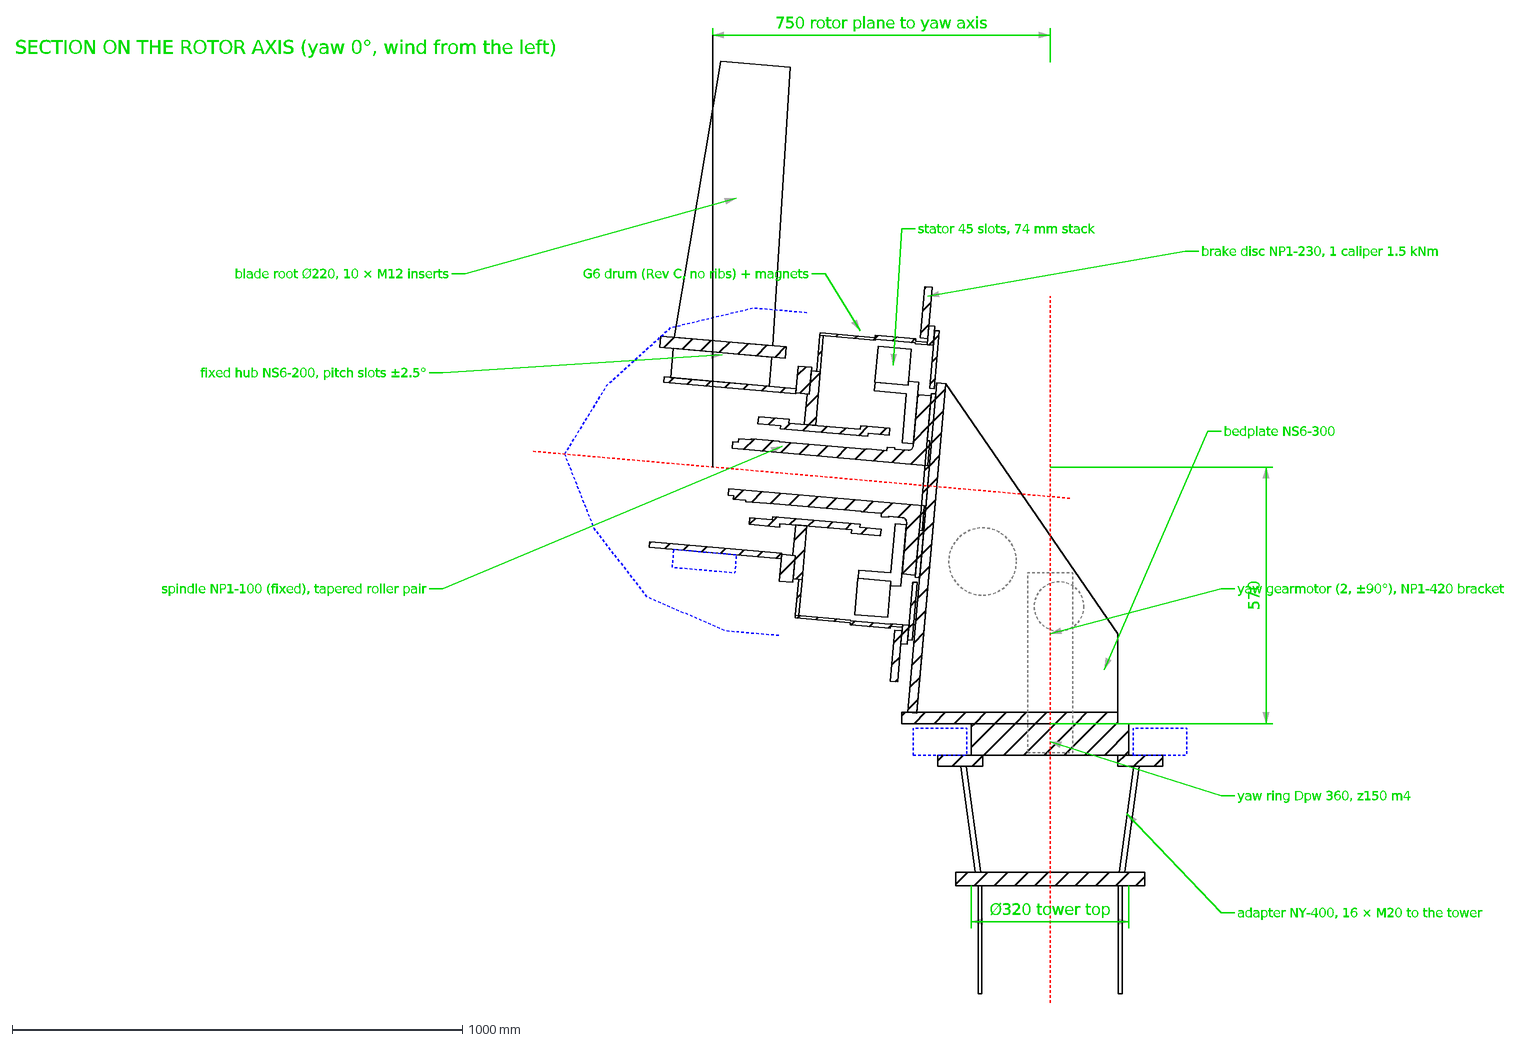
[picture p268: CAD file, 2026-11-06]
cad/turbine_6kw/out/dxf/NS6-010.dxf
750 rotor plane to yaw axis
570
Ø320 tower top
G6 drum (Rev C, no ribs) + magnets
stator 45 slots, 74 mm stack
brake disc NP1-230, 1 caliper 1.5 kNm
blade root Ø220, 10 × M12 inserts
fixed hub NS6-200, pitch slots ±2.5°
spindle NP1-100 (fixed), tapered roller pair
bedplate NS6-300
yaw ring Dpw 360, z150 m4
yaw gearmotor (2, ±90°), NP1-420 bracket
adapter NY-400, 16 × M20 to the tower
SECTION ON THE ROTOR AXIS (yaw 0°, wind from the left)
