safarcikm/Wind-turbines/cad/nacelle_fitcheck/out/step/NP1-202_stator_clamp_ring.step

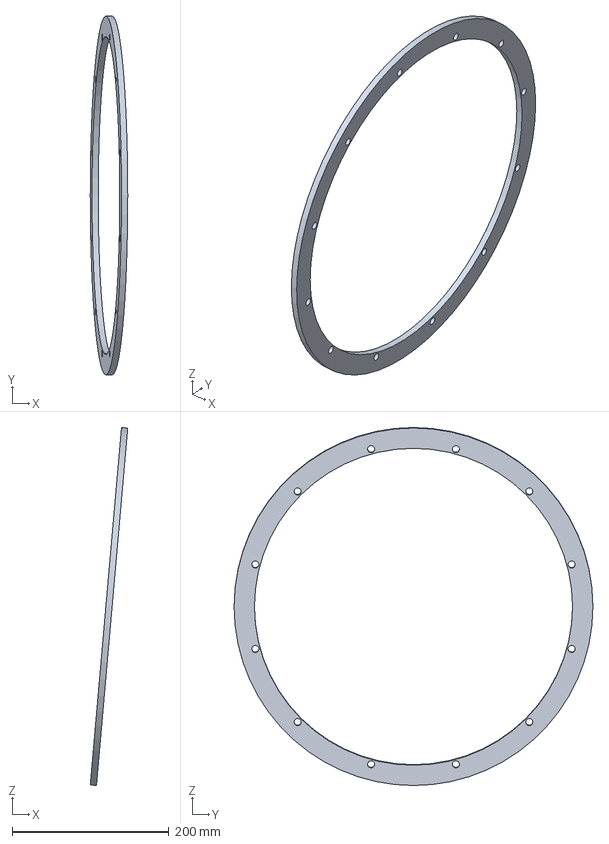
[picture p269: CAD file, 2026-11-03]
cad/nacelle_fitcheck/out/step/NP1-202_stator_clamp_ring.step
47.9 x 458.0 x 457.0 mm
