safarcikm/Wind-turbines/cad/nacelle_p1/out/dxf/NP1-202.dxf

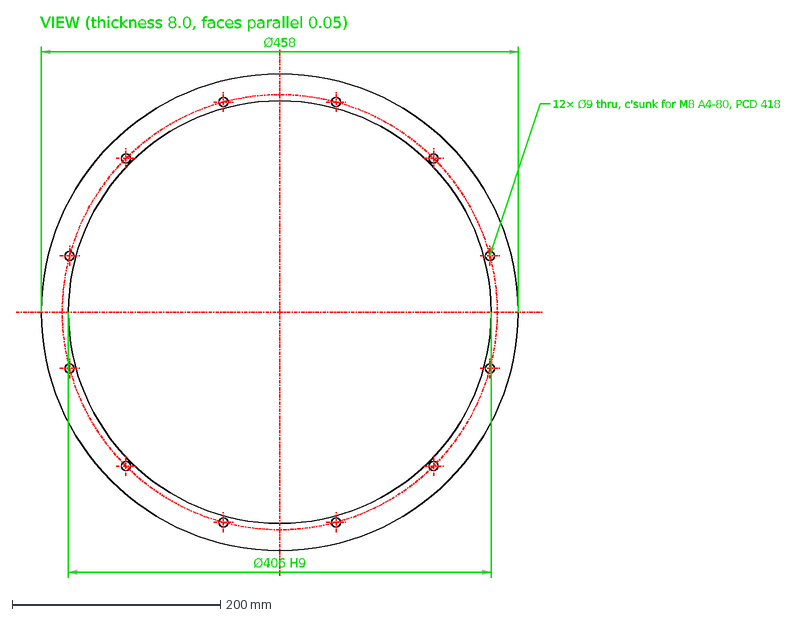
[picture p270: CAD file, 2026-11-03]
cad/nacelle_p1/out/dxf/NP1-202.dxf
Ø458
Ø406 H9
12× Ø9 thru, c'sunk for M8 A4-80, PCD 418
VIEW (thickness 8.0, faces parallel 0.05)
