safarcikm/Wind-turbines/cad/nacelle_p1/out/dxf/NP1-212.dxf

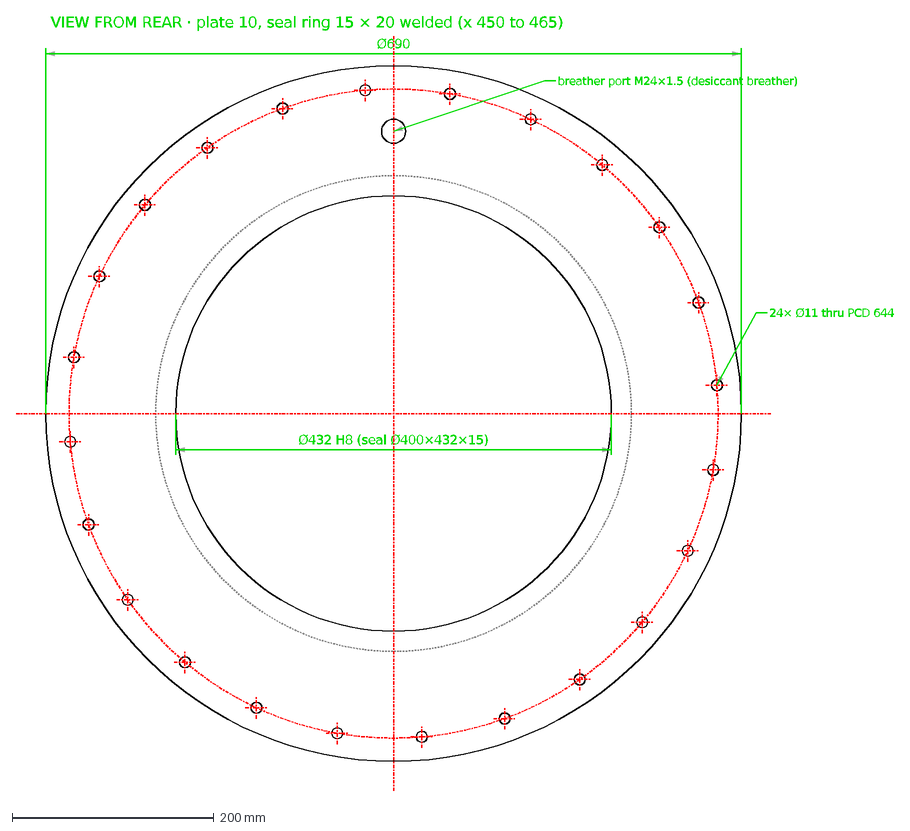
[picture p271: CAD file, 2026-11-03]
cad/nacelle_p1/out/dxf/NP1-212.dxf
breather port M24×1.5 (desiccant breather)
24× Ø11 thru PCD 644
Ø690
Ø432 H8 (seal Ø400×432×15)
VIEW FROM REAR · plate 10, seal ring 15 × 20 welded (x 450 to 465)
