safarcikm/Wind-turbines/cad/nacelle_w/out/step/NW-530-210_blade_root_stub.step

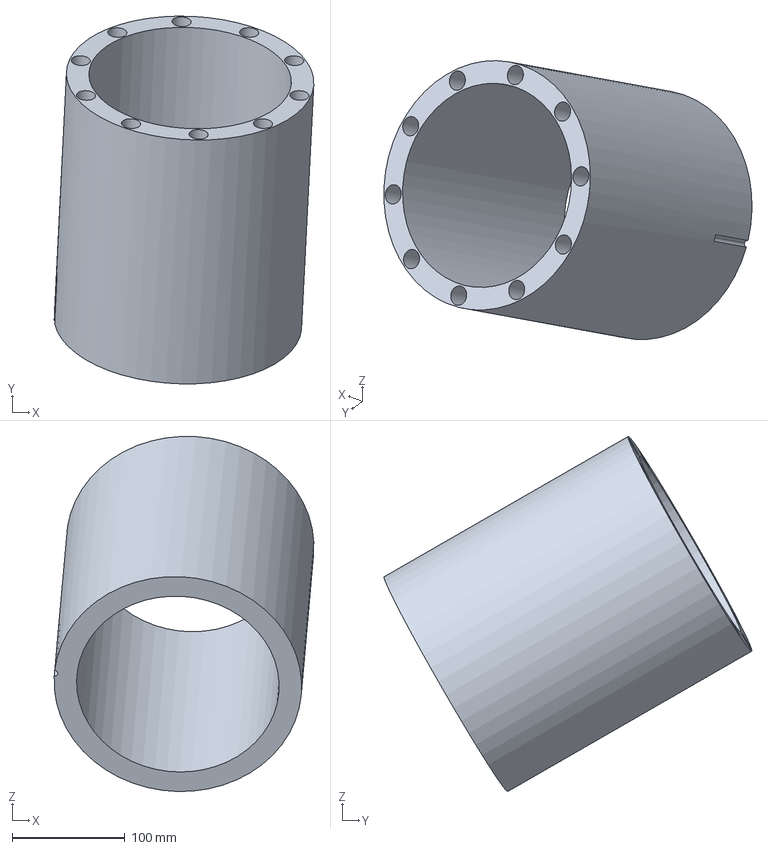
[picture p272: CAD file, 2026-11-03]
cad/nacelle_w/out/step/NW-530-210_blade_root_stub.step
230.4 x 326.4 x 315.1 mm
