safarcikm/Wind-turbines/cad/nacelle_fitcheck/out/step/yaw_bearing_outer_gear_ring_envelope.step

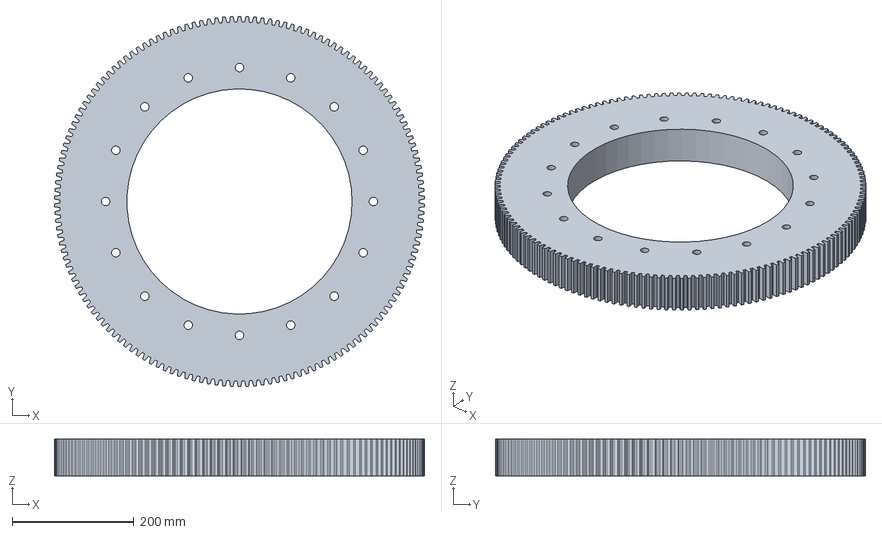
[picture p273: CAD file, 2026-11-03]
cad/nacelle_fitcheck/out/step/yaw_bearing_outer_gear_ring_envelope.step
607.9 x 608.0 x 60.0 mm
