safarcikm/Wind-turbines/cad/nacelle_p1/out/dxf/NP1-T01.dxf

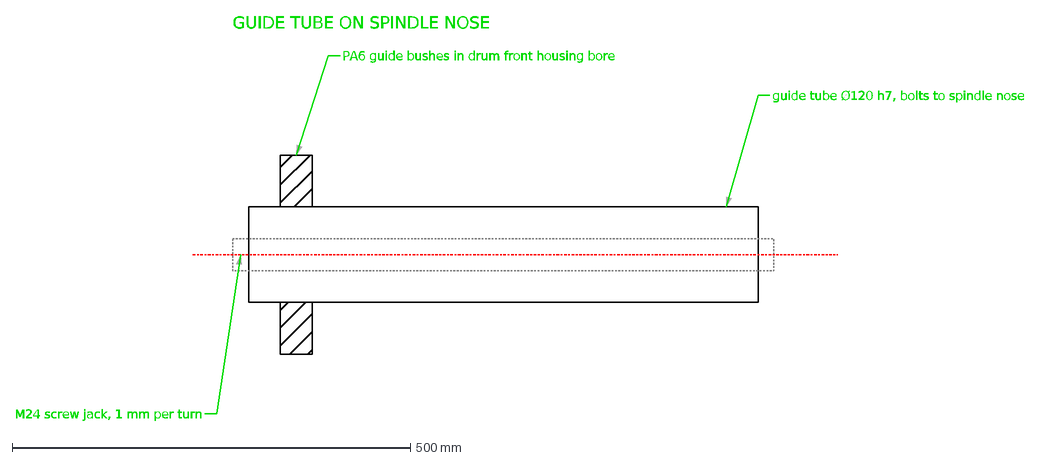
[picture p274: CAD file, 2026-11-03]
cad/nacelle_p1/out/dxf/NP1-T01.dxf
PA6 guide bushes in drum front housing bore
guide tube Ø120 h7, bolts to spindle nose
M24 screw jack, 1 mm per turn
GUIDE TUBE ON SPINDLE NOSE
