safarcikm/Wind-turbines/cad/turbine_6kw/out/dxf/NS6-700.dxf

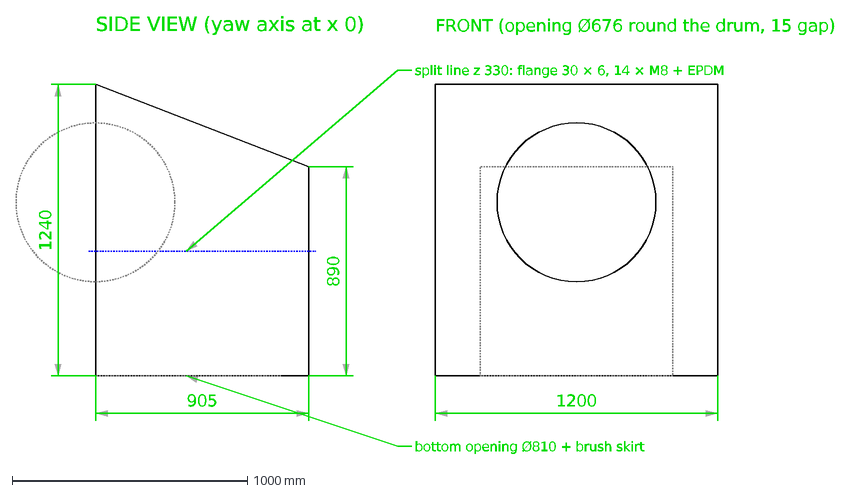
[picture p275: CAD file, 2026-11-06]
cad/turbine_6kw/out/dxf/NS6-700.dxf
905
1240
890
split line z 330: flange 30 × 6, 14 × M8 + EPDM
bottom opening Ø810 + brush skirt
SIDE VIEW (yaw axis at x 0)
1200
FRONT (opening Ø676 round the drum, 15 gap)
