safarcikm/Wind-turbines/cad/nacelle_fitcheck/out/step/stator_end_winding_rear_envelope.step

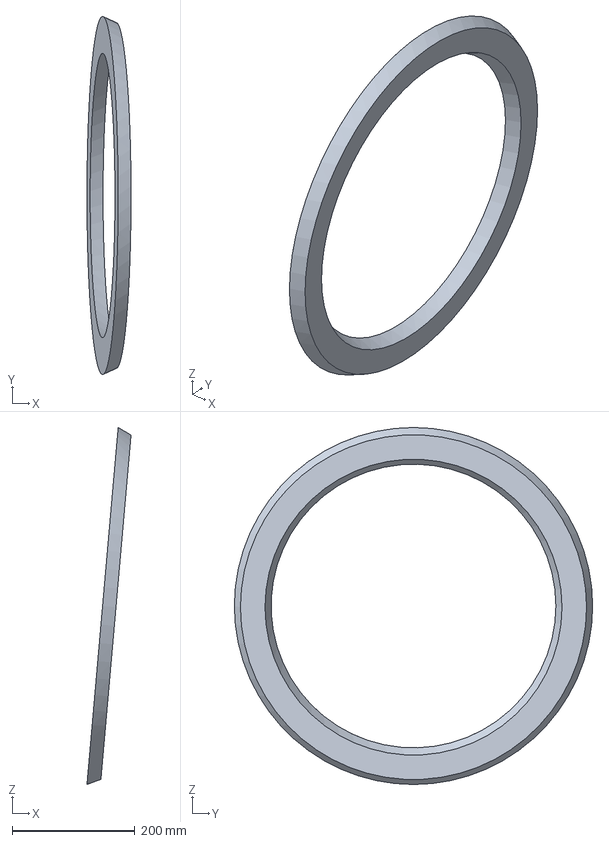
[picture p276: CAD file, 2026-11-03]
cad/nacelle_fitcheck/out/step/stator_end_winding_rear_envelope.step
71.9 x 584.0 x 581.8 mm
