safarcikm/Wind-turbines/cad/nacelle_p1/out/dxf/NP1-210.dxf

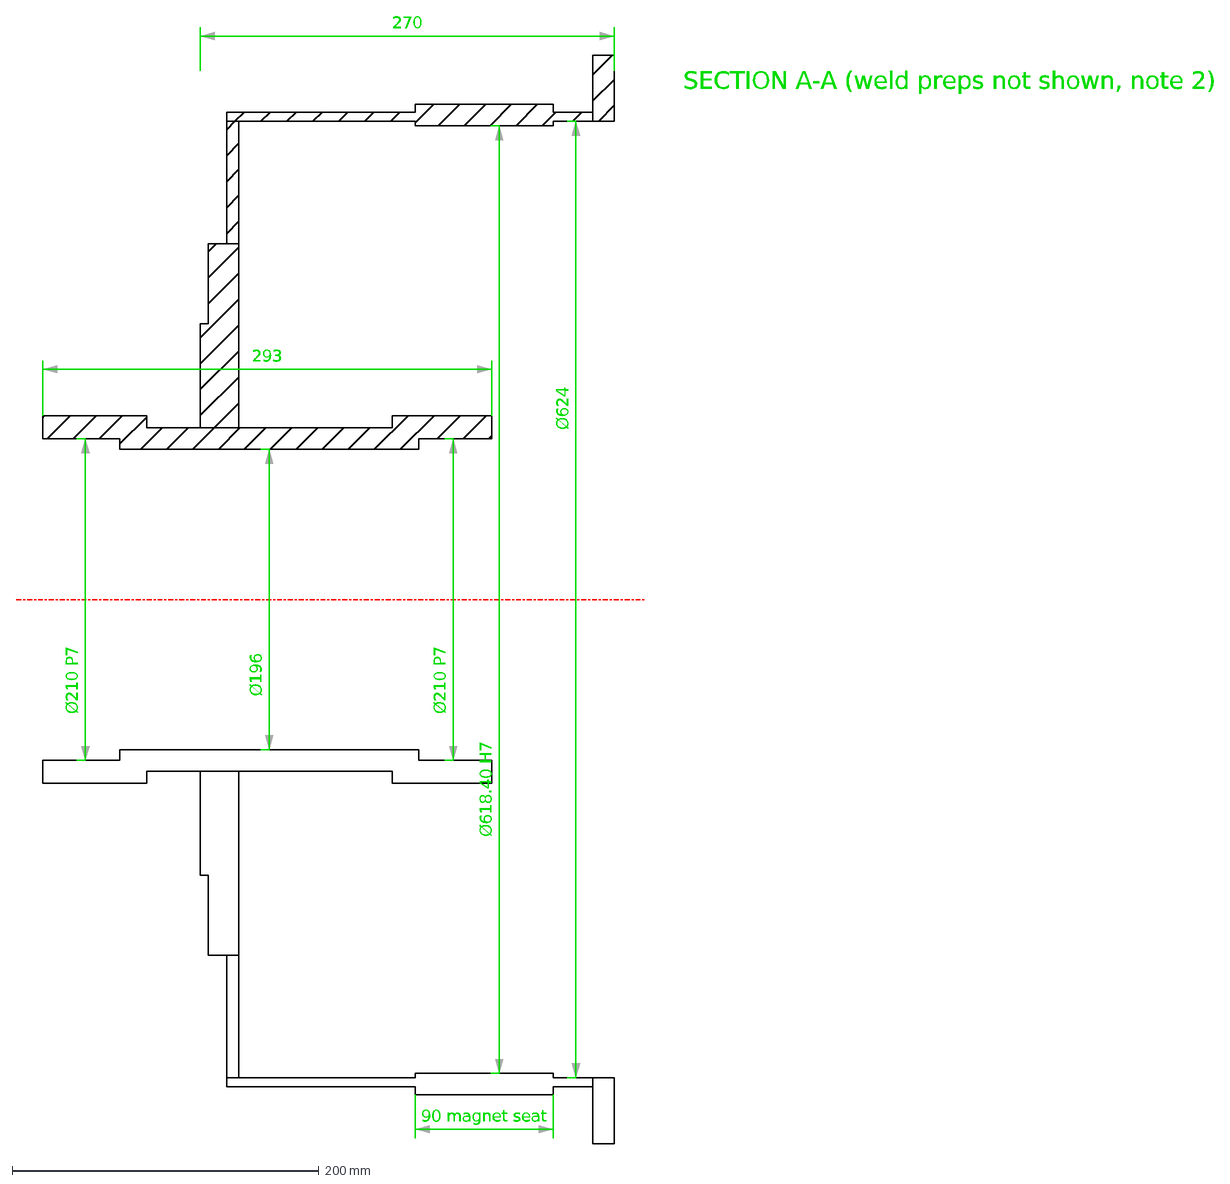
[picture p277: CAD file, 2026-11-03]
cad/nacelle_p1/out/dxf/NP1-210.dxf
293
270
90 magnet seat
Ø210 P7
Ø196
Ø618.40 H7
Ø624
SECTION A-A (weld preps not shown, note 2)
