safarcikm/Wind-turbines/cad/nacelle_w/out/step/NW-510-090_pitch_bearing_inner_ring.step

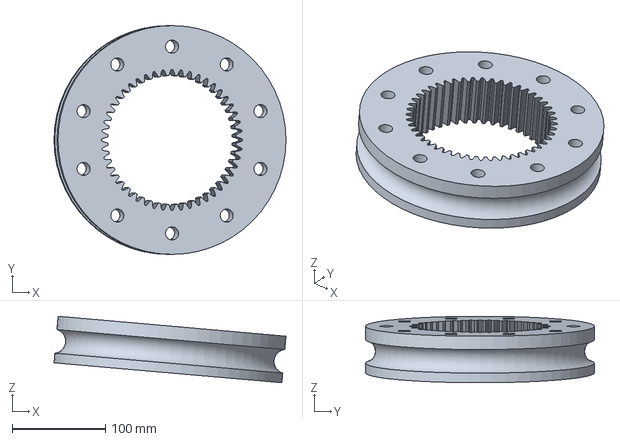
[picture p278: CAD file, 2026-11-03]
cad/nacelle_w/out/step/NW-510-090_pitch_bearing_inner_ring.step
248.4 x 245.0 x 71.2 mm
