safarcikm/Wind-turbines/cad/turbine_6kw/out/dxf/NS6-610.dxf

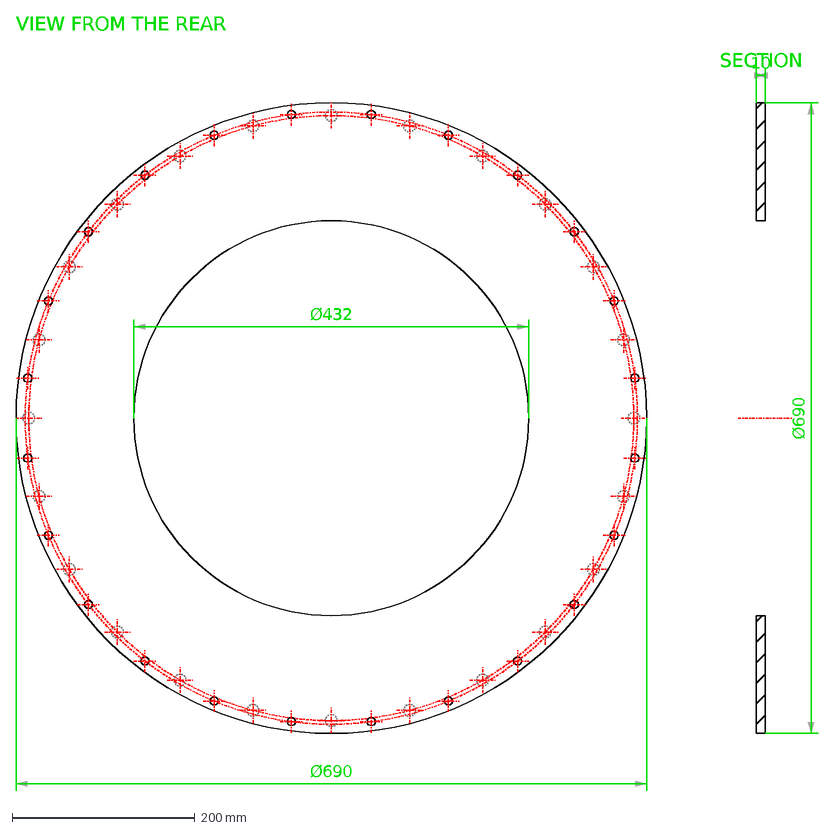
[picture p279: CAD file, 2026-11-06]
cad/turbine_6kw/out/dxf/NS6-610.dxf
Ø690
Ø432
VIEW FROM THE REAR
10
SECTION
