safarcikm/Wind-turbines/cad/nacelle_fitcheck/out/step/NP1-310_rotor_caliper_bracket_left.step

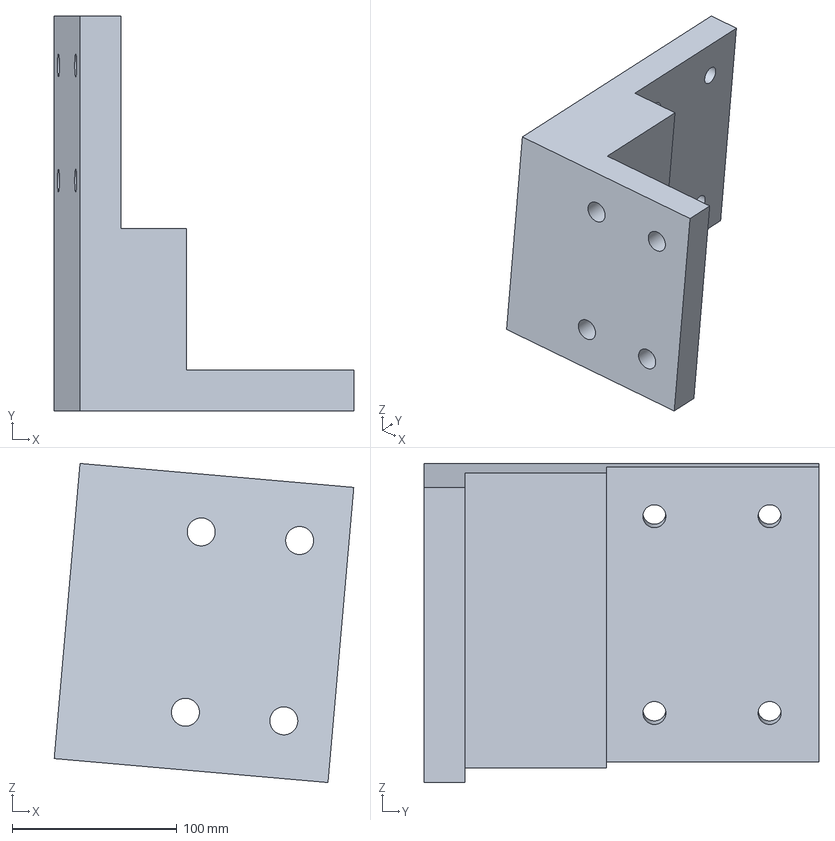
[picture p280: CAD file, 2026-11-03]
cad/nacelle_fitcheck/out/step/NP1-310_rotor_caliper_bracket_left.step
182.1 x 240.0 x 193.9 mm
