safarcikm/Wind-turbines/cad/nacelle_p1/out/dxf/NP1-300.dxf

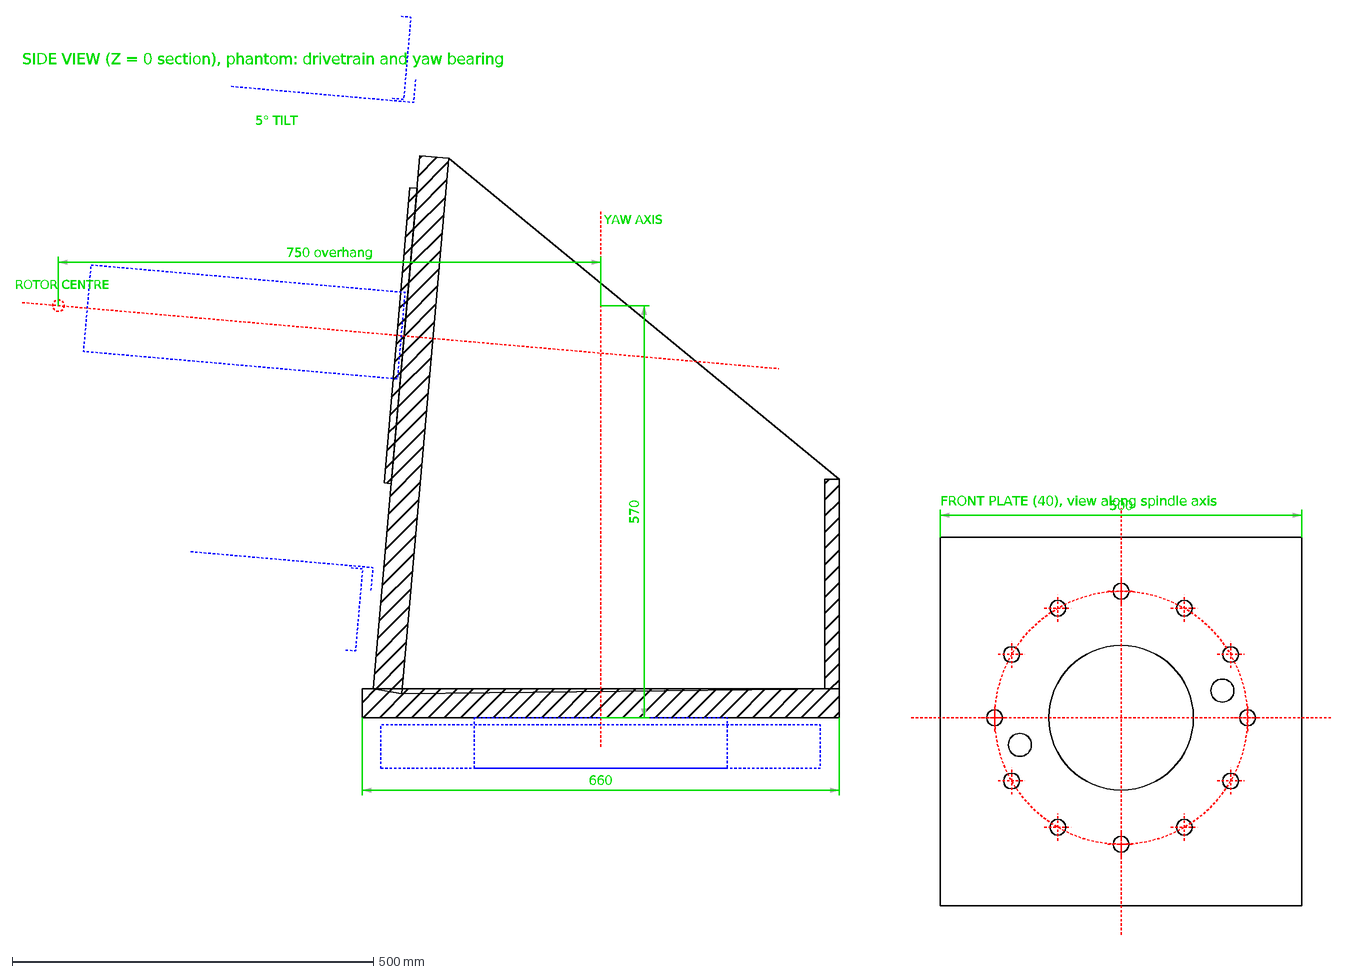
[picture p281: CAD file, 2026-11-03]
cad/nacelle_p1/out/dxf/NP1-300.dxf
YAW AXIS
ROTOR CENTRE
750 overhang
570
660
5° TILT
SIDE VIEW (Z = 0 section), phantom: drivetrain and yaw bearing
500
FRONT PLATE (40), view along spindle axis
