safarcikm/Wind-turbines/cad/nacelle_w/out/step/NW-510-090_pitch_bearing_outer_ring.step

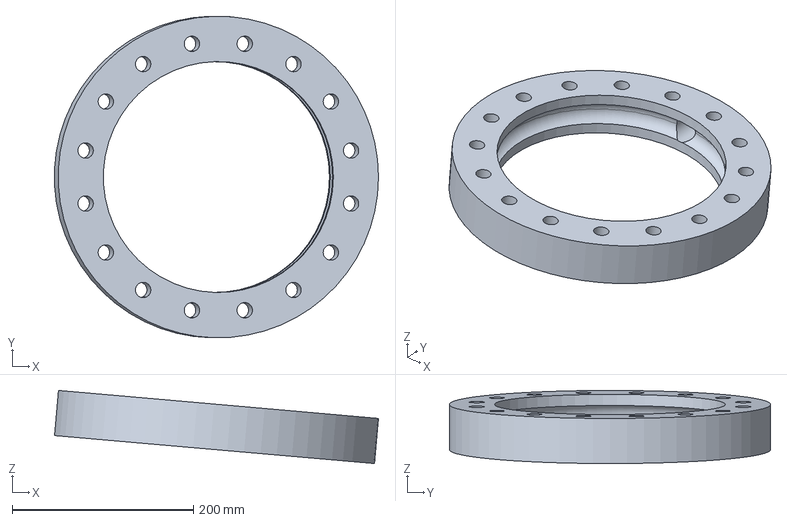
[picture p282: CAD file, 2026-11-03]
cad/nacelle_w/out/step/NW-510-090_pitch_bearing_outer_ring.step
357.8 x 354.9 x 80.7 mm
