safarcikm/Wind-turbines/cad/turbine_6kw/out/dxf/NS6-100.dxf

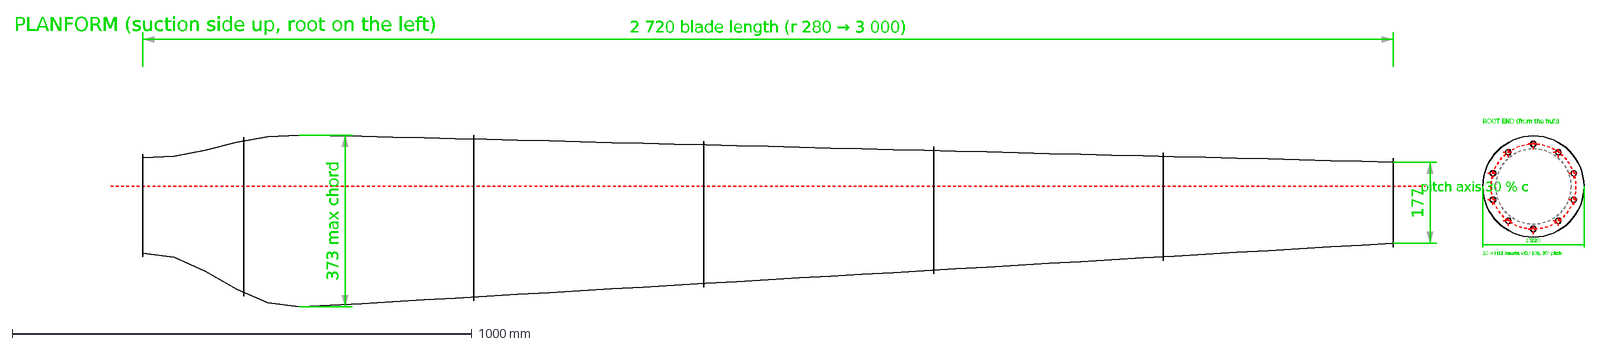
[picture p283: CAD file, 2026-11-06]
cad/turbine_6kw/out/dxf/NS6-100.dxf
pitch axis 30 % c
2 720 blade length (r 280 → 3 000)
373 max chord
177
PLANFORM (suction side up, root on the left)
Ø220
10 × M12 inserts, PCD 185, 36° pitch
ROOT END (from the hub)
