safarcikm/Wind-turbines/cad/nacelle_fitcheck/out/step/tower_top_flange_stub.step

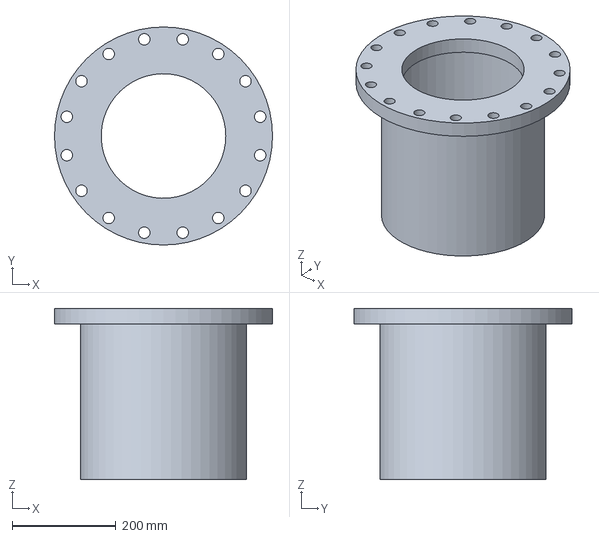
[picture p284: CAD file, 2026-11-03]
cad/nacelle_fitcheck/out/step/tower_top_flange_stub.step
420.0 x 420.0 x 330.0 mm
