safarcikm/Wind-turbines/cad/turbine_6kw/out/dxf/NS6-200.dxf

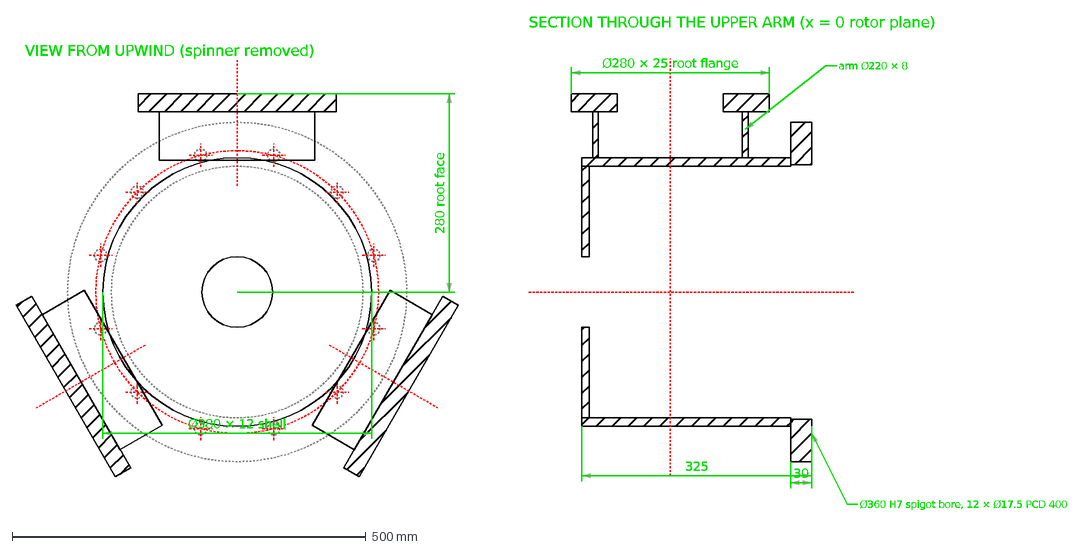
[picture p285: CAD file, 2026-11-06]
cad/turbine_6kw/out/dxf/NS6-200.dxf
Ø380 × 12 shell
280 root face
VIEW FROM UPWIND (spinner removed)
Ø280 × 25 root flange
325
30
arm Ø220 × 8
Ø360 H7 spigot bore, 12 × Ø17.5 PCD 400
SECTION THROUGH THE UPPER ARM (x = 0 rotor plane)
