safarcikm/Wind-turbines/cad/nacelle_fitcheck/out/step/NP1-110_cooling_insert.step

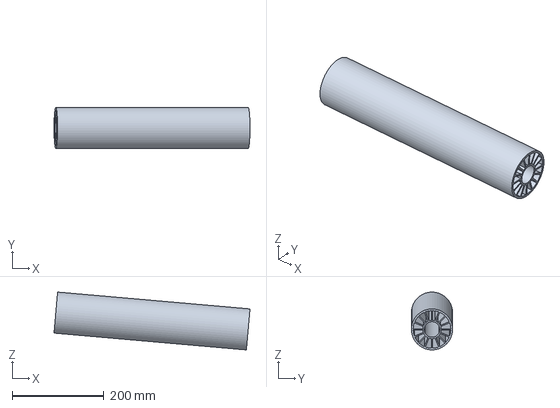
[picture p286: CAD file, 2026-11-03]
cad/nacelle_fitcheck/out/step/NP1-110_cooling_insert.step
426.2 x 89.6 x 125.8 mm
