safarcikm/Wind-turbines/cad/turbine_6kw/out/dxf/NS6-500.dxf

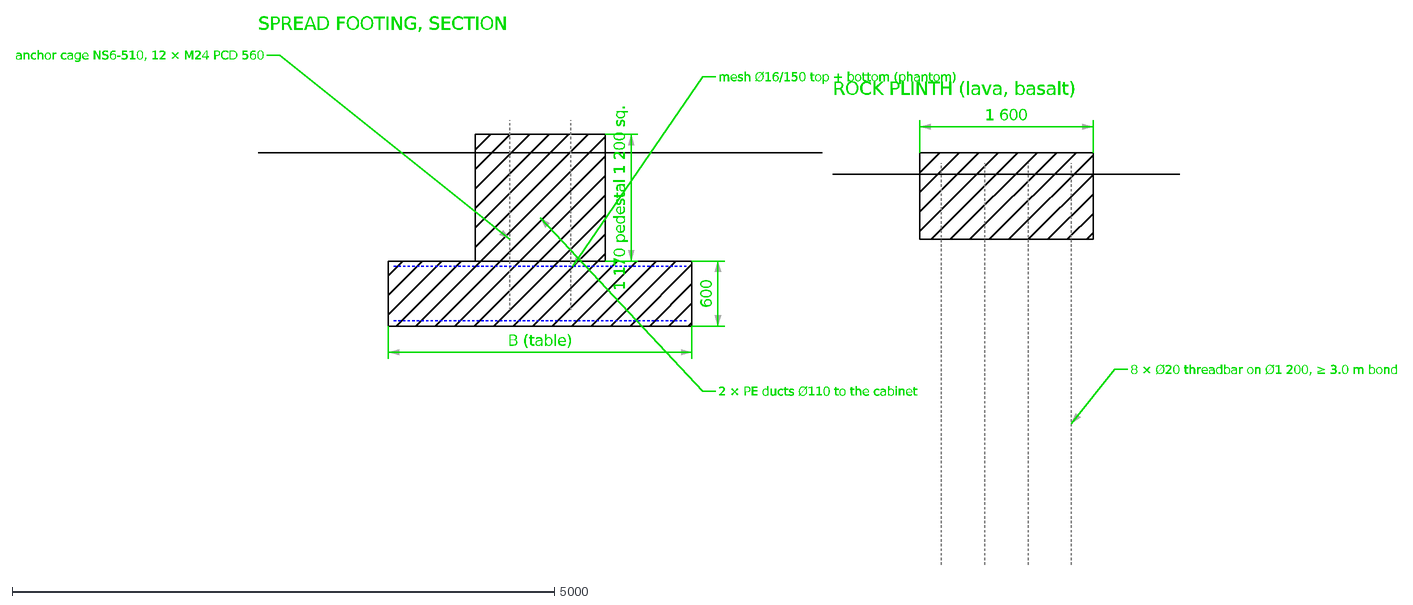
[picture p287: CAD file, 2026-11-06]
cad/turbine_6kw/out/dxf/NS6-500.dxf
B (table)
600
1 170 pedestal 1 200 sq.
anchor cage NS6-510, 12 × M24 PCD 560
mesh Ø16/150 top + bottom (phantom)
2 × PE ducts Ø110 to the cabinet
SPREAD FOOTING, SECTION
1 600
8 × Ø20 threadbar on Ø1 200, ≥ 3.0 m bond
ROCK PLINTH (lava, basalt)
