safarcikm/Wind-turbines/cad/nacelle_fitcheck/out/step/NP1-300-4_bedplate_rear_plate.step

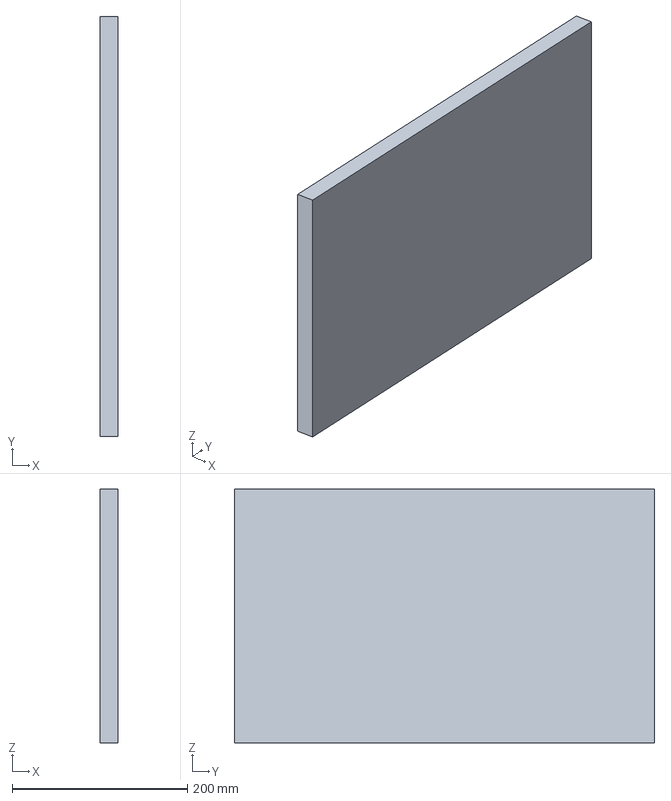
[picture p288: CAD file, 2026-11-03]
cad/nacelle_fitcheck/out/step/NP1-300-4_bedplate_rear_plate.step
20.0 x 480.0 x 290.0 mm
