safarcikm/Wind-turbines/cad/nacelle_fitcheck/out/step/NP1-102_rear_seal_sleeve.step

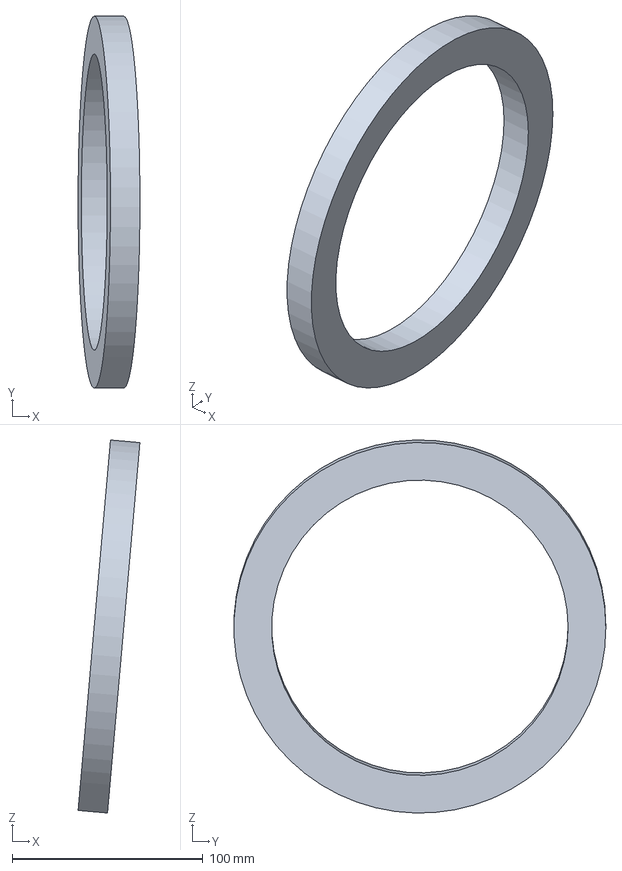
[picture p289: CAD file, 2026-11-03]
cad/nacelle_fitcheck/out/step/NP1-102_rear_seal_sleeve.step
32.4 x 194.9 x 195.5 mm
