safarcikm/Wind-turbines/cad/turbine_6kw/out/dxf/NS6-105.dxf

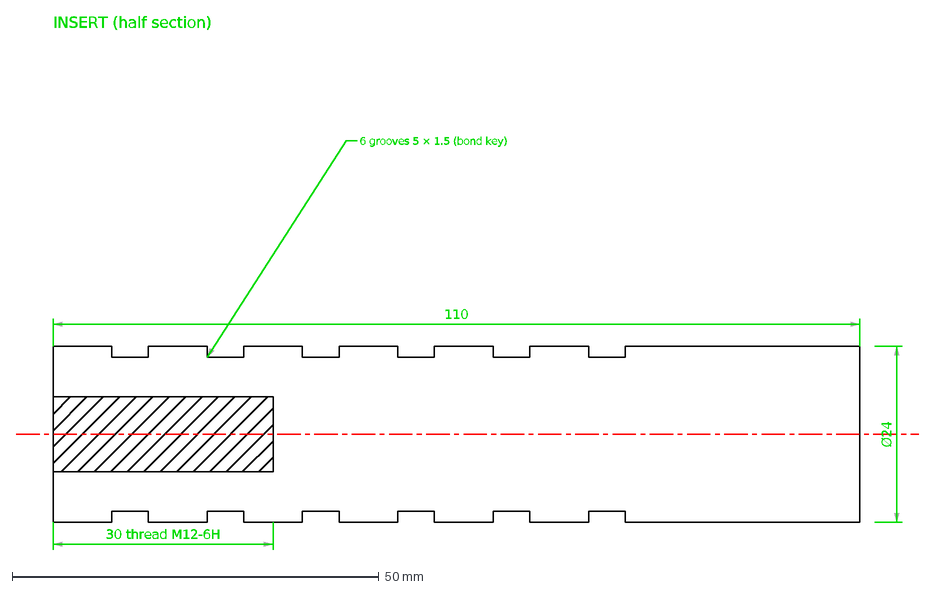
[picture p290: CAD file, 2026-11-06]
cad/turbine_6kw/out/dxf/NS6-105.dxf
110
30 thread M12-6H
Ø24
6 grooves 5 × 1.5 (bond key)
INSERT (half section)
