safarcikm/Wind-turbines/cad/nacelle_fitcheck/out/step/NP1-211_rear_seal_cover.step

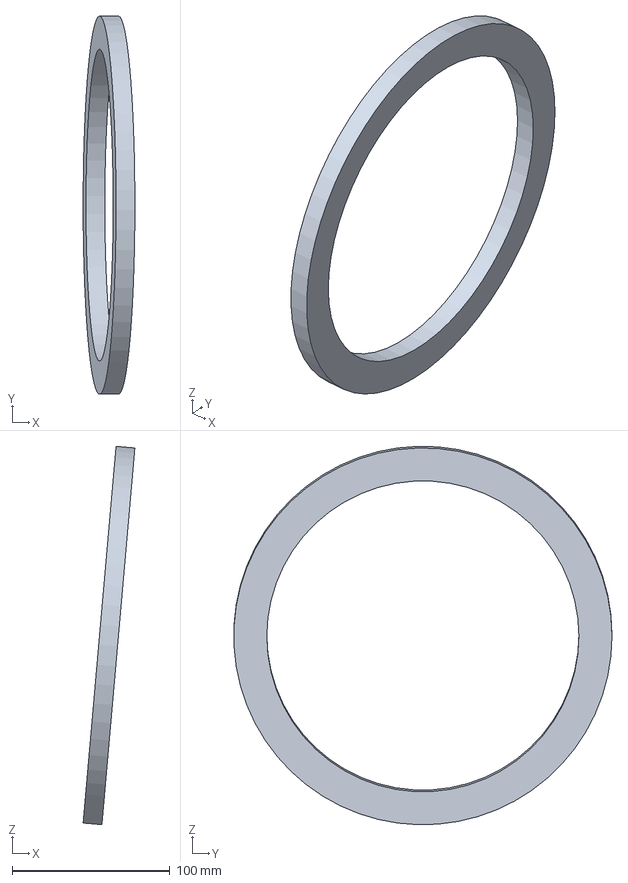
[picture p291: CAD file, 2026-11-03]
cad/nacelle_fitcheck/out/step/NP1-211_rear_seal_cover.step
32.9 x 239.8 x 240.0 mm
