safarcikm/Wind-turbines/cad/nacelle_w/out/step/NW-430_yaw_bearing_outer_gear_ring_twin.step

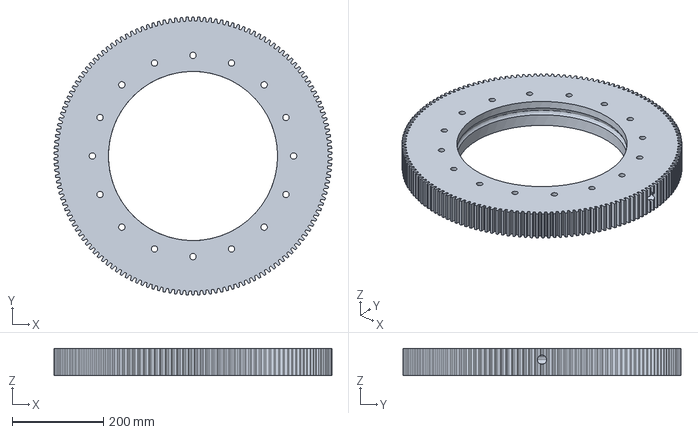
[picture p292: CAD file, 2026-11-03]
cad/nacelle_w/out/step/NW-430_yaw_bearing_outer_gear_ring_twin.step
607.9 x 608.0 x 60.0 mm
