safarcikm/Wind-turbines/cad/turbine_6kw/out/dxf/NS6-510.dxf

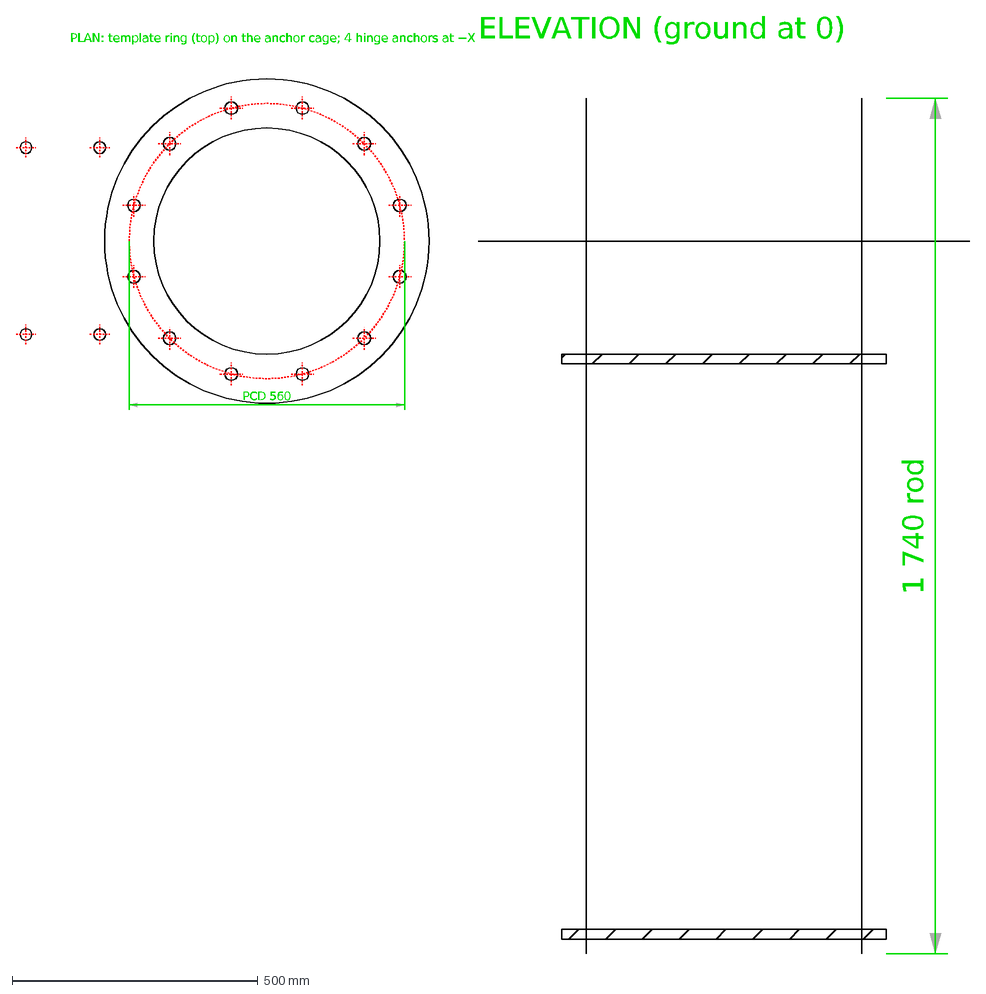
[picture p293: CAD file, 2026-11-06]
cad/turbine_6kw/out/dxf/NS6-510.dxf
PCD 560
PLAN: template ring (top) on the anchor cage; 4 hinge anchors at −X
1 740 rod
ELEVATION (ground at 0)
