safarcikm/Wind-turbines/cad/nacelle_fitcheck/out/step/NP1-211_front_seal_cover.step

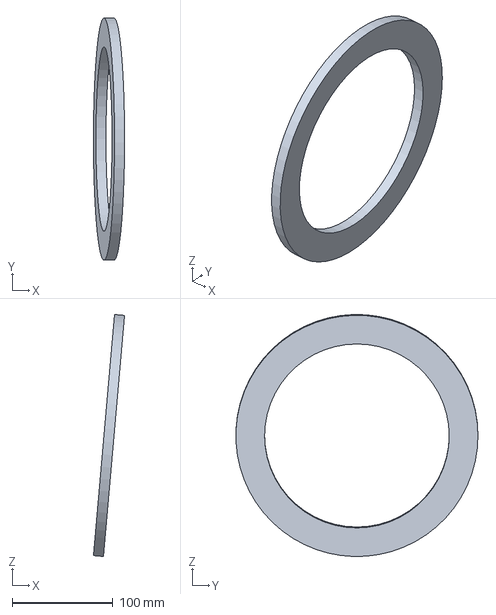
[picture p294: CAD file, 2026-11-03]
cad/nacelle_fitcheck/out/step/NP1-211_front_seal_cover.step
30.9 x 239.8 x 239.9 mm
