safarcikm/Wind-turbines/cad/turbine_6kw/out/dxf/NS6-110.dxf

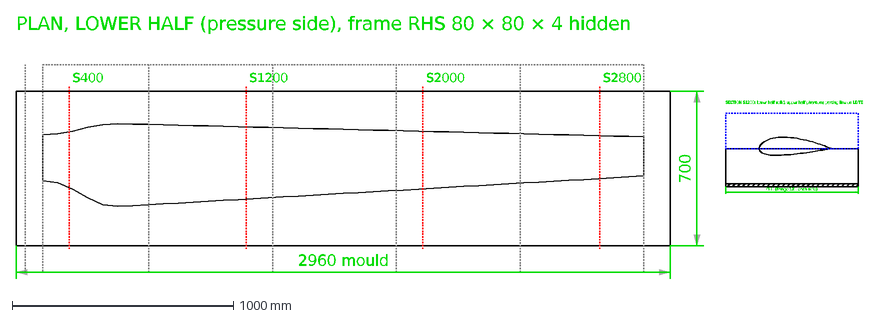
[picture p295: CAD file, 2026-11-06]
cad/turbine_6kw/out/dxf/NS6-110.dxf
S400
S1200
S2000
S2800
2960 mould
700
PLAN, LOWER HALF (pressure side), frame RHS 80 × 80 × 4 hidden
600 (flange 120 each side)
SECTION S1200: lower half solid, upper half phantom; parting line on LE/TE
