safarcikm/Wind-turbines/cad/nacelle_fitcheck/out/step/yaw_brake_caliper_left_envelope.step

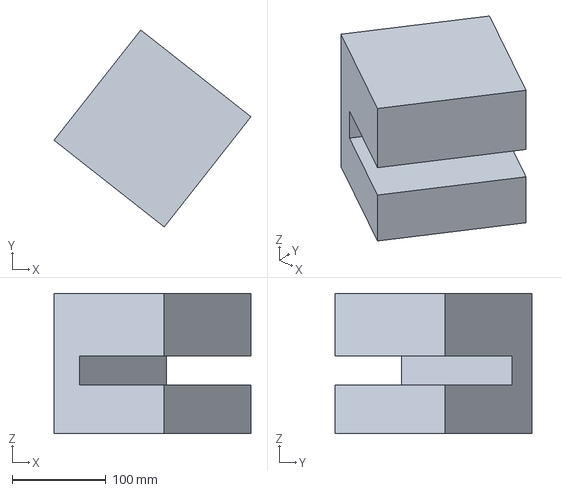
[picture p296: CAD file, 2026-11-03]
cad/nacelle_fitcheck/out/step/yaw_brake_caliper_left_envelope.step
210.6 x 210.6 x 150.0 mm
