safarcikm/Wind-turbines/cad/nacelle_w/out/step/NW-511-090_ball_filling_plug.step

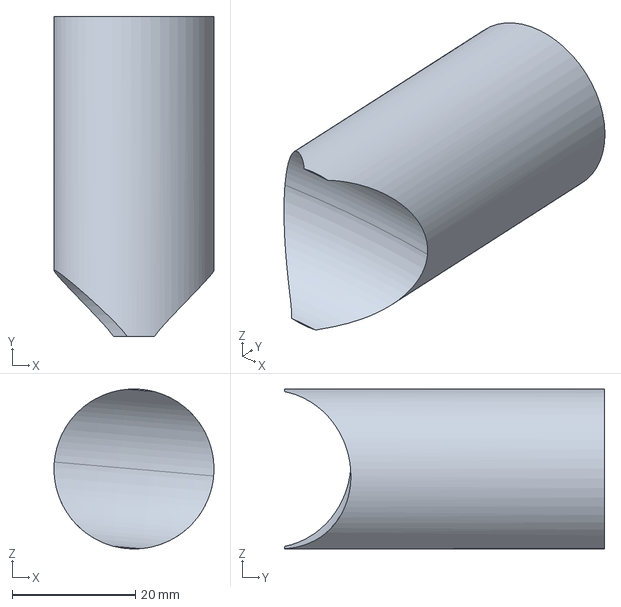
[picture p297: CAD file, 2026-11-03]
cad/nacelle_w/out/step/NW-511-090_ball_filling_plug.step
26.0 x 52.0 x 26.0 mm
