safarcikm/Wind-turbines/cad/nacelle_fitcheck/out/step/NP1-200_stator_carrier.step

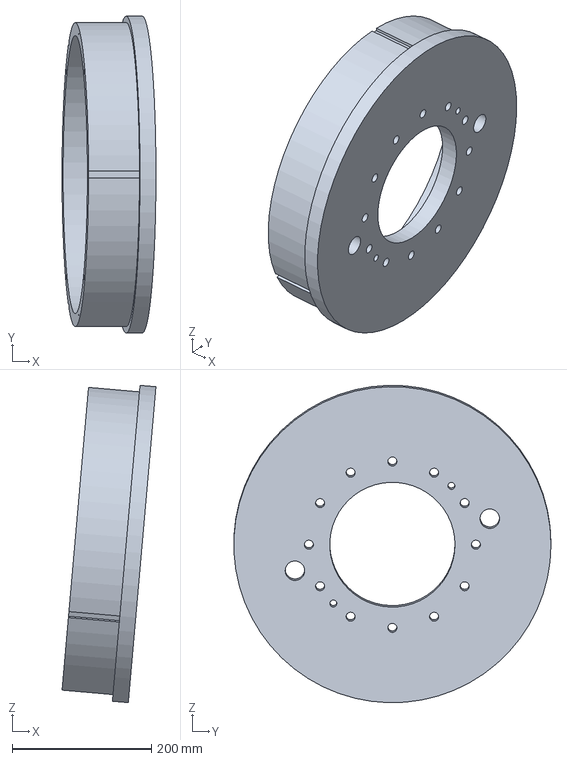
[picture p298: CAD file, 2026-11-03]
cad/nacelle_fitcheck/out/step/NP1-200_stator_carrier.step
135.0 x 455.7 x 456.1 mm
