safarcikm/Wind-turbines/cad/nacelle_w/out/step/pitch_drive_090_envelope.step

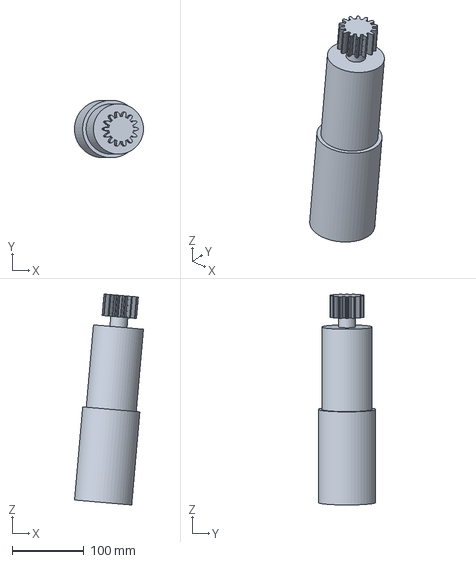
[picture p299: CAD file, 2026-11-03]
cad/nacelle_w/out/step/pitch_drive_090_envelope.step
96.0 x 80.0 x 293.5 mm
