safarcikm/Wind-turbines/cad/turbine_6kw/out/dxf/NS6-115.dxf

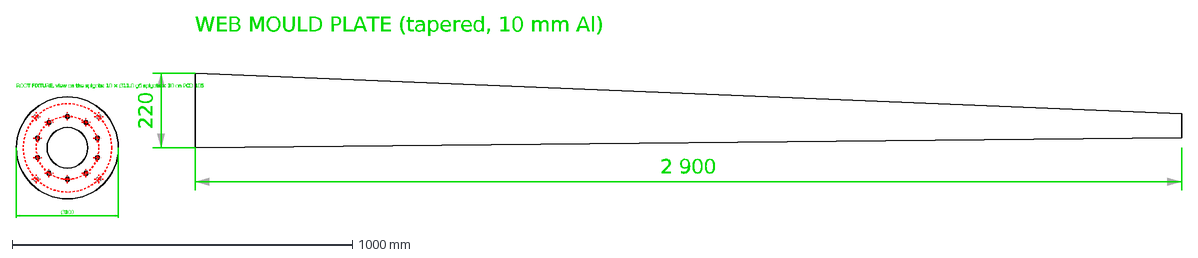
[picture p300: CAD file, 2026-11-06]
cad/turbine_6kw/out/dxf/NS6-115.dxf
Ø300
ROOT FIXTURE, view on the spigots: 10 × Ø11.8 g6 spigots × 30 on PCD 185
2 900
220
WEB MOULD PLATE (tapered, 10 mm Al)
