safarcikm/Wind-turbines/cad/turbine_6kw/out/dxf/NS6-620.dxf

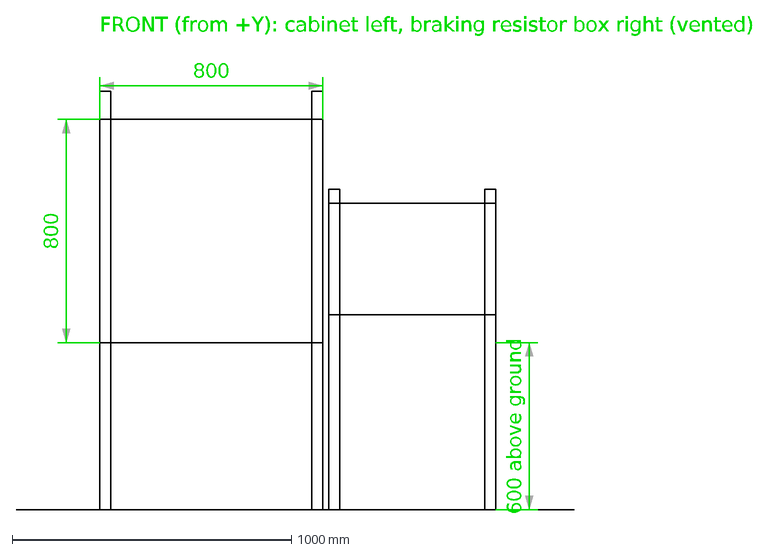
[picture p301: CAD file, 2026-11-06]
cad/turbine_6kw/out/dxf/NS6-620.dxf
800
600 above ground
FRONT (from +Y): cabinet left, braking resistor box right (vented)
