safarcikm/Wind-turbines/cad/turbine_6kw/out/dxf/NS6-400.dxf

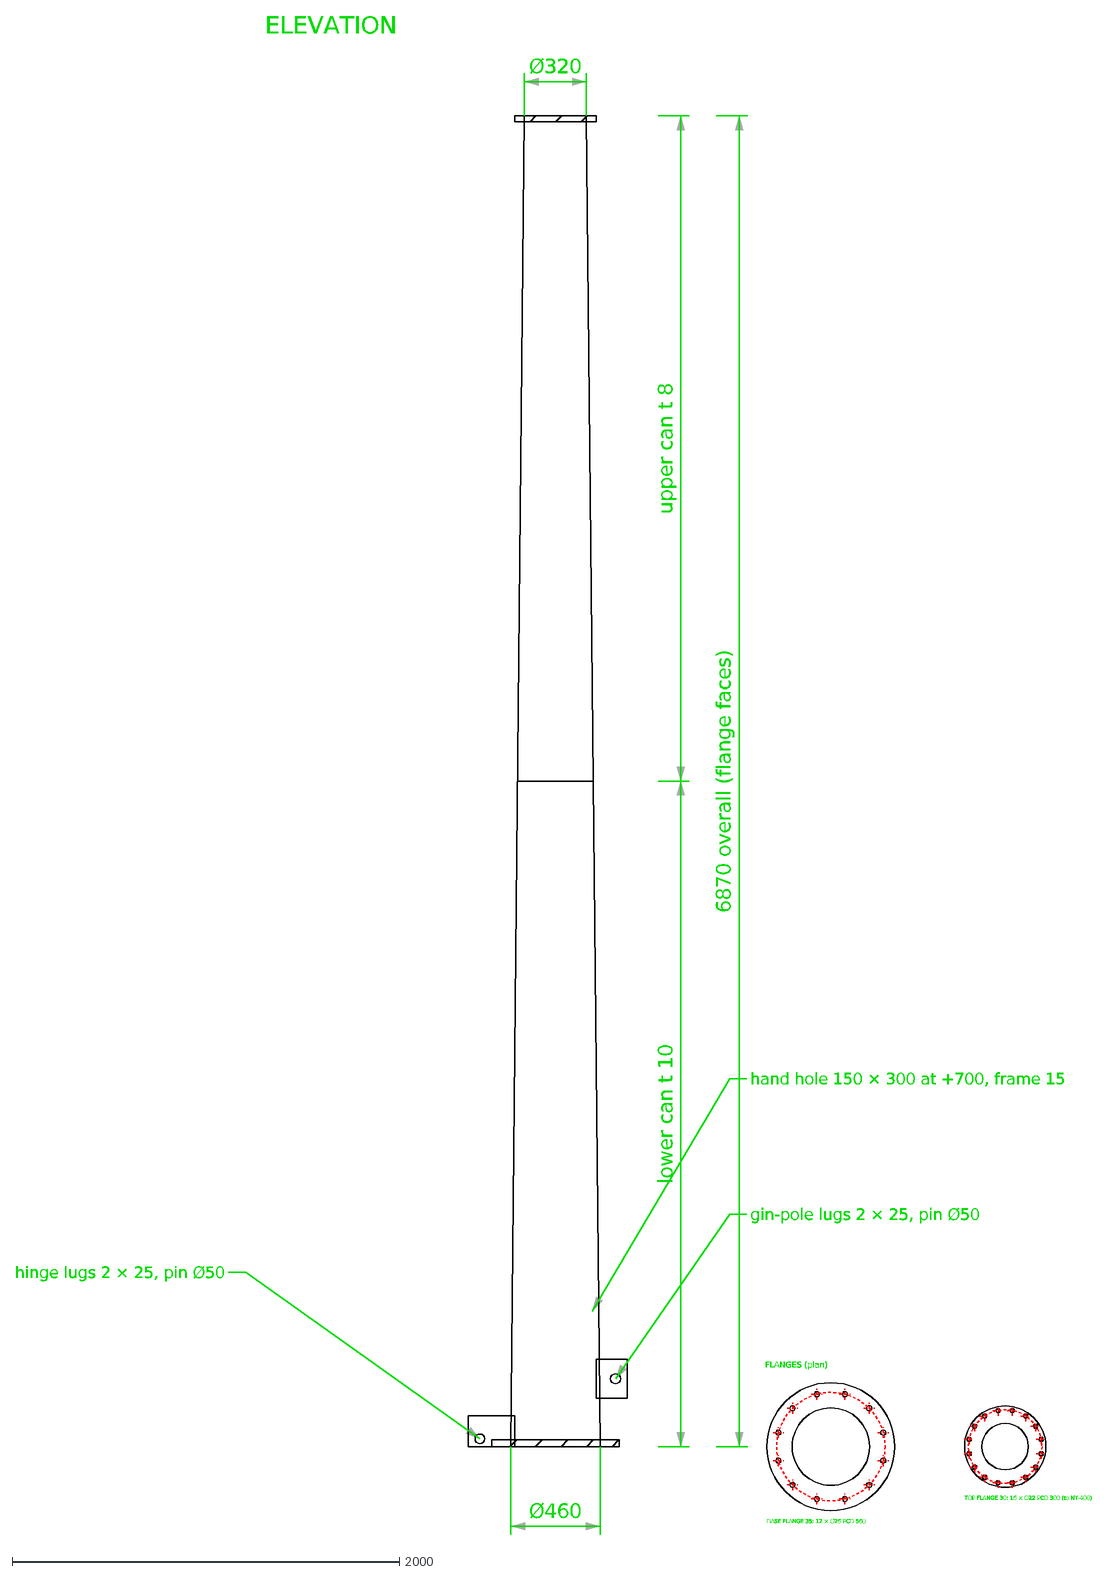
[picture p302: CAD file, 2026-11-06]
cad/turbine_6kw/out/dxf/NS6-400.dxf
6870 overall (flange faces)
lower can t 10
upper can t 8
Ø460
Ø320
hinge lugs 2 × 25, pin Ø50
gin-pole lugs 2 × 25, pin Ø50
hand hole 150 × 300 at +700, frame 15
ELEVATION
BASE FLANGE 35: 12 × Ø26 PCD 560
TOP FLANGE 30: 16 × Ø22 PCD 380 (to NY-400)
FLANGES (plan)
