safarcikm/Wind-turbines/cad/nacelle_fitcheck/out/step/NP1-420_yaw_drive_bracket_right.step

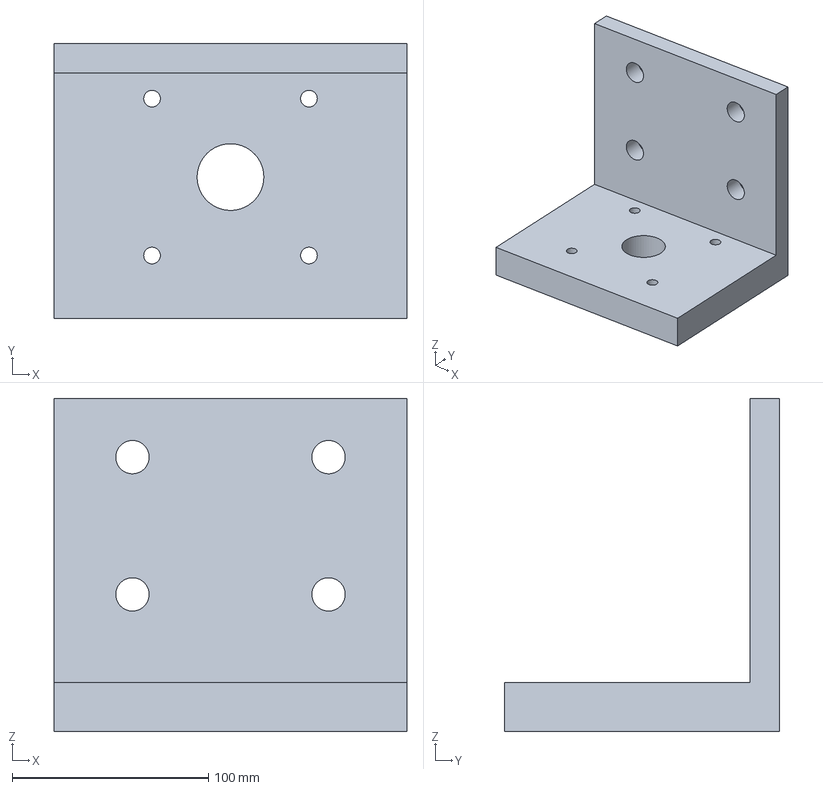
[picture p303: CAD file, 2026-11-03]
cad/nacelle_fitcheck/out/step/NP1-420_yaw_drive_bracket_right.step
180.0 x 140.0 x 170.0 mm
