safarcikm/Wind-turbines/cad/nacelle_w/out/step/slip_ring_encoder_envelope.step

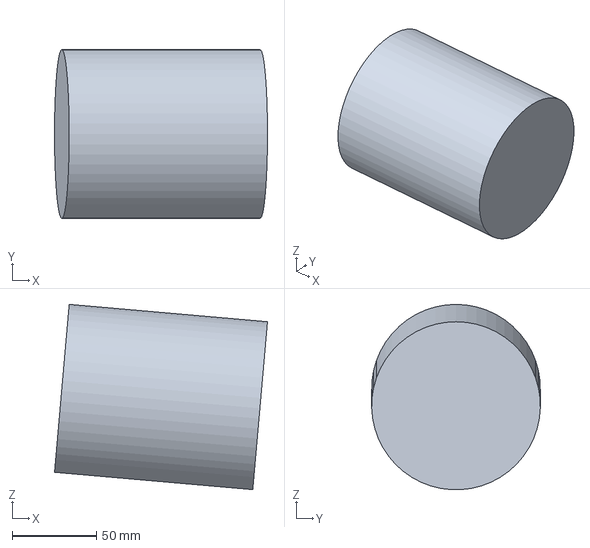
[picture p304: CAD file, 2026-11-03]
cad/nacelle_w/out/step/slip_ring_encoder_envelope.step
126.3 x 100.0 x 109.8 mm
