safarcikm/Wind-turbines/cad/turbine_6kw/out/dxf/NS6-800.dxf

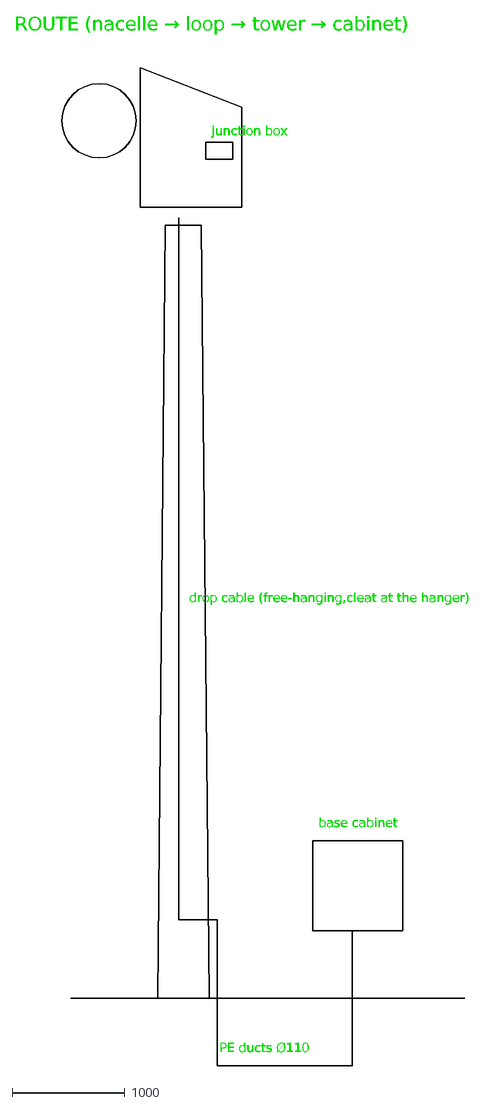
[picture p305: CAD file, 2026-11-06]
cad/turbine_6kw/out/dxf/NS6-800.dxf
junction box
drop cable (free-hanging,cleat at the hanger)
base cabinet
PE ducts Ø110
ROUTE (nacelle → loop → tower → cabinet)
