safarcikm/Wind-turbines/cad/turbine_6kw/out/dxf/NS6-020.dxf

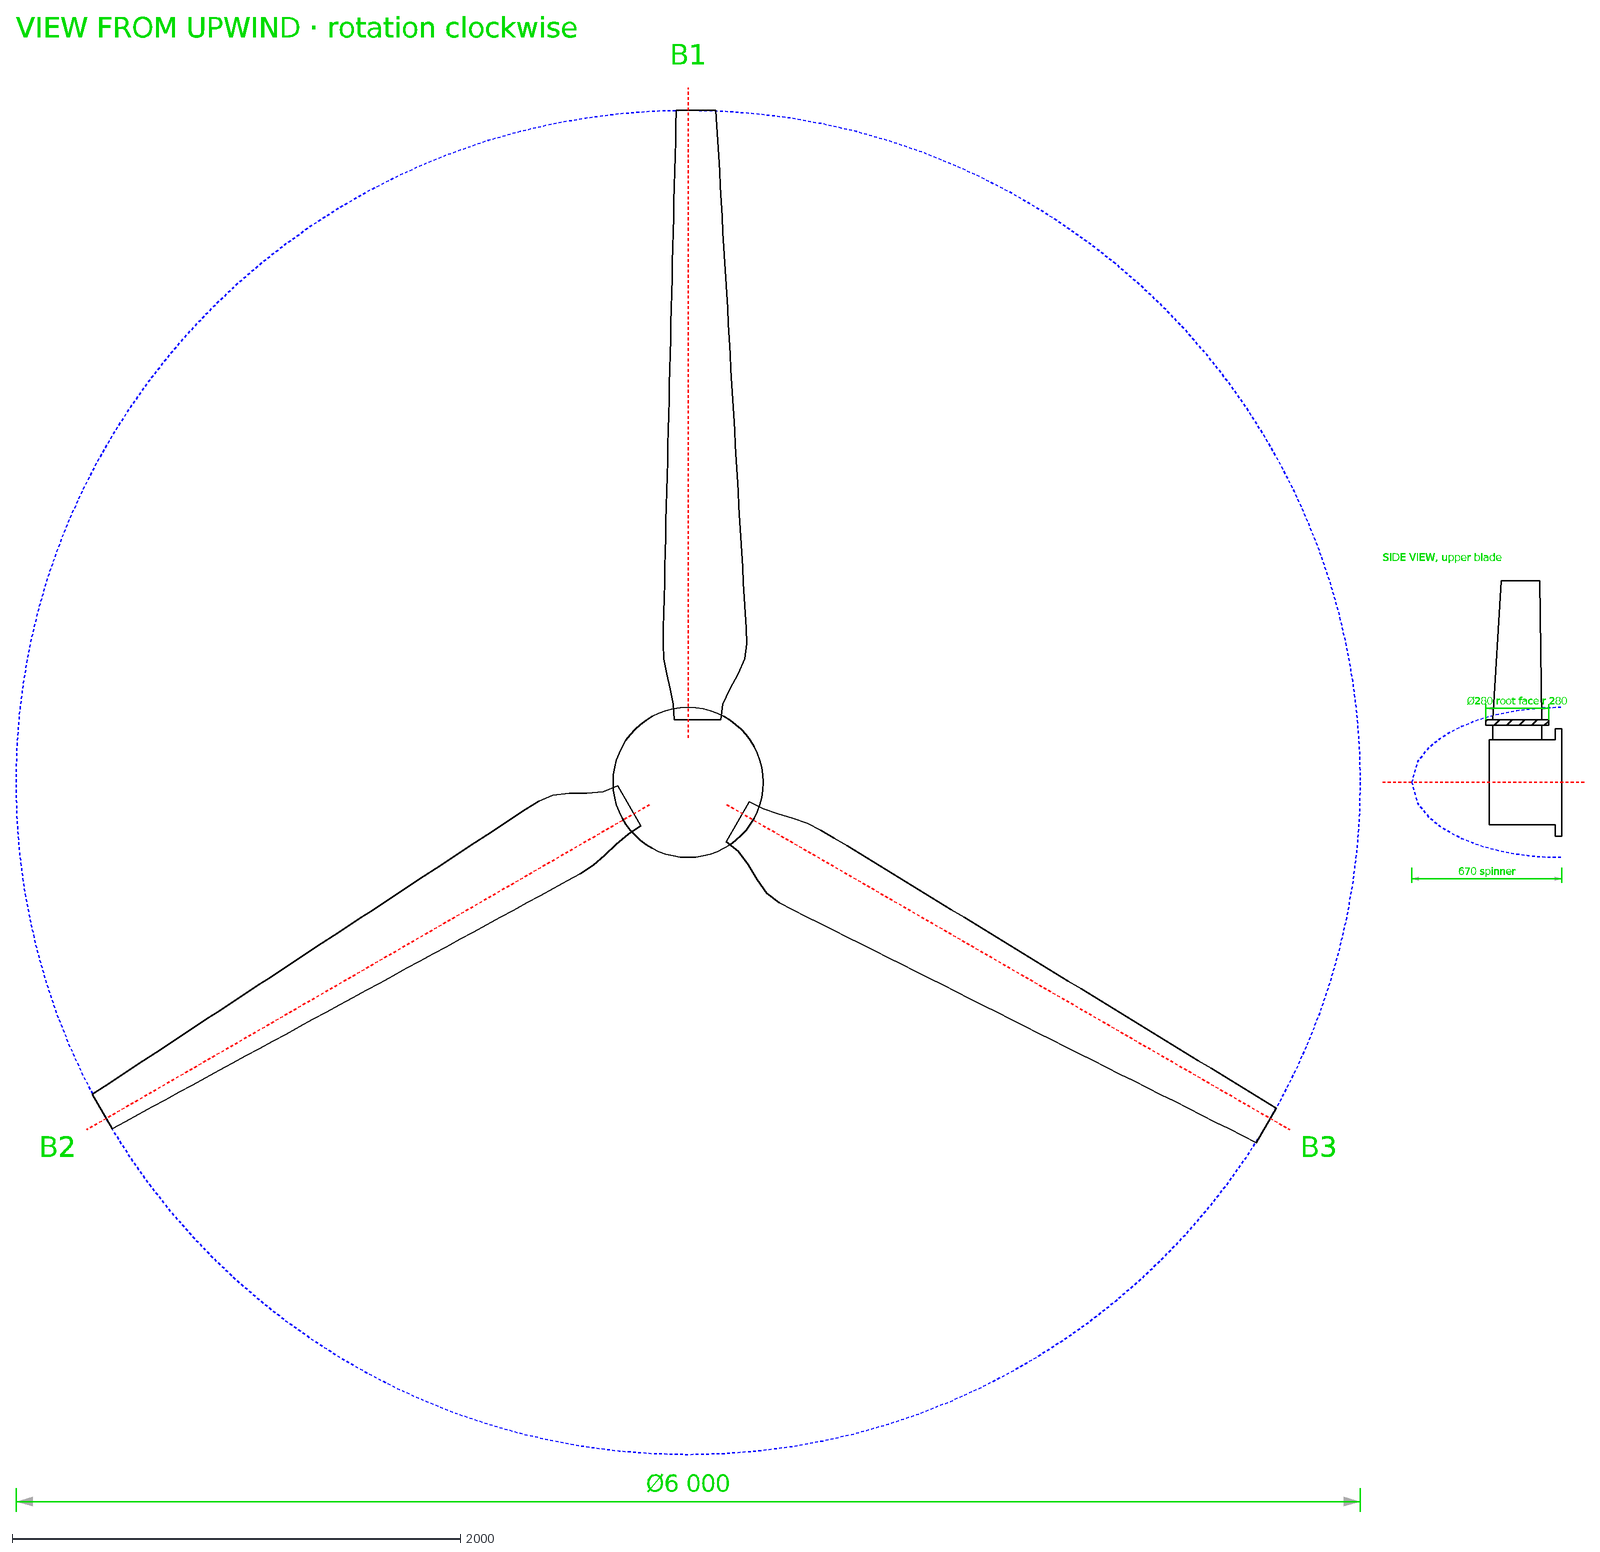
[picture p306: CAD file, 2026-11-06]
cad/turbine_6kw/out/dxf/NS6-020.dxf
B1
B2
B3
Ø6 000
VIEW FROM UPWIND · rotation clockwise
Ø280 root face r 280
670 spinner
SIDE VIEW, upper blade
