safarcikm/Wind-turbines/cad/nacelle_fitcheck/out/step/NP1-201_stator_core.step

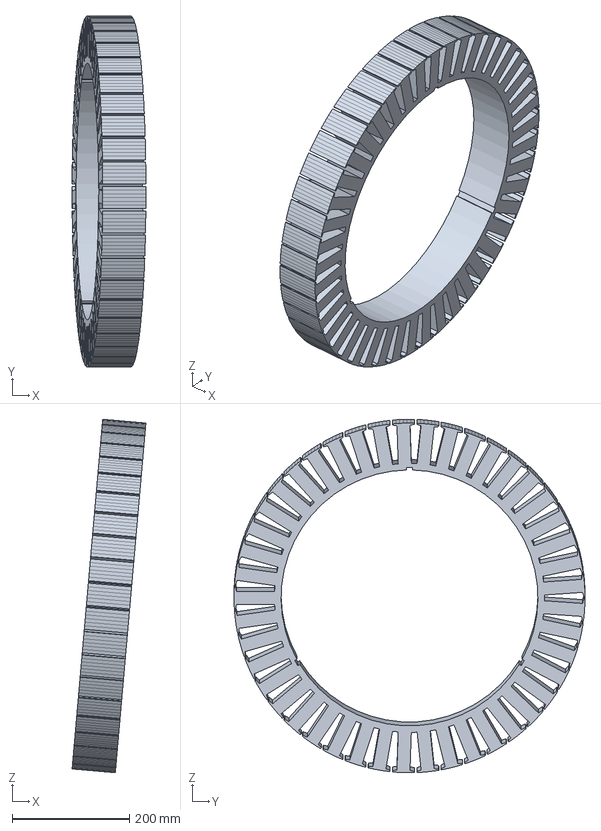
[picture p307: CAD file, 2026-11-03]
cad/nacelle_fitcheck/out/step/NP1-201_stator_core.step
125.8 x 598.0 x 602.2 mm
