safarcikm/Wind-turbines/cad/nacelle_fitcheck/out/step/NP1-230_brake_disc.step

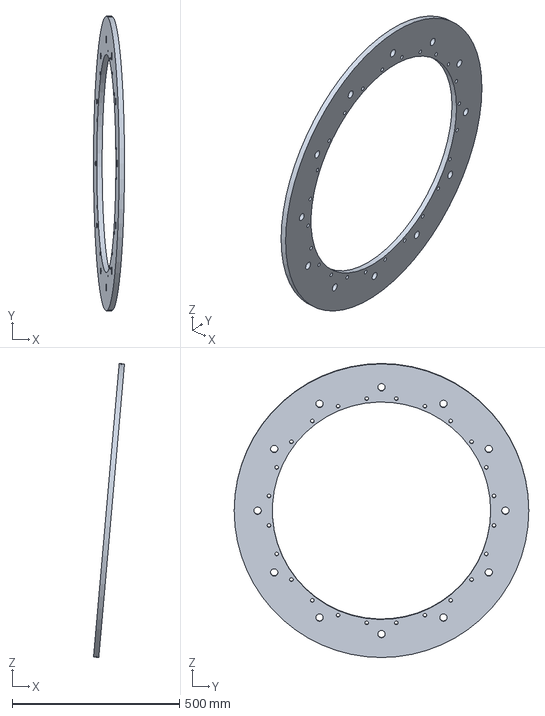
[picture p308: CAD file, 2026-11-03]
cad/nacelle_fitcheck/out/step/NP1-230_brake_disc.step
92.6 x 880.0 x 878.0 mm
