safarcikm/Wind-turbines/cad/nacelle_fitcheck/out/step/NP1-300-3_bedplate_side_plate_left.step

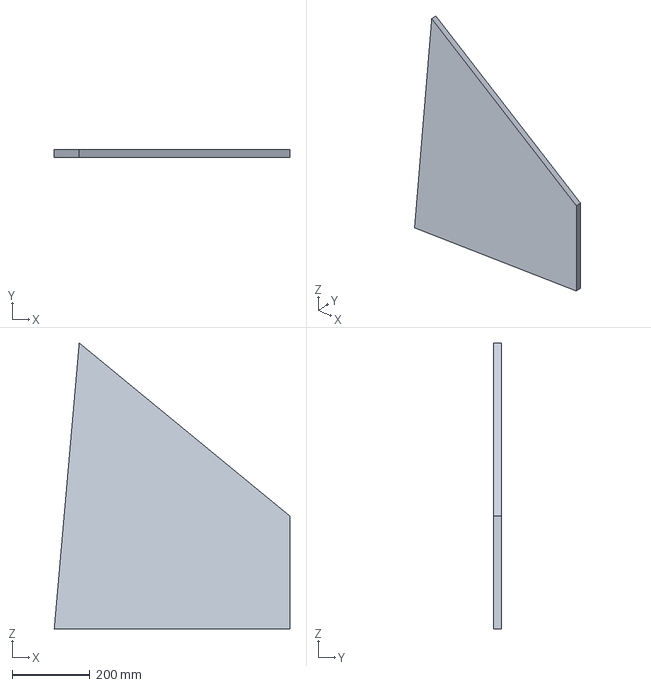
[picture p309: CAD file, 2026-11-03]
cad/nacelle_fitcheck/out/step/NP1-300-3_bedplate_side_plate_left.step
604.4 x 20.0 x 733.7 mm
