safarcikm/Wind-turbines/cad/nacelle_fitcheck/out/step/NP1-101_front_spacer.step

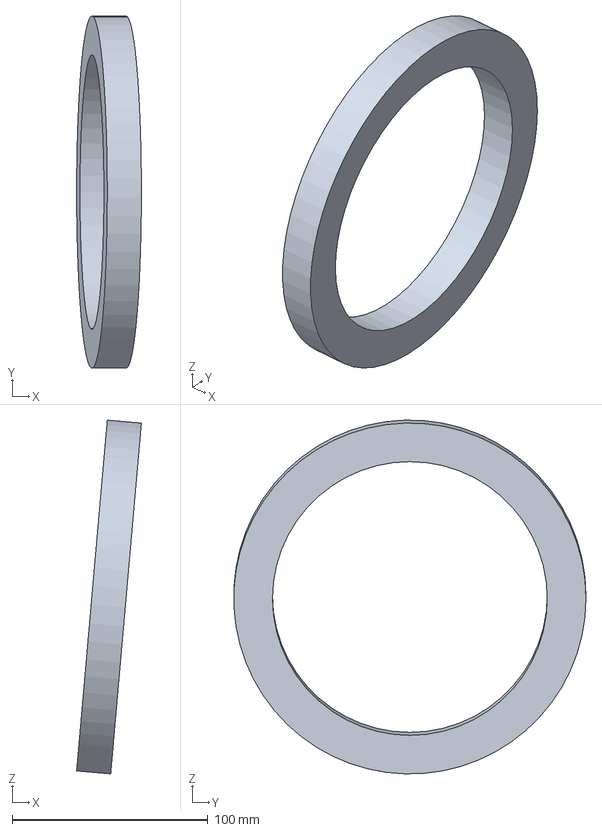
[picture p310: CAD file, 2026-11-03]
cad/nacelle_fitcheck/out/step/NP1-101_front_spacer.step
33.1 x 179.9 x 180.8 mm
