safarcikm/Wind-turbines/cad/nacelle_fitcheck/out/step/KMT27_locknut_envelope.step

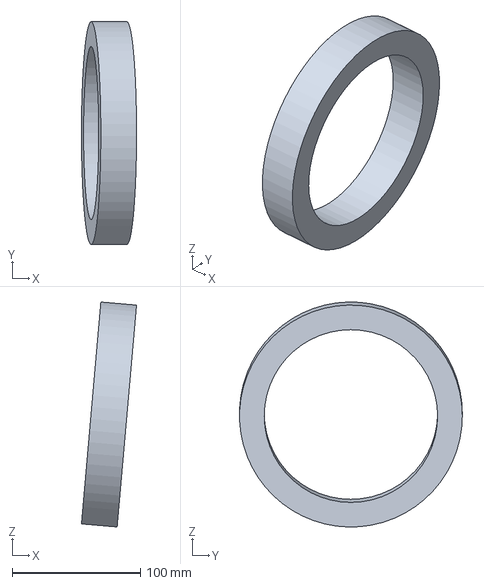
[picture p311: CAD file, 2026-11-03]
cad/nacelle_fitcheck/out/step/KMT27_locknut_envelope.step
43.1 x 173.9 x 175.7 mm
