safarcikm/Wind-turbines/cad/nacelle_fitcheck/out/step/NP1-212_drum_rear_cover.step

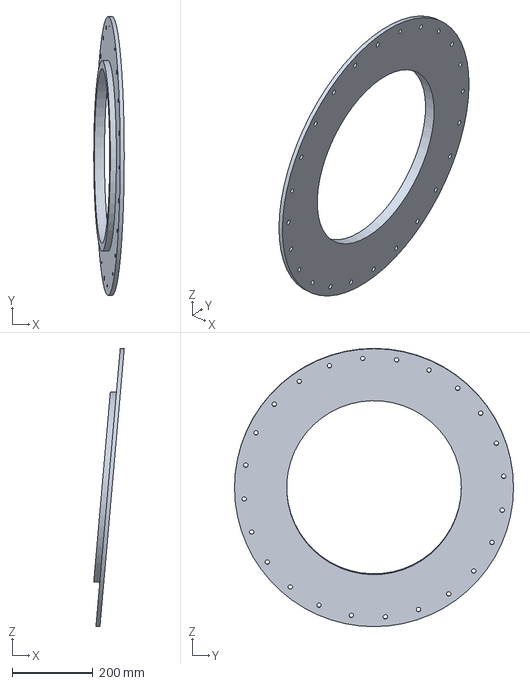
[picture p312: CAD file, 2026-11-03]
cad/nacelle_fitcheck/out/step/NP1-212_drum_rear_cover.step
75.5 x 690.0 x 688.2 mm
