safarcikm/Wind-turbines/cad/nacelle_fitcheck/out/step/NP1-300-2_bedplate_bottom_plate.step

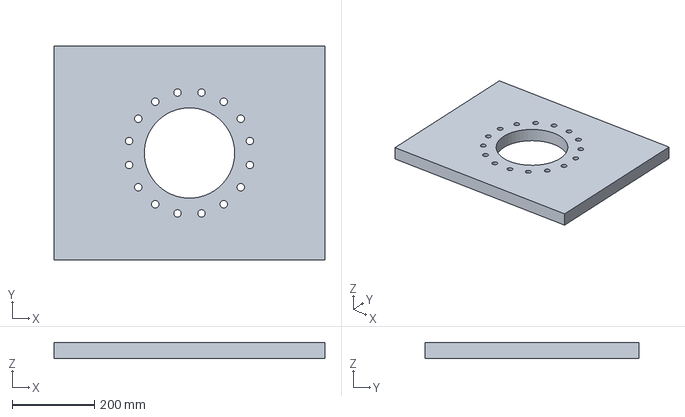
[picture p313: CAD file, 2026-11-03]
cad/nacelle_fitcheck/out/step/NP1-300-2_bedplate_bottom_plate.step
660.0 x 520.0 x 40.0 mm
