safarcikm/Wind-turbines/cad/nacelle_fitcheck/out/step/NP1-300-1_bedplate_front_plate.step

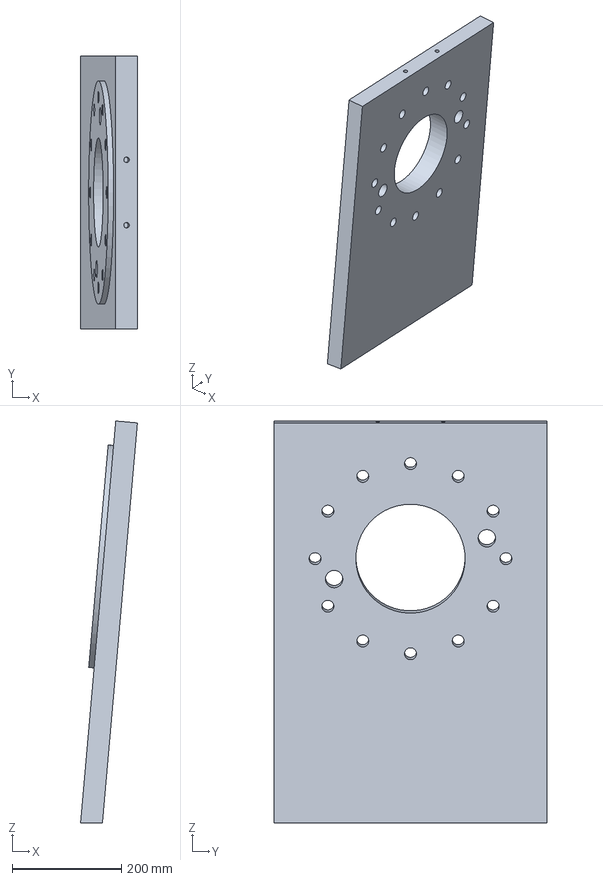
[picture p314: CAD file, 2026-11-03]
cad/nacelle_fitcheck/out/step/NP1-300-1_bedplate_front_plate.step
104.3 x 500.0 x 737.2 mm
