safarcikm/Wind-turbines/cad/nacelle_fitcheck/out/step/stator_key_090.step

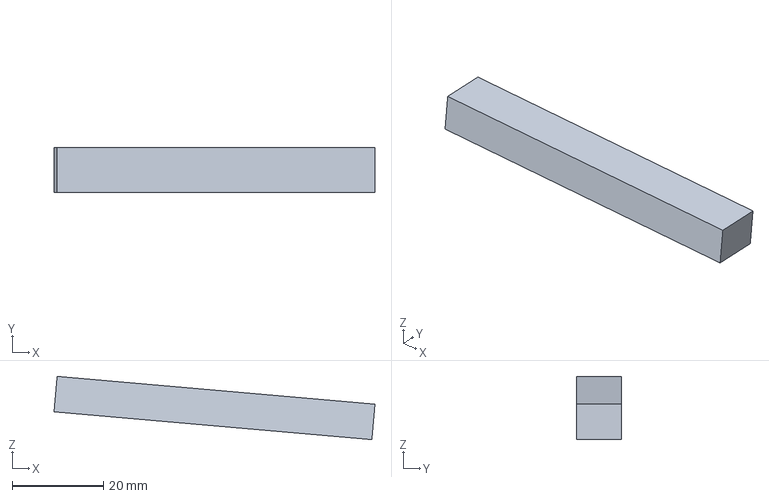
[picture p315: CAD file, 2026-11-03]
cad/nacelle_fitcheck/out/step/stator_key_090.step
70.4 x 9.80 x 13.9 mm
