safarcikm/Wind-turbines/cad/nacelle_fitcheck/out/step/NP1-321_lock_pin_holder.step

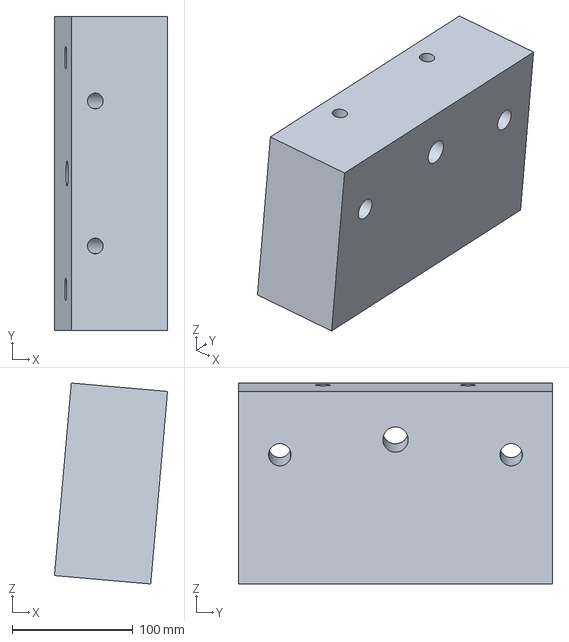
[picture p316: CAD file, 2026-11-03]
cad/nacelle_fitcheck/out/step/NP1-321_lock_pin_holder.step
93.6 x 260.0 x 166.4 mm
