safarcikm/Wind-turbines/(list of files, cad)

Other CAD files:
cad/nacelle_p1/out/dxf/NP1-110.dxf
cad/generator_rc/out/dxf/NP1-223C.dxf
cad/nacelle_p1/out/dxf/NP1-220.dxf
cad/turbine_6kw/out/dxf/NS6-001.dxf
cad/yaw/out/dxf/NY-460.dxf
cad/nacelle_p1/out/dxf/NP1-201.dxf
cad/generator_rc/out/dxf/NP1-221C.dxf
cad/generator_rc/out/dxf/NP1-220E.dxf
cad/turbine_6kw/out/dxf/NS6-002.dxf
cad/generator_rc/out/dxf/NP1-201C.dxf
cad/nacelle_p1/out/dxf/NP1-100.dxf
cad/nacelle_w/out/step/pitch_drive_210_envelope.step
cad/turbine_6kw/out/dxf/NS6-910.dxf
cad/turbine_6kw/out/dxf/NS6-900.dxf
cad/nacelle_w/out/step/NW-520-210_pitch_drive_bracket.step
cad/nacelle_w/out/step/NW-530-330_blade_root_stub.step
cad/nacelle_w/out/step/NW-511-330_ball_filling_plug.step
cad/nacelle_w/out/step/pitch_encoder_210_envelope.step
cad/turbine_6kw/out/dxf/NS6-130.dxf
cad/nacelle_w/out/step/hub_electronics_150_envelope.step
cad/nacelle_w/out/step/NW-430_yaw_bearing_inner_ring_twin.step
cad/turbine_6kw/out/dxf/NS6-003.dxf
cad/nacelle_fitcheck/out/step/yaw_brake_caliper_right_envelope.step
cad/nacelle_w/out/step/NW-510-210_pitch_bearing_outer_ring.step
cad/nacelle_fitcheck/out/step/NP1-310_rotor_caliper_bracket_right.step
cad/nacelle_w/out/step/NW-510-330_pitch_bearing_inner_ring.step
cad/nacelle_fitcheck/out/step/brake_caliper_right_envelope.step
cad/nacelle_fitcheck/out/step/yaw_drive_right_envelope.step
cad/nacelle_fitcheck/out/step/NP1-420_yaw_drive_bracket_left.step
cad/nacelle_fitcheck/out/step/overspeed_sensor_105_envelope.step
cad/nacelle_fitcheck/out/step/NP1-300-3_bedplate_side_plate_right.step
cad/nacelle_fitcheck/out/step/stator_end_winding_front_envelope.step
cad/nacelle_fitcheck/out/step/stator_key_210.step
cad/nacelle_fitcheck/out/step/32028X_front_cone_envelope.step
cad/nacelle_fitcheck/out/step/32028X_front_cup_envelope.step
cad/nacelle_fitcheck/out/step/32028X_rear_cone_envelope.step
cad/nacelle_fitcheck/out/step/32028X_rear_cup_envelope.step
cad/nacelle_fitcheck/out/stl/32028X_front_cone_envelope.stl
cad/nacelle_fitcheck/out/stl/32028X_front_cup_envelope.stl
cad/nacelle_fitcheck/out/stl/32028X_rear_cone_envelope.stl
cad/nacelle_fitcheck/out/stl/32028X_rear_cup_envelope.stl
cad/nacelle_fitcheck/out/stl/KMT27_locknut_envelope.stl
cad/nacelle_fitcheck/out/stl/NP1-100_spindle.stl
cad/nacelle_fitcheck/out/stl/NP1-101_front_spacer.stl
cad/nacelle_fitcheck/out/stl/NP1-102_rear_seal_sleeve.stl
cad/nacelle_fitcheck/out/stl/NP1-110_cooling_insert.stl
cad/nacelle_fitcheck/out/stl/NP1-200_stator_carrier.stl
cad/nacelle_fitcheck/out/stl/NP1-201_stator_core.stl
cad/nacelle_fitcheck/out/stl/NP1-202_stator_clamp_ring.stl
cad/nacelle_fitcheck/out/stl/NP1-210_rotor_drum.stl
cad/nacelle_fitcheck/out/stl/NP1-211_front_seal_cover.stl
cad/nacelle_fitcheck/out/stl/NP1-211_rear_seal_cover.stl
cad/nacelle_fitcheck/out/stl/NP1-212_drum_rear_cover.stl
cad/nacelle_fitcheck/out/stl/NP1-220_magnet_ring.stl
cad/nacelle_fitcheck/out/stl/NP1-230_brake_disc.stl
cad/nacelle_fitcheck/out/stl/NP1-300-1_bedplate_front_plate.stl
cad/nacelle_fitcheck/out/stl/NP1-300-2_bedplate_bottom_plate.stl
cad/nacelle_fitcheck/out/stl/NP1-300-3_bedplate_side_plate_left.stl
cad/nacelle_fitcheck/out/stl/NP1-300-3_bedplate_side_plate_right.stl
cad/nacelle_fitcheck/out/stl/NP1-300-4_bedplate_rear_plate.stl
cad/nacelle_fitcheck/out/stl/NP1-310_rotor_caliper_bracket_left.stl
cad/nacelle_fitcheck/out/stl/NP1-310_rotor_caliper_bracket_right.stl
cad/nacelle_fitcheck/out/stl/NP1-320_lock_pin.stl
cad/nacelle_fitcheck/out/stl/NP1-321_lock_pin_holder.stl
cad/nacelle_fitcheck/out/stl/NP1-400_tower_top_adapter.stl
cad/nacelle_fitcheck/out/stl/NP1-420_yaw_drive_bracket_left.stl
cad/nacelle_fitcheck/out/stl/NP1-420_yaw_drive_bracket_right.stl
cad/nacelle_fitcheck/out/stl/NP1-600_dummy_hub.stl
cad/nacelle_fitcheck/out/stl/brake_caliper_left_envelope.stl
cad/nacelle_fitcheck/out/stl/brake_caliper_right_envelope.stl
cad/nacelle_fitcheck/out/stl/overspeed_sensor_075_envelope.stl
cad/nacelle_fitcheck/out/stl/overspeed_sensor_105_envelope.stl
cad/nacelle_fitcheck/out/stl/stator_end_winding_front_envelope.stl
cad/nacelle_fitcheck/out/stl/stator_end_winding_rear_envelope.stl
cad/nacelle_fitcheck/out/stl/stator_key_090.stl
cad/nacelle_fitcheck/out/stl/stator_key_210.stl
cad/nacelle_fitcheck/out/stl/stator_key_330.stl
cad/nacelle_fitcheck/out/stl/tower_top_flange_stub.stl
cad/nacelle_fitcheck/out/stl/yaw_bearing_inner_ring_envelope.stl
cad/nacelle_fitcheck/out/stl/yaw_bearing_outer_gear_ring_envelope.stl
cad/nacelle_fitcheck/out/stl/yaw_brake_caliper_left_envelope.stl
cad/nacelle_fitcheck/out/stl/yaw_brake_caliper_right_envelope.stl
cad/nacelle_fitcheck/out/stl/yaw_drive_left_envelope.stl
cad/nacelle_fitcheck/out/stl/yaw_drive_right_envelope.stl
cad/nacelle_w/out/stl/NW-430_yaw_bearing_inner_ring_twin.stl
cad/nacelle_w/out/stl/NW-430_yaw_bearing_outer_gear_ring_twin.stl
cad/nacelle_w/out/stl/NW-500_hub.stl
cad/nacelle_w/out/stl/NW-510-090_pitch_bearing_inner_ring.stl
cad/nacelle_w/out/stl/NW-510-090_pitch_bearing_outer_ring.stl
cad/nacelle_w/out/stl/NW-510-210_pitch_bearing_inner_ring.stl
cad/nacelle_w/out/stl/NW-510-210_pitch_bearing_outer_ring.stl
cad/nacelle_w/out/stl/NW-510-330_pitch_bearing_inner_ring.stl
cad/nacelle_w/out/stl/NW-510-330_pitch_bearing_outer_ring.stl
cad/nacelle_w/out/stl/NW-511-090_ball_filling_plug.stl
cad/nacelle_w/out/stl/NW-511-210_ball_filling_plug.stl
cad/nacelle_w/out/stl/NW-511-330_ball_filling_plug.stl
cad/nacelle_w/out/stl/NW-520-090_pitch_drive_bracket.stl
cad/nacelle_w/out/stl/NW-520-210_pitch_drive_bracket.stl
cad/nacelle_w/out/stl/NW-520-330_pitch_drive_bracket.stl
cad/nacelle_w/out/stl/NW-530-090_blade_root_stub.stl
cad/nacelle_w/out/stl/NW-530-210_blade_root_stub.stl
cad/nacelle_w/out/stl/NW-530-330_blade_root_stub.stl
cad/nacelle_w/out/stl/hub_electronics_030_envelope.stl
cad/nacelle_w/out/stl/hub_electronics_150_envelope.stl
cad/nacelle_w/out/stl/hub_electronics_270_envelope.stl
cad/nacelle_w/out/stl/pitch_drive_090_envelope.stl
cad/nacelle_w/out/stl/pitch_drive_210_envelope.stl
cad/nacelle_w/out/stl/pitch_drive_330_envelope.stl
cad/nacelle_w/out/stl/pitch_encoder_090_envelope.stl
cad/nacelle_w/out/stl/pitch_encoder_210_envelope.stl
cad/nacelle_w/out/stl/pitch_encoder_330_envelope.stl
cad/nacelle_w/out/stl/slip_ring_encoder_envelope.stl
