safarcikm/Wind-turbines/cad/nacelle_fitcheck/out/assembly_check.md

# Nacelle P1 digital fit check (geometry Rev B)

Generated by `assembly_check.py` from the same 1:1 solids that are printed. Bearing, caliper and yaw-bearing envelopes are estimates until supplier drawings arrive.

## 1. Static interference in the assembled position (3-D)

Pairs whose solids overlap by more than 5.0 mm³:

| Part A | Part B | Overlap mm³ |
|---|---|---|
| none | | |

## 2. Running clearance, rotating vs stationary (revolved sections)

Gaps below 3.0 mm (the air gap is 2.5 mm to the magnet face by design):

| Rotating | Stationary | Min gap mm | Status |
|---|---|---|---|
| NP1-211_front_seal_cover | NP1-101_front_spacer | 1.5 | by design |
| NP1-211_rear_seal_cover | NP1-102_rear_seal_sleeve | 1.5 | by design |
| 32028X_front_cup_envelope | 32028X_front_cone_envelope | 1.57 | by design |
| 32028X_rear_cup_envelope | 32028X_rear_cone_envelope | 1.57 | by design |
| NP1-220_magnet_ring | NP1-201_stator_core | 2.5 | by design |

## 2b. Yaw clearance, nacelle vs tower-top parts over a full yaw turn

Gaps below 15.0 mm (pinion/gear mesh and the two yaw bearing rings excluded):

| Nacelle part | Tower part | Min gap mm |
|---|---|---|
| yaw_brake_caliper_left_envelope | NP1-400_tower_top_adapter | 3.0 |
| yaw_brake_caliper_right_envelope | NP1-400_tower_top_adapter | 3.0 |
| yaw_drive_left_envelope | NP1-400_tower_top_adapter | 5.0 |
| yaw_drive_right_envelope | NP1-400_tower_top_adapter | 5.0 |
| NP1-300-2_bedplate_bottom_plate | yaw_bearing_outer_gear_ring_envelope | 10.0 |
| yaw_bearing_inner_ring_envelope | NP1-400_tower_top_adapter | 10.0 |
| NP1-420_yaw_drive_bracket_left | yaw_bearing_outer_gear_ring_envelope | 10.0 |
| NP1-420_yaw_drive_bracket_right | yaw_bearing_outer_gear_ring_envelope | 10.0 |

## 3. Assembly path along the spindle axis (Rev B order, doc 17 §3.3)

| Stage | Step | Arrives from | Result | Blocked by (x range, r range, overlap mm²) |
|---|---|---|---|---|
| 1 stator | stack onto carrier | front | OK |  |
| 1 stator | clamp ring | front | OK |  |
| 2 rotor | front cup into drum | front | OK |  |
| 2 rotor | rear cup into drum | rear | OK |  |
| 2 rotor | rear seal cover onto the drum housing | rear | OK |  |
| 2 rotor | brake disc onto drum from the front (magnets fitted) | front | OK |  |
| 3 spindle | stator assembly onto the bare spindle | front | OK |  |
| 3 spindle | rear seal sleeve onto the Ø155 shoulder | front | OK |  |
| 3 spindle | rear cone after stator and sleeve | front | OK |  |
| 4 drum on spindle | complete rotor (drum, cups, magnets, rear seal cover, disc) | front | OK |  |
| 5 front bearing | front cone | front | OK |  |
| 5 front bearing | spacer | front | OK |  |
| 5 front bearing | locknut | front | OK |  |
| 5 front bearing | front seal cover after the nut and rolling-torque check | front | OK |  |
| 6 rear cover | rear cover over the spindle flange | rear | OK |  |
| 7 bedplate | front plate onto the spigot | rear | OK |  |
| 8 bench | dummy hub onto drum | front | OK |  |

## 4. Section overlaps in the assembled position (2-D, revolved parts)

| Part A | Part B | x range | r range | mm² |
|---|---|---|---|---|
| none | | | | |
