safarcikm/Wind-turbines/cad/turbine_6kw/out/iso/steps/S13.png

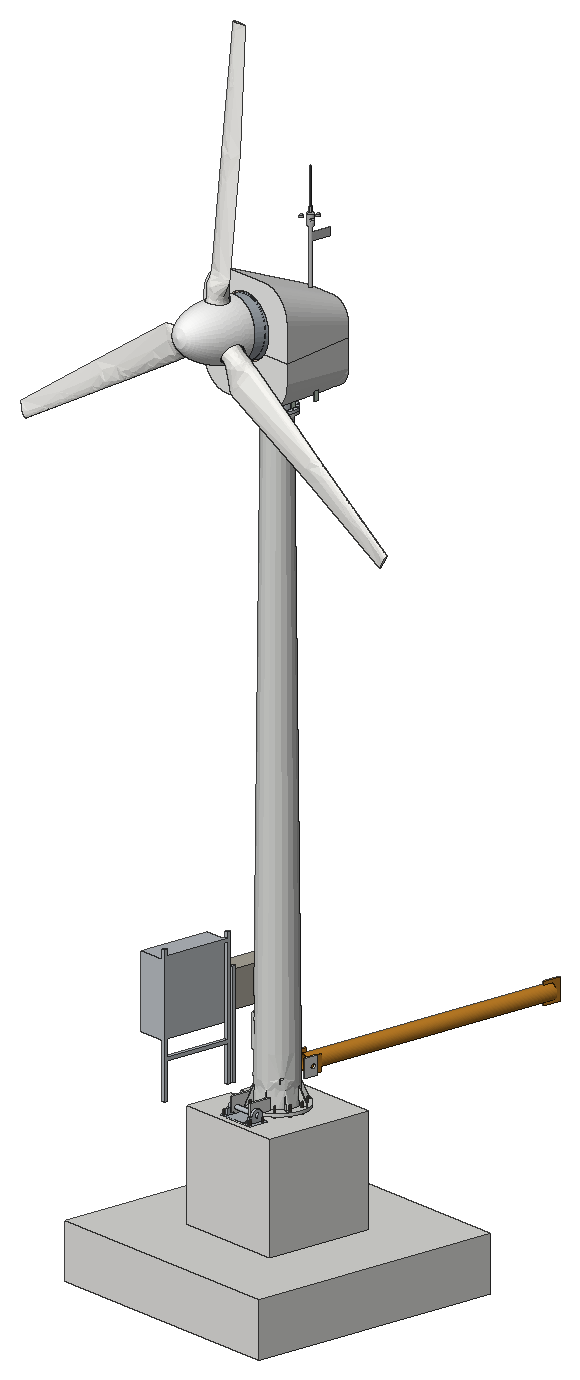
cad/turbine_6kw/out/iso/steps/S13.png
