safarcikm/Wind-turbines/analysis/size_tsr_map/results/size_tsr_map.html

Wind turbine · doc 27 · decision map · 2026-11-06

# Turbine size and tip speed ratio map

Every combination of rated power 4–20 kW and design TSR 4–8, sized by the project's own BEM rotor model and calibrated to the two designed turbines (current Ø7.5 m at 178 rpm, V5 Ø8.3 m at 110 rpm). Pick a metric, a site and a rated wind speed. Click any cell for the full numbers. Hatched cells break the tip-speed or noise limit you set.

Show on map

Site (mean wind at 18 m hub)

Rated wind speed

Tip speed limit, m/s

Noise limit, dB(A)

at distance, m

## Map

breaks a limit selected C current · V V5 · ★ best cost of energy within limits

Selected design

## The three 12 kW designs on the table

Exact geometry of each design, not the sizing rule. Cost of energy uses the site picked above.

## What the map says

## How the numbers are made
