safarcikm/Wind-turbines/analysis/generator/results/coil_connection.csv

tooth | phase | sense | series_position
1 | A | + | 1
2 | A | - | 2
3 | A | + | 3
4 | C | + | 1
5 | C | - | 2
6 | C | + | 3
7 | B | + | 1
8 | B | - | 2
9 | B | + | 3
10 | A | + | 4
11 | A | - | 5
12 | A | + | 6
13 | C | + | 4
14 | C | - | 5
15 | C | + | 6
16 | B | + | 4
17 | B | - | 5
18 | B | + | 6
19 | A | + | 7
20 | A | - | 8
21 | A | + | 9
22 | C | + | 7
23 | C | - | 8
24 | C | + | 9
25 | B | + | 7
26 | B | - | 8
27 | B | + | 9
28 | A | + | 10
29 | A | - | 11
30 | A | + | 12
31 | C | + | 10
32 | C | - | 11
33 | C | + | 12
34 | B | + | 10
35 | B | - | 11
36 | B | + | 12
37 | A | + | 13
38 | A | - | 14
39 | A | + | 15
40 | C | + | 13
41 | C | - | 14
42 | C | + | 15
43 | B | + | 13
44 | B | - | 14
45 | B | + | 15
