safarcikm/Wind-turbines/analysis/generator/results/radial_sweep.csv

topology | D_gap_m | L_m | poles | slots | freq_Hz | freq_overspeed_Hz | winding_factor | pole_pitch_mm | magnet_thickness_mm | Bg_T | B1_T | shear_stress_kPa | A_kA_per_m | J_A_per_mm2 | slot_depth_mm | tooth_width_mm | stator_yoke_mm | rotor_yoke_mm | outer_diameter_m | mass_magnet_kg | mass_copper_kg | mass_lamination_kg | mass_rotor_yoke_kg | mass_active_kg | loss_cu_W | loss_cu_hot_W | loss_fe_W | loss_total_W | efficiency | radial_magnetic_pressure_kN
radial_outer_rotor | 0.45 | 0.122 | 32 | 36 | 47.5 | 61.3 | 0.945 | 44.2 | 7.4 | 0.85 | 1.03 | 20.6 | 30.0 | 3.5 | 46.7 | 20.9 | 10.7 | 10.7 | 0.49 | 7.7 | 18.7 | 41.9 | 15.5 | 83.8 | 535 | 612 | 169 | 813 | 0.9402 | 49.6
radial_outer_rotor | 0.5 | 0.099 | 32 | 36 | 47.5 | 61.3 | 0.945 | 49.1 | 7.4 | 0.85 | 1.03 | 20.6 | 30.0 | 3.5 | 46.7 | 23.2 | 11.9 | 11.9 | 0.543 | 6.9 | 18.7 | 39.1 | 15.4 | 80.1 | 534 | 611 | 157 | 799 | 0.9412 | 44.7
radial_outer_rotor | 0.55 | 0.082 | 32 | 36 | 47.5 | 61.3 | 0.945 | 54.0 | 7.4 | 0.85 | 1.03 | 20.6 | 30.0 | 3.5 | 46.7 | 25.5 | 13.1 | 13.1 | 0.595 | 6.3 | 19.0 | 36.7 | 15.4 | 77.4 | 544 | 623 | 146 | 799 | 0.9412 | 40.6
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
