safarcikm/Wind-turbines/analysis/rotor/results/blade_geometry_D7.5.csv

r_m | r_over_R | chord_m | twist_deg
0.405 | 0.108 | 0.1916 | 19.88
0.423 | 0.113 | 0.1958 | 19.88
0.459 | 0.122 | 0.2088 | 19.88
0.513 | 0.137 | 0.2365 | 19.88
0.585 | 0.156 | 0.2797 | 19.88
0.672 | 0.179 | 0.3262 | 19.88
0.775 | 0.207 | 0.3419 | 18.60
0.892 | 0.238 | 0.3347 | 16.09
1.022 | 0.273 | 0.3267 | 13.79
1.164 | 0.310 | 0.3180 | 11.74
1.316 | 0.351 | 0.3087 | 9.95
1.476 | 0.393 | 0.2989 | 8.40
1.642 | 0.438 | 0.2887 | 7.07
1.813 | 0.484 | 0.2781 | 5.93
1.987 | 0.530 | 0.2675 | 4.95
2.163 | 0.577 | 0.2567 | 4.12
2.337 | 0.623 | 0.2460 | 3.41
2.508 | 0.669 | 0.2355 | 2.80
2.674 | 0.713 | 0.2253 | 2.28
2.834 | 0.756 | 0.2155 | 1.83
2.986 | 0.796 | 0.2062 | 1.45
3.128 | 0.834 | 0.1975 | 1.13
3.258 | 0.869 | 0.1895 | 0.86
3.375 | 0.900 | 0.1823 | 0.63
3.478 | 0.927 | 0.1760 | 0.44
3.565 | 0.951 | 0.1706 | 0.29
3.637 | 0.970 | 0.1662 | 0.17
3.691 | 0.984 | 0.1629 | 0.09
3.727 | 0.994 | 0.1607 | 0.03
3.745 | 0.999 | 0.1596 | 0.00
