safarcikm/Wind-turbines/analysis/rotor/results/power_curve_D7.0_clean.csv

V | rpm | pitch | P_aero | P_elec | Cp | Ct | thrust | torque | M_flap
2 | 35.47 | 0 | 90.1 | 0 | 0.4778 | 0.8051 | 75.91 | 24.26 | 50.38
2.5 | 44.34 | 0 | 176 | 36.83 | 0.4778 | 0.8051 | 118.6 | 37.9 | 78.71
3 | 53.2 | 0 | 304.1 | 151 | 0.4778 | 0.8051 | 170.8 | 54.58 | 113.3
3.5 | 62.07 | 0 | 482.9 | 310.3 | 0.4778 | 0.8051 | 232.5 | 74.29 | 154.3
4 | 70.94 | 0 | 720.8 | 522.4 | 0.4778 | 0.8051 | 303.6 | 97.03 | 201.5
4.5 | 79.8 | 0 | 1026 | 794.6 | 0.4778 | 0.8051 | 384.3 | 122.8 | 255
5 | 88.67 | 0 | 1408 | 1135 | 0.4778 | 0.8051 | 474.4 | 151.6 | 314.9
5.5 | 97.54 | 0 | 1874 | 1550 | 0.4778 | 0.8051 | 574.1 | 183.5 | 381
6 | 106.4 | 0 | 2433 | 2048 | 0.4778 | 0.8051 | 683.2 | 218.3 | 453.4
6.5 | 115.3 | 0 | 3093 | 2636 | 0.4778 | 0.8051 | 801.8 | 256.2 | 532.1
7 | 124.1 | 0 | 3863 | 3323 | 0.4778 | 0.8051 | 929.9 | 297.2 | 617.1
7.5 | 133 | 0 | 4751 | 4114 | 0.4778 | 0.8051 | 1068 | 341.1 | 708.4
8 | 141.9 | 0 | 5766 | 5019 | 0.4778 | 0.8051 | 1215 | 388.1 | 806
8.5 | 150.7 | 0 | 6917 | 6044 | 0.4778 | 0.8051 | 1371 | 438.2 | 909.9
9 | 159.6 | 0 | 8210 | 7197 | 0.4778 | 0.8051 | 1537 | 491.2 | 1020
9.5 | 168.5 | 0 | 9656 | 8486 | 0.4778 | 0.8051 | 1713 | 547.3 | 1137
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
