safarcikm/Wind-turbines/analysis/rotor/results/power_curve_D7.0_rough.csv

V | rpm | pitch | P_aero | P_elec | Cp | Ct | thrust | torque | M_flap
2 | 38.2 | -0.5 | 84.51 | 0 | 0.4482 | 0.8124 | 76.6 | 21.13 | 51.25
2.5 | 47.75 | -0.5 | 165.1 | 27.1 | 0.4482 | 0.8124 | 119.7 | 33.01 | 80.09
3 | 57.3 | -0.5 | 285.2 | 134.2 | 0.4482 | 0.8124 | 172.3 | 47.54 | 115.3
3.5 | 66.85 | -0.5 | 452.9 | 283.6 | 0.4482 | 0.8124 | 234.6 | 64.7 | 157
4 | 76.39 | -0.5 | 676.1 | 482.5 | 0.4482 | 0.8124 | 306.4 | 84.51 | 205
4.5 | 85.94 | -0.5 | 962.6 | 737.9 | 0.4482 | 0.8124 | 387.8 | 107 | 259.5
5 | 95.49 | -0.5 | 1320 | 1057 | 0.4482 | 0.8124 | 478.7 | 132 | 320.3
5.5 | 105 | -0.5 | 1758 | 1446 | 0.4482 | 0.8124 | 579.3 | 159.8 | 387.6
6 | 114.6 | -0.5 | 2282 | 1913 | 0.4482 | 0.8124 | 689.4 | 190.1 | 461.3
6.5 | 124.1 | -0.5 | 2901 | 2465 | 0.4482 | 0.8124 | 809.1 | 223.2 | 541.4
7 | 133.7 | -0.5 | 3623 | 3109 | 0.4482 | 0.8124 | 938.3 | 258.8 | 627.9
7.5 | 143.2 | -0.5 | 4457 | 3852 | 0.4482 | 0.8124 | 1077 | 297.1 | 720.8
8 | 152.8 | -0.5 | 5409 | 4700 | 0.4482 | 0.8124 | 1226 | 338 | 820.1
8.5 | 162.3 | -0.5 | 6487 | 5661 | 0.4482 | 0.8124 | 1384 | 381.6 | 925.8
9 | 171.9 | -0.5 | 7701 | 6743 | 0.4482 | 0.8124 | 1551 | 427.8 | 1038
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
