safarcikm/Wind-turbines/analysis/rotor/results/power_curve_D7.5_clean.csv

V | rpm | pitch | P_aero | P_elec | Cp | Ct | thrust | torque | M_flap
2 | 33.1 | 0 | 103.5 | 0 | 0.4781 | 0.8056 | 87.2 | 29.85 | 62.79
2.5 | 41.38 | 0 | 202.1 | 60.13 | 0.4781 | 0.8056 | 136.2 | 46.65 | 98.11
3 | 49.66 | 0 | 349.3 | 191.3 | 0.4781 | 0.8056 | 196.2 | 67.17 | 141.3
3.5 | 57.93 | 0 | 554.6 | 374.3 | 0.4781 | 0.8056 | 267 | 91.42 | 192.3
4 | 66.21 | 0 | 827.9 | 617.8 | 0.4781 | 0.8056 | 348.8 | 119.4 | 251.2
4.5 | 74.48 | 0 | 1179 | 930.5 | 0.4781 | 0.8056 | 441.4 | 151.1 | 317.9
5 | 82.76 | 0 | 1617 | 1321 | 0.4781 | 0.8056 | 545 | 186.6 | 392.5
5.5 | 91.04 | 0 | 2152 | 1798 | 0.4781 | 0.8056 | 659.4 | 225.8 | 474.9
6 | 99.31 | 0 | 2794 | 2370 | 0.4781 | 0.8056 | 784.8 | 268.7 | 565.1
6.5 | 107.6 | 0 | 3553 | 3046 | 0.4781 | 0.8056 | 921 | 315.3 | 663.3
7 | 115.9 | 0 | 4437 | 3834 | 0.4781 | 0.8056 | 1068 | 365.7 | 769.2
7.5 | 124.1 | 0 | 5457 | 4744 | 0.4781 | 0.8056 | 1226 | 419.8 | 883
8 | 132.4 | 0 | 6623 | 5783 | 0.4781 | 0.8056 | 1395 | 477.6 | 1005
8.5 | 140.7 | 0 | 7944 | 6960 | 0.4781 | 0.8056 | 1575 | 539.2 | 1134
9 | 149 | 0 | 9431 | 8284 | 0.4781 | 0.8056 | 1766 | 604.5 | 1272
9.5 | 157.2 | 0 | 1.109e+04 | 9764 | 0.4781 | 0.8056 | 1967 | 673.6 | 1417
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
