safarcikm/Wind-turbines/analysis/blade/results/blade_layup.png

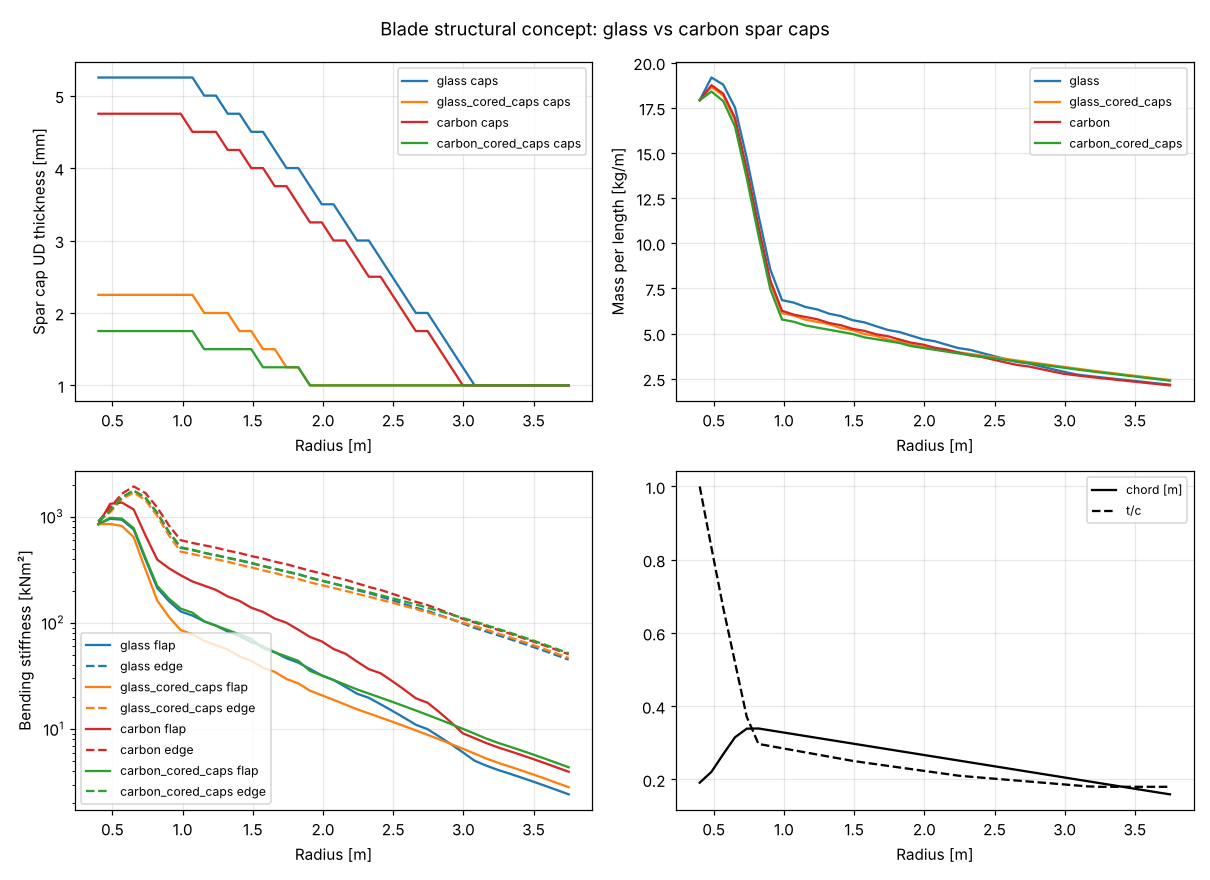
analysis/blade/results/blade_layup.png
