safarcikm/Wind-turbines/analysis/blade/results/blade_sections.png

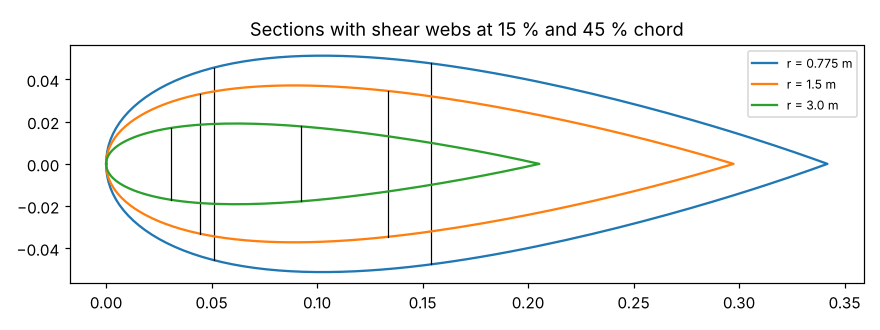
analysis/blade/results/blade_sections.png
