safarcikm/Wind-turbines/analysis/generator/results/iter2/fea_cogging.png

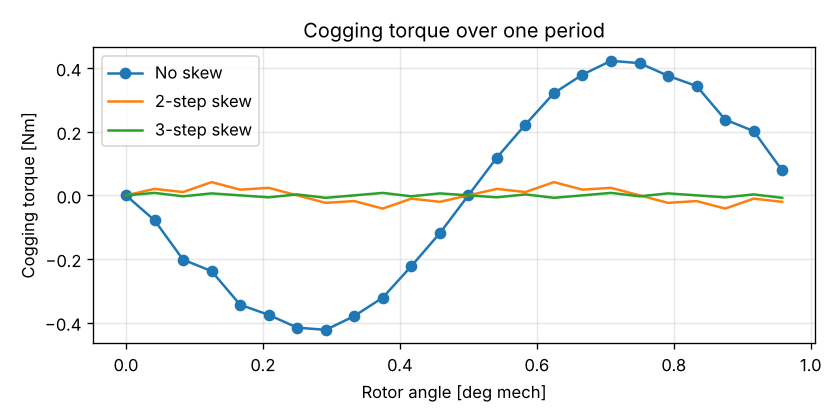
analysis/generator/results/iter2/fea_cogging.png
