safarcikm/Wind-turbines/analysis/generator/results/iter2/fea_demag.png

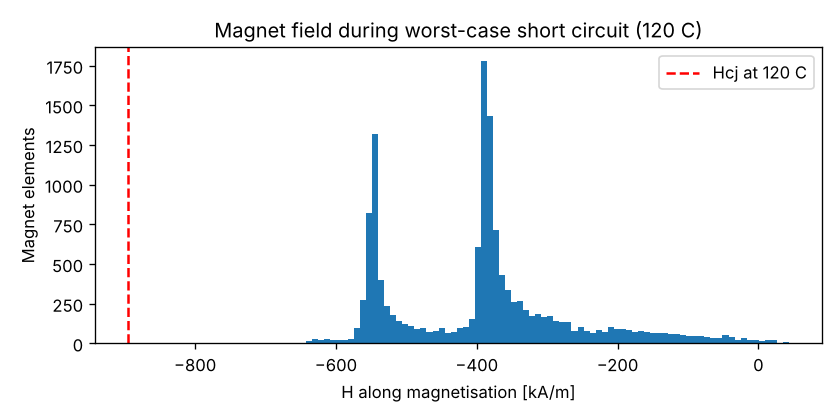
analysis/generator/results/iter2/fea_demag.png
