safarcikm/Wind-turbines/analysis/loads/results/final/dlc_estop25.png

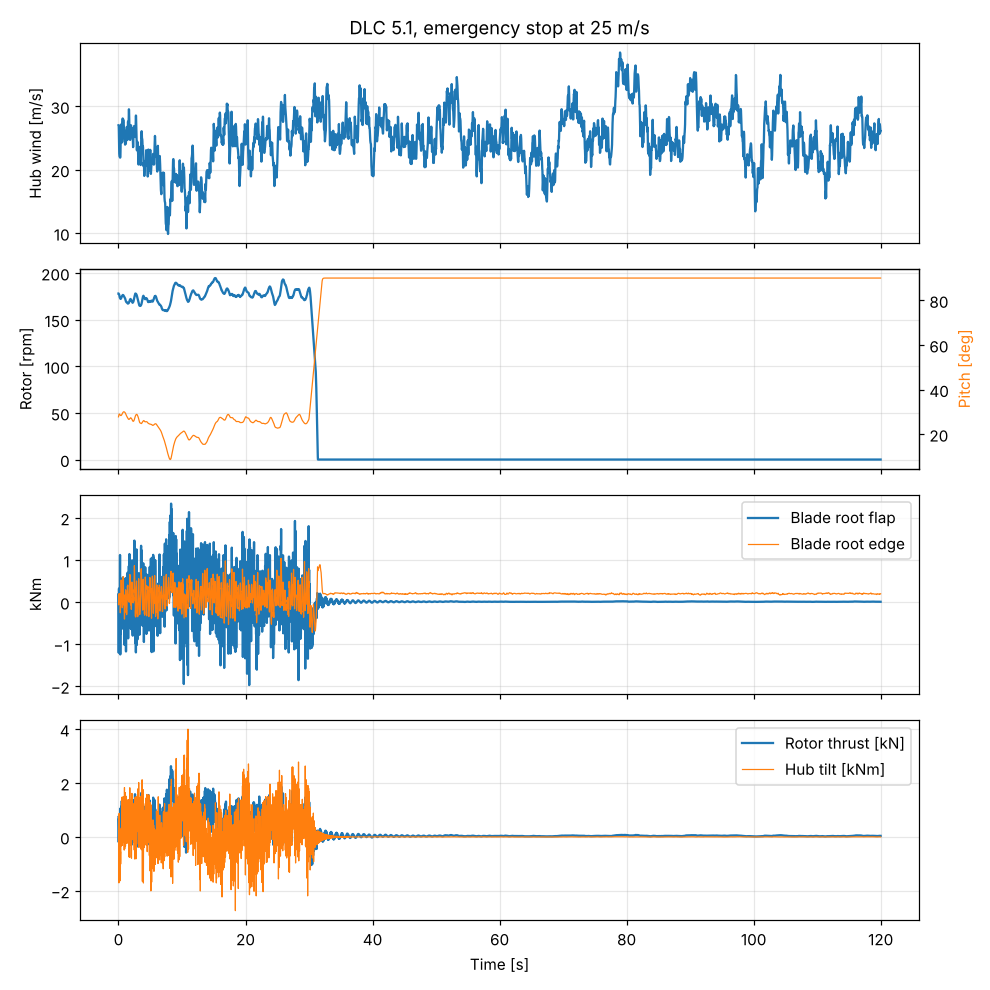
analysis/loads/results/final/dlc_estop25.png
