safarcikm/Wind-turbines/analysis/loads/results/final/dlc_losstorque25.png

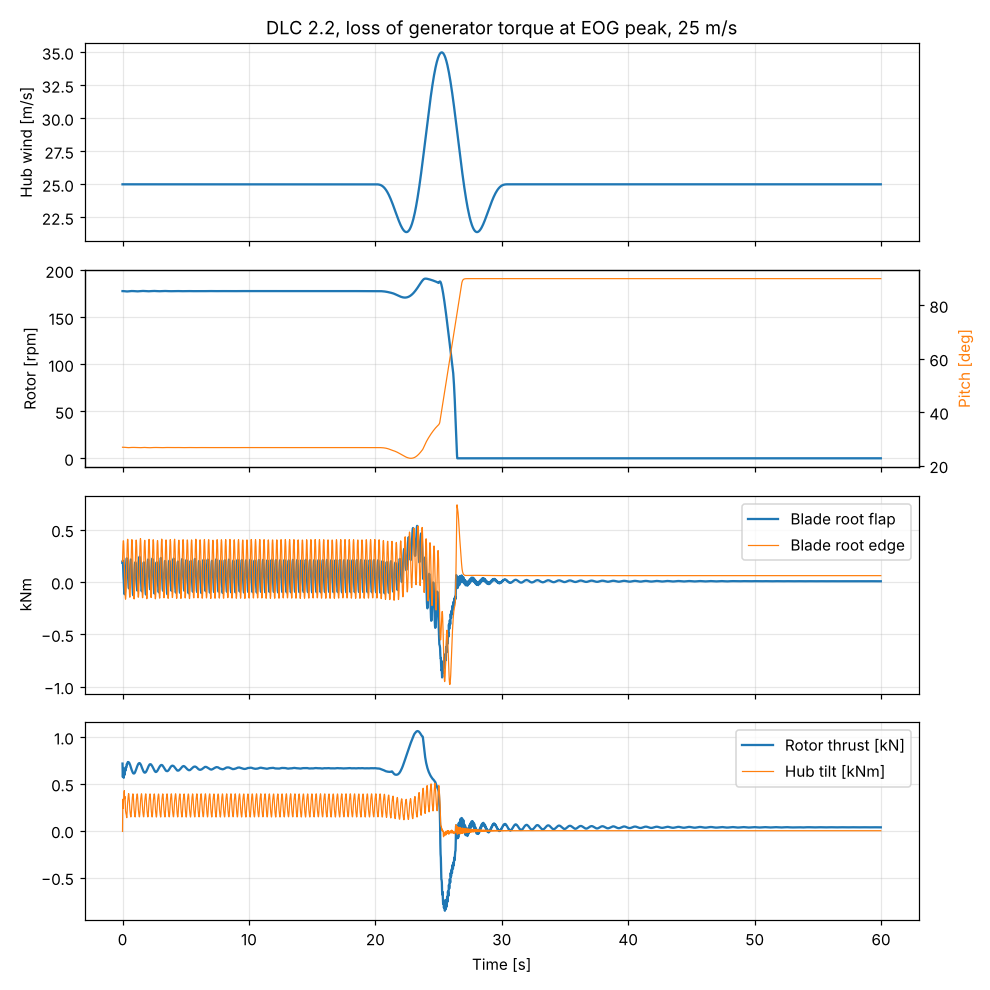
analysis/loads/results/final/dlc_losstorque25.png
