safarcikm/Wind-turbines/analysis/loads/results/final/dlc_ntm14.png

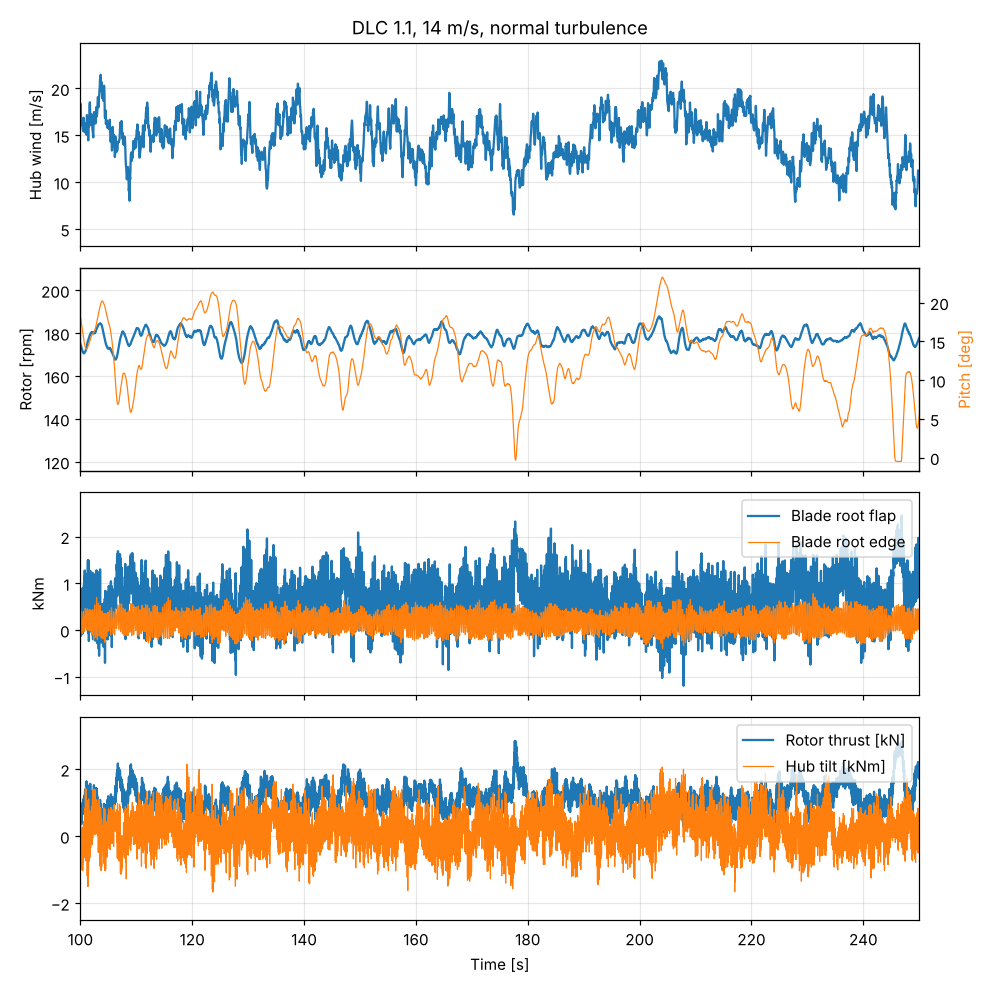
analysis/loads/results/final/dlc_ntm14.png
