safarcikm/Wind-turbines/analysis/power/results/power_envelope.png

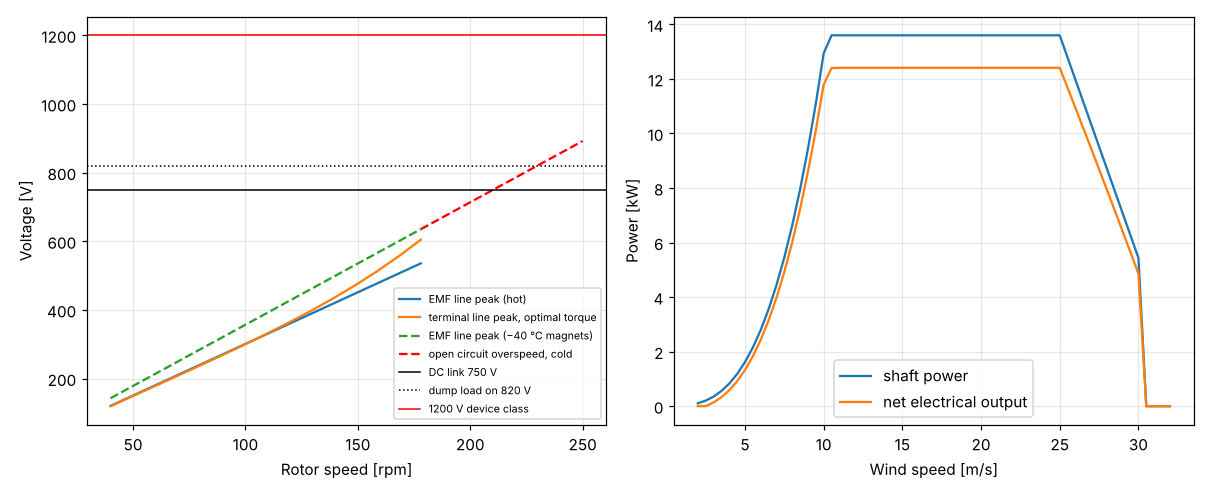
analysis/power/results/power_envelope.png
