safarcikm/Wind-turbines/analysis/tower/results/campbell.png

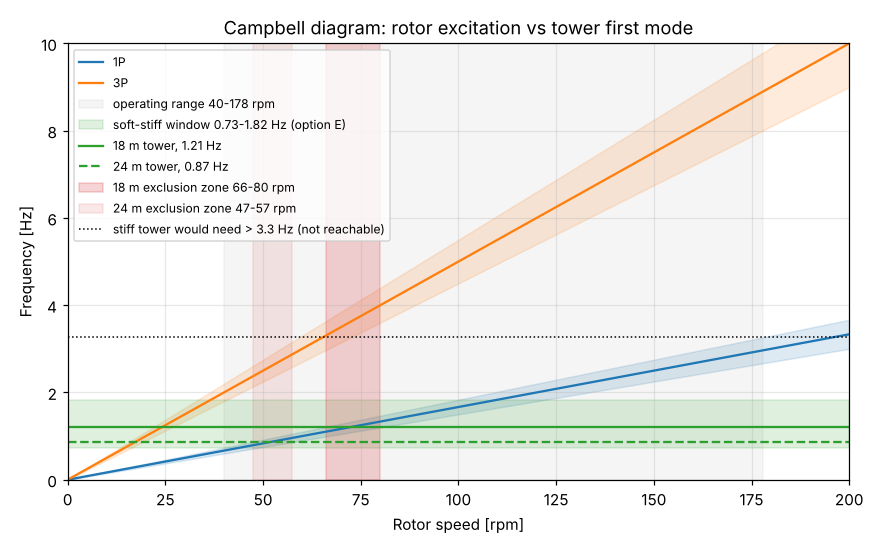
analysis/tower/results/campbell.png
