safarcikm/Wind-turbines/analysis/tower/results/monopole_18m_moments.png

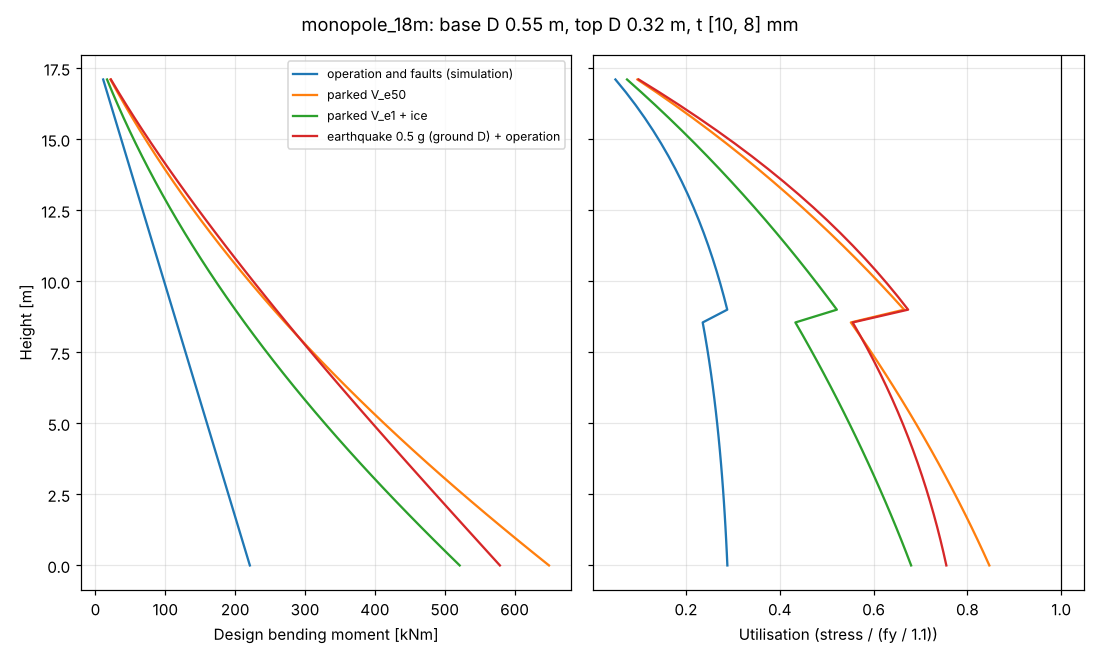
analysis/tower/results/monopole_18m_moments.png
