safarcikm/Wind-turbines/analysis/turbine_6kw/results/E01-tower8.png

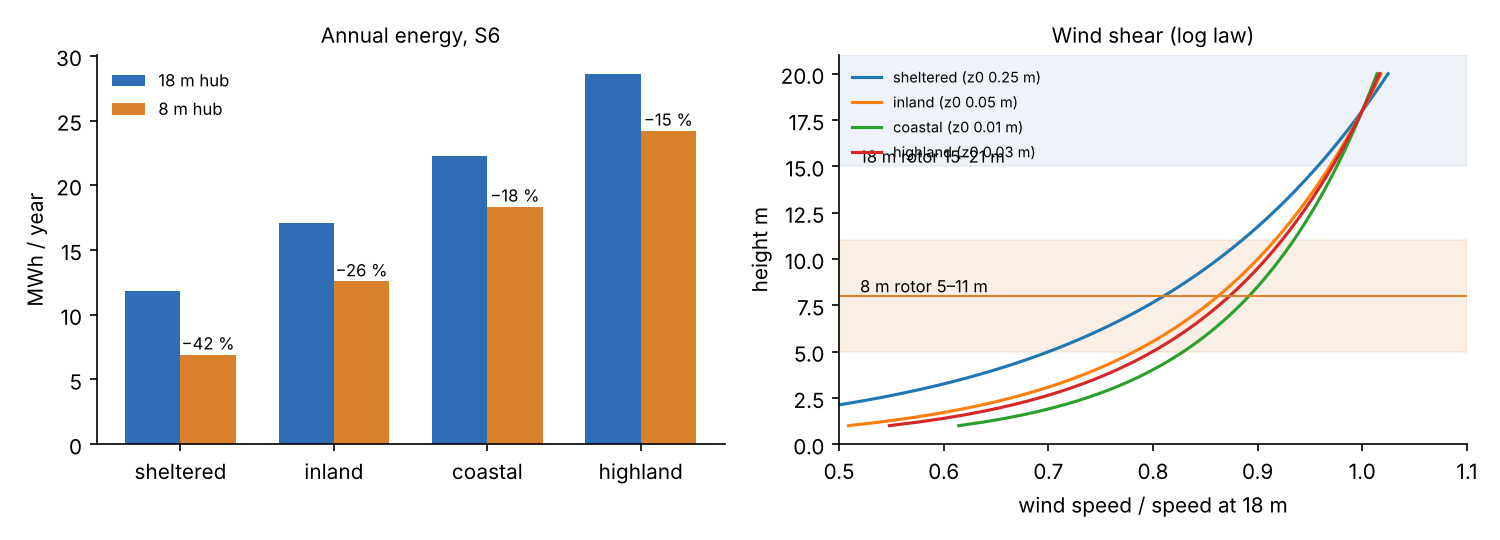
analysis/turbine_6kw/results/E01-tower8.png
