safarcikm/Wind-turbines/analysis/variant_tsr5/results/power_curves_V5.png

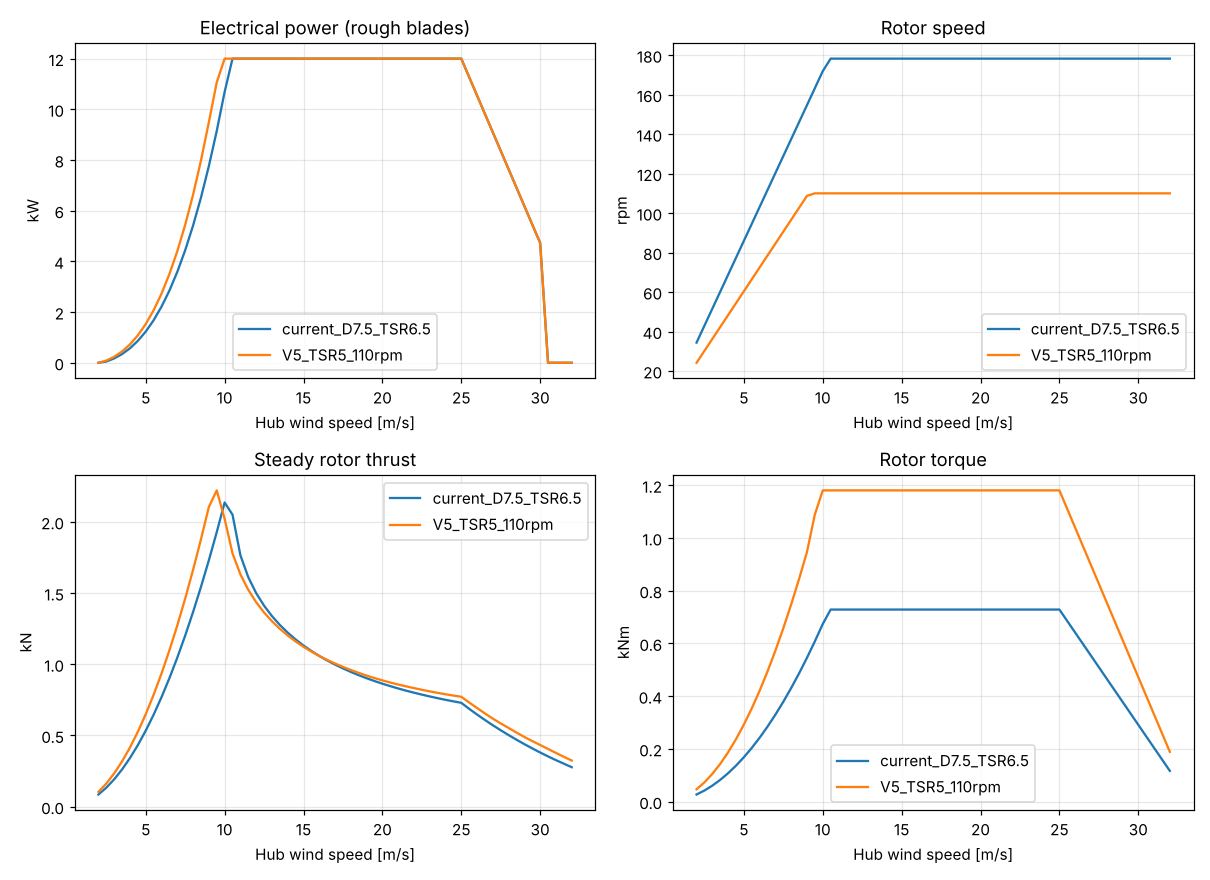
analysis/variant_tsr5/results/power_curves_V5.png
