safarcikm/Wind-turbines/cad/nacelle_p1/out/pdf/NP1-202.pdf

Ø458

## 12× Ø9 thru, c'sunk for M8 A4-80, PCD 418

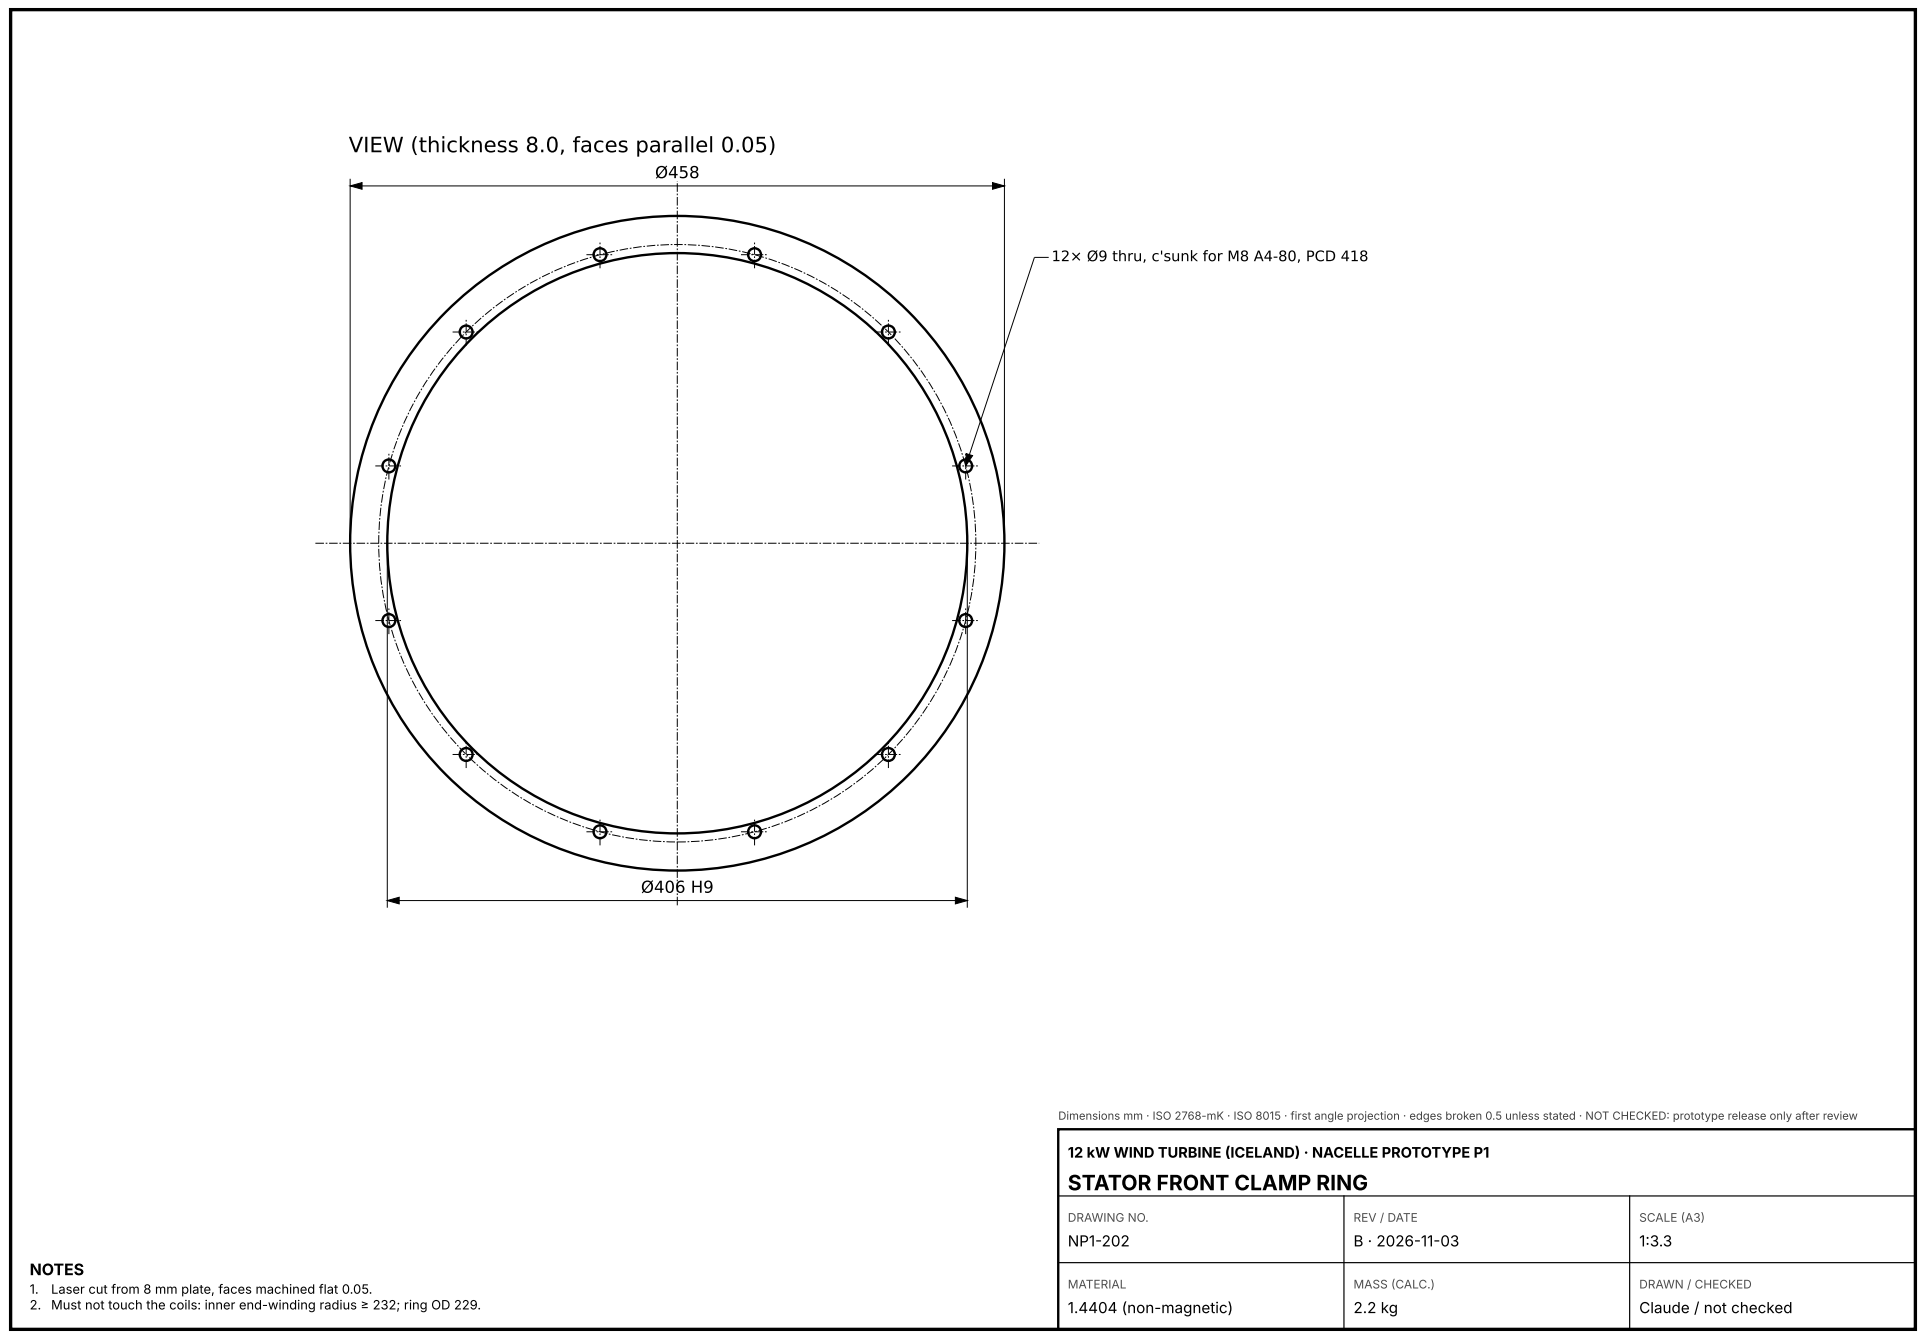
[picture p443: page 1]
DRAWING NO.; REV / DATE; SCALE (A3); MATERIAL 1.4404 (non-magnetic); MASS (CALC.)

VIEW (thickness 8.0, faces parallel 0.05)

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

12 kW WIND TURBINE (ICELAND) · NACELLE PROTOTYPE P1
STATOR FRONT CLAMP RING

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

DRAWN / CHECKED
Claude / not checked
