safarcikm/Wind-turbines/cad/nacelle_p1/out/pdf/NP1-212.pdf

Ø690

## VIEW FROM REAR · plate 10, seal ring 15 × 20 welded (x 450 to 465)

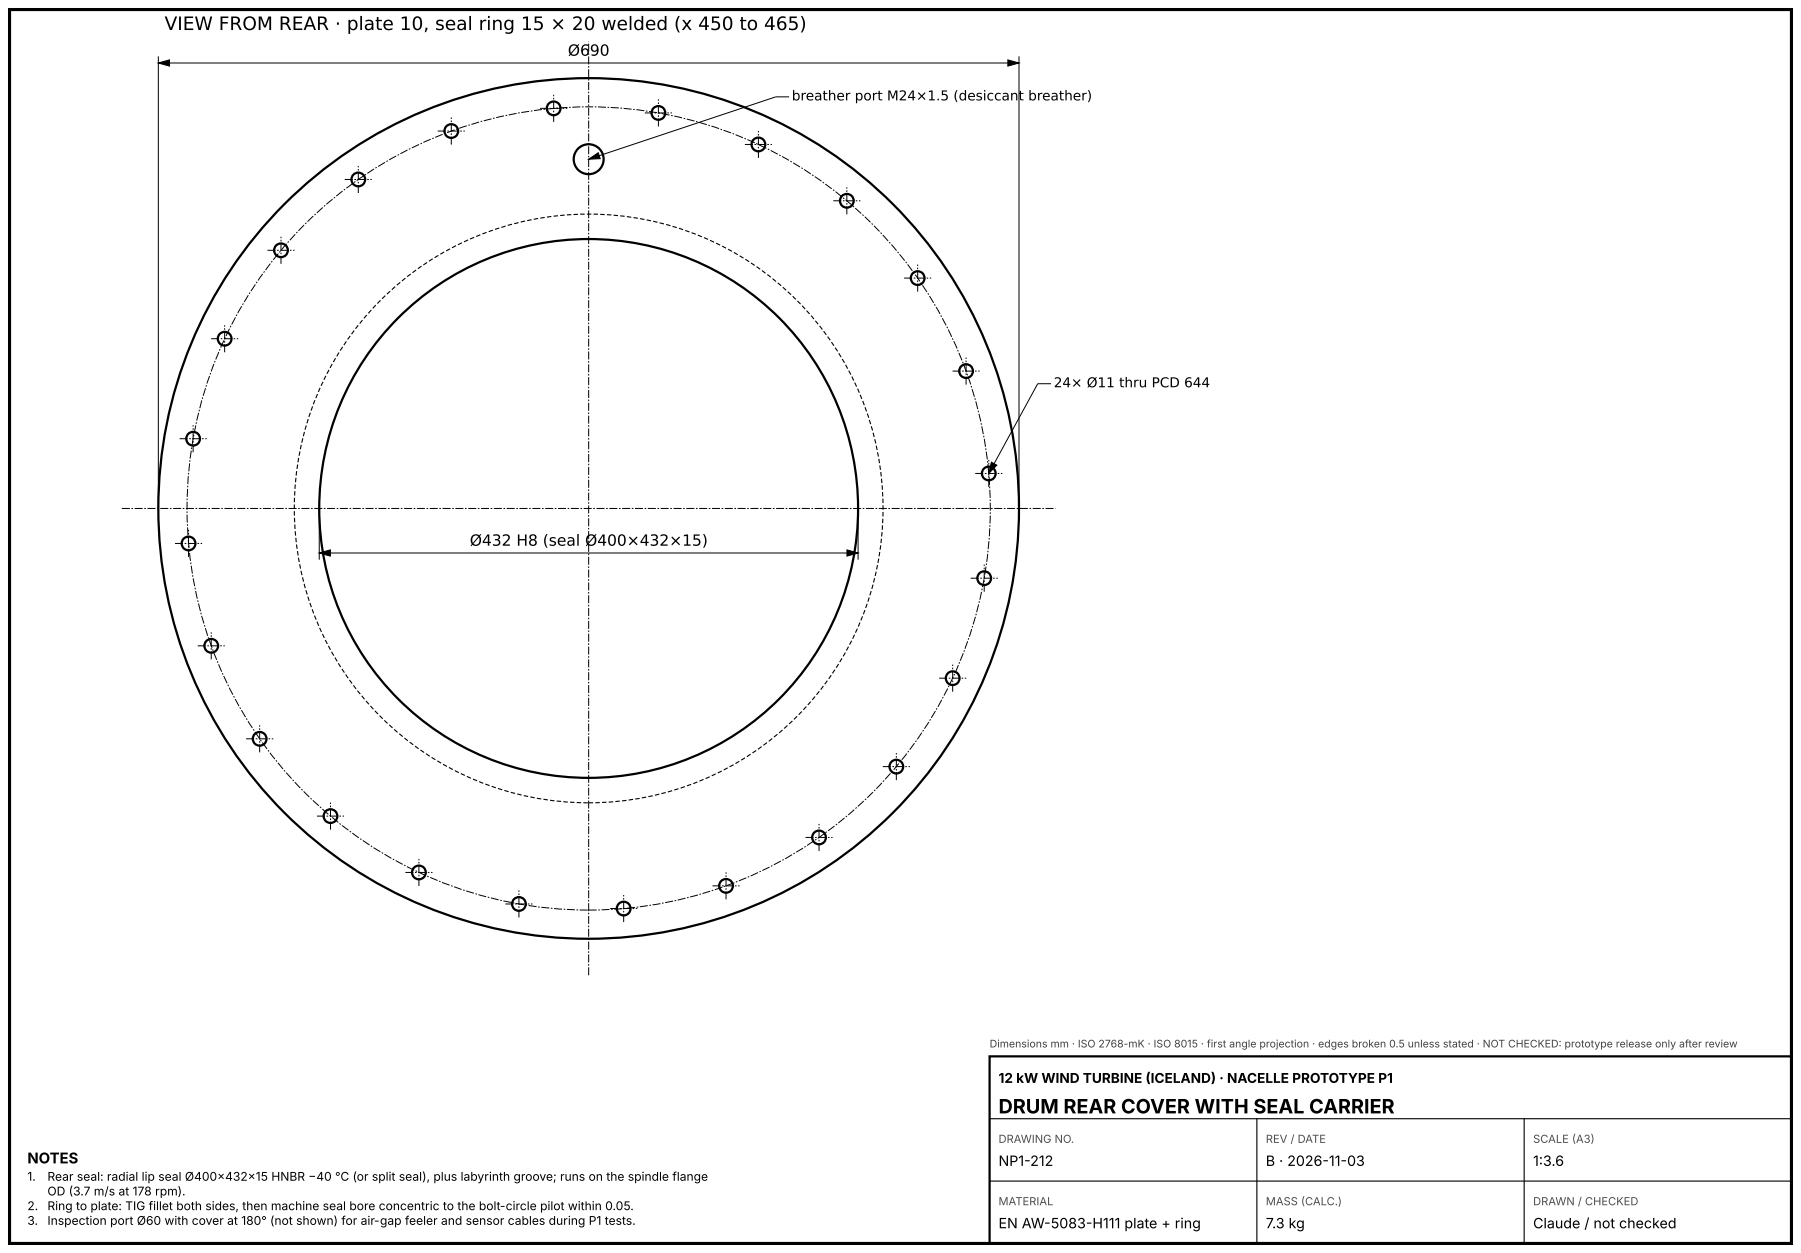
[picture p444: page 1]
24× Ø11 thru PCD 644; Ø432 H8 (seal Ø400×432×15); DRAWING NO.; REV / DATE; SCALE (A3); MASS (CALC.)

breather port M24×1.5 (desiccant breather)

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

12 kW WIND TURBINE (ICELAND) · NACELLE PROTOTYPE P1
DRUM REAR COVER WITH SEAL CARRIER

NOTES
1. Rear seal: radial lip seal Ø400×432×15 HNBR −40 °C (or split seal), plus labyrinth groove; runs on the spindle flange
OD (3.7 m/s at 178 rpm).
2. Ring to plate: TIG fillet both sides, then machine seal bore concentric to the bolt-circle pilot within 0.05.
3. Inspection port Ø60 with cover at 180° (not shown) for air-gap feeler and sensor cables during P1 tests.

MATERIAL
EN AW-5083-H111 plate + ring

DRAWN / CHECKED
Claude / not checked
