safarcikm/Wind-turbines/cad/nacelle_p1/out/pdf/NP1-600.pdf

200

### 520 shaft

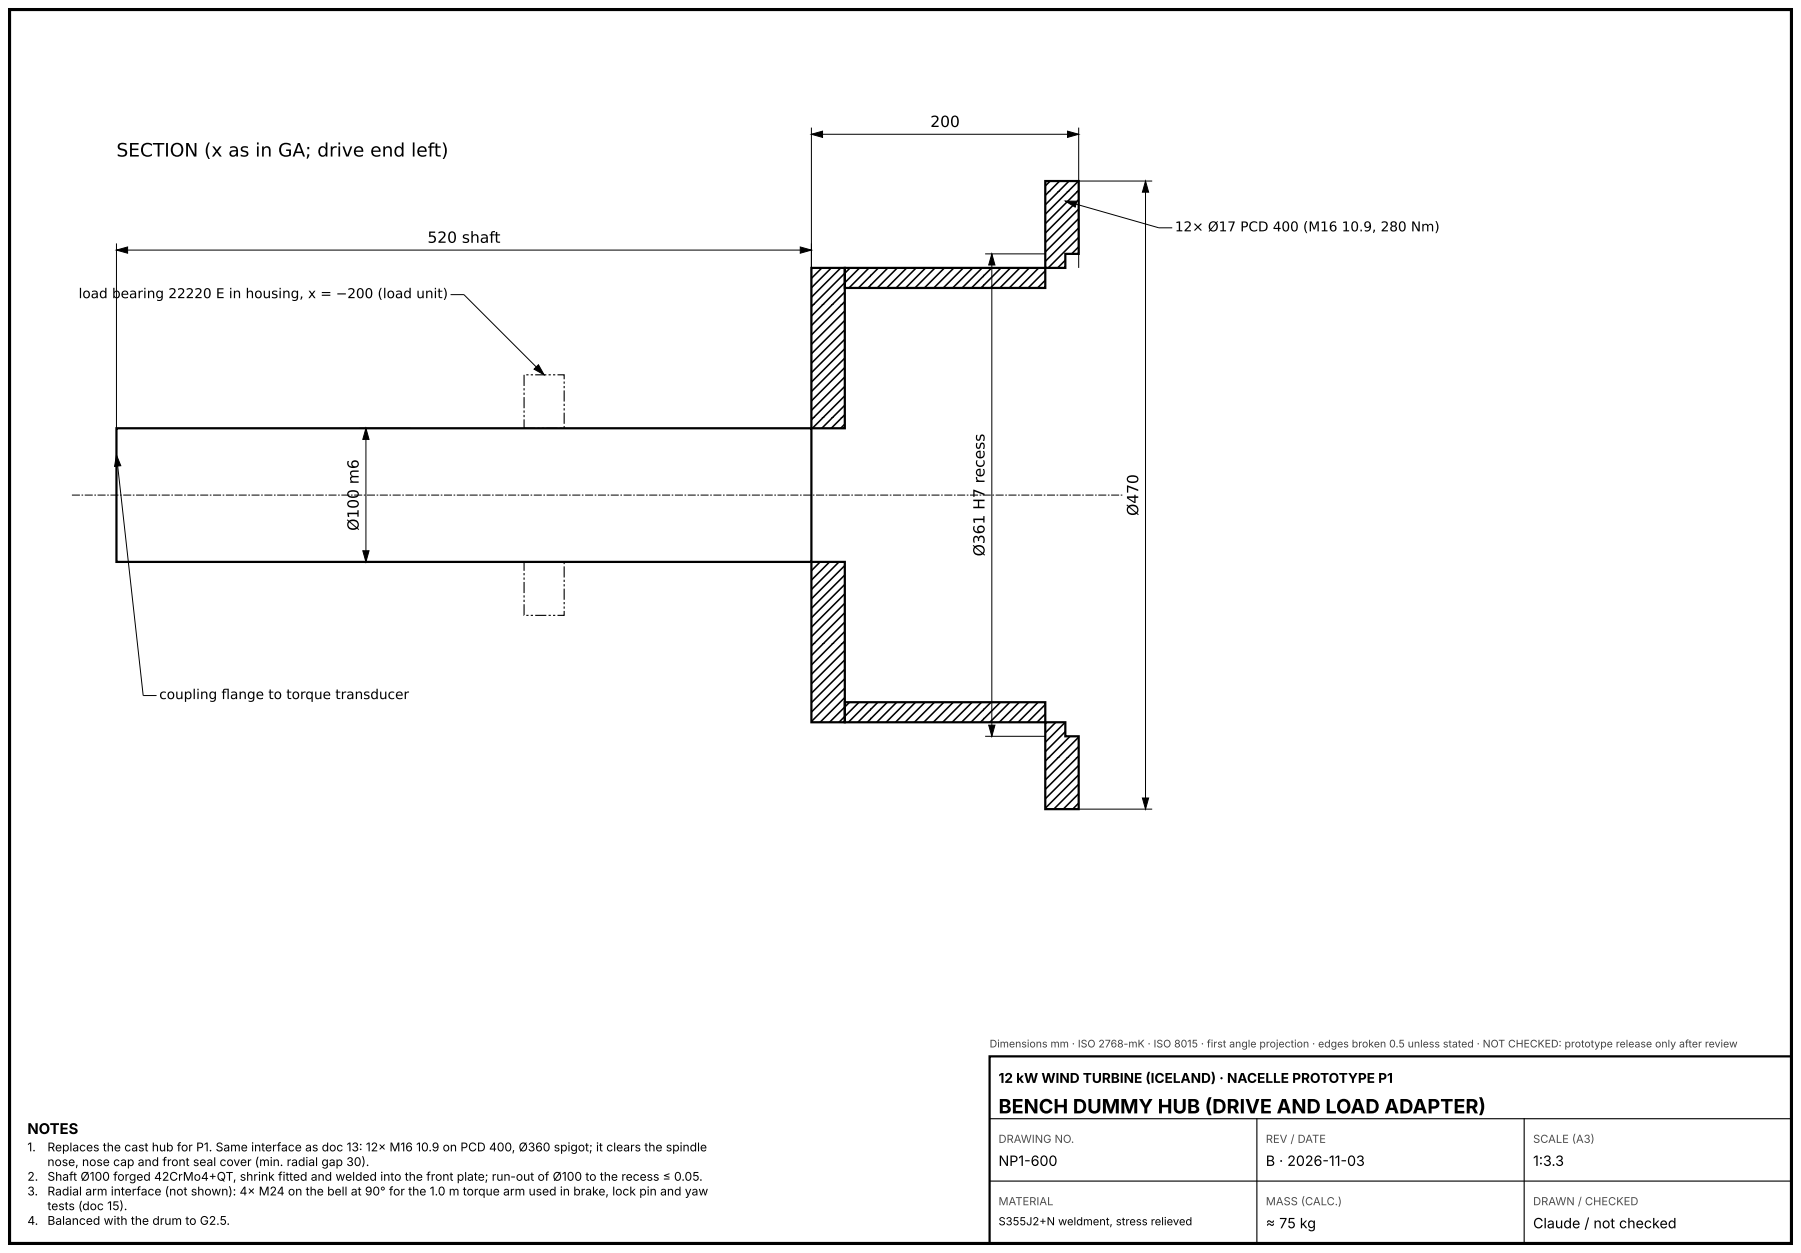
[picture p445: page 1]
Ø361 H7 recess; 12× Ø17 PCD 400 (M16 10.9, 280 Nm); DRAWING NO.; REV / DATE; SCALE (A3); MATERIAL; MASS (CALC.) ≈ 75 kg

SECTION (x as in GA; drive end left)

load bearing 22220 E in housing, x = −200 (load unit)

coupling flange to torque transducer

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

12 kW WIND TURBINE (ICELAND) · NACELLE PROTOTYPE P1
BENCH DUMMY HUB (DRIVE AND LOAD ADAPTER)

NOTES
1. Replaces the cast hub for P1. Same interface as doc 13: 12× M16 10.9 on PCD 400, Ø360 spigot; it clears the spindle
nose, nose cap and front seal cover (min. radial gap 30).
2. Shaft Ø100 forged 42CrMo4+QT, shrink fitted and welded into the front plate; run-out of Ø100 to the recess ≤ 0.05.
3. Radial arm interface (not shown): 4× M24 on the bell at 90° for the 1.0 m torque arm used in brake, lock pin and yaw
tests (doc 15).
4. Balanced with the drum to G2.5.

DRAWN / CHECKED
Claude / not checked

S355J2+N weldment, stress relieved
