safarcikm/Wind-turbines/(commit log)

2026-11-01 Revise categories for a certified product covering all sites and uses
    Records Martin's decisions: every Icelandic environment, all use cases,
    product for sale, full manufacturing capability. Adds a worst-case
    environmental envelope, platform/variant concept, make-or-buy table,
    modular power electronics, and new categories for product management
    and installation/service.
    Claude-Session: https://claude.ai/code/session_01Gz5pkxmU3zKHDayFNJrnNk
2026-11-01 Record pitch, magnet, market and price decisions; add cost budget
    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
2026-11-01 Add design basis and requirements document
    Icelandic environmental envelope from Met Office, Landsnet and seismic
    sources; IEC 61400-2 Class S parameters; design load cases including
    ice and seismic; traceable requirements for every category.
    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
2026-11-01 Add rotor concept study with BEM model
    Steady BEM model (Prandtl losses, Buhl correction, Viterna post-stall)
    compares 7.0/7.5/8.0 m rotors and design TSR. Recommends 7.5 m, TSR 6.5,
    70 m/s tip speed cap, rated 10.5 m/s at 178 rpm. Updates design basis
    rotor diameter and pitch rate requirement R3.1.
    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
    [blade_geometry_D7.5.csv, power_curve_D7.0_clean.csv, power_curve_D7.0_rough.csv, power_curve_D7.5_clean.csv, power_curve_D7.5_rough.csv, power_curve_D8.0_clean.csv, power_curve_D8.0_rough.csv]
2026-11-01 Add generator concept study and sizing model
    Compares outer-rotor radial flux, coreless axial flux and other
    topologies. Recommends a 0.60 m outer-rotor radial flux PMSG, 40p/45s,
    N42SH magnets, 3.0 A/mm2, ~94.5 % efficiency, ~75 kg active mass.
    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
    [radial_sweep.csv]
2026-11-01 Add generator FEA and thermal check
    Self-contained 2D nonlinear magnetostatic FEM (numpy/scipy) for the
    40p/45s outer-rotor generator: back-EMF, cogging, rated torque and
    ripple, short-circuit demagnetisation, iron loss. Lumped thermal
    network for hot-day, overload and cold cases. Results: cogging 0.1 %,
    ripple 1.9 %, switch magnets to N40UH, cooling package mandatory.
    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
2026-11-01 Add generator simulation round 2
    Rerun FEA and thermal with N40UH 7.7 mm magnets and 65 mm slots.
    Demagnetisation margin 28 %, hot-spot 92-101 C, efficiency 93.9 %.
    Recommends 74 mm stack to reach 3.0 A/mm2; freezes concept data.
    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
2026-11-01 Add nacelle, spindle and bearings concept
    Concept loads (gust, stuck blade, storm, ice imbalance, gyroscopic),
    tapered roller bearing pair sizing, 42CrMo4 hollow spindle strength
    and air-gap stiffness, spindle bore cooling path for the generator,
    fail-safe brake and active yaw sizing, mass budget.
    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
2026-11-01 Add load verification: IEC 61400-2 SLM and aeroelastic DLC simulation
    - analysis/loads: Simplified Load Model, IEC wind inputs, in-house
    time-domain aeroelastic simulator and a 94-case DLC run
    - docs/08: three-way load comparison, design load recommendation and
    findings (design overspeed 250 rpm, pitch 15/30 deg/s, tower frequency
    placement, parked stall-vibration risk, controller power tuning)
    - bem.py: consistent flat-plate polars beyond +-90 deg and negative-stall
    blend (rotor study results unchanged)
    - Update docs 02, 03, 04, 06, 07 and README for the new overspeed and
    pitch rates
    Claude-Session: https://claude.ai/code/se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
2026-11-01 Add tower and foundation concept
    - analysis/tower: frequency placement study, beam FE tower model with
    storm, ice, earthquake, fatigue, resonance, flange and tilt-up checks,
    foundations per ground type, guyed comparison, and a 132-case
    aeroelastic rerun with the chosen towers
    - sim.py: speed exclusion zone, minimum-speed option and per-blade pitch
    misalignment
    - docs/09: freestanding tilt-up monopoles (18 m 1.9 t, 24 m 3.1 t),
    soft-stiff frequency with 1P exclusion zone, rotor balance requirement,
    foundations
    - docs/02: R6.2 revised, new R6.6; README and doc 08 updated
    Claude-Session: https://claude.ai/code/session_01Gz5pkx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
2026-11-01 Add blade materials and structural concept
    - analysis/blade: thin-walled section model, station-by-station layup
    sizing (ultimate, fatigue, buckling, web shear), tip deflection,
    frequencies with centrifugal stiffening, root insert joint; four
    material options
    - docs/10: carbon spar caps on a glass shell recommended (20.5 kg,
    flap 13.2 Hz, 0.11 m tip deflection), root 0.22 m with 10 x M16 inserts
    - README and docs 08/09 next steps updated
    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
2026-11-02 Add control and safety system concept and final load rerun
    - sim.py: constant power above rated, storm control 25-30 m/s, coupled
    implicit blade-tower accelerations (fixes instability with stiff blades)
    - run_dlcs.py final: controller, 18 m tower, carbon blade, pitch
    misalignment, storm-range cases (103 runs) -> results/final
    - docs/11: control and protection architecture, operating states, trips,
    emergency stop, yaw and parked strategy, cold-climate functions, load
    comparison with doc 08
    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
2026-11-02 Add power electronics and power modules concept
    - analysis/power/sizing.py: generator terminal envelope, DC link window,
    ratings, dump load, efficiency chain and net annual energy
    - docs/12: SiC active rectifier, 750 V DC link, 20 kW dump load, AC module
    (grid-tie or heating), isolated 48 V battery module, priority logic
    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
2026-11-02 Add hub, pitch and yaw concept (doc 13)
    Independent electric pitch with supercapacitors, pitch bearing and drive
    sized from simulated 20-year pitch duty, ductile iron hub, yaw bearing,
    drives and slipping brake. Records the heavier hub's effect on the towers
    and adds requirements R3.5-R3.7.
    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
    [hub.py, run_pitch_duty.py]
2026-11-02 Add nacelle prototype P1 detail design, drawings, BOM and bench test plan
    Docs 14 (P1 bench article detail design) and 15 (bench test plan).
    Parametric geometry and drafting in cad/nacelle_p1 generate 17 drawing
    sheets as an A3 PDF set and true-size DXF, plus a 52-line BOM.
    analysis/nacelle/detail.py checks bearings, spindle, bolted joints,
    fits, air gap budget, cooling path, brake and bench drive.
    Claude-Session: https://claude.ai/code/session_01Gz5pkwCxvDToyq7CGzTqBM
    [NP1-000.dxf, NP1-100.dxf, NP1-101.dxf, NP1-110.dxf, NP1-200.dxf, NP1-201.dxf, NP1-202.dxf, NP1-210.dxf]
2026-11-02 Add full-size nacelle P1 fit-check model and digital assembly check
    Every P1 nacelle part as its own 1:1 object (STEP + STL per part, plus a
    coloured assembly STEP), built from cad/nacelle_p1/geometry.py, with a
    digital fit check (interference, running gaps, assembly paths) and doc 16
    with print settings and the physical fit-check procedure. The check finds
    seven assembly problems in the P1 design and two drawing slips.
    Claude-Session: https://claude.ai/code/session_01Gz5pkwrD2rWSf8z8yCHK4M
    [32028X_front_cone_envelope.step, 32028X_front_cone_envelope.stl, 32028X_front_cup_envelope.step, 32028X_front_cup_envelope.stl, 32028X_rear_cone_envelope.step, 32028X_rear_cone_envelope.stl, 32028X_rear_cup_envelope.step, 32028X_rear_cup_envelope.stl]
2026-11-02 Extend fit-check model down to the tower mounting point
    Add the tower-top adapter NP1-400 (yaw ring seat + yaw brake track),
    tower top flange with 16 x M20 on PCD 380 and a tube stub, two yaw drive
    envelopes with NP1-420 brackets, two yaw brake caliper space claims,
    placeholder rotor caliper brackets NP1-310, and a yaw-rotation clearance
    check. 43 objects, all 1:1. Doc 16 section 7 documents the new design.
    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
    [32028X_front_cone_envelope.step, 32028X_front_cup_envelope.step, 32028X_rear_cone_envelope.step, 32028X_rear_cup_envelope.step, KMT27_locknut_envelope.step, NP1-100_spindle.step, NP1-101_front_spacer.step, NP1-110_cooling_insert.step]
2026-11-03 Add working 3D-printed prototype W1 and P1 geometry Rev B
    Fix all nine fit-check findings of doc 16 in the P1 geometry (disc
    Ø880/Ø652 fitted from the front, lock holes in the disc with a holder
    and overspeed sensors, rear seal sleeve, larger front spacer, bedplate
    pad, caliper room, keys, dummy hub recess); regenerate the drawings and
    the fit-check model; the digital check is clean.
    Add doc 17 and cad/nacelle_w: printed hub, pitch and yaw bearing twins
    with real balls, involute printed gears, pitch drive brackets, blade
    stubs, component list with candidate products and the car-industry
    evaluation, wiring, build manifest limits, tests and swap path.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
    [32028X_front_cone_envelope.step, 32028X_front_cup_envelope.step, 32028X_rear_cone_envelope.step, 32028X_rear_cup_envelope.step, KMT27_locknut_envelope.step, NP1-000.dxf, NP1-100.dxf, NP1-100_spindle.step]
2026-11-03 Add generator manufacturing instructions (doc 18)
    Full in-house instruction set for the P1 steel generator: materials and
    purchase specs, segment laminations, winding, connection, VPI, potting,
    drum, magnet bonding and sleeve moulding, joining on the spindle, tests,
    Q1 process qualification. Manufacturability review finds the one-piece
    stator cannot be wound; recommends a segmented stator (decision open).
    analysis/generator/manufacturing.py computes the shop numbers.
    Claude-Session: https://claude.ai/code/session_01Gz5pkvL1Z7ryhUGJHZEfeJ
    [coil_connection.csv]
2026-11-04 Doc 18: add 19 step-by-step figures and illustrated PDF
    Figures G01-G19 are generated from the P1 geometry (cad/generator_mfg/figures.py)
    and embedded in each work step of doc 18. Also fixes the lamination sheet
    weight (5.5 g/sheet, 1.12 kg/bundle).
    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
2026-11-04 Doc 18: add isometric 3D views I01-I05
    New pure-Python isometric renderer (cad/generator_mfg/iso.py) draws shaded
    3D views from geometry.py: exploded generator, one segment (stack, insulate,
    wind), segments into the carrier grooves, rotor drum with magnets (cut open)
    and the J40 rotor lowering. Views are placed at their work steps in doc 18
    and the illustrated PDF is rebuilt (41 pages).
    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
2026-11-05 Doc 19: final magnet geometry, flat N40UH blocks instead of arcs
    FEA study of 7 magnet shapes (analysis/generator/magnets.py): arc vs 1, 2, 3
    flat blocks per pole plus wider and thicker variants, with EMF, cogging,
    ripple, demagnetisation, net pole force and magnet eddy loss vs segmentation.
    Chosen: 2 x 2 flat blocks per pole, 18.75 x 36.90 x 8.20 mm, one part number
    turned over for S poles; 381 V at 28 turns, 0.96 Nm cogging, 12.8 W eddy loss.
    Closes the open eddy-loss check, fixes the seat diameter (bond line), adds
    detail drawings M01-M10, isometric views MI01-MI04 and the illustrated PDF.
    Claude-Session: https://claude.ai/code/sess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
2026-11-05 Doc 19: magnet grade assessment (section 12)
    grades.py runs 10 candidate grades (SH, UH, EH, AH, SmCo) on the final
    flat-block geometry: EMF and short-circuit demagnetisation margin at 120
    and 150 C. Ranking by suitability, sourcing (China Dy/Tb export licensing,
    makers outside China) and feasibility; figure M11. Purchase spec now asks
    for N40EH (preferred) and N40UH (accepted) on the same drawing.
    Claude-Session: https://claude.ai/code/session_01Gz5pkvT9RdyLR1mnbRby46
2026-11-05 Doc 19 Rev B: 40 x 20 x 7.5 catalogue magnet blocks with step-skewed rows
    Rev B replaces the special 18.75 x 36.90 x 8.20 block by a catalogue 40 x 20
    face, 7.50 thick (380 V at 28 turns). The wider 0.85 pole span lands on the
    40/45 cogging peak (6.6 Nm); a 0.50 deg step skew between the two block rows
    cancels it in the FEA. Rows overhang the stack 3.1 mm each end; drum seat
    Ø618.65 x 96, comb bars split per row (80 x 44), end rings 7.9 wide.
    Grade check and tolerance study rerun on the new block.
    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
2026-11-05 Doc 19 §14: prototype check, plain N42 40 x 20 x 5 blocks with filler
    proto.py runs 5 mm N42 blocks in the Rev B rotor with a 2.5 mm filler
    behind each block (steel and resin). Steel filler: 374 V at 20 C, 358 V
    at 60 C, fine for rated running below ~50 C, but any short circuit
    demagnetises the block corners. fem.py gets a ring_nu hook so magnets.py
    can model the filler plates.
    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
2026-11-05 Doc 19 §15: study of N42SH 30 x 15 x 6 blocks
    sh30.py runs two layouts: 1 across x 5 along (312 V, -18 %, easy build)
    and 3 across x 3 along (376 V, but 360 pieces, 2 mm between poles,
    106 mm seat). N42SH fails the 120 C transient short-circuit case in
    both; Rev B stays the production choice.
    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
2026-11-05 Doc 19 §16: SH grade feasibility for the production rotor
    shgrade.py runs N38SH, N42SH and N45SH on the Rev B layout at 7 to
    10.5 mm. No SH grade meets the 120 C transient short-circuit case;
    N42SH on the unchanged Rev B drawing keeps 20 % up to 100 C, N38SH
    9.5 mm up to 110 C. Section covers the conditions for a 100 C design
    case and non-Asian sourcing.
    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
2026-11-05 Doc 20: N42SH 30x15x6 magnet variant (stacked pairs, 5 skewed rows) compared with Rev B
    Geometry (magnet_geom_s30.py), drawings D01-D04 and DI01, FEA case S1d
    in sh30.py and magnets.py, and doc 20 with the illustrated PDF.
    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
2026-11-05 Doc 21: best N42SH magnet shape, blocks and custom shapes compared with 30x15x12
    26-case FEA sweep (optshape.py): flat blocks, radial and parallel arc
    segments and loaf shapes. Best block 33.2 x 14.8 x 11 for 28 turns; best
    custom shape a parallel-magnetised arc, span 0.68, 11 mm.
    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
2026-11-05 Doc 22: generator with Ø490 and Ø290 drums (30x15x12 magnets) vs the Ø646 drum, energy output
    FEA of 32/36 and 16/18 pole/slot machines with the doc 20 pole, stack for
    full power or power cap at 74 mm, losses and Rayleigh annual energy.
    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
2026-11-05 Generator Rev C: one N45SH 30x15x12 block per pole, complete rotor and stator set (doc 23)
    - FEA of the Rev C pole (sh30.py S1x): 372 V at 100 C with 28 turns, 30 % SC margin at 100 C
    - checks_rc.py: thermal (fan blades on rear cover), bond, drum stress and stability, UMP, voltage
    - geometry.py master updated to Rev C (seat 628.05, 200 blocks)
    - cad/generator_rc: 11-sheet drawing set (PDF/DXF/PNG) and isometric views IR01-IR06
    - docs/23-generator-rev-c.md + PDF
    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
    [NP1-200C.dxf, NP1-201C.dxf, NP1-202.dxf, NP1-203C.dxf, NP1-210C.dxf, NP1-212C.dxf, NP1-220E.dxf, NP1-221C.dxf]
2026-11-05 Generator Rev C: passive rotor cooling (36 inner fins, 48 outer ribs) and study (doc 23 §4a)
    - passive_cooling.py: fin/rib options in the doc 06 thermal model; blades + inner fins + outer ribs
    give a 94-105 C hot spot on the hot cases (limit 130), magnets below 60 C
    - geometry.py: ROTOR_FINS, DRUM_RIBS and their mass
    - NP1-210C and NP1-G00 show the fins and ribs; iso views updated
    - doc 23: new section 4a, corrected inner-fin gain (realistic area 1.5x, not 3x)
    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
    [NP1-200C.dxf, NP1-201C.dxf, NP1-202.dxf, NP1-203C.dxf, NP1-210C.dxf, NP1-212C.dxf, NP1-220E.dxf, NP1-221C.dxf]
2026-11-05 Collective pitch with spring feathering: first sizing (analysis/hub/collective.py)
    Claude-Session: https://claude.ai/code/session_01Gz5pkuTkbu8SpDT4QvEnJh
2026-11-05 Doc 24: collective pitch with one electric cylinder and supercap, welded hub
    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
2026-11-05 Doc 24: 3D model of hub and collective pitch, clash check, isometric views IH01-IH05; crank moved to r 110
    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
2026-11-05 Doc 25: yaw system detail design (slewing ring, passive friction pads, braked gearmotors, no hydraulics)
    Sizing (analysis/yaw/yaw.py), 3D model with clean 360-degree clash check,
    drawing set NY-000 to NY-460, isometric views IY01-IY05. R3.7 revised,
    R3.9/R3.10 added. Full tower-top count: 969 kg above the yaw bearing,
    1,103 kg above the tower flange.
    Claude-Session: https://claude.ai/code/session_01Gz5pkx5gQ1XuRJZWaAv34Y
    [NY-000.dxf, NY-400.dxf, NY-410.dxf, NY-430.dxf, NY-440.dxf, NY-460.dxf]
2026-11-05 Ignore yaw drawing previews and run logs
    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
2026-11-05 Add interactive 3D turbine viewer (three.js)
    Single-page model of the whole turbine built from the design sources:
    Rev C generator, Rev B nacelle, doc 24 collective pitch (kinematics
    ported from collective.py), doc 25 yaw, blade planform and 18 m tower.
    Spinning rotor, live pitch linkage, yaw, exploded view, section cut,
    part info on hover/click.
    Claude-Session: https://claude.ai/code/session_01Gz5pkv4573A8n3VeiGynnp
2026-11-05 Viewer: design TSR slider (3-8) with BEM blade shapes, tower down to 8 m
    Blade chord/twist, Cp and peak TSR per design TSR from analysis/rotor/bem.py.
    Controller rated speed and power follow the chosen rotor; tower frequency
    now a power law through the 18 m and 24 m designs.
    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
2026-11-05 Viewer: rotor diameter slider (5-11 m), blades scaled, rated point and power follow
    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
2026-11-05 Doc 26: slow-running variant V5 (Ø8.3 m, TSR 5, 110 rpm), every subsystem re-sized
    Rotor and net energy vs current design, SLM + 103-case aeroelastic rerun,
    blade, generator (Rev C with 120 mm stack), hub/collective pitch, rotor
    brake, yaw, tower and footings, power electronics. Scripts in
    analysis/variant_tsr5 reuse the existing models with V5 inputs.
    Claude-Session: https://claude.ai/code/session_01Gz5pkwa1TJ4Ujaf4fZSH7J
    [blade_geometry_V5.csv, power_curves.csv]
2026-11-06 Doc 27: size x TSR decision map (4-20 kW, TSR 4-8) with interactive page
    Claude-Session: https://claude.ai/code/session_01Gz5pkyKxen9ZpRavtS1uiG
    [grid.csv]
2026-11-06 Doc 28: 6 kW turbine concept study and the variable pitch question
    Clean-sheet 6 kW machine. Same rotor (Ø6.0 m, TSR 5.5) run with active pitch,
    stall by speed control and furling: energy, generator torque, runaway, electrical
    braking, brake stops and parked loads at V_e50 for every yaw error. Recommends
    fixed-pitch variable-speed stall control with two fail-safe stopping systems and
    yaw-out storm parking.
    Claude-Session: https://claude.ai/code/session_01Gz5pkuDY6YJ6qXzKhfVHdr
2026-11-06 Doc 29: 6 kW generator G6 (Rev C active part at 6 kW stall duty)
    Candidate comparison (Rev C, Ø646 short stack, dedicated Ø490), electrical
    data at 164 rpm, braking resistor sizing with storm stop simulations,
    thermal without the passive cooling parts, demag, voltage, brake, BOM
    differences and isometric views.
    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
2026-11-06 Doc 30: 6 kW turbine S6 complete first-pass design
    Blades (glass caps, 20.6 kg), fixed welded hub, 12 kW drivetrain and yaw
    reused after SLM comparison, yaw-out storm parking torque, 18 m tower and
    footings, power electronics settings, stall speed control and protection,
    mass list.
    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
2026-11-06 Doc 31: aeroelastic simulation of the 6 kW stall turbine S6
    sim6.py adapts the doc 08 simulator to fixed pitch, stall speed control and
    the K1 resistor + spring brake safety chain; dlc6.py runs 113 load cases;
    recheck6.py reruns the doc 30 blade, hub and tower models with the simulated
    loads. Result: design unchanged, fatigue far below the first-pass scaling;
    brake spring pack must rise from 1.5 to 2.5 kNm for the yaw-lost storm.
    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
2026-11-06 Doc 32: 6 kW lighter bedplate, brake kept at 1.5 kNm, NS6 drawings, 3D website
    bedplate6.py sizes NS6-300 (126.7 kg, same interfaces as NP1-300; the 12 kW
    NP1-300 as drawn is 333 kg, not the 150 kg carried in docs 25/30). Head 912 kg.
    brake_hold6.py shows the 1.5 kNm spring holds the yaw-lost 50-year storm and,
    with +35/+60 % aero torque, the rotor only creeps against brake and resistor;
    the doc 31 change to 2.5 kNm is withdrawn per Martin. drawings6.py builds the
    10-sheet NS6 set (PDF, DXF, SVG, PNG). viewer6/ is the interactive 3D model
    with the stall controller and the drawing set inside.
    Claude-Session: https://claude.ai/code/sessi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
    [NS6-000.dxf, NS6-001.dxf, NS6-010.dxf, NS6-100.dxf, NS6-200.dxf, NS6-300.dxf, NS6-400.dxf, NS6-500.dxf]
2026-11-06 Doc 33: timber (wood-epoxy) blade study for S6 and 12 kW
    timber6.py sizes moulded veneer shell, carved laminated and carved +
    carbon-strip blades in Douglas fir and Sitka spruce on three airfoil
    thickness distributions with the doc 10 section model and doc 31 loads.
    Carved Douglas fir + 1 kg carbon strips works on the unchanged S6 outline
    (21.8 kg, flap 18.4 Hz); all-wood needs thicker airfoils (22.4 kg, Cp -1.4 %).
    12 kW: all-wood fails, hybrid 26.1 kg vs 20.5 kg carbon blade.
    Claude-Session: https://claude.ai/code/session_01Gz5pkwDzBVZyGhQ1Yq8q97
2026-11-06 Doc 34: 6 kW S6 on an 8 m tower, full mechanical design and build book
    Stiff 8 m tower (661 kg, f1 3.50 Hz, 3P exclusion 60-77 rpm), footings,
    energy/turbulence/noise at 8 m vs 18 m (tower8.py). CadQuery model of
    every part (model6.py), axonometric views of 60 parts, 7 assemblies and
    13 assembly steps (iso6.py), BOM (bom6.py), NS6 drawing set rev B with
    29 sheets (drawings6.py, sheets6b.py) and a 76-page A3 build book
    (buildbook6.py). Pitch setting corrected to arc slots + washer plates.
    Claude-Session: https://claude.ai/code/session_01Gz5pkunv2cTa3C7kw5xyV8
    [NS6-000.dxf, NS6-001.dxf, NS6-002.dxf, NS6-003.dxf, NS6-010.dxf, NS6-020.dxf, NS6-100.dxf, NS6-101.dxf]
